mregueira/DisenioBJAM/Pedal.png

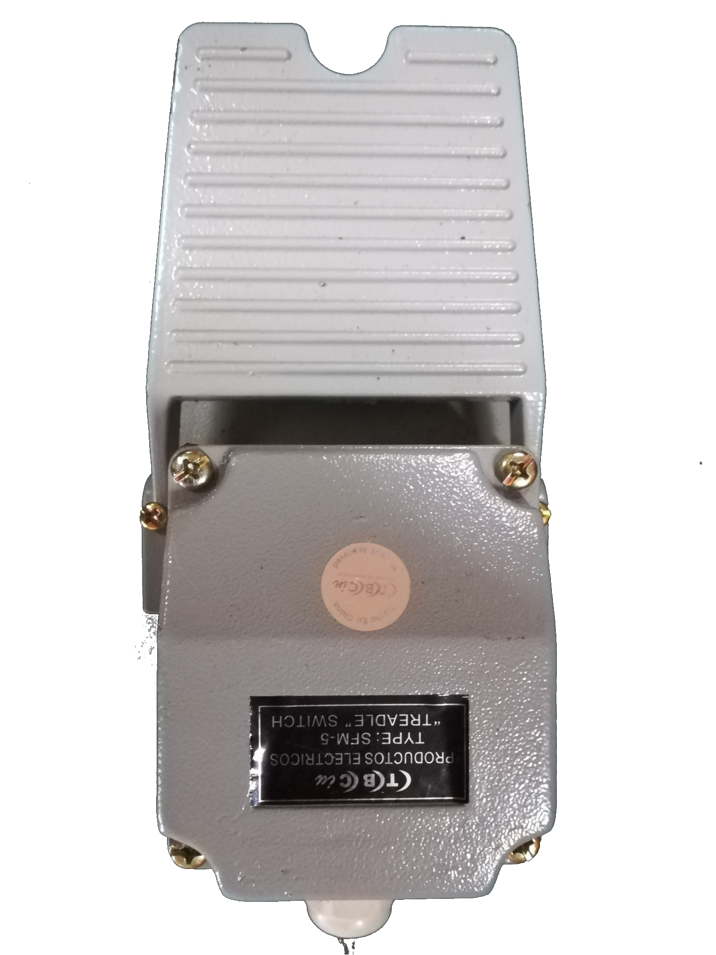
Pedal.png
