mregueira/DisenioBJAM/Hito 3/Dibujos/Mitutoyo Digimatic protocol.jpg

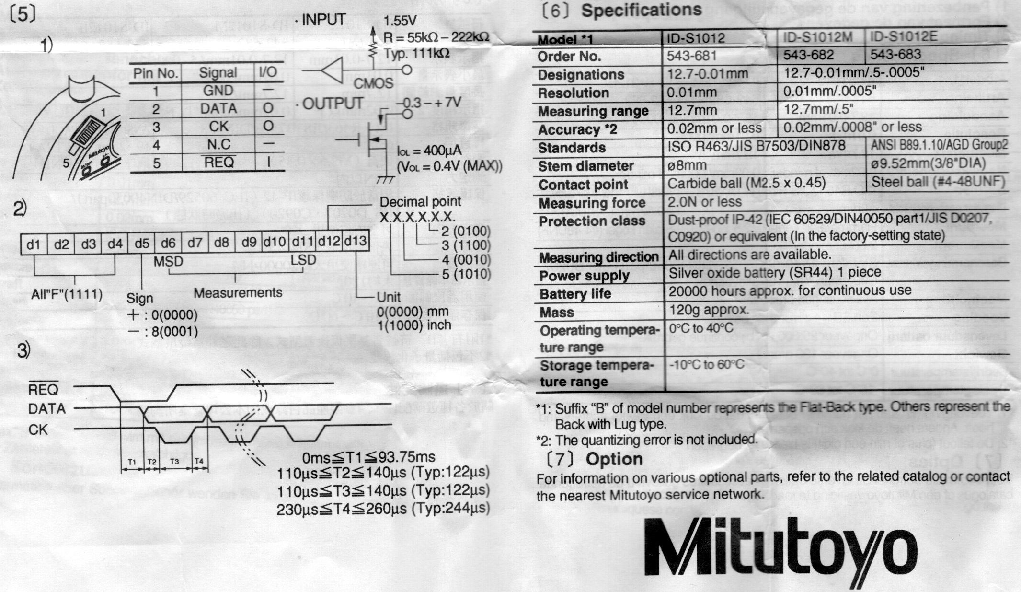
Hito 3/Dibujos/Mitutoyo Digimatic protocol.jpg
