mregueira/DisenioBJAM/Prototipo/COMECA-TestBoard-v2/COMECA-TestBoard/COMECA-TestPCB.txt

Board Information Report
Filename     : C:\Users\Marcelo\Documents\GitHub\DisenioBJAM\Prototipo\COMECA-TestBoard-v2\COMECA-TestBoard\COMECA-TestPCB.PcbDoc
Date         : 16/9/2021
Time         : 12:21:42
Time Elapsed : 00:00:00

Routing Information
    Routing completion, 100.00%
    Connections, 34
    Connections routed, 34
    Connections remaining, 0
count : 4
