mregueira/DisenioBJAM/Prototipo/NotasPrograma.docx

Pruebas y verificación sobre la STM + Programador externo

- Conexión del CN4 para programar según la hoja de datos: OK
- Selector en proyecto, buscar modelo: STM32F407VGT6: OK
- Programa de prueba de encender LED: FAIL
  - Causa: veo que en la tablita dice pin 1 es VDD from Application. O sea que parece que hay que ponerla uno. Voy a usar la de la placa. En el caso del prototipo no haría falta porque ya está conectada a la alimentación.
- Programa de prueba de encender LED (2): OK
