mregueira/DisenioBJAM/Prototipo/Validacion/Validacion.docx

T-PERF03

Rango [20.4V – 26.4V]

Salida 0: 23.12V

Salida 0 y 1: 23.13

Salida 0 y 1 y 2: 23.14V

Salida 0 y 1 y 2 y 3: 23.15V

Rango [0V – 1.2V]

Salidas off: 0.01V

T-PERF05

Rango [4.5V – 5.5V]

Sin carga: 4.95V

Con carga: 4.94V
