mregueira/DisenioBJAM/OriginalSinModificar.docx

INSTITUTO TECNOLÓGICO DE BUENOS AIRES – ITBA

ESCUELA DE INGENIERÍA Y TECNOLOGÍA

TÍTULO DEL TRABAJO

Subtítulo del trabajo (cuando corresponda)

AUTOR/ES: Apellido/s, Nombre/s (Leg. Nº XXXXX)

Apellido/s, Nombre/s (Leg. Nº XXXXX)

DOCENTE/S TITULAR/ES O TUTOR/ES: Apellido/s, Nombre/s

TRABAJO FINAL PRESENTADO PARA LA OBTENCIÓN DEL TÍTULO DE INGENIERO ELECTRÓNICO

BUENOS AIRES

PRIMER / SEGUNDO CUATRIMESTRE, 202X

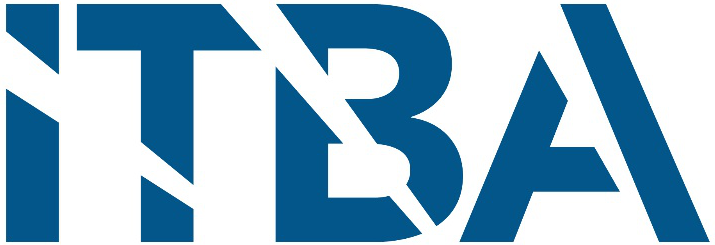
[picture p12: figure]

# Proyecto final de Ingeniería Electrónica

Sistema de conversión eléctrica de 24VDC a 12VDC para uso automotriz

Autores: Smith, John (456789)

Pérez, Juan (654321)

Tutores: Nemirovsky, Nicolás

Orchessi, Walter

Pingitore, Ricardo

Ugarte, Alejandro

Fecha: 15/12/2016

# Agradecimientos

OPCIONAL

Aquí deberá figurar cualquier agradecimiento que el/los autores consideren adecuado. Esto puede ser a colegas, amistades, familiares, parejas, docentes y personal del ITBA, profesionales externos, instituciones, sponsors o cualquier allegado que ustedes consideren que han colaborado de una manera u otra a alcanzar el éxito de su trabajo. Si bien los agradecimientos son opcionales, considerando las dimensiones del trabajo, es usual que estén presentes.

A nuestras familias, que nos enseñaron el valor del esfuerzo y la educación, y nos apoyaron en todo nuestro crecimiento.

A nuestros amigos, compañeros de vida.

Al Departamento de Electrónica, que fue nuestro segundo hogar durante todos los años de nuestra formación.

A Jorge, Gabriel y Nelson, por estar siempre con una sonrisa.

# Índice

## Contenidos

El índice debe contener 1 a 3 páginas, 30 a 90 entradas con número de página. No más de tres niveles de encabezados. El esquema de informe aquí presente es una sugerencia fuerte. Es decir que, si los autores desean no respetarlo, esto puede ser aceptable siempre y cuando la información requerida esté, con un orden e hilo conductor igual o mejor que el aquí propuesto. En caso de respetar la sugerencia de la cátedra, considerar que: los números de sección pueden no ser respetados, pero sí debe serlo el orden de los ítems indicado. Dada la diversidad de los trabajos que están enmarcados en estas indicaciones, es normal que se deban agregar secciones o modificar ligeramente los contenidos de las aquí presentadas, aun intentando respetar esta plantilla.

## Lista de Figuras

## Lista de Tablas

# Acrónimos y Definiciones

Aquí se deberán listar todas aquellas abreviaturas utilizadas a lo largo del informe. Ninguna abreviatura puede “darse por conocida”: todas aquellas que se deseen utilizar, deberán estar aquí listadas. A continuación de la abreviatura, deberá figurar el significado en el idioma castellano, y si esta abreviatura proviene de otro idioma, deberá figurar también entre paréntesis y en itálica la expresión en idioma original de la que proviene la abreviatura. No es necesario definir todas las abreviaturas.

Deberá haber también un listado de expresiones que requieran una definición. Las definiciones se deberán aplicar a cualquier término que no sea natural en el léxico de una audiencia con conocimientos técnicos no específicos. Ante la duda, es preferible que un término esté definido cuando no es necesario, que, existiendo dicha necesidad, la definición no esté. Todas las definiciones que sean extraídas de bibliografía externa deberán ser adecuadamente referenciadas.

Acrónimo | Descripción
AC | Corriente Alterna (Alternate Current)
DC | Corriente Continua (Direct Current)
DSP | Procesador de Señales Digitales (Digital Signal Processor)
EMC | Compatibilidad Electromagnética (ElectroMagnetic Compatibility)
FPGA | Field Programable Gate Array
HW | Hardware
PCB | Circuito Impreso (Printed Circuit Board)
PLC | Controlador Lógico Programable (Programmable Logic Controller)
SW | Software
TBD | To Be Determined
µC | Microcontrolador (ver definiciones)
µP | Microprocesador (ver definiciones)
VAC | Volts de corriente alterna (AC)
VDC | Volts de corriente continua (DC)

Término | Definición

DSP

Un DSP es un sistema basado en un procesador o microprocesador (https://es.wikipedia.org/wiki/Microprocesador) que posee un juego de instrucciones, un hardware (https://es.wikipedia.org/wiki/Hardware) y un software (https://es.wikipedia.org/wiki/Software) optimizados para aplicaciones que requieran operaciones numéricas a muy alta velocidad. Debido a esto es especialmente útil para el procesado y representación de señales analógicas (https://es.wikipedia.org/wiki/Se%C3%B1al_anal%C3%B3gica) en tiempo real: en un sistema que trabaje de esta forma (tiempo real) se reciben muestras, normalmente provenientes de un conversor analógico/digital (https://es.wikipedia.org/wiki/Conversi%C3%B3n_an%C3%A1loga-digital) (ADC). Se puede trabajar con señales analógicas, pero es un sistema digital (https://es.wikipedia.org/wiki/Circuito_digital), por lo tanto, necesitará un conversor analógico/digital a su entrada y digital/analógico en la salida. Como todo sistema basado en procesador programable necesita una memoria (https://es.wikipedia.org/wiki/Memoria_de_ordenador) donde almacenar los datos con los que trabajará y el programa (https://es.wikipedia.org/wiki/Programa_(computaci%C3%B3n)) que ejecuta.
Microcontrolador | Un microcontrolador difiere de un microprocesador, debido a que es más fácil convertirla en una computadora en funcionamiento, con un mínimo de circuitos integrados externos de apoyo (https://es.wikipedia.org/wiki/Circuito_integrado_auxiliar). La idea es que el circuito integrado se coloque en el dispositivo, enganchado a la fuente de energía y de información que necesite. Un microprocesador tradicional no permitiría hacer esto, ya que espera que todas estas tareas sean manejadas por otros chips. Hay que agregarle los módulos de entrada y salida (puertos) y la memoria para almacenamiento de 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

Microprocesador

Es el circuito integrado central más complejo de un sistema informático; a modo de ilustración, se le suele llamar por analogía el «cerebro» de una computadora.

Se encarga de ejecutar los programas, desde el sistema operativo hasta las aplicaciones de usuario; sólo ejecuta instrucciones programadas el lenguaje de bajo nivel, realizando operaciones aritméticas y lógicas simples, tales como sumar, restar, multiplicar, dividir, las lógicas binarias y accesos a memoria.

Puede contener una o más unidades centrales de procesamiento (CPU) constituidas, esencialmente, por registros, una unidad de control, una unidad aritmético lógica (ALU) y una unidad de punto flotante (llamada antiguamente «coprocesador matemático»).
FPGA | Una FPGA es un dispositivo programable que contiene bloques de lógica cuya interconexión y funcionalidad puede ser configurada ‘in situ (https://es.wikipedia.org/wiki/In_situ)’ mediante un lenguaje de descripción especializado. La lógica programable puede reproducir desde funciones tan sencillas como las llevadas a cabo por una puerta lógica (https://es.wikipedia.org/wiki/Puerta_l%C3%B3gica) o un sistema combinacional (https://es.wikipedia.org/wiki/Sistema_combinacional) hasta complejos sistemas en un chip (https://es.wikipedia.org/wiki/System_on_a_chip).

PLC

Un controlador lógico programable, o por autómata programable, es una computadora (https://es.wikipedia.org/wiki/Computadora) utilizada en la ingeniería automática (https://es.wikipedia.org/wiki/Ingenier%C3%ADa_autom%C3%A1tica) o automatización industrial (https://es.wikipedia.org/wiki/Automatizaci%C3%B3n_industrial), para automatizar procesos electromecánicos (https://es.wikipedia.org/wiki/Electromec%C3%A1nica), tales como el control de la maquinaria de la fábrica en líneas de montaje (https://es.wikipedia.org/wiki/Producci%C3%B3n_en_cadena) o atracciones mecánicas.

Los PLC son utilizados en muchas industrias y máquinas. A diferencia de las computadoras de propósito general, el PLC está diseñado para múltiples señales de entrada y de salida, rangos de temperatura ampliados, inmunidad al ruido eléctrico y resistencia a la vibración y al impacto. Los programas para el control de funcionamiento de la máquina se suelen almacenar en baterías copia de seguridad o en memorias no volátiles. Un PLC es un ejemplo de un sistema de tiempo real (https://es.wikipedia.org/wiki/Tiempo_real) «duro», donde los resultados de salida deben ser producidos en respuesta a las condiciones de entrada dentro de un tiempo limitado, de lo contrario no producirá el resultado deseado.

# Resumen

El resumen deberá contener una descripción corta de todo lo contenido en el informe, sin entrar en detalles. Esto implica que aquí debería figurar la necesidad, el producto que se desarrolla y los resultados obtenidos en términos económicos, tecnológicos y académicos.

Este informe de proyecto final de la carrera de Ingeniería Electrónica planteará las problemáticas existentes en el mercado actual y su potencial solución con el producto aquí presentado: un conversor de energía eléctrica, de 24VDC a 12VDC.

Se analizan los requerimientos y especificaciones del producto tomando en consideración a los clientes: los fabricantes de camiones y de productos eléctricos de uso automotriz (como radios, cargadores, etc).

Se estudian aquí las posibilidades de realizarlo con distintas tecnologías de fuente, analizándose en cada caso con amplio detalle las consecuencias para las regulaciones vinculadas a seguridad y emisiones eléctricas, eligiéndose la tecnología switching como principal característica del diseño.

Luego de la construcción del prototipo, se obtienen validaciones positivas en todos los aspectos excepto en el de compatibilidad electromagnética, en donde no hay ningún test que valide las especificaciones debido al costo que esto representaría, y considerándose inapropiado para un prototipo.

Se analiza la confiabilidad del producto final, llegándose a concluir que podrá tener una vida útil de 5 años, con un tiempo medio entre fallas de 20 años.

El costo final del prototipo resulta ser de $750, considerándose que para ventas mayores a 1000 unidades por año el costo final se reduciría a $600. El análisis económico indica una TIR del 35%, considerándose el proyecto viable de acuerdo a estimaciones de estabilidad socioeconómica del país de los autores.

Finalmente, se concluye que el proceso de diseño, realizado en el término de un año y medio fue exitoso, con aprendizajes en lo tecnológico, lo académico y lo personal

# 1. Introducción

## Antecedentes.

Aquí se debe explicar brevemente cómo surgen las problemáticas que se solucionan con este proyecto, cuál es la historia que precede a la necesidad o que la genera y (dado el caso) qué soluciones se elaboraron en el pasado para lidiar con la problemática. Los antecedentes deben referirse al tiempo pasado (cómo se llega a la problemática o necesidad del presente y las herramientas para resolver la necesidad que hay hoy)

## Contexto del proyecto

Aquí se debe explicar cuáles son las condiciones sociales, políticas, y económicas que afectan a la problemática o a la posibilidad de plantear o desarrollar una solución. También se deben plantear la actual competencia en términos generales o aquellas soluciones que existen hoy para el problema descrito. Asimismo, deberá describirse el contexto del proyecto: sponsors, proyectos realizados en paralelo vinculados al de este informe, dependencias de otros desarrollos, financiamiento, etc. Nótese que este contexto se refiere al proyecto, no al producto.

# 2. Objetivos

## Finalidad del Proyecto

En esta sección se debe describir cómo el desarrollo, una vez finalizado, va a contribuir en la sociedad. Esta no es una descripción del desarrollo, ni de sus aspectos o funcionalidades finales, sino del efecto que va a tener en la sociedad. En otras palabras, aquí se debe decir a quién ayuda realizar este proyecto; para qué va a servir el desarrollo. Es decir, no es la finalidad del producto, sino del proyecto. Desde este punto de vista, es una descripción generalmente no técnica.

Este proyecto resultará en la posibilidad de proveer a la industria automotriz de un adaptador de tensión que permita a los vehículos que utilizan normalmente una o más baterías con una tensión final de 24VDC, utilizar artefactos que requieran una alimentación de 12VDC. Este producto podrá ser comercializado en todo el territorio argentino, y estará a un precio accesible para la industria.

## Planteamiento del Problema a Resolver

En esta sección se deben listar los objetivos concretos, específicos del desarrollo. El contenido de esta sección debe ser principalmente técnico, mostrando los aspectos claves que se deben resolver para llegar a una solución. Nótese que, si bien los objetivos deben ser planteados en forma concreta, estos no tienen el nivel de detalle que tienen las especificaciones. Estos objetivos deberán cumplir el criterio “SMART” (Specific, Measureable, Achievable, Relevant, Time-bound). Es decir, deberán ser específicos, deberá ser posible medirlos, deberá ser factible su realización, así como también relevante y definido en el tiempo.

Si bien la conversión de 24VDC a 12VDC es algo que no implica un desafío tecnológico en sí mismo, esto sí se convierte en un desafío cuando el objetivo es que se integre en un vehículo, ya que las condiciones de uso de este conversor pueden considerarse extremas para muchas de las tecnologías más comunes. Es por esto que este trabajo tendrá como focos los siguientes tres aspectos fundamentales: requerimientos, diseño para condiciones extremas, e integración y validación de producto. En particular, las pruebas de validación serán de extrema relevancia para asegurar un producto de la calidad que se requiere.

## Alcance

En esta sección se deberá detallar qué es lo que el proyecto va a abarcar, qué será el producto final con el que se contará, pero, más importantemente, qué cosas NO se harán. Es de enorme relevancia establecer los límites del proyecto en forma concisa, delimitando exactamente lo que se propone realizar, y lo que se propone NO realizar. Ejemplo: puede desarrollarse un producto que utilice baterías y ofrezca cierto grado de autonomía, pero no desarrollarse para venta comercial un cargador. Puede trabajarse en un equipo médico que utilice electrodos u otros apéndices, y no desarrollar los mismos. Puede desarrollarse un sistema de medición de ciertos parámetros para equipos pre-existentes, sin que esto implique el desarrollo o modificación de dichos equipos.

Este proyecto contempla el diseño de un conversor de 24 a 12VDC para ser utilizado en vehículos terrestres, con los análisis relevantes para asegurar la viabilidad tecnológica y financiera del producto. La verificación de la calidad del diseño estará basada en un único prototipo no comercial, que no deberá cumplir con todos los requerimientos de producto final. No se contempla en este trabajo la realización de un segundo o tercer prototipo, ni del producto final, aunque sí estarán establecidas todas las decisiones de diseño, así como esquemáticos y planos de fabricación acordes para la manufactura en masa del producto final. El dispositivo no estará preparado para ser utilizado en otro tipo de vehículos que no sean terrestres, ni estará preparado para estar en contacto directo con los motores de ninguna clase de vehículo. El alcance de este trabajo está limitado al conversor en sus bornes. Aunque las pruebas de validación utilicen diverso tipo de cables y cargas, el diseño y manufactura de estos no está cubierto en este desarrollo.

# 3. Definición de Producto

Aquí se deberán plantear los requerimientos del producto según indicado por el/los clientes y luego traducirlo a especificaciones de diseño. Según el tipo de cliente, los requerimientos pueden tener dos formatos:

A. Producto pedido: cliente principal único
B. Producto “masivo”: gran número de clientes desconocidos

Para el primer caso, los requerimientos son muy similares a las especificaciones de diseño: específicos, medibles, concisos, conseguibles, necesarios, y libres de implementación. Esto por ejemplo es siempre es cierto para los requerimientos impuestos por el estado en forma de regulaciones y normas. Es posible que haya requerimientos que no vayan al nivel de detalle que es necesario en las especificaciones, pero aún así son cercanos al estilo de las especificaciones de diseño. Cuando el desarrollo que los autores deben realizar sigue estas características, no es necesario realizar una casa de calidad (aunque es recomendable. Si no la realizan, deberán indicarlo y estipular los motivos).

Para el segundo caso, los requerimientos toman el carácter de condiciones a menudo simplemente “deseables”, y rara vez son específicos, medibles o concisos. En estos casos, hay dos herramientas que pasan a ser necesarias: el relevamiento de datos de los clientes (a menudo en forma de encuestas), y la construcción de una casa de calidad. Ambas herramientas permitirán realizar el paso de los requerimientos planteados por los clientes, a las especificaciones de diseño.

Es importante remarcar que también deberán incluirse aquellos aspectos del diseño que, si bien muchas veces no tienen un requerimiento formal, explícito, siempre lo tienen en términos tácitos –sobre todo para productos masivos-. Estos pueden ser aspectos como el tamaño del producto, el consumo, las condiciones ambientales de operación, etc. Estos requerimientos también deberán escribirse, sólo que tendrán un origen tácito. Notar que esto sólo es válido cuando no se puede hablar directamente con el cliente, o no se pudo obtener la información por medio de encuestas/entrevistas, etc. Siempre es preferible que los requerimientos estén sustentados en el/los clientes mismo/s

En cualquier caso, los requerimientos al terminar el análisis deberán ser escritos en forma clara y concisa. Cada requerimiento deberá tener un código de identificación único, y deberá quedar denotado su origen.

Algunas especificaciones pueden estar basados directamente en una factibilidad. Un ejemplo puede ser la venta de un producto en otro país para ampliar un mercado –lo cual sólo se puede determinar a partir de un estudio de mercado-, o la necesidad de que el costo de materiales sea inferior a algún número determinado, para conseguir un margen específico –El precio de venta sí se obtiene del cliente, aunque también puede estar afectado por la factibilidad económica (con un menor precio de venta se accede a mayor porcentaje de mercado)

NOTA: cuando la factibilidad económica implique la venta a muchos clientes, la casa de calidad no es opcional (al no haber un contrato con el cliente, cada cliente puede optar por la competencia)

## Requerimientos de Cliente

### Relevamiento de Datos

OPCIONAL (ver texto sección raíz)

En esta sección se deberá explicar el mecanismo mediante el cuál se consiguieron datos de los clientes. En el caso de una encuesta, deberán estar detalladas todas las preguntas, así como también los criterios de filtrado utilizados para las respuestas. Este filtrado puede venir de outliers (valores atípicos) o del incumplimiento de ciertas condiciones en alguna pregunta previa -por ejemplo, si la primera pregunta dice “¿estaría Ud. Interesado en este producto?”, pueden no considerarse las subsiguientes respuestas de quién responde a esta pregunta que no-, entre otras posibles razones. Se espera también en esta sección un análisis en profundidad de las respuestas obtenidas. Debe estar considerado también en esta sección, el grado de representatividad (sesgo) de los datos obtenidos.

Notas importantes referidas a la elaboración de una encuesta:

1. La encuesta debe ser lo más corta posible. Por eso toda la información obtenida de las preguntas debe tener un fin específico. No es adecuado realizar preguntas si no se sabe qué hacer con la información que se va a recopilar, y hace la encuesta más larga de lo necesario.
2. Evaluar el sesgo en cada pregunta. Si se busca saber cuánto pagaría un potencial cliente por un producto, la información sólo es válida si la persona ya está interesada en ese producto, o si vive en la zona donde se pretende vender (alguien que conteste la encuesta desde, por ejemplo, otro país, no puede aportar información valiosa acerca de lo que es un precio razonable). Esto significa que es necesario realizar un árbol que siga el flujo de la encuesta, verificando que los que lleguen a una pregunta determinada, pertenezcan al segmento que resulta de interés al menos en esa pregunta.
3. Las preguntas deben formularse para que la interpretación de las respuestas sea inequívoca. Por ejemplo, preguntarle al potencial cliente si le interesa una lista de características y ofrecer una respuesta binaria (sí o no), hace por ejemplo imposible saber cuál de esas características es deseable y cuál no. Por este motivo es preferible, cuando existe la posibilidad, no utilizar preguntas binarias.
4. Al realizar preguntas que utilizan rangos (por ejemplo, evaluar el precio que un potencial cliente estaría dispuesto a pagar) se debe considerar la significancia para el diseño o el análisis económico de los rangos planteados. Esto incluye las preguntas referidas a los extremos de los rangos: “menos que A” y “más que B”: no se deben considerar las divisiones en función de preconceptos, sino con pensamiento pragmático; siempre es factible que haya una gran cantidad de respuestas en un solo rango, incluyendo los rangos de los extremos, y esa información debe resultar de utilidad. Por este motivo se desaconseja el uso de rangos internos muy amplios (por ejemplo: si las opciones son “pagar entre 10 y 500”, se hace imposible para los diseñadores el establecer si aquellas personas que eligieron esa opción sólo pagarían hasta 20, o si hasta 500 no tienen inconveniente).
5. Ofrecer siempre opciones que abarquen todo el rango de posibilidades. Si una persona no es cliente potencial de un producto, no debería llegar a una pregunta sobre características deseables del mismo. Del mismo modo, si alguien no está dispuesto a gastar en ninguno de los rangos de precio mostrados, elegirá el más bajo, aun cuando no lo represente realmente (por esto siempre en las preguntas de rangos siempre debe haber opciones de rangos abiertos en los extremos)
6. Realizar un simulacro de casos de uso (use cases). Asumir muchos perfiles de personas que podrían estar respondiendo la encuesta y verificar que el flujo de la encuesta es como debiera ser. Considerar lugar de residencia, clases sociales, edad, género, etc. Esto verifica que todas las entradas posibles son debidamente procesadas por la encuesta.
7. Realizar un simulacro de respuestas recibidas. Es decir, evaluar que toda la información recibida sea valiosa con cualquier distribución de respuestas –esto implica interpretar el significado de las respuestas recibidas, recordando que no se va a saber nada del perfil de los encuestados que no esté específicamente preguntado en la encuesta-. Esto verifica que todas las salidas posibles son utilizables.

### Casa de Calidad

OPCIONAL (ver texto sección raíz)

En esta sección se realiza el análisis de valor y competitividad utilizando la herramienta de la Casa de Calidad, para aquellos casos en los que es necesaria una traducción cualitativa de las prioridades de diseño para un producto masivo.

### Requerimientos finales para trazabilidad

ID | Descripción | Origen
REQ-01 | El producto deberá ser portable | Encuesta
REQ-02 | El producto debe cumplir la norma IRAM xxxx: seguridad eléctrica | Ley Argentina
REQ-03 | El producto deberá poder operarse en todas las condiciones normales de temperatura y humedad que se pueden encontrar en el territorio argentino y chileno*. * Se incluyen aspectos climáticos de Chile debido a que se prevé su venta allí también para ampliar el mercado disponible | Tácito Factibilidad Económica

Tabla 3.1: Requerimientos

## Diagrama Funcional de Interfaces

En esta sección deberá presentarse un diagrama del producto que muestre claramente todas las interfaces que el producto tiene. Este diagrama NO debe mostrar distinciones de HW o SW o de módulos internos: sólo deberá presentarse como una “caja negra”, mostrando todas las interfaces que posee (en términos multidisciplinares) hacia el exterior. En este punto del diseño no se sabe cuáles módulos habrá, menos aún qué interfaces internas puede haber. Se recomienda marcar cada interfaz con un identificador único. Sobre cada interfaz deberá haber especificaciones (siguiente sección) que contribuyan a la definición de la caja negra. Notar que si se realiza un producto que se presume que deberá tener una batería interna, esta es parte de la caja negra, y la interfaz de carga es la interfaz a mostrar. Si el producto viene con su cargador, esta interfaz será a la red eléctrica.

Conversor
24 VDC / 12 VDC

Chasis o Interfaz Mecánica del vehículo para sujeción

Ambiente

Temperatura – Humedad – Presión – Emisiones Electromagnéticas

Batería 24V del vehículo

Dispositivos del Usuario

Servicio Técnico

#AMB

Intercambio térmico, EMC, etc.

#VIN

24VDC

#DIA

Interfaz de Diagnóstico

#MEC

Interfaz de Sujeción

#VOU

12VDC

Interfaz eléctrica

Interfaz mecánica

Interfaz de servicio

Interfaz de entorno

Figura 3.1: Diagrama Funcional de Interfaces

## Especificaciones de Diseño.

En esta sección, deberán escribirse todos los requerimientos o especificaciones de diseño. Las especificaciones deberán ser concisas (es decir, inequívocas, no ambiguas), precisas, medibles, atomizadas (una por cada aspecto necesario, sin agrupar), necesarias (deberá haber al menos un cliente insatisfecho si no se cumple), libres de implementación (la implementación es para el diseño, y no antes), consistentes y no redundantes. Preste por favor especial cuidado al cumplimiento de estos términos.

Cada especificación deberá tener un identificador único, un origen (es decir, un requerimiento que lo origina), un modo de validación especificado, y un ámbito de validez. Hay ejemplos en las siguientes sub-secciones.

No puede haber especificaciones sin origen. Cuando las especificaciones no tienen una relación directa e inmediata con los requerimientos, se deberá dejar por escrito la justificación de dicha especificación

### Especificaciones Funcionales

Las especificaciones funcionales son las más genéricas, y se refieren, sin entrar en detalles de performance, a las funciones que debe cumplir el producto. Es la forma técnica de explicar en pocas palabras lo que el producto hace. En este sentido, funcionan más bien como una primera orientación para luego entrar en los detalles pertinentes, usualmente presentes en las especificaciones de interfaz y de performance.

Leyenda para Especificaciones
Aplicabilidad | Validación
P: Prototipo | I: Inspección Visual
| D: Documentación de Diseño
F: Producto Final | S: Simulación
| T: Test

Tabla 3.2: Leyenda de uso en especificaciones

ID | Descripción | Origen | Aplicabilidad Validación
FUN-POW-01 | El producto deberá tomar una señal de tensión continua proveniente de una batería de 24 Volts en su entrada, y convertirla en una señal de 12 Volts de tensión continua en su salida. | REQ-04 REQ-08 | P, F I, D, T
FUN-POW-02 | El producto deberá poder abastecer de energía cualquier dispositivo que se le conecte, siempre y cuando cumpla con las especificaciones indicadas en las siguientes subsecciones. | REQ-02 | P, F I, D, T
FUN-POW-03 | El producto deberá poder operar cuando está sujeto a un vehículo terrestre en desplazamiento. | REQ-02 | P, F I, D, T

Tabla 3.3: Especificaciones Funcionales

### Especificaciones de Interfaz

En esta sección deben mostrarse las especificaciones aplicables a todas las interfaces formales. Es decir, interfaces con los clientes, ya sean eléctricas, mecánicas, visuales o de otro tipo. Todas las interfaces mostradas en el diagrama de la sección 3.2 deberán tener especificaciones. Se sugiere agrupar las especificaciones utilizando los mnemónicos usados en dicho diagrama. Como ejemplos, para interfaces de potencia (alimentación), recordar que se deberán explicitar aquí especificaciones como rangos de entrada, picos de consumo, picos de corriente, corrientes de inrush, conectores utilizados, etc. Para interfaces de comunicación, frecuencia, tipo, tasas de falla, estándar, etc. Para interfaces de usuario, deberán especificarse todas las acciones que el usuario deba ser capaz de hacer en dicha interfaz.

ID | Descripción | Origen | Aplicabilidad Validación
INT-VIN-01 | El equipo debe poder operar con una tensión de entrada entre 22 VDC y 30 VDC. | REQ-04 REQ-08 | P, F T
INT-VIN-02 | El equipo debe poder tolerar ruido de hasta 5Vpp (pico a pico) en la banda de 50 Hz – 50 kHz en su entrada (sumado a los rangos descriptos en INT-VIN-01) | REQ-24 | P, F D, T
INT-VIN-03 | El equipo deberá poder tolerar ruido de hasta 10Vpp (pico a pico) en la banda de 50 Hz – 50 kHz en su entrada cuando esta se encuentra desconectada de la fuente batería). Es decir, con un piso de tensión continua de 0VDC. | REQ-24 | P, F D, T

Tabla 3.4: Especificaciones de Interfaz VIN

ID | Descripción | Origen | Aplicabilidad Validación
INT-VOU-01 | El equipo debe entregar en el conector de salida una tensión continua de entre 12 y 14.5 Volts. | REQ-04 | P, F D, T
INT-VOU-03 | La impedancia de salida para la interfaz de salida deberá ser no mayor a 0.5 Ω. | REQ-15 | P, F T
INT-VOU-08 | La tensión de salida deberá entregarse en un conector LEMO tipo K (PKA.1K.303.CYKC35E) de dos pines para baja tensión, con el siguiente pinout: 1. 12VDC 2. 0VDC (masa/ground) | REQ-24 | F D
INT-VOU-10 | La salida permitirá un pico de corriente máximo de 5 Amperes durante no más de 10 µs, y un ciclo de trabajo no mayor a TBD | REQ-17 | TBD

Tabla 3.5: Especificaciones de Interfaz VOU

ID | Descripción | Origen | Aplicabilidad Validación
INT-MEC-01 | El equipo deberá poder sujetarse con cuatro tornillos tipo M12 distanciados entre sí no más de 15 cm y no menos de 3 cm. | REQ-15 | P, F, T

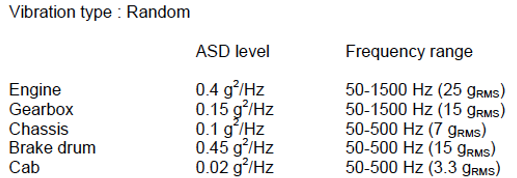
[picture p13: figure]

INT-MEC-02 | El equipo deberá tolerar vibraciones mecánicas del siguiente modo: | REQ-07 | F D, T

Tabla 3.6: Especificaciones de Interfaz MEC

### Especificaciones de Performance

En esta sección deben mostrarse las especificaciones vinculadas a la performance, o calidad con la cual el producto cumple sus funciones. Se sugiere agrupar las especificaciones utilizando las funciones descritas en la sección 3.3.1, particularmente cuando haya varias funciones fundamentalmente distintas (no el caso del ejemplo que es de gran simplicidad). No siempre la división será 100% clara entre especificaciones de performance o de interfaz. En estos casos, quedará a criterio de los autores, siempre y cuando todos los aspectos relevantes estén cubiertos.

ID | Descripción | Origen | Aplicabilidad Validación
PER-POW-01 | El equipo deberá realizar la conversión de energía indicada por FUN-POW-01 con una eficiencia no menor al 80% | REQ-15 | P, F T
PER-POW-02 | El equipo deberá poder proveer no menos de 60W de potencia continua. | REQ-07 | P, F T
PER-POW-03 | El equipo no deberá agregar nunca más de 2?nV/Hz de ruido eléctrico sobre la señal de entrada. | TBD | F S, T

Tabla 3.7: Especificaciones de Performance

Nótese que el segundo requerimiento establece la máxima potencia mínima de salida, de lo que automáticamente se puede derivar la mínima corriente máxima de salida. No se deberá expresar ésta en esta sección (especificaciones) dado que sería redundante. Sin embargo, a la hora de realizar el diseño, es importante ver que la mínima corriente máxima variará según la tensión de salida, siendo la menor corriente máxima aquella que se deba proveer cuando la tensión es mínima (la cuál será un resultado del diseño pero que por especificaciones se sabe que tendrá que ser igual o superior a 12VDC.

### Especificaciones de Implementación

Las especificaciones de implementación son todas aquellas que limitan los potenciales diseños en función del entorno de utilización del producto. Esto incluye todas las características ambientales tanto para la operación como el almacenamiento y el transporte, materiales que no están permitidos (por ejemplo, por contaminación o por regulaciones –asbestos, plomo, etc.-), limitaciones para las dimensiones o el peso, etc, así como también requerimientos de costos

ID | Descripción | Origen | Aplicabilidad Validación
IMP-OPE-01 | El dispositivo deberá poder operar normalmente cuando la temperatura ambiente sea -10°C < TAMB < 70°C Si bien la temperatura más baja observada en el territorio argentino/chileno es de -40°C, se acepta que son circunstancias excepcionales y que a partir de -10°C las baterías comunes comienzan a presentar problemas para arrancar un vehículo. Si bien la temperatura máxima observada es de casi 50°C, la concentración de calor en ambientes cerrados puede hacer que sea superior a este valor en hasta 20°C | TBC | F D, T
IMP-OPE-02 | El dispositivo deberá poder operar normalmente cuando la humedad sea: 0% < RH < 100% Valores normales de humedad relativa ambiente. Si bien puede ser superior al 100%, esto no es común y sólo puede suceder en aire extremadamente limpio, donde la condensación no se adhiere a partículas de polvo. | TBC | F D, T
IMP-OPE-03 | El dispositivo deberá poder operar normalmente cuando la presión atmosférica sea: 60 kPa < PATM < 110 kPa Esto equivale a 4000m de altura para el mínimo de presión, y un máximo ligeramente superior al máximo observado a la altura del mar. | TBC | F D, T

Tabla 3.8: Especificaciones de Operación

ID | Descripción | Origen | Aplicabilidad Validación
IMP-AYT-01 | El dispositivo no deberá sufrir daños cuando, estando desenergizado, la temperatura ambiente sea -30°C < TAMB < 80°C | TBC | F D, T
IMP- AYT -02 | El dispositivo no deberá sufrir daños cuando, estando desenergizado, la humedad sea 0% < RH < 100% | TBC | F D, T
IMP- AYT -03 | El dispositivo no deberá sufrir daños cuando, estando desenergizado, la presión atmosférica sea 60 kPa < PATM < 110 kPa | TBC | F D, T

Tabla 3.9: Especificaciones de Almacenamiento y Transporte.

ID | Descripción | Origen | Aplicabilidad Validación
IMP-EMC-01 | El dispositivo deberá poder operar normalmente con inmunidad al ruido electromagnético de acuerdo a la norma TBD | TBC | F T
IMP-EMC-02 | El dispositivo deberá poder operar normalmente con inmunidad al ruido electromagnético de acuerdo a la norma TBD | TBC | F T

Tabla 3.10: Especificaciones de Compatibilidad Electromagnética

ID | Descripción | Origen | Aplicabilidad Validación
IMP-DIM-01 | El dispositivo no deberá exceder las siguientes dimensiones: Largo < 20 cm Ancho < 10 cm Alto < 10 cm | TBC | F D, T
IMP-DIM-02 | El dispositivo no deberá pesar más de 10 Kg | TBC | F D, T

Tabla 3.11: Especificaciones Dimensionales y de Peso

ID | Descripción | Origen | Aplicabilidad Validación
IMP-COS-01 | El costo de las partes que conforman el producto no deberá ser superior a U$S20 | REQ-45 (Fact Ec) | F D
IMP-COS-02 | El costo de las partes que conforman el prototipo no deberá ser superior a U$S50 | REQ-45 (Fact Ec) | P D
IMP-COS-03 | El precio de venta del producto deberá ser inferior a U$S100 (Capital Expenditure -CAPEX) | REQ-45 (Fact Ec) | F D
IMP-COS-04 | El costo de operación del producto (Operating Expense -OPEX) anual deberá ser inferior a U$S20 | REQ-45 (Fact Ec) | F D
IMP-COS-05 | El costo total de propiedad (Total Cost of Ownership - TCO) del equipo deberá ser inferior a U$S 100. | REQ-45 (Fact Ec) | F D

Tabla 3.12: Especificaciones de costos

### Especificaciones de Servicio (RAMS)

Esta sección deberá contener todas las especificaciones vinculadas a las “RAMS”: Reliability, (Confiabilidad) Availability (Disponibilidad, también incluye ciclo de vida), Maintainability (Mantenibilidad; también vinculadas a capacidades diagnósticas) y Safety.

Confiabilidad: esta temática se desarrolla en clase con mayor profundidad.

Disponibilidad: es aplicable normalmente a equipos utilizados para actividades comerciales cuya indisponibilidad implica una pérdida económica.

Mantenibilidad: se debe considerar la considerar la relevancia de que un usuario identifique causas comunes de falla (se evalúa en más profundidad en la FMEA); esto implica que la interfaz de usuario a menudo debe tener herramientas de feedback simples, como por ejemplo un LED que indique que el producto está alimentado o encendido, o que indique si una comunicación se estableció adecuadamente. Esto también es relevante para considerar que, ante una falla de un módulo, no es necesario reemplazar el producto entero. Esto a su vez es particularmente relevante a la hora de disminuir el costo de reemplazar productos defectuosos durante el período de garantía del mismo.

Seguridad: esta temática se desarrolla en clase con mayor profundidad. Considerar que todo producto puede tener riesgos hacia el usuario (una alimentación eléctrica ya implica riesgo de fuego aún para bajas tensiones). Los que sean relevantes deben estar considerados en esta sección

ID | Descripción | Origen | Aplicabilidad Validación
RAM-CON-01 | El producto deberá tener un MTBF no menor a 10 años. | TBC | F D, T
RAM-CON-02 | El producto deberá tener una vida útil no menor a 5 años. | TBC | F D

Tabla 3.13: Especificaciones de Confiabilidad

ID | Descripción | Origen | Aplicabilidad Validación
RAM-DIS-01 | El equipo deberá tener una disponibilidad no menor al 99.9% a lo largo del total de la vida útil. Nótese que esto implica también el tiempo total que el equipo puede estar en estado de falla/reparación. Con una vida útil de 5 años, un 99.9% de disponibilidad implica que el equipo no puede no estar disponible más de 43.8 horas. Esto tiene impactos relevantes en las facilidades de diagnóstico y reparación necesarias. | TBC | F T

Tabla 3.14: Especificaciones de Disponibilidad

ID | Descripción | Origen | Aplicabilidad Validación
RAM-MAN-01 | Se deberán monitorear los parámetros de entrada que puedan comprometer el funcionamiento del equipo. Deberá ser posible observar cuando estos parámetros están fuera de especificación. | REQ-46 (Fact Ec) | P, F T
RAM-MAN-02 | El equipo deberá monitorear la corriente de salida, e indicar cuando la carga es superior a lo especificado. | REQ-46 (DFMEA) | P, F T
RAM-MAN-03 | Todo módulo interno que sea definido como “repuesto” deberá tener sus propios métodos diagnósticos para verificar su funcionalidad. | REQ-46 (Fact Ec) | F D
RAM-MAN-04 | Deberá haber una indicación visual clara cuando el equipo está energizado. | REQ-46 (DFMEA) | P, F I
RAM-MAN-05 | En caso de utilizar SW o FW, deberá ser posible para técnicos calificados realizar actualizaciones del mismo. | REQ-46 (Fact Ec) | F D
RAM-MAN-06 | En caso de utilizar SW o FW, no deberá ser posible para el usuario acceder al mismo. | REQ-46 (DFMEA) | F T
RAM-MAN-07 | El equipo deberá contener la siguiente documentación: - Manual de Usuario - Esquemáticos de circuitos - Esquemáticos de placas - Manual de Mantenimiento y Servicio | REQ-46 (DFMEA) | P, F I, D

Tabla 3.15: Especificaciones de Mantenibilidad

ID | Descripción | Origen | Aplicabilidad Validación
RAM-SEG-01 | La máxima temperatura que podrá tener la carcasa será de 70°C, o 10°C por encima de la temperatura ambiente, la que sea mayor. | REQ-32 | P, F D, S, T
RAM-SEG-02 | La puesta a tierra de cada parte del equipo deberá ser tal que no puedan aparecer Corrientes de superficie en partes metálicas que lleven a descargas en un cuerpo humano de más de 25 mA. | REQ-32 | P, F D, T
RAM-SEG-03 | Si en algún lugar (accesible o no) hay tensiones peligrosas, deberá haber un cartel que lo advierta. | REQ-32 | P, F I
RAM-SEG-04 | No deberá ser posible para una persona realizarse ningún tipo de corte por contacto con el equipo. | REQ-32 | P, F T

Tabla 3.16: Especificaciones de Seguridad

# 4. Plan de Validación

## Diseño de Bancos de Pruebas

En esta sección se deberá explicar en qué consiste el o los bancos de pruebas a utilizar en las pruebas de validación. Para todas las mediciones, se deberá especificar cuál es la precisión, exactitud, error y resolución de cada una. Tenga en cuenta que el banco de pruebas es un “proyecto dentro del proyecto”: si bien no es necesaria estrictamente ninguna de las formalidades del proyecto completo, sí es necesario tener en cuenta los requerimientos principales (que usualmente son aquellos mencionados más arriba).

En esta sección se deberá también mostrar un diagrama en bloques del banco de pruebas, mostrando claramente cuáles son las conexiones al DUT (Device Under Test), y cómo son estas realizadas (por ejemplo, si se utilizan cables cortos para comunicaciones de alta velocidad, si se utiliza pasta térmica o no para ubicar un sensor de temperatura, dónde se ubica la tierra del osciloscopio para realizar una medición de tensión de alta precisión, etc).

## Especificaciones de Tests

Aquí deberá haber una descripción exhaustiva de cada prueba que se deba realizar, indicando sobre qué dispositivo se deberá realizar, qué precondiciones hay, cuál es el procedimiento exacto, y cuál es el criterio de pase. Algunos ejemplos a continuación.

ID Aplicabilidad | Procedimiento | Criterio

Precondiciones: Deberán haber sido completadas con éxito las pruebas T-INT01, T-INT02, T-POW01 y T-POW05.

Procedimiento General: para todas estas pruebas, se deberá conectar el DUT al banco de pruebas #2. Verifique que ambas puntas del osciloscopio estén correctamente conectadas, y que cada una de ellas tenga la referencia conectado al pin de tierra inmediatamente al lado del que se intenta medir. El osciloscopio deberá estar ajustado para mostrar en pantalla un período no mayor a 10µs. Deberá tener también acoplado AC para evitar ver señales de tensión continua. La amplitud que se pueda ver en pantalla deberá ser no mayor a 2VDC. El trigger deberá estar puesto en automático, y el display deberá estar puesto en estado normal (es decir, sin persistencia). Las puntas deberán estar en impedancia de entrada x10, con el ajuste acorde en el osciloscopio. Salvo que el test así lo indique, no deberá haber ningún tipo de filtro salvo aquellos ya mencionados. Los tests comienzan con todos los artefactos ya conectados y encendidos por no menos de 10 minutos.
T-PERF01 Proto, Final | 1. Verificar que la carga, la alimentación y el DUT estén encendidos y correctamente conectados. 2. Utilizar las funciones de medición del osciloscopio para que se registren los valores de tensión máximo y mínimo en la salida VOU del DUT. 3. Registrar los valores de tensión obtenidos luego de 10 segundos. 4. Desconectar la carga desde el conector y limpiar las mediciones previas. 5. Registrar los valores de tensión obtenidos luego de 10 segundos. | Con carga: 0V ± 0.05V Sin carga: 0V ± 0.05V
T-PERF02 Final | 1. Repetir el test T-PERF01, esta vez colocando el dispositivo en una cámara térmica que lleve la temperatura a 90°C 2. Repetir el test T-PERF01, esta vez colocando el dispositivo en una cámara térmica que lleve la temperatura a 0°C | Con carga: 0V ± 0.10V Sin carga: 0V ± 0.10V

Tabla 4.1: Tests de Performance

## Diseño y Especificaciones de Simulaciones

Para aquellos requerimientos a los que se haya elegido validar con simulaciones, en esta sección se deberán describir. La información contenida deberá incluir: alcance del modelo que será utilizado para simular, entradas y salidas del sistema simulado, parámetros del sistema simulado (no confundir con entradas), parámetros de la simulación (extensión en tiempo o espacio, granularidad, etc), salidas de referencia o criterio de aprobación.

Note que esto es para simulaciones cuyo objetivo sea validar, NO diseñar. Esta sección es sólo de planificación del trabajo; la descripción de resultados se realiza más adelante.

## Matriz de Trazabilidad de Validación

La matriz de trazabilidad debe generar una correspondencia entre fuentes, requerimientos, especificaciones y validaciones. La correspondencia no necesita ser unívoca; puede haber un test para varios requerimientos o especificaciones, o muchos tests para un solo requerimiento. Es importante que todas las especificaciones que estaban marcadas a ser validadas con un test figuren en esta tabla con el o los tests asociados.

En el caso que la validación se haga por simulación o documentación, se deberá detallar la sección del informe donde se encuentra la información necesaria para la validación.

Origen | REQ ID Descripción corta | ESP ID | TEST ID o Sección
Encuesta | REQ-01 Portabilidad | FUN-POW-01 | T-INT02
| | INT-VOU-01 | T-PERF04
| | PER-POW-03 | T-PERF07 T-PERF08
Ley xxx | REQ-02 Normas | IMP-EMC-01, IMP-EMC-02 | T-EMC-01 T-EMC-02
| | IMP-SEG-01 … IMP-SEG-05 | T-SEG-01
Tácito | REQ-03 Condiciones ambientales | IMP-AYT-01 IMP-AYT-02 IMP-AYT-03 | T-AYT-01 T-AYT-02 T-AYT-03
Encuesta | REQ-07 Costo de producto | IMP-COS-01 | No requiere

Tabla 4.2: Matriz de Trazabilidad para Validación

## Plan de Verificación y Validación

En esta sección se deberán mostrar todas las dependencias entre pruebas en un esquema temporal, mostrando además cuándo se pasan de pruebas de prototipo a producto final. Pueden utilizarse esquemas tipo PERT si así lo desean.

Es importante remarcar la diferencia entre la verificación y la validación. Al comenzar a completar esta sección no se posee un diseño interno del producto, razón por la cual sólo se lo puede ver a caja negra. Los tests que le corresponden a una caja negra son tests de validación, correspondientes al hito 1. Estos tests pueden ser pensados sólo sabiendo las especificaciones, pero sin conocer el diseño. Nótese que esta parte del plan expuesto ya concibe que los tests de verificación, es decir, tests que evalúan el funcionamiento del sistema mirando variables internas, se habrán realizado previo a comenzar los tests de validación.

Sólo cuando se cuenta con un diseño modular cerrado, se pueden considerar tests de verificación de módulos. Esto corresponde al hito 2. Tests internos de módulos se consideran parte de la ingeniería de detalle y se deberán tratar en la sección correspondiente.

Notar que por definición para la mayoría de los tests de producto final se debe previamente realizar tests en el prototipo.

Figura 4.1: Diagrama de dependencias de Validación

# 5. Análisis de Factibilidad

## Factibilidad tecnológica

Desde este punto en adelante, se deberá siempre tener muy claro si algo planteado refiere al producto final o al prototipo. El modo adecuado de proceder es el siguiente:

Todas las secciones que siguen, de aquí hasta la sección 7 refieren al producto final. Significa que la solución planteada deberá idearse buscando que se cumplan todos los requerimientos de un producto final, y planteando la validación subsiguiente, incluyendo aquellas por norma (como compatibilidad electromagnética).

La sección 7 es para explicar qué alternativas se deben buscar al diseño planteado para que los costos / tiempos / complejidad sean manejables para los tiempos del proyecto.

Notar que la planificación se refiere estrictamente al flujo del proyecto hasta la presentación de la validación del prototipo, razón por la cual serán preponderantes las actividades referidas al mismo.

### Esquema Modular

Este diagrama deberá mostrar los principales módulos funcionales del dispositivo. El hecho de que sean funcionales se refiere a que no está determinado si es HW o SW, mucho menos qué tipo de HW o SW es. Lo que este esquema muestra es la división en módulos que realizan funciones distintas, independientemente de la implementación. Deberán verse claramente las interfaces mostradas en la sección 3.2 como interfaces externas del sistema, así como también las conexiones entre módulos. Como no es un diagrama que muestre implementación, las conexiones entre módulos sólo pueden mostrar los datos intercambiados, y no los formatos detallados (es decir, no puede decir datos específicos como tensiones, corrientes, protocolos, salvo que formen parte de las definiciones funcionales provenientes de especificaciones. Sí puede contener cosas como “mediciones de entorno”, o “comandos de control”, por ejemplo. Notar que esto es válido sólo para interfaces internas; las externas ya deberían estar completamente definidas).

En el caso que deban considerarse alternativas de diseño a nivel arquitectura del producto, esto deberá hacerse en esta sección (brevemente).

Los módulos deberán tener un nombre único (preferentemente vinculado a la función, aunque esto no es obligatorio) que se deberá usar de aquí en adelante cada vez que se referencie dicho módulo. Se deberá evitar siempre referirse a un módulo como “módulo”, “dispositivo”, “sistema”, “bloque”, etc excepto durante la definición de su “bautismo”. Es conveniente en algunos casos utilizar acrónimos o abreviaturas para evitar nomencladores genéricos o largos en el resto del informe. Ejemplo: el centro de control podría nombrarse “CENCO” para referenciarlo así de aquí en adelante.

Conversor
24 VDC / 12 VDC

#AMB

Intercambio térmico, EMC, etc.

#VIN

24VDC

#DIA

Interfaz de Diagnóstico

#MEC

Interfaz de Sujeción

#VOU

12VDC

Protección de Temperatura

Medición de Salida

Centro de Diagnóstico

Centro de Control

Medición de Entrada

Conversión

Configuración

Control

Info VOU

Info VIN

Configuración

Diagnóstico

Interfaz datos

24VDC

24VDC

12VDC

Alimentación
Interna

Filtrado Diferencial

24VDC

Figura 5.1: Diagrama Modular

### Implementación de módulo <<X>>

### 5.1.1.1. Alternativas de diseño

En esta sección se presenta, para un módulo dado, las alternativas que hay para su implementación. Los módulos deberán nombrarse del mismo modo que en la Figura 5.1: Diagrama ModularFigura 5.1. No se deben presentar alternativas que sean inviables (es decir, que se deban descartar por no cumplir los requerimientos mínimos) sino opciones que sean realmente utilizables en el diseño. Dichos requerimientos mínimos deberán ser listados antes de describir las opciones (ejemplo: un sensor puede requerir tener un mínimo de precisión o repetibilidad, un rango específico, tener una salida digital, tener un precio menor a X, etc. Una fuente puede requerir un rango de tensiones de entrada, una o más tensiones de salida, una eficiencia mínima, una corriente de salida mínima, etc). No se requiere presentar alternativas para todos los módulos, sólo para los críticos.

### 5.1.1.2. Elección de una solución

Se deberá plantear una elección de implementación para el módulo indicado. Dicha elección sólo puede estar basada en los criterios mencionados en la sección anterior. Se sugiere utilizar una matriz de decisión (pero no es obligatorio)

### DFMEA

Figura 5.2: DFMEA de diseño modular

## Factibilidad de tiempos.

Aspectos a tener en consideración al realizar diagramas de tiempos:

De 365 días del año, sólo aproximadamente 245 son laborables. A esto hay que sumarle vacaciones. Según la persona, esto puede ser de 5 a 30 días hábiles por año. Esto implica una relación entre tiempo de trabajo y tiempo calendario de 0.55 a 0.65. Esto a su vez implica que algo que llevaría por ejemplo 500 HH o unos 60 días hábiles, puede llevar, en tiempo calendario, 100 días calendario, o más de 3 meses de trabajo.

Estas consideraciones están a menudo incorporadas en los programas de planificación, pero no por ello estos programas pueden incorporar consideraciones como las potenciales vacaciones existentes entre Navidad y Año Nuevo, o las vacaciones personales de cada recurso humano.

Por lo general, realizar multitasking puede resultar costoso en términos de eficiencia. Si bien puede ayudar en algunos casos con motivación, el costo en eficiencia puede ser de hasta el 40%, según la diversidad de las tareas, la persona y la cantidad de veces que se cambie de una tarea a otra por día. Siempre hay un overhead cuando se realizar multitasking.

Que las tareas no estén correlacionadas y puedan realizarse en paralelo no implica que haya suficientes recursos humanos para poder realizar el trabajo. En otras palabras, si hay un equipo de dos personas, o bien no pueden realizar más de dos tareas en paralelo, o bien no pueden dedicar el 100% de su tiempo para cada tarea, con el consecuente overhead.

Las tareas no se deben tratar como los títulos de las secciones del informe. Una planificación adecuada debe tener suficiente granularidad, mostrando pasos del desarrollo como mínimo a nivel módulo.

Cuando se requiere pedir componentes a un proveedor externo, se deben considerar siempre los lead times. Por lo general, los tiempos de los proveedores externos pueden mostrarse de dos modos: o bien con una tarea que está fuera del control del proyecto y que equivale al lead time estimado, o bien se utilizan XPI and XPO (Cross Project Input y Cross Project Output), que son milestones que indican el pedido del material, y su recepción. Estos milestones se utiliza para vincular dos o más planes que están relacionados entre sí: por ejemplo, el XPO del proyecto que es el pedido de componentes, es el XPI del proveedor, que deberá comenzar a trabajar en su proceso cuando recibe todas las especificaciones y el pago del pedido realizado.

Es importante realizar este análisis con la mayor seriedad posible: se le recuerda al alumno que está bien puede ser la única vez que pueda hacer un análisis de esta índole sin que los errores en la estimación tengan consecuencias a nivel profesional.

### Planificación (PERT y simulación de Montecarlo)

### Programación (Gantt)

## Factibilidad económica. (Mercado, costos, VAN, TIR, Punto de Equilibrio)

Factores a considerar:

- Dimensionamiento del mercado (si todos los que tienen el problema que se está resolviendo compraran la solución propuesta, ¿cuánto se vendería?) y elección de una porción target del mercado (para mercados nuevos la porción puede ser mayor, para mercados saturados –con mucha oferta de productos similares- la competencia limita la porción que tiene sentido aspirar a conseguir)
- Determinación de costos de inversión
- Determinación de costos fijos (oficinas, servicios, personal administrativo, marketing –puede ser costo fijo, inversión o ambas-, otros sueldos. En el caso de los sueldos recordar que no sólo hay una diferencia entre el bruto y el neto sino que hay una diferencia entre lo que la empresa paga y el bruto. La relación final entre costo empresa y valor neto en mano para un empleado se puede aproximar a menudo con el valor 1.7)
- Determinación de costos variables (Bill of Materials, costo de empaquetado y transporte si corresponde. Para grandes volúmenes de producción, el tiempo de testeo o verificación de calidad del producto se considera un costo variable. Caso contrario se aproxima con el sueldo de un ingeniero de test que resulta un costo fijo).
- Flujo de caja, mostrando desde el período 0 (inversión) la evolución financiera del proyecto. Recordar incluir impuestos (IIBB, IGG, IVA, importación cuando corresponda)
- Indicadores de valuación de proyecto: pueden ser la VAN, la TIR o el PE, pero depende mayormente del tipo de proyecto. En cualquier caso, se deberá realizar un análisis financiero del proyecto, si no con estos indicadores, con otros que resulten convenientes.

## Factibilidad legal y responsabilidad civil (regulaciones y licencias)

Esta sección tiene tres partes:

- Responsabilidad civil: ¿qué forma legal se debería utilizar para poder vender el producto o servicio planteado en la factibilidad económica? ¿Una SRL, una SAS, una SA, etc? El objetivo es establecer el formato que conviene (implica plasmar las consecuencias de la elección en la factibilidad económica)
- Regulaciones: refiere a la búsqueda de todas las normativas que pudieren ser aplicables o cuando menos relevantes para consulta. Hay tres formas sencillas de encarar la búsqueda:
  - Página de IRAM (tiene un buscador relativamente sencillo de usar).
  - Buscar un referente del área o la industria que conozca del tema
  - Buscar un producto de la competencia, o que está relacionado/esté en la misma industria y buscar qué certificaciones tiene.
- Licencias: ¿es necesario pagar alguna licencia para operar el negocio, o para usar algún tipo de instrumental o certificar algo? No siempre son necesarias, pero debe ser considerado.

# 6. Ingeniería de detalle

Detalles de forma a tener en cuenta:

Para cada gráfico de bloques, circuito o esquema modular planteado, deberá ser siempre posible encontrar claves contextuales para ubicarlo en un gráfico de mayor abstracción, como el diagrama modular o el de interfaces. Para eso hay ciertas prácticas que ayudan mucho

1. Nomenclatura de interfaces. Si se hace “zoom in” en un circuito, es importante que tanto en la imagen detallada como en la de mayor nivel se usen los nombres de las interfaces, permitiendo al lector encontrar cuál es la parte del sistema que se está agrandando. Cuidado: esto no implica escribir una variable relevante de señal ya que en algunos casos esto puede ser ambiguo y puede estar presente en muchos lados (ejemplo: 24V). En su lugar conviene utilizar nomencladores únicos (por ejemplo: “24Vin_acqsys”)
2. Nomenclatura de módulo: aquellos módulos que aparezcan duplicados en ambos gráficos deberán tener su nombre escrito en ambos dos, idealmente en la misma ubicación del gráfico (ejemplo, parte superior central del bloque)

## Hardware

### Diagrama de bloques (hardware).

### Descripción detallada de cada bloque

### Detalles de selección y cálculo de los elementos circuitales de cada bloque

### Plan de pruebas de cada modulo

## Software

### Diagrama de estados y flujogramas

### Análisis de complejidad

### Descripción de subrutinas

### Listados comentados del código

### Plan de prueba de módulos y de depuración de Software

# 7. Construcción del prototipo

## Definición de los módulos

## Diseño de los circuitos impresos

## Diseño mecánico

## Detalles de construcción y precauciones especiales de montaje

## Bill of Materials (BOM)

# 8. Validación del prototipo

## Estudios de confiabilidad de hardware y de software

El análisis de confiabilidad tiene como objetivo algo más que obtener números: un análisis de confiabilidad debe, incluir conclusiones sobre los datos obtenidos que evalúen la confiabilidad total del sistema. Deberá ser posible explicar cuáles son los puntos críticos del sistema, si se logra cumplir con los requerimientos planteados, o qué implicancias tienen los hallazgos en el marco de la factibilidad económica. Deberá recordarse que una confiabilidad alta implica mayor tiempo de vida del producto y menos impacto de garantías, repuestos, etc, mientras que una menor confiabilidad no sólo incrementa estos costos, sino que puede ser un punto de mejora a considerar aunque fuere en futuros diseños.

## Resultados

En esta sección se debe mostrar el resultado de las pruebas de validación y otras pruebas que puedan ser relevantes. Deberá ser claro para el lector lo que el resultado implica (es decir, si pasa el criterio de aceptación o no y por qué).

## Evaluación

### Evaluación de resultados técnicos

En esta sección se analizan los resultados: se compara lo obtenido contra lo esperado (no el criterio de aceptación sino el objetivo de diseño) y se analizan todos los resultados donde se pueda encontrar errores o posibilidades de mejora futura.

### Evaluación de la planificación

Se deberán plasmar los tiempos reales de las tareas planteadas en las subsecciones anteriores, y compararlo contra las proyecciones. Se espera un análisis del motivo de las diferencias: vacaciones no consideradas, tareas que resultaron más largas o cortas que lo esperado por revestir mayor complejidad, problemas desincronización en el equipo, demoras para alistar la validación, demoras de proveedores, etc: ¿qué no salió según lo previsto?

### 1.1.1. Evaluación de la factibilidad financiera

Aquí se deberá considerar el resultado de los distintos análisis que influyen en la salud financiera del proyecto (confiabilidad, BOM, performance, etc) para hacer una reevaluación del análisis planteado durante las factibilidades. Es importante buscar las diferencias contra aquello planificado y hacer un análisis del origen de dichas diferencias

## Consideraciones finales hacia el producto final

Los análisis de las secciones anteriores (sobre todo los aspectos ténicos) deberían marcar algunos aspectos que deberían tenerse en cuenta a la hora de implementar el producto final.

# 9. Conclusiones

## Cumplimiento de Objetivos

Aunque una conclusión puede resumir los aspectos fundamentales del informe, no se debe usar el resumen como una conclusión. Esta podría elaborarse haciendo referencia a la importancia del trabajo o sugiriendo sus aplicaciones y generalizaciones. Asimismo, en esta sección se tratan de evaluar las implicancias de los resultados obtenidos (y analizados en la sección anterior) hacia la problemática planteada originalmente, y la distancia que hay entre “la solución ideal” y la lograda en el proyecto.

## Lecciones aprendidas

Esta sección es para detallar los aprendizajes a nivel personal y/o profesional que se hayan dado, desde aspectos vinculados a la planificación o la organización del equipo, hasta las implicancias de hacer un proyecto de esta escala. También se pueden exponer lecciones aprendidas desde lo técnico, cuando estas fuesen relevantes.

## Recomendaciones para futuros diseños

Aquí se deberían contestar dos preguntas:

1. Si el lector de este informe fuese a comenzar el diseño del producto final, ¿qué se le podría recomendar?
2. Si el lector de este informe fuese a basarse en este desarrollo para realizar algo mejorado, con mayores prestaciones o performance, o alguna variación que se adapte a otro segmento del mismo mercado, ¿qué se le podría recomendar?

# 10. Referencias (H1…4)

Esta sección no es de bibliografía sino de referencias. La diferencia radica en que la bibliografía es literatura de consulta general y puede no ser necesaria para rastrear un razonamiento o una fuente de información utilizada en el diseño, sino que sirve para ver metodologías utilizadas en la literatura para resolver algún problema, o si alguien deseara interiorizarse en alguna temática general tratada en el informe. Las referencias por otro lado son fuentes puntuales de información que ha sido utilizada en el informe. Por este motivo, toda referencia deberá estar siempre citada en el texto. Si fuese conveniente, podrían existir ambas secciones.

## LIBROS. (Autor. Título. Editorial. Fecha)

## REVISTAS. (Autor. Título. Nombre de la revista. Fecha-Volumen. Páginas)

## Notas de aplicación (incluir copia de las importantes)

# 11. Anexos Técnicos

En esta sección del informe deben de presentarse todos los documentos que sean importantes para el seguimiento y entendimiento del proyecto.

## Esquemáticos

## Planos de PCB

## Listado de Partes y Componentes (BOM)

## Códigos de Software

## Hojas de Datos de Componentes

## Hojas de Aplicación, etc.

## Otra Documentación Técnica

# Apéndice I: Documentación

## Configuración de Página

- Tamaño: A4 (21 cm x 29.7 cm)
- Márgenes: 3.5 cm izquierda, 2.5 cm derecho, 2.5 superior y 2.5 inferior.

## Encabezado y pie de página

- En el encabezado deberá figurar el título del trabajo. Si el título del trabajo es muy largo usar una síntesis del mismo donde quede claramente expresado el trabajo. Además, debe mostrarse el logo del ITBA actual. Puede utilizarse el de esta guía.
- En el pie de página habrá dos sectores: a la izquierda el capítulo y a la derecha el número de página. (Seguir ejemplo de este documento).
- La excepción es la carátula, en la cual no deberá haber ni encabezado ni pie de página.

Un camino fácil para cumplir con el formato requerido es usar este documento como modelo y simplemente escribir/copiar el texto sobre él. Junto con el informe impreso será incluido en un CD-ROM, con copia del informe en formato digital (formato PDF) y la presentación en formato Microsoft Office PowerPoint o similar.

El texto debe de ser escrito a una sola columna y todos los párrafos deben estar justificados. El documento debe estar escrito en Time New Roman 10 pt, otros tipos de forma de letra pueden ser usados solo si es necesario para casos especiales de diferenciación del párrafo. Para hacer énfasis utilice letra cursiva; no subraye. El espaciado entre líneas será de 1,2 y entre párrafos de 2.

El título debe estar en Time New Roman 18 pt, cada palabra del título debe estar con letra mayúscula con excepción de las palabras cortas (Ej de; a; en; etc). Los autores en Time New Roman 11 pt, la institución a las que pertenece en Time New Roman 10 pt y los mail de los autores en Courier 9 pt.

No se permiten más de tres niveles de encabezados.

## Figuras, Tablas y Ecuaciones

Las figuras y tablas deben de estar centradas. Los gráficos pueden estar en color o blanco y negro siempre y cuando se guarde la claridad de la información que se está presentando. En las graficas siempre usar líneas solidas con colores que permitan un claro contraste con el blanco y negro del resto del texto. Todas las tablas y figuras deben ser procesadas como imágenes. Usted tendrá el mayor control sobre la apariencia de sus figuras y tablas si es capaz de preparar archivos de imagen electrónica.

Las figuras deben tener una buena resolución tal que permita distinguir los detalles importantes de la figura. Los colores usados en la figura deberán tener suficiente contraste para que la imagen de cada figura sea clara y todos los textos de las figuras, legibles. Todas las tablas y figuras deberán tener un título explicativo además de la numeración. Las figuras y tablas utilizadas deberán tener suficiente resolución para que su impresión resulte en detalles legibles.

Los incisos de eje de la figura con frecuencia son una fuente de confusión. Utilice palabras en vez de símbolos. Por ejemplo, escriba la cantidad “Amplitud,” o “Amplitud A,” no solamente “A.” Ponga las unidades entre corchetes. Por ejemplo: Amplitud de la corriente [A]

Los ejes deberán estar rotulados tanto con unidades como con un texto explicativo de lo representado en el eje. Cuando sea necesario, no utilice multiplicadores, sino prefijos (p, n, µ, m, k, M, G, T, P, etc.)

Todas las ecuaciones deben estar centradas.

Enumere las ecuaciones de forma consecutiva con números de ecuación entre paréntesis resaltado con el margen derecho, como en (1). Primero utilice el editor de ecuación para crear la ecuación, después seleccione el estilo marcas para la “Ecuación”. Presione la tecla tab y escriba el número de ecuación entre paréntesis. Para hacer sus ecuaciones más compactas, debe utilizar el solidus ( / ), la expresión función , o exponentes apropiados. Utilice paréntesis para evitar ambigüedades en los denominadores.

(1)

Asegúrese de que los símbolos en su ecuación hayan sido definidos antes de que aparezca la ecuación o inmediatamente después. Los símbolos deben aparecer en cursiva. Refiérase a “(1),” no “Eq. (1)” o “ecuación (1),” excepto al principio de una oración: “Ecuación (1) es ... .”

## Abreviaturas y Acrónimos:

Defina las abreviaturas y los acrónimos desde la primera vez que se utilicen en el texto, incluso después que ya hayan sido definidas en el resumen. Las abreviaturas que incorporan puntos no deben tener espacios: escriba “C.N.R.S.,” no “C. N. R. S.” No utilice abreviaturas en el título a menos que sea inevitable.

## Unidades

Se debe utilizar el Sistema Internacional de Unidades, SI (MKS), así como las normas internacionales efectivas para los símbolos y unidades de medida. Se aceptan como excepciones a esta regla, el caso de las unidades de medida en inglés que se usan como identificadores en el comercio, tales como “3½ in disk drive.”

Encabezado y Pie de Página: En el encabezado debe de figurar el título del trabajo. Si el título del trabajo es muy largo usar una síntesis del mismo donde quede claramente expresado el trabajo.

El Pie de Página estará conformado por dos sectores, a la izquierda el capítulo y a la derecha el número de página. (Seguir ejemplo de este documento).

## Referencias

Enumere las citas de forma consecutiva encerradas en corchetes [1]. La puntuación de la oración a continuación de los corchetes [2]. Las referencias múltiples [2], [3] se deben enumerar con corchetes independientes [1]–[3]. Al citar una sección en un libro, por favor enumere las páginas importantes con números [2]. En las oraciones, refiérase simplemente al número de referencia, como en [3]. No utilice “Ref. [3]” o “referencia [3]” excepto al principio de una oración: “La Referencia [3] muestra ...”

Por favor, observe que las referencias al final de este documento se encuentran en el estilo de referencia deseado. Mencione los nombres de todos los autores; no utilice “et al.” a no ser que existan 6 o más autores. Utilice un espacio después de las iniciales de los autores. Las referencias que correspondan a trabajos no publicados deben ser citadas como “no publicadas” [4].

Utilice la mayúscula solamente en la primera palabra del título del informe, excepto para los nombres propios y para los símbolos de los elementos.

### Libros

##### Formato Básico:

[1] J. K. Author, “Title of chapter in the book” in Title of His Published Book, xª ed. City of Publisher, Country if not USA: Abbrev. Of Publisher, year, ch. x, secc. x, pp. xxx–xxx.

NOTA: Usar et al. cuando son tres o más nombres.

##### Ejemplos

[1] B. Klaus and P. Horn, Robot Vision. Cambridge, MA: MIT Press, 1986.

[2] L. Stein, “Random patterns,” en Computers and You, J. S. Brake, Ed. New York: Wiley, 1994, pp. 55-70.

[3] R. L. Myer, “Parametric oscillators and nonlinear materials,” in Nonlinear Optics, vol. 4, P. G. Harper and B. S. Wherret, Eds. San Francisco, CA: Academic, 1977, pp. 47-160.

[4] M. Abramowitz and I. A. Stegun, Eds., Handbook of Mathematical Functions (Applied Mathematics Series 55). Washington, DC: NBS, 1964, pp. 32-33.

[5] E. F. Moore, “Gedanken-experiments on sequential machines,” in Automata Studies (Ann. of Mathematical

Studies, no. 1), C. E. Shannon and J. McCarthy, Eds. Princeton, NJ: Princeton Univ. Press, 1965, pp. 129-153.

[6] Westinghouse Electric Corporation (Staff of Technology and Science, Aerospace Div.), Integrated Electronic Systems. Englewood Cliffs, NJ: Prentice-Hall, 1970.

[7] M. Gorkii, “Optimal design,” Dokl. Akad. Nauk SSSR, vol. 12, pp. 111-122, 1961 (Transl.: in L. Pontryagin, Ed., The Mathematical Theory of Optimal Processes. New York: Interscience, 1962, ch. 2, sec. 3, pp. 127-135).

[8] G. O. Young, “Synthetic structure of industrial plastics,” in Plastics, vol. 3, Polymers of Hexadromicon, J. Peters, Ed., 2nd ed. New York: McGraw-Hill, 1964, pp. 15-64.

### Manuales

##### Formato Básico:

[1] Title of the Manual/Handbook, x ed., Abbrev. Name of Co., City of Co., Abbrev. State, year, pp. xx-xx.

##### Ejemplos

[1] Transmission Systems for Communications, 3rd ed., Western Electric Co., Winston-Salem, NC, 1985, pp. 44–60.

[2] Motorola Semiconductor Data Manual, Motorola Semiconductor Products Inc., Phoenix, AZ, 1989.

[3] RCA Receiving Tube Manual, Radio Corp. of America, Electronic Components and Devices, Harrison, NJ, Tech. Ser. RC-23, 1992.

### Reportes

La forma general para citar los informes técnicos es colocar el nombre y la ubicación de la empresa o institución después del autor y título y dar el número de informe y la fecha al final de la referencia.

##### Formato Básico:

[1] J. K. Author, “Title of report,” Abbrev. Name of Co., City of Co., Abbrev. State, Rep. xxx, year.

##### Ejemplos

[1] E. E. Reber absorption in the earth’s atmosphere,” Aerospace Corp., Los Angeles, CA, Tech. Rep. TR-0200 (4230-46)-3, Nov. 1988.

[2] J. H. Davis and J. R. Cogdell, “Calibration program for the 16-foot antenna,” Elect. Eng. Res. Lab., Univ. Texas, Austin, Tech. Memo. NGL-006-69-3, Nov. 15, 1987.

[3] R. E. Haskell and C. T. Case, “Transient signal propagation in lossless isotropic plasmas,” USAF Cambridge Res. Labs., Cambridge, MA, Rep. ARCRL-66-234 (II), 1994, vol. 2.

[4] M. A. Brusberg and E. N. Clark, “Installation, operation, and data evaluation of an oblique-incidence ionosphere sounder system,” in “Radio Propagation Characteristics of the Washington-Honolulu Path,” Stanford Res. Inst., Stanford, CA, Contract NOBSR-87615, Final Rep., Feb. 1995, vol. 1.

[5] P. Diament and W. L. Lupatkin, “V-line surface-wave radiation and scanning,” Dept. Elect. Eng.,

New York, Sci. Rep. 85, Aug. 1991.

### Artículos de Conferencias

La forma general para citar los artículos técnicos publicados en las actas de una conferencia consiste en enumerar el/los autor/es y el título del trabajo, seguido del nombre (y la ubicación, si se da) de la publicación de la conferencia en itálica usando estas abreviaturas estándar.

Palabra en el título de la conferencia | Abreviar a
Annals | Ann.
Annual | Annu.
Colloquium | Colloq.
Conference | Conf.
Congress | Congr.
Convention | Conv.
Digest | Dig.
Exposition | Expo.
International | Int.
National | Nat.
Proceedings | Proc.
Record | Rec.
Symposium | Symp.
Technical Digest | Tech. Dig.
Technical Paper | Tech. Paper
First | 1st
Second | 2nd
Third | 3rd
Fourth/nth ... | 4th/nth...

Escriba todas las palabras restantes, pero omita la mayoría de artículos y preposiciones como "del" y "en", o en inglés, “of the” y “on”. Es decir, Proceedings of the 1996 Robotics and Automation Conference se convierte en Proc. 1996 Robotics and Automation Conf.

##### Formato Básico:

[1] J. K. Author, “Title of paper,” in Unabbreviated Name of Conf., City of Conf., Abbrev. State (if given), year, pp. xxx-xxx.

##### Para un artículo de conferencia electrónico cuando no hay números de página:

[1] J. K. Author [two authors: J. K. Author and A. N. Writer] [three or more authors: J. K. Author et al.],

“Title of Article,” in [Title of Conf. Record as it appears on the copyright page], [copyright year] © [IEEE or applicable copyright holder of the Conference Record]. doi: [DOI number]

##### Para un artículo no publicado presentado en una conferencia:

[1] J. K. Author, “Title of paper,” presented at the Unabbrev. Name of Conf., City of Conf., Abbrev. State, year.

### Fuentes online

La directriz básica para citar fuentes online es seguir la cita estándar para la fuente dada previamente y agregar el identificador de objeto digital (DOI) al final de la citación, o agregar el DOI en lugar de números de página si la fuente no está paginada. El DOI para cada artículo de la conferencia IEEE se asigna cuando el artículo se procesa para su inclusión en la biblioteca digital IEEE Xplore y se incluye con los datos de referencia del artículo en Xplore. Consulte el Sistema DOI para obtener más información sobre la referencia DOI.

#### FTP

##### Formato Básico:

[1] J. K. Author. (year). Title (edition) [Type of medium]. Available FTP: Directory: File:

##### Ejemplo:

[1] R. J. Vidmar. (1994). On the use of atmospheric plasmas as electromagnetic reflectors [Online]. Available FTP: atmnext.usc.edu Directory: pub/etext/1994 File: atmosplasma.txt

#### WWW

##### Formato Básico:

[1] J. K. Author. (year, month day). Title (edition) [Type of medium]. Available: http://www.(URL)

##### Ejemplo:

[1] J. Jones. (1991, May 10). Networks (2nd ed.) [Online]. Available: http://www.atm.com

#### E-Mail

##### Formato Básico:

[1] J. K. Author. (year, month day). Title (edition) [Type of medium]. Available e-mail: Message:

##### Ejemplo:

[1] S. H. Gold. (1995, Oct. 10). Inter-Network Talk [Online]. Available e-mail: COMSERVE@RPIECS Message: Get NETWORK TALK

### Patentes, Estándares, Tesis, No publicados

#### Patentes

##### Formato Básico:

[1] J. K. Author, “Title of patent,” U.S. Patent x xxx xxx, Abbrev. Month, day, year.

##### Ejemplos:

[1] J. P. Wilkinson, “Nonlinear resonant circuit devices,” U.S. Patent 3 624 125, July 16, 1990.

NOTE: Use “issued date” if several dates are given.

#### Estándares

##### Formato Básico:

[1] Title of Standard, Standard number, date.

##### Ejemplos:

[1] IEEE Criteria for Class IE Electric Systems, IEEE Standard 308, 1969.

[2] Letter Symbols for Quantities, ANSI Standard Y10.5-1968.

#### Tesis (M.S.) y Disertaciones (Ph.D.)

##### Formato Básico:

[1] J. K. Author, “Title of thesis,” M.S. thesis, Abbrev. Dept., Abbrev. Univ., City of Univ., Abbrev. State, year.

[2] J. K. Author, “Title of dissertation,” Ph.D. dissertation, Abbrev. Dept., Abbrev. Univ., City of Univ., Abbrev. State, year.

##### Ejemplos:

[1] J. O. Williams, “Narrow-band analyzer,” Ph.D. dissertation, Dept. Elect. Eng., Harvard Univ., Cambridge, MA, 1993.

[2] N. Kawasaki, “Parametric study of thermal and chemical nonequilibrium nozzle flow,” M.S. thesis, Dept. Electron. Eng., Osaka Univ., Osaka, Japan, 1993.

[3] N. M. Amer, “The effects of homogeneous magnetic fields on developments of tribolium confusum,” Ph.D.

dissertation, Radiation Lab., Univ. California, Berkeley, Tech. Rep. 16854, 1995. *** The state abbreviation is

omitted if the name of the university includes the state name, i.e., “Univ. California, Berkeley.” ***

[4] C. Becle, These de doctoral d’etat, Univ. Grenoble, Grenoble, France, 1968.

### Periódicos

NOTE: When referencing IEEE Transactions, the issue number should be deleted and month carried.

##### Formato Básico:

[1] J. K. Author, “Name of paper,” Abbrev. Title of Periodical, vol. x, no. x, pp. xxx-xxx, Abbrev. Month, year.

##### Ejemplos:

[1] R. E. Kalman, “New results in linear filtering and prediction theory,” J. Basic Eng., ser. D, vol. 83, pp. 95-108, Mar. 1961.

[2] Ye. V. Lavrova, “Geographic distribution of ionospheric disturbances in the F2 layer,” Tr. IZMIRAN, vol. 19, no. 29, pp. 31–43, 1961 (Transl.: E. R. Hope, Directorate of Scientific Information Services, Defence Research Board of Canada, Rep. T384R, Apr. 1963).

[3] E. P. Wigner, “On a modification of the Rayleigh–Schrodinger perturbation theory,” (in German), Math.

Naturwiss. Anz. Ungar. Akad. Wiss., vol. 53, p. 475, 1935.

[4] E. H. Miller, “A note on reflector arrays,” IEEE Trans. Antennas Propag..., to be published. **

[5] C. K. Kim, “Effect of gamma rays on plasma,” submitted for publication. **

[6] W. Rafferty, “Ground antennas in NASA’s deep space telecommunications,” Proc. IEEE vol. 82, pp. 636-640, May 1994.

** Always use this style when the paper has not yet been accepted or scheduled for publication. Do not use “to appear in.”

### Referencias

NOTE: Use et al. when three or more names are given.

#### References in Text:

References need not be cited in the text. When they are, they appear on the line, in square brackets, inside

the punctuation. Grammatically, they may be treated as if they were footnote numbers, e.g.,

as shown by Brown [4], [5]; as mentioned earlier [2], [4]–[7], [9]; Smith [4] and Brown and Jones [5]; Wood et al. [7]

or as nouns:

as demonstrated in [3]; according to [4] and [6]–[9].

#### References Within a Reference:

Check the reference list for ibid. or op. cit. These refer to a previous reference and should be eliminated from the

reference section. In text, repeat the earlier reference number and renumber the reference section accordingly. If the ibid. gives a new page number, or other information, use the following forms:

[3, Th. 1]; [3, Lemma 2]; [3, pp. 5-10]; [3, eq. (2)]; [3, Fig. 1]; [3, Appendix I]; [3, Sec. 4.5]; [3, Ch. 2, pp. 5-10]; [3, Algorithm 5].

NOTE: Editing of references may entail careful renumbering of references, as well as the citations in text.

#### Style

Reference numbers are set flush left and form a column of their own, hanging out beyond the body of the reference. The reference numbers are on the line, enclosed in square brackets. In all references, the given name of the author or editor is abbreviated to the initial only and precedes the last name. Use commas around Jr., Sr., and III in names. If there Grammatically, they may be treated as if they were footnote numbers, e.g.,

are many names, use et al. Note that when citing IEEE Transactions, if the month is not available, the number may be kept, although it is normally deleted. Keep the day of the month when referencing a patent. References may not include all information; please obtain and include relevant information. Do not combine references. There must be only one reference with each number. If there is a URL included with the print reference, it can be included at the end of the reference.

## Otras Recomendaciones:

Utilice un espacio después de los puntos y después de los dos puntos. Utilice guión en los modificadores compuestos: “razón señal-ruido.” Evite los gerundios, como “Utilizando (1), el potencial fue calculado.” [No está claro quién o qué se utilizó en (1).] Escriba entonces, “El potencial fue calculado utilizando (1),” o “Utilizando (1), calculamos el potencial.”

Utilice un cero antes de puntos decimales: “0.25,” no “.25.” Utilice “cm³,” no “cc.” Indique las dimensiones de muestra tales como “0.1 cm” no “0.1.” La abreviatura para “segundos” es “s,” no “sec” ni “seg”. No mezcle abreviaturas ni ortografías completas de las unidades: utilice “A/m²” o “Amperes por metros cuadrados,” no “Amperes/m².” Cuando exprese un rango de valores, escriba “7 a 9” o “7-9,”

El diseño de página debe mantenerse de manera consistente a lo largo del trabajo.

Las figuras que se ubiquen en disposición apaisada deben orientarse correctamente. El borde inferior de la figura apaisada se coloca próximo al margen derecho del documento que está orientado en posición vertical.

Se debe evitar que enumeraciones, tablas y figuras queden divididas entre varias páginas.

La numeración de las páginas debe resultar legible y sobria.

Al generar cada versión de un informe, se recomienda releer el trabajo completo, procurando detectar inconsistencias, faltas de claridad, u otros errores. Suele ser muy conveniente pedir a una persona ajena al tema que lea el informe, y señale los párrafos que resultaron de difícil comprensión.

## Documentación en formato electrónico.

Excepto expresa indicación en contrario, los envíos de información definidos como “Documentos en Formato Electrónico” (DFE) se llevarán a cabo por medio de mensajes de correo electrónico enviados a una cuenta que será especificada por la cátedra

Para facilitar la correcta identificación y tratamiento de los mensajes, éstos deberán consignar en forma exacta, en el campo de “asunto”, únicamente la secuencia de caracteres

ITBA-Proyecto Final xxxx

donde el texto xxxx, mostrado a manera de ejemplo, debe ser sustituido por el título del proyecto, precedido de un espacio en blanco. Entre “ITBA” y “Proyecto Final” se inserta un guion (-). Debe haber un espacio entre “Proyecto” y “Final”.

En general, todos los documentos que se adjunten, incluyendo imágenes de formularios firmados, deberán presentarse en formato pdf.

# Apéndice II: Recomendaciones de Estilo y Errores Frecuentes.

Estas recomendaciones de estilo son de la autoría de Andrés Carlos Rodríguez.

Las características del Informe de Proyecto Laboral hacen necesario puntualizar algunas recomendaciones de estilo[^1].

## Lenguaje y estructuras coloquiales

Un informe no es una transcripción de una conversación, ni tampoco es el parlamento de un orador que narra una historia. Ciertos términos y giros del idioma, que pueden ser apropiados para la comunicación verbal, no son aceptables en un informe escrito.

Usos correctos | Usos Incorrectos
El rendimiento del nuevo producto debe superar al del modelo anterior. | El nuevo producto debe ser al menos un poco mejor que el modelo anterior.
Existen en el mercado reguladores de tensión para distintas potencias. | Los reguladores de tensión vienen de distintas potencias.
Se emplean algunos componentes discretos, tales como[^2] capacitores y resistores. | Se emplean algunos componentes discretos como ser capacitores y resistores
Por medio de un sensor se enciende y apaga la iluminación de la oficina. | Por medio de un sensor se prende y apaga la luz de la oficina.
Un pequeño programa, conocido como “demonio”, controla la impresora. | Un demonio controla la impresora.
El instalador conecta los equipos mediante cables blindados. | El instalador cablea los equipos.
El técnico conecta el equipo a la red y da por finalizado el proceso de puesta en marcha. | El equipo se enchufa a la red, y listo.
Se trata de un modelo de bajo costo. | Es un modelo barato.

## Uso coherente de mayúsculas en expresiones y nombres compuestos.

Al referirse a métodos, productos o cargos, debe emplearse siempre una misma convención en cuanto al uso de mayúsculas.

Usos correctos | Usos Incorrectos
El Gerente de Producto… | El gerente de Producto…
El gerente de producto… | El Gerente de producto…
El Algoritmo Genético Multivariable… | El algoritmo Genético multivariable…
Un algoritmo genético multivariable… | Un Algoritmo genético multivariable…

## Modo de hacer referencia a personas, empresas e instituciones

Se deben mantener las mismas palabras, y adoptar una convención en cuanto al uso de mayúsculas. Por ejemplo, referirse siempre a “el alumno”, “la Empresa”, “la Universidad”, “el Cliente”.

En el caso de una empresa puede emplearse el nombre propio de ésta. En tal caso, la primera mención detallará la razón social completa, y puede emplearse la abreviatura oficial en las menciones subsiguientes.

Por ejemplo,

PSM Corp. es una corporación cuya sede central está radicada en los Estados Unidos de América. La sigla proviene de “Precise Scientific Measurements”, que fue el nombre elegido por sus fundadores en 1962.

PSM Argentina (en adelante PSM) es un sociedad anónima que opera en la República Argentina desde 1979, y es una subsidiaria de PSM Corp.

Las instalaciones de PSM en la Provincia de Buenos Aires incluyen un importante laboratorio certificado que brinda servicios de…

En el caso del ITBA, debe tenerse presente que se trata de una Universidad y no de una “facultad”. En otras universidades existen unidades organizativas llamadas “facultades”, dirigidas por un decano, y que dependen del rector. En el ITBA no existen “facultades” sino “escuelas”.

## Uso exagerado de estilo impersonal.

Si bien los informes técnicos enfatizan la descripción de hechos desde una perspectiva impersonal, en ciertos casos no es posible despersonalizar completamente la exposición.

Usos correctos | Usos Incorrectos
El proceso de inducción incluyó un viaje de entrenamiento a Lima. | Se viajó a Lima.
El alumno aprendió sobre Unix. | Se aprendió sobre Unix.
El alumno programó esta subrutina en lenguaje Python. | Esta subrutina se programó en Python.

## Cambio de la persona gramatical.

Si el estilo elegido es impersonal, se deben evitar párrafos en los que el autor se dirige al lector como si se tratara de una conversación grupal. Tampoco se debe adoptar un tono exageradamente personal y subjetivo.

Usos correctos | Usos Incorrectos
El dispositivo falló reiteradamente. Pudo observarse que la unión era defectuosa. | El dispositivo falló reiteradamente. Ahora podemos observar que la unión ...
El método presenta un error que puede resultar en … | Si tenemos en cuenta el error del método, resulta que …
El teorema de Shannon-Hartley muestra un aspecto importante de la teoría… | Sabemos que el Teorema de Shannon-Hartley muestra un aspecto…
La tarea asignada fue muy desafiante y dejó enseñanzas valiosas. | Me interesó mucho la tarea que me asignó mi supervisor y que me dejó grandes enseñanzas.

## Uso de términos supuestamente “cultos”

Algunos términos como “cual”, y “realizar”, que no son tan frecuentes en el lenguaje coloquial, son usados a veces como si se quisiera revestir de formalidad un texto que no la tiene. Sin embargo, el resultado no es el buscado: el documento perderá claridad y parecerá escrito de un modo artificialmente afectado.

En lugar de “cual”, casi siempre es preferible emplear “que”. Por su parte, el verbo “realizar” no siempre puede ser utilizado como reemplazo de “hacer”. En algunos casos puede emplearse la expresión “llevar a cabo”.

Usos correctos | Usos Incorrectos
Se emplea un LED que emite luz roja… | Se emplea un LED, el cual emite luz roja…
… hicieron un esfuerzo adicional... | … realizaron un esfuerzo adicional.
… hizo un comentario…. | … realizó un comentario...
…realizaron una inspección en el lugar.

## Pertenencia y posesión

En muchos casos, los verbos “tener” y “poseer[^3]” resultan prácticamente intercambiables, por lo que “poseer” resulta frecuentemente elegido para evitar repeticiones y, en menor medida, por considerarse un término más refinado. Sin embargo, cuando se trata de relaciones o características, “poseer” no es sinónimo de “tener”. En este caso, si se desea evitar repeticiones, pueden emplearse las expresiones “cuenta con” o “incluye”.

Usos correctos | Usos Incorrectos
El sistema tiene funciones avanzadas. | El sistema posee funciones avanzadas.
La empresa cuenta con 50 empleados. | La empresa posee 50 empleados.
La batería tiene una vida útil limitada. | La batería posee una vida útil limitada.
… incluye un cálculo preciso de ... | … posee un cálculo preciso de...

En otros casos se emplean construcciones que denotan pertenencia o posesión cuando en realidad se intenta dar una referencia al origen de una persona o de un producto.

Usos correctos | Usos Incorrectos
…ingeniero graduado en el ITBA… | …ingeniero del ITBA…
Los conectores usados en Europa… | Los conectores de Europa…
… un router fabricado por Cisco. | … un router de Cisco.

## Uso de mayúsculas en siglas

Las siglas que provienen de abreviaturas deben escribirse en mayúsculas, aunque en la práctica se las use informalmente como sustantivos.

Usos correctos | Usos Incorrectos
El circuito trabaja con varios LED[^4]. | El circuito trabaja con varios led.
| El circuito trabaja con varios Leds.
| El circuito trabaja con varios LEDS.

## Caso de ciertas palabras que se abrevian en el uso coloquial

Algunos términos y expresiones suelen abreviarse en el uso coloquial, pero no pueden ser alterados de la misma manera en documentos escritos

Usos correctos | Usos Incorrectos
Sony anunció un microprocesador que… | Sony anunció un micro que…
…crearon el software y el hardware de… | …crearon el soft y el hard de …
| … crearon el S&H de …

## Uso del adjetivo como reemplazo de un sustantivo

Es frecuente, en el lenguaje coloquial, el empleo de adjetivos como versión abreviada de una expresión que cumple la función de un sustantivo. Esto no es apropiado en un informe escrito.

Usos correctos | Usos Incorrectos
Se utilizó un nuevo circuito integrado… | Se utilizó un nuevo integrado que…
Este circuito impreso es muy complejo… | Este impreso es muy complejo…
… atenúa los sonidos graves… | … atenúa los graves…

## Uso de nombre de una disciplina como referencia a los objetos de su estudio

Es frecuente en el uso coloquial el empleo del nombre de una ciencia o disciplina para referirse a los objetos y temas que ésta estudia. Esto no es apropiado en un informe escrito.

Usos correctos | Usos Incorrectos
Los componentes electrónicos elegidos brindan robustez al transmisor satelital. | El transmisor satelital emplea una electrónica robusta.
La nueva batería se basa en compuestos químicos producidos en China. | La nueva batería emplea químicos procedentes de China.
El diseño de los circuitos digitales del grabador resultó relativamente sencillo. | Fue sencillo desarrollar la lógica del grabador.
El mecanismo implementado logra un movimiento suave, preciso y veloz. | La mecánica implementada logra un movimiento suave, preciso y veloz.

## Voz pasiva y modos impersonales con referencia a varios objetos

Al emplear voz pasiva o un modo impersonal, debe prestarse atención a la concordancia de las expresiones en singular o en plural.

Usos correctos | Usos Incorrectos
Se detectaron varios problemas[^5]… | Se detectó varios problemas…
Se conectaron tres módulos… | Se conectó tres módulos…
Se analizaron múltiples opciones. | Se analizó múltiples opciones.
Se recurrió a cinco proveedores. | Se recurrieron a cinco proveedores.

## Proximidad del modificador

Debe procurarse que los adjetivos o adverbios que modifican, respectivamente, a un sustantivo o a un verbo, se encuentren próximos a ellos. Esto puede presentar algunas dificultades cuando se emplean construcciones de varias palabras que toman el rol de un sustantivo o de un verbo.

Usos correctos | Usos Incorrectos
…el Control Automático de Nivel… | …el Control de Nivel Automático…
… desarrollo rápido de software… | … desarrollo de software rápido…
... método optimizado para obtención de muestras al azar. | … método para obtención de muestras al azar optimizado.
… sensor infrarrojo de distancia… | … sensor de distancia infrarrojo…

## Uso incorrecto de las palabras “mismo” o “misma”.

Estas palabras indican igualdad: “Estos lápices son del mismo color”. Sin embargo, suelen emplearse como “punteros” para referir a objetos ya nombrados, quizá intentando no repetir una palabra. Cuando la referencia es unívoca, este uso es innecesario.

Usos correctos | Usos Incorrectos
El amplificador controla la corriente que circula por su salida. | El amplificador controla la corriente que circula por la salida del mismo.

En otros casos, cuando se trata de oraciones largas, la referencia resulta ambigua.

Usos correctos | Usos Incorrectos
El sistema está manejado por un módulo especial, que contiene un procesador controlado por un programa grabado en un disco provisto con dicho módulo. | El sistema está manejado por un módulo especial, que contiene un procesador controlado por un programa grabado en un disco provisto con el mismo.

En general, la repetición ocasional está permitida y hasta recomendada, con expresiones tales como “con dicho módulo”, “el módulo mencionado”, “el citado módulo”, y similares[^6].

## Términos innecesariamente tomados del inglés

Hay algunas palabras en inglés que han adquirido un significado tecnológico propio, ya muy difundido y difícil de reemplazar. Hardware, software, clock (como referencia de tiempo en circuitos digitales) y streaming, son algunos ejemplos.

En aquellos casos en que sea inevitable utilizar un término en inglés, deberán emplearse caracteres inclinados (“itálicos” o bastardilla) sólo para la palabra afectada; no para los signos de puntuación que estuvieran contiguos.

Generalmente existen términos apropiados en español, y no hay motivos válidos para emplear los términos extranjeros, excepto por su uso cotidiano en la conversación.

Un caso agravado es la “castellanización” del término en inglés, convirtiéndolo en una especie de verbo. Si escribir “test” es innecesario porque existen en español palabras como “prueba”, “ensayo”, “examen” y otras similares; es aún menos aceptable usar supuestas derivaciones verbales como, por ejemplo, “testeo”.

Usos correctos | Usos Incorrectos
Prueba, ensayo, examen | Test, testeo
Prueba, verificación | Check, chequeo[^7]
Configuración, puesta en marcha | Setup, seteo

Se da el caso, además, de ciertos términos que suelen traducirse del inglés en forma errónea, aunque en cierto modo legitimada por la práctica.

Término | Significado | Traducción Errónea
Proprietary | Exclusivo de un fabricante. No estandarizado; especial. | Propietario (Dueño / Owner)
Library | Biblioteca. Conjunto de programas de software con funciones relacionadas. | Librería (Venta de libros / Bookstore)
Embedded | Incrustado, incluido o integrado en un producto | Embebido (Empapado en líquido / Drenched)

En los casos de “librería” y “embebido” puede aceptarse el empleo de estas palabras, siempre que en su primer uso sean escritas entre comillas y aclarando a continuación el significado que se les debe asignar en el contexto del informe.

## Uso inapropiado de adjetivos

Los adjetivos permiten enriquecer las descripciones, pero no corresponde emplear superlativos o términos que denoten exageración; ni comparativos cuando no quede clara la referencia con la que se compara.

Usos correctos | Usos Incorrectos
…con un rendimiento destacado. | …con un rendimiento espectacular[^8].
… logra un movimiento veloz. | … logra una velocidad impresionante.
El proyecto presenta riesgos moderados. | El proyecto no es demasiado riesgoso.
… con mejoras frente al modelo LT. | … es mucho mejor[^9].
… de mayor brillo que una lámpara incandescente. | … de mayor brillo.

## Significado de la sigla PyME

La sigla PyME refiere a una categoría de empresas, que abarca a las pequeñas y medianas. Sin embargo, una empresa determinada no podría ser pequeña y mediana a la vez. Por lo tanto, una empresa no puede ser una PyME.

Usos correctos | Usos Incorrectos
TechPlus es una empresa mediana. | TechPlus es una PyME.
TechPlus se encuadra en el segmento de las PyME. | TechPlus se encuadra en el segmento de las PYMES.

## Uso innecesario de jerga y terminología técnica

El uso de jerga específica de una actividad está plenamente justificado en los casos en que aporta precisión y permite expresar en forma concisa un concepto. Pero, cuando no se conoce al interlocutor o al lector de un informe, no puede darse por descontado que esta persona maneje este vocabulario. No es inusual que el uso de jerga sea empleado por una persona como una manera velada de establecer su autoridad sobre el tema tratado, haciendo sentir al lector que el desconocimiento de los términos utilizados es muestra de su inferioridad. También, y especialmente en la comunicación verbal, el uso de jerga puede ser equiparado a un código que diferencia a los “iniciados” - que pueden interpretarlo - frente a los “legos” que no lo comprenden. En este sentido, parece sugerir la pertenencia a un grupo supuestamente selecto: una “hermandad” o cofradía.

Todas estas son razones para, justamente, evitar el uso de jerga y el empleo exagerado de términos técnicos en un informe que se orienta a un público no integrado por especialistas.

Una variante dentro del uso de jerga es el empleo del nombre o denominación propios de un producto como reemplazo del sustantivo que caracteriza su función.

Usos correctos | Usos Incorrectos
…emplea una interfaz USB marca FTDI. | …emplea un FTDI.
Se utilizó un procesador Intel Core i5. | Se utilizó un i5 – M3400.
Se corrigió la forma de onda de la señal. | Se redujo el ringing y el overshoot.
Se duplicó la cantidad de memoria. | Se añadió un SODIMM DDR3 2GB.
En 1973 IBM presentó un disco rígido contenido en una unidad sellada; su nombre informal era “Winchester”. | … IBM fabricaba los “Winchester”.

## Autorreferencias

Si bien en la redacción de un documento pueden emplearse referencias internas como una manera de conectar sus distintas secciones, en algunas oportunidades estas referencias no añaden valor y resultan en un “relleno” innecesario.

Usos correctos | Usos Incorrectos
Según se expuso en la Sección IV, el sistema... | Según lo ya visto, el sistema…
El dispositivo funciona en forma pasiva. Su operación se basa en… | A continuación se presentará el funcionamiento del dispositivo que, como ya se dijo anteriormente, trabaja en forma pasiva. En el párrafo siguiente se explicará que su operación se basa en…

## Texto narrativo que describe la secuencia del propio informe.

Asimismo, deben evitarse los párrafos que, a manera de relato verbal, describen el desarrollo del informe sin aportar información ni valor alguno.

Usos correctos | Usos Incorrectos
Esta sección presenta los resultados obtenidos… | Luego, en la sección siguiente, veremos los resultados obtenidos en las mediciones presentadas en los párrafos de la sección anterior, según lo planteado al comienzo del capítulo, y antes de …

## Uso de “tan” y de “cuan”

“Tan” es abreviatura de “tanto” y se emplea solamente cuando antecede a un adjetivo.

La expresión “qué tan” es incorrecta, y corresponde utilizar “cuán” en su lugar.

Usos correctos | Usos Incorrectos
Tan así es… | Tal es así…
Tanto es así… | Tan es así…
Tan pesado era…
¿Cuán nuevo es? | ¿Qué tan nuevo es?

## Uso del nombre de la unidad de medida para referirse a la magnitud física

Las expresiones derivadas de unidades de medida no son correctas para el uso formal.

Usos correctos | Usos Incorrectos
Tensión eléctrica, corriente | Voltaje; Amperaje
Frecuencia | Ciclaje
Longitud, área | Metraje
Peso, densidad | Kilaje; gramaje

## Referencias de tiempo

Las referencias temporales deben estar basadas en fechas, y no deben guiarse por el momento en que se escribe el informe.

Por otra parte, los nombres de los meses y de los días se escriben en minúscula. Deben evitarse abreviaturas en las fechas y no añadir “el mes de“, o “el día” al nombrar meses y días de la semana. También debe emplearse una convención coherente en las referencias horarias, uso de minutos, etc.

Usos correctos | Usos Incorrectos
A comienzos de 2014 la Empresa inició la construcción de … | Hace quince meses la Empresa inició la construcción de …
A fines de julio de 2015, el proyecto registra un avance del 70%, que resulta compatible con la planificación original. | A la fecha del presente informe, el proyecto registra un avance del 70%, que resulta compatible con la planificación original.
Desde abril hasta junio se incorporaron cinco personas… | Desde abril hasta Junio se incorporaron cinco personas…
En abril se instaló la nueva turbina. | En el mes de abril se instaló la nueva turbina.
La tarde del viernes se destina a ordenar el laboratorio. | La tarde del día viernes se destina a ordenar el laboratorio.
Una sonda visitó Plutón en julio de 2015. | Una sonda visitó Plutón en julio del 2015.
Una sonda visitó Plutón en 2015. | Una sonda visitó Plutón en el 2015.
El láser fue creado en la década de 1960. | El láser fue creado en los ’60.
El personal de fábrica trabaja de 6 a 14. | El personal de fábrica trabaja de 6:00 a 2 PM
El turno se extiende entre las 8:30 y las 18:00. | EL turno se extiende entre las 8 y media y las 6.

## Expresiones “a base de”, “en base a”, “a nivel de”, “fácil de” y similares

Son expresiones erróneas que aparecen frecuentemente en la conversación, pero no son apropiadas para un informe escrito[^10].

Usos correctos | Usos Incorrectos
El reloj muestra un diseño innovador. | A nivel de diseño, el reloj es innovador.
La medición se basa en ondas emitidas… | La medición en base a ondas emitidas…
Un sensor basado en el efecto Doppler… | Un sensor a base del efecto Doppler…
… sobre la base del reglamento original… | … bajo la base del reglamento original…
El navegador es simple, y el usuario aprende rápidamente a manejarlo. | El navegador es fácil de usar

## Coherencia en el uso de tiempos verbales

Se debe procurar mantener la coherencia en los tiempos verbales. En general, un informe refiere a actividades ya desarrolladas, por lo que el tiempo pasado suele ser apropiado. Se pueden incluir tareas que continúan en el presente y proyecciones futuras, pero cuidando esta coherencia.

Usos correctos | Usos Incorrectos
El sistema empleaba un sensor que, al fallar, activó la alarma. | El sistema empleaba un sensor que, al fallar, activa la alarma.
El trabajo se desarrolló en el verano y, como resultado, se repararon cinco plataformas. | El trabajo se desarrolló en el verano. Como resultado se reparan cinco plataformas.
| El trabajo se desarrolla en el verano pasado y, como resultado, se repararán cinco plataformas.

## Referencias a la posición de párrafos, tablas y figuras en el informe

En el texto se hará referencia a las figuras y párrafos según su numeración, y no por su posición en el documento. La posición podría variar por cuestiones de diagramación o edición final, generando inconsistencias o faltas de claridad

Las figuras y tablas deben estar numeradas y llevar un epígrafe apropiado. Por ejemplo,

Figura 1 – Histograma de las potencias observadas

o

Tabla II – Comparación de las principales características mecánicas

En el caso de ecuaciones, se las numerará sobre el margen derecho.

Usos correctos | Usos Incorrectos
En la Fig.1 se muestra el histograma… | En la figura anterior se muestra…
En el punto 3.4 Resultados se presenta… | En la página siguiente se presenta…
La Tabla II enumera las principales… | Esta tabla enumera…
La ecuación [6] se resuelve… | La ecuación mencionada se resuelve…

## Uso innecesario o incorrecto de comas.

En ciertos casos, la coma coincidiría con una pausa en la lectura; pero en el texto escrito se usa para separar ítems de una enumeración, o para abrir y cerrar una aclaración.

Usos correctos | Usos Incorrectos
Este equipo, diseñado en 1968, tiene una pantalla muy delicada y frágil. | Este equipo[^11], tiene una pantalla muy delicada y frágil.
Actualmente se usan componentes discretos para resolver esta dificultad. | Actualmente[^12], se usan componentes discretos para resolver esta dificultad.
Se utilizaron tornillos, remaches y clavos. | Se utilizaron tornillos remaches y clavos.

## Uso innecesario de dos verbos consecutivos en infinitivo

Generalmente no corresponde[^13] utilizar estas construcciones, excepto cuando se trata específicamente de desarrollar una capacidad que luego será aplicada en diversos momentos y contextos.

Usos correctos | Usos Incorrectos
El sensor debe medir la tensión… | El sensor debe poder medir la tensión...
El jefe descartó reparar el equipo en un laboratorio cercano. | El jefe descartó poder reparar el equipo en un laboratorio cercano.
Al terminar el curso, el técnico debe poder reconocer diversas fallas en el momento en que éstas se produzcan.

## Formatos abreviados en fechas y otras expresiones

Las abreviaturas no siempre son necesarias y reducen la legibilidad del texto. Cuando alguna expresión larga deba ser usada muy frecuentemente en el documento, podrá escribírsela completa en la primera oportunidad, indicando entre paréntesis la sigla o abreviatura que se empleará en adelante.

Usos correctos | Usos Incorrectos
…ubicada en la Ciudad de Buenos Aires… | … ubicada en CABA…
El 19 de agosto de 1982… | El 19/8/82…
TechPlus es una sociedad anónima que recientemente abrió una sucursal en los Estados Unidos de América. | TechPlus es una S.A. que recientemente abrió una sucursal en EE.UU.
… el Banco Central de la República Argentina (BCRA) es la entidad…

## Referencias a recursos humanos

Al planificar una tarea suele recurrirse al concepto de “horas-hombre”, pero éstas no pueden “entregarse” como si se tratara de un insumo físico.

Usos correctos | Usos Incorrectos
Incorporar al proyecto personal temporario con tarifa por tiempo. | La gerencia provee horas-hombre a los proyectos.
Incluir en el presupuesto 100 horas-hombre para tareas de instalación. | Se solicitó la devolución de las horas-hombre insumidas.

## Párrafos que comienzan con gerundios.

Es frecuente emplear incorrectamente un gerundio como comienzo de una oración[^14].

Usos correctos | Usos Incorrectos
El costo del producto debía ser reducido en un 10%, por lo que se eligió un material plástico … | Sabiendo que el costo del producto debía ser reducido en un 10%, se eligió un material plástico …

## Términos que tienen forma más corta en el género masculino.

Algunos términos[^15] se acortan sólo cuando están seguidos de un sustantivo de género masculino; pero no pueden abreviarse en otros casos.

Usos correctos | Usos Incorrectos
La primera prioridad… | La primer prioridad…
Después de veintiuna noches… | Después de veintiún noches…

## Cantidades, valores numéricos y unidades de medida

Las cantidades que no estén asociadas a una unidad de medida pueden, en general, expresarse en letras cuando son inferiores a 10, y en cifras cuando exceden este valor. Sin embargo, cuando se trate de valores relacionados o comparados, se emplearán cifras en ambos casos. Los casos de valores asociados a magnitudes y capacidades se expresarán en cifras seguidas de la unidad correspondiente.

Se deben emplear las unidades correspondientes al Sistema Métrico Legal Argentino (SiMeLA). En los casos en que la práctica de la industria exija el uso de unidades del sistema imperial u otros, se podrán emplear estas unidades, aclarando siempre entre paréntesis y a continuación el valor métrico correspondiente. La conversión deberá hacerse teniendo en cuenta la precisión apropiada para el tema en consideración.

Los valores relacionados con capacidades informáticas cuyos múltiplos se basan en potencias de 2 deberán emplear símbolos y leyendas apropiados.

Usos correctos | Usos Incorrectos
Se instalaron cuatro servidores. | Se instalaron 4 servidores.
Se instalaron 245 impresoras fiscales. | Se instalaron doscientas cuarenta y cinco impresoras fiscales.
La cantidad de alumnos inscriptos varía entre 8 y 15. | La cantidad de alumnos inscriptos varía entre ocho y 15.
La señal tiene una amplitud de 1 V. | La señal tiene una amplitud de un voltio.
El vehículo pesa 1300 kg. | El vehículo pesa 2900 libras.
El disco de 2.5 pulgadas (6.35 mm) es… | El disco de 2.5 pulgadas es …
El límite de 65 mi/h (105 km/h) es… | El límite de 65 mi/h (104.585 km/h) es…
La memoria de 1 GBy (230) permite… | La memoria de 1 GBy permite…
…un período de 4.5 μs. | …un período de 4500 ns.
El pulso dura desde 900 hasta 1100 ns. | El pulso dura desde 900 ns hasta 1.1 μs.
El pulso varía entre 10 ns y 10 ms. | El pulso varía entre 10 y 10.000.000 ns.

## Oraciones truncas

Es frecuente encontrar en algunos informes expresiones que, aparentemente, provienen de oraciones demasiado largas, que luego fueron divididas en dos o más partes sin prestar suficiente atención al resultado.

Usos correctos | Usos Incorrectos
La computadora, por medio de su sistema operativo, administra sus propios recursos de almacenamiento. Puede emplear, a este efecto, varios sistemas de archivo, los que son independientes entre sí. | La computadora, por medio de su sistema operativo, administra sus propios recursos de almacenamiento, empleando varios sistemas de archivo que son independientes entre sí[^16].
| La computadora, por medio de su sistema operativo, administra sus propios recursos de almacenamiento. Empleando varios[^17] sistemas de archivo que son independientes entre sí.
| La computadora, por medio de su sistema operativo, administra sus propios recursos de almacenamiento empleando varios sistemas de archivo. Que son independientes entre sí.

## Orden en que se presentan asuntos en forma de secuencia

Deben evitarse expresiones coloquiales, o cambios en el inicio de las oraciones.

Usos correctos | Usos Incorrectos
En primer lugar, se calibró el sensor. Luego se procedió a tomar la muestra. | Primero se calibró el sensor. Después se tomó la muestra.
En primer lugar se calibró el sensor. En segundo lugar, se tomó la muestra… | En primer lugar se calibró el sensor. Al terminar, se tomó la muestra.

## Consistencia en las enumeraciones

Las enumeraciones deben mantener una característica gramatical común a todos los ítems presentados. Por ejemplo, éstos pueden ser sustantivos, verbos en infinitivo, adjetivos, oraciones completas, etc.

Usos correctos | Usos Incorrectos
El programa debe ser: - eficiente - confiable - - veloz | El programa: - debe tener eficiencia - será confiable - su tiempo de ejecución debe ser menor a 10 ms.
El programa aportará: - eficiencia - confiabilidad - velocidad
El programa: - logrará una alta eficiencia, obtenida mediante el uso de un nuevo compilador. - permitirá verificar su confiabilidad mediante técnicas de simulación. - correrá con una velocidad que duplica la de la versión actualmente vigente.
El sistema - mide las temperaturas, - calcula su promedio, - informa el resultado y - controla las alarmas.

## Consistencia y ortografía económica

Las monedas se pueden escribir de cuatro maneras:

- Por su nombre (peso argentino, dólar estadounidense, euro). Este se escribe siempre en minúscula.

Usos correctos | Usos Incorrectos
El dispositivo tiene un costo de siete dólares estadounidenses | El dispositivo tiene un costo de 7 Dólares estadounidenses
El dispositivo tiene un costo de 7 pesos argentinos | El dispositivo tiene un costo de siete pesos Argentinos

- Por su símbolo convencional ($, €). Este, en algunos casos, puede resultar ambiguo. En el caso en que se escriba el número con cifras, el símbolo puede preceder o suceder a la cifra, pero nunca debe reemplazar el punto decimal

Usos correctos | Usos Incorrectos
El dispositivo tiene un costo de $ 7.50 | El dispositivo tiene un costo de 7$50
El dispositivo tiene un costo de 7.50 $

- Por su código internacional (ARS, USD, EUR). Es el formato preferible ya que es inequívoco. Se escribe siempre en mayúsculas, y nunca debe utilizarse en conjunto con otra nomenclatura

Usos correctos | Usos Incorrectos
El dispositivo tiene un costo de 7.50 USD | El dispositivo tiene un costo de $7.50 ARS
El dispositivo tiene un costo de ARS 7.50 | El dispositivo tiene un costo de $USD 7.50

- Con una nomenclatura que mezcla símbolos y letras. Esta nomenclatura es única para cada moneda (y no siempre está definida) y no se recomienda. Se muestra el caso del dólar estadounidense por su amplio uso a continuación

Usos correctos | Usos Incorrectos
El dispositivo tiene un costo de 7.50 US$ | El dispositivo tiene un costo de 7.50 us$
El dispositivo tiene un costo de US$ 7.50 | El dispositivo tiene un costo de U$S 7.50

Por último, en el caso de los prefijos, los prefijos k (kilo) y M (mega) pueden utilizarse en descripciones de monedas. Si las cantidades se escriben completas, no se deben utilizar símbolos

Usos correctos | Usos Incorrectos
El dispositivo tiene un costo de 1.5 kARS | El dispositivo tiene un costo de 1k5 ARS
El dispositivo tiene un costo de MUSD 4 | El dispositivo tiene un costo de 500 millones USD
El dispositivo tiene un costo de 4 millones de dólares americanos | El dispositivo tiene un costo de $500 millones
| El dispositivo tiene un costo de 500 millones de $

## Otros errores habituales

La tabla siguiente muestra algunos errores habituales.

Usos correctos | Usos Incorrectos
La empresa opera en Argentina desde… | La empresa opera en argentina desde…
El avión argentino IA-58 “Pucará”… | El avión Argentino IA-58 “Pucará”…
El usuario accede al sistema mediante… | El usuario accesa el sistema mediante...
La memoria consta de dos plaquetas. | La memoria consta en dos plaquetas.
Se pide al usuario que oprima… | Se le pide al usuario que oprima...
Los LED pueden estar preparados para montaje superficial (SMD), o para ser soldados en un circuito impreso con perforaciones. | Los LED pueden ser SMD o “thru hole”.
… está conectado mediante fibra óptica. | … está conectado vía FO.
El archivo ocupa hasta un terabyte. | El archivo ocupa hasta un tera.
Hay distintos tipos de motores eléctricos: … | Dentro de lo que es motores eléctricos, hay distintos tipos: ….
Se emplean varias piezas de software… | Se emplean varios softwares…
Con esos tomacorrientes y pulsadores… | Con esos enchufes y botones…
… tomar fotografías… | … sacar fotos …
Los equipos fueron revisados visualmente para detectar posibles componentes dañados. | Se revisaron los equipos visualmente, buscando componentes dañados físicamente.
La computadora incluye conectores USB | La computadora trae conectores USB.
Se envían al pistón unas señales que indican la posición que debe adoptar. | Se le dice al pistón el valor para que vaya a esa altura.

[^1] (http://www.rae.es)
[^2]
[^3]
[^4]
[^5]
[^6]
[^7]
[^8]
[^9]
[^10]
[^11]
[^12]
[^13]
[^14]
[^15]
[^16]
[^17]

¡Error! Utilice la pestaña Inicio para aplicar Heading 1 al texto que desea que aparezca aquí.. ¡Error! Utilice la pestaña Inicio para aplicar Heading 1 al texto que desea que aparezca aquí. 47

Este informe posee ayudas en forma de texto escondido. Utilice la tecla ¶ para visualizar la ayuda. Remueva este texto para las entregas.
