mregueira/DisenioBJAM/Hito 1/EspecificacionesBualo.docx

### Especificaciones de Implementación

Las especificaciones de implementación son todas aquellas que limitan los potenciales diseños basados en características basadas en el entorno de implementación de la solución. Esto incluye todas las características ambientales tanto para la operación como el almacenamiento y el transporte, materiales que no están permitidos (por ejemplo, por contaminación o por regulaciones –asbestos, plomo, etc.-), limitaciones para las dimensiones o el peso, etc, así como también requerimientos de costos

ID | Descripción | Origen | Aplicabilidad Validación
FUN-POW-01 | | REQ-02 | P, F I, D, T
FUN-POW-02 | | REQ-02
FUN-POW-03 | | REQ-02
FUN-POW-04 | | REQ-02
FUN-POW-05 | | REQ-02
FUN-POW-06 | | REQ-02
FUN-POW-07
FUN-POW-08
FUN-POW-09
