mregueira/DisenioBJAM/Hito 4/InformeHito3_Grupo2 - Visited V2.pdf

INSTITUTO TECNOLÓGICO DE BUENOS AIRES – ITBA

ESCUELA DE INGENIERÍA Y TECNOLOGÍA

# Módulo para comunicación de mediciones

# y control de actuadores

AUTORES: Bualó, Santiago (Leg. Nº 57557)

Martorell, Ariel Antonio (Leg. Nº 56209)

Mestanza, Joaquín Matías (Leg. Nº 58288)

Regueira, Marcelo Daniel (Leg. Nº 58300)

DOCENTES TITULARES: | Pingitore, Ricardo Alejandro

Orchessi, Walter

Ugarte, Alejandro

Gasparini, Ignacio

0. AGRADECIMIENTOS | 2

TRABAJO FINAL PRESENTADO PARA LA OBTENCIÓN DEL TÍTULO DE INGENIERO ELECTRÓNICO

BUENOS AIRES

SEGUNDO CUATRIMESTRE, 2020

## Agradecimientos

TBD

0. ÍNDICE | 4

## Índice

## Contenidos

0. ÍNDICE | 5

0. ÍNDICE | 6

0. ÍNDICE | 7
9.2. REVISTAS | 61
9.3. Notas de aplicación | 61
9.4. Fuentes Online | 61
10. Anexos Técnicos | 62
10.1. Esquemáticos | 62
10.2. Planos de PCB | 62
10.3. Listado de Partes y Componentes (BOM) | 62
10.4. Códigos de Software | 62
10.5. Hojas de Datos de Componentes | 64
10.6. Hojas de Aplicación | 64
10.7. Otra Documentación Técnica | 64

## Lista de Figuras

Figura 3-1: Diagrama Funcional de Interfaces | 14
Figura 4-1: Diagrama de dependencias de Validación | 26
Figura 5-1: Esquema modular | 27
Figura 5-2: Simulación de Montecarlo – Duración en días | 35
Figura 5-3: Simulación de Montecarlo – Fecha de finalización | 35
Figura 5-4: Diagrama de Gantt | 35
Figura 6-1: Diagrama en bloques de Hardware | 38
Figura 6-2: Implementación del controlador TPS2375D | 39
Figura 6-3: Secuencia de inicialización de PoE | 40
Figura 6-4: Fuente Switching de 5V | 41
Figura 6-5: Paso 1 – Voltaje de salida requerido | 41
Figura 6-6: Paso 2 – Selección del inductor | 42
Figura 6-7: Rangos de inductancia | 42
Figura 6-8: Paso 3 – Selección del capacitor de salida | 43
Figura 6-9: Paso 4 – Selección de diodo | 43
Figura 6-10: Paso 5 – Capacitor de entrada | 43
Figura 6-11: Estimación de la potencia disipada | 43
Figura 6-12: Fuente de alimentación de 3.3V | 45
Figura 6-13: Fuente Switching de 24V | 46
Figura 6-14: Selección del Inductor | 47
Figura 6-15: Placa de desarrollo básica | 48
Figura 6-16: Entrada de un Calibre | 49
Figura 6-17: Salidas de un Calibre | 49
Figura 6-18: Circuito para optoacoplado 24V – 3.3V [Por cada entrada] | 50
Figura 6-19: Tabla de Condiciones de operación recomendadas (Futurlec) | 50

0. ÍNDICE | 8
Figura 6-20: Curva de trabajo IF-VF (Futurlec) | 50
Figura 6-21: Curva de operación IC-VCE (Futurlec) | 51
Figura 6-22: Configuración básica del ADS7841 (Texas Instruments) | 52
Figura 6-23: Conexión a lazos de corriente [Por cada circuito integrado] | 52
Figura 6-24: Circuito de aislación para Salidas Digitales | 53
Figura 6-25: Trama de datos de comunicación de calibres | 56
Figura 10-1: Especificaciones de comunicación del calibre | 64

## Lista de Tablas

Tabla 3.1: Requerimientos | 13
Tabla 3.2: Leyenda de uso en especificaciones | 15
Tabla 3.3: Especificaciones Funcionales | 15
Tabla 3.4: Especificaciones de Interfaz S-IN | 16
Tabla 3.5: Especificaciones de Interfaz S-OUT | 16
Tabla 3.6: Especificaciones de Operación | 18
Tabla 3.7: Especificaciones de Compatibilidad Electromagnética | 19
Tabla 3.8: Especificaciones de costos | 19
Tabla 3.9: Especificaciones de Confiabilidad | 19
Tabla 3.10: Especificaciones de Disponibilidad | 19
Tabla 3.11: Especificaciones de Mantenibilidad | 19
Tabla 3.12: Especificaciones de Seguridad | 20
Tabla 4.1: Tests de Performance | 24
Tabla 5.1: Alternativas de diseño para Unidad de Control | 28
Tabla 5.2: Alternativas de diseño para Microcontrolador | 29
Tabla 5.3: Alternativas de diseño para el módulo de Alimentación Interna | 29
Tabla 5.4: Alternativas de diseño para la Interfaz de salidas digitales | 30
Tabla 5.5: Alternativas de diseño para Interfaz de entradas analógicas | 30
Tabla 5.6: Tareas estipuladas con las duraciones estimadas | 34
Tabla 5.7: Flujo de Fondos | 36
Tabla 6.1: Selección de componentes para la configuración a la potencia requerida | 39

0. ACRÓNIMOS Y DEFINICIONES | 9

## Acrónimos y Definiciones

Acrónimo | Descripción
AC | Corriente Alterna (Alternate Current)
ADC | Conversor de señal analógica a digital (Analog to Digital Converter)
DC | Corriente Continua (Direct Current)
EMC | Compatibilidad Electromagnética (ElectroMagnetic Compatibility)
HW | Hardware
HFE | Parámetro de ganancia de corriente continua de un transistor bipolar de juntura
SW | Software
TBD | To Be Determined
TBC | To Be Confirmed
VAC | Volts de corriente alterna (AC)
VCE0 | Tensión de ruptura entre Colector y Emisor de un transistor bipolar de juntura
VDC | Volts de corriente continua (DC)
POE | Alimentación a través de Ethernet (Power Over Ethernet) (ver definiciones)
Término | Definición
Industria 4.0 | Comúnmente se la refiere como la cuarta revolución industrial. Describe la creciente tendencia hacia la automatización y el intercambio de datos en tecnología y procesos dentro de la industria manufacturera, que incluye conceptos actuales como IoT (Internet Of Things). Además, realiza simulaciones de planta para evaluar la toma de decisiones óptimas y descentralizadas.
Pull Up | Refiere al concepto de fijar un estado lógico alto cuando la entrada o salida sobre la que se realiza el pull-up se encuentre en estado de alta impedancia (o circuito abierto).

Power Over Ethernet Es un estándar de la IEEE que permite fusionar señales de potencia con señales de
| internet de datos. Se verá con mas detalle a lo largo del trabajo.

0. RESUMEN | 10

## Resumen

El presente informe de proyecto final de la carrera de Ingeniería Electrónica plantea una problemática puntual de una empresa, y una posible solución con el producto que aquí se presenta: un módulo para comunicación de mediciones y control de actuadores.

Se analizan los requerimientos y especificaciones del producto teniendo en cuenta al cliente en este caso: un fabricante de piezas mecanizadas para autopartistas.

Se evalúan las diferentes posibilidades para el controlador central de este producto, eligiendo al microcontrolador como unidad de control preferida. También se evalúan las posibles implementaciones para los otros módulos que lo componen, teniendo en cuenta normativas de seguridad eléctrica y compatibilidad electromagnética (debido a que se trabaja en un ambiente industrial).

1. INTRODUCCIÓN | 11

## 1. Introducción

1.1. Antecedentes.
En la fábrica “Establecimiento Metalúrgico Campiutti S.R.L.” se realiza la producción de piezas mecanizadas para automóviles. Para validar las dimensiones de dichas piezas, éstas son posicionadas para ser medidas utilizando calibres digitales.

Se dispone de un operario que registra manualmente la medición indicada por el calibre en una aplicación contenida en una Tablet, donde además éste controla que dicha medición esté dentro de las tolerancias admitidas (especificadas en la misma aplicación). Luego, a través de ella envía la medición registrada al servidor de la planta.

Los inconvenientes planteados por el cliente (dueño de la planta, Leandro Campiutti), son los siguientes:

- Demora demasiado tiempo en el largo plazo realizar el registro de las mediciones en forma manual
- Pueden ocurrir errores de tipeo del operario al realizar el registro, enviando la información con errores

## 1.2. Contexto del proyecto

Actualmente, se tienen ciertas situaciones particulares que condicionan el desarrollo del proyecto, a saber:

- Pandemia de alcance mundial: Se dificulta efectuar reuniones físicas en el corto y mediano plazo. También, debido a ésta, se han impuesto restricciones en lo referente a la importación de componentes del exterior por parte del Gobierno Nacional (esto luego se traducirá en un requerimiento especificado por el propio cliente). Por otra parte, el acceso a los laboratorios para efectuar las mediciones y/o validaciones necesarias.
- Baja en las exportaciones de automóviles
- Caída en la producción de la industria automotriz, reducción en jornada laboral
- Cierre de fábricas autopartistas

Por otra parte, el regreso del cepo cambiario amplió la brecha, permitiendo que aquellos que poseen ahorros en dólares, ganen mayor poder adquisitivo. Como consecuencia, se abarata el costo de algunos autos ensamblados en el país.

2. OBJETIVOS | 12

## 2. Objetivos

## 2.1. Finalidad del Proyecto

La finalidad del proyecto consiste en ofrecer a la empresa “Establecimiento Metalúrgico Campiutti S.R.L.” un producto que facilite el proceso de medición de las piezas producidas, así como el registro y la validación de las mediciones tomadas.

A su vez, ofrecer la posibilidad de conectar otros sensores y actuadores adicionales en el futuro, brindando escalabilidad.

## 2.2. Planteamiento del Problema a Resolver

Este trabajo busca lograr comunicar al operario digitalmente el valor de las mediciones tomadas por los calibres utilizados en forma satisfactoria, evitando que deba registrarlas manualmente (consiguiendo así reducir los tiempos de adquisición de ellas) y ocupándose únicamente de la validación de sus dimensiones.

Para ello, el primero de los focos importantes será poder asegurar la validez de la información recibida. Es decir, que aquellos datos que sean transmitidos por el calibre sean los mismos que reciba el operario en la aplicación de su Tablet de trabajo. Esto contempla esencialmente lograr una correcta comunicación con el calibre (que utiliza un protocolo serie) y con la red local, que está integrada a la tecnología POE (el segundo de los focos importantes de este trabajo, a desarrollar posteriormente).

El tercer foco importante consiste en ofrecer, por un lado, una correcta interfaz para entradas analógicas adicionales con el estándar 4-20mA, para poder conectar en un futuro próximo sensores que se comuniquen con dicho estándar. Y, por otro lado, una correcta interfaz para salidas digitales de 24VDC, para poder conectar en un futuro próximo actuadores que se alimenten con dicho estándar.

## 2.3. Alcance

El proyecto contempla el desarrollo de un producto con el cual el operario a cargo de realizar las mediciones con los calibres digitales pueda comunicar dichas mediciones tomadas a través de una red local con POE. Además, contará con entradas analógicas (del estándar 4-20mA) y salidas digitales de 24VDC adicionales, contemplando un uso futuro por parte del cliente. El trabajo no contempla la validación de los valores medidos por los calibres. La contrastación periódica de los calibres estará a cargo del cliente.

Las instrucciones para solicitar la lectura de las entradas analógicas adicionales, así como para configurar las salidas digitales, se realizarán también a través de la conexión de red sin intervención del producto par ninguna de estas tareas.

3. DEFINICIÓN DE PRODUCTO | 13

## 3. Definición de Producto

## 3.1. Requerimientos de Cliente

### 3.1.1. Relevamiento de Datos

El relevamiento de datos para la obtención de los requerimientos se realizó mediante conversaciones directas con el dueño de la fábrica. Éste indicó tanto detalles de funcionamiento a tener en cuenta, como del instrumental a utilizar (los calibres digitales).

### 3.1.2. Requerimientos finales para trazabilidad

ID | Descripción | Origen
REQ-01 | El operario deberá recibir el valor de la medición hecha por el calibre en la aplicación para Tablet preexistente. Puede darse que se quiera obtener la medición de más de un calibre. | Cliente
REQ-02 | El producto deberá comunicarse y alimentarse mediante POE. | Cliente
REQ-03 | El producto deberá comunicarse con los calibres siguiendo el protocolo serie especificado por el fabricante (Mitutoyo) | Cliente
REQ-04 | Deberán poder conectarse al producto al menos 4 (cuatro) calibres. | Cliente
REQ-05 | Si no hay una pieza presente, el producto deberá igualmente transmitir el valor de medición que le sea comunicado por el calibre. | Cliente Tácito
REQ-06 | Si el calibre se encuentra apagado, y se solicita un valor de medición de éste, el producto deberá comunicar que el calibre al que se solicitó un valor de medición se encuentra apagado. | Cliente
REQ-07 | Los componentes que se vayan a utilizar para el desarrollo del producto deben conseguirse dentro de la República Argentina, para evitar los actuales inconvenientes de importación. | Cliente Factibilidad Económica
REQ-08 | El producto deberá disponer de puertos de entrada analógicos con el estándar 4-20mA para conectar sensores de presión de escala 0 - 200 mBar modelo SS611ED y puertos de salidas digitales de 24VDC, para contemplar una escalabilidad a futuro. | Cliente
REQ-09 | El producto deberá cumplir con la norma IRAM de compatibilidad electromagnética, dado que se ubicará en un ambiente industrial. | Norma
REQ-10 | El producto deberá cumplir con la norma IEC 60529, respecto al nivel de protección que debe tener el gabinete donde estará contenido, dado que se ubicará en un ambiente industrial. Se indicará con el grado de protección IP. | Norma
REQ-11 | El producto deberá contar con una salida USB Tipo A, con el fin de permitir al operario conectar la Tablet para recargar su batería. La conexión será únicamente para alimentación, y no para datos. | Cliente

Tabla 3.1: Requerimientos

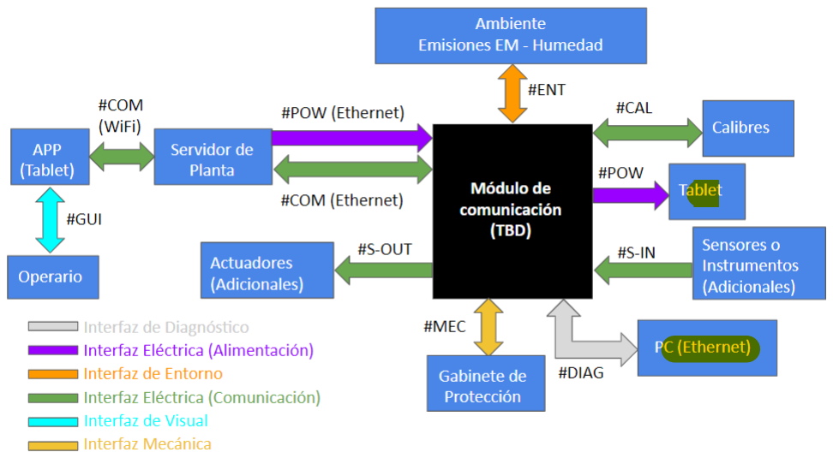
[picture p72: figure]

3. DEFINICIÓN DE PRODUCTO | 14

## 3.2. Diagrama Funcional de Interfaces

Figura 3-1: Diagrama Funcional de Interfaces

3. DEFINICIÓN DE PRODUCTO | 15
3.3. Especificaciones de Diseño.

### 3.3.1. Especificaciones Funcionales

Leyenda para Especificaciones

Aplicabilidad | Validación
P: Prototipo | I: Inspección Visual
F: Producto Final | S: Simulación

D: Documentación de Diseño

T: Test
Tabla 3.2: Leyenda de uso en especificaciones
ID | Descripción | Origen | Aplicabilidad Validación
FUN-POW-01 | Alimentación desde POE según estándar 802.3af: Consumo de potencia no mayor a 15W - 400mA (limitado por los cables, según el estándar básico) El producto debe utilizar cables 8PC8-RJ45 de 8 pines Modo B, categoría 3. (100BASE-TX) con un largo no mayor a 100 metros. El producto debe enviar por el cableado la alimentación y los datos por pines separados, utilizando los pares de repuesto. El rango de tensión que recibe el equipo debe estar entre 37V y 57V. La impedancia de entrada del equipo debe ser de entre 19KΩ y 26.5 kΩ. El dispositivo debe respetar la secuencia de arranque de POE contemplada en la norma 802.3af.
REQ-02 | P, F
| I, D, T
FUN-POW-02 | El producto deberá contar con un conector USB Tipo A (5V –
TBD mA), que permita al operario conectar su Tablet para recargar la batería si así lo requiere. Esta conexión será únicamente para alimentación, y no para datos.

REQ-11 P, F

D, T

Tabla 3.3: Especificaciones Funcionales

3. DEFINICIÓN DE PRODUCTO | 16

### 3.3.2. Especificaciones de Interfaz

ID | Descripción | Origen | Aplicabilidad Validación
INT-S-IN-01 | El producto deberá disponer de 4 entradas analógicas adicionales que trabajen con el estándar 4-20mA. • Mayor seguridad (menor a 30 mA) • Mayor inmunidad al ruido eléctrico e interferencias electromagnéticas • Facilidad en detección de fallas | REQ-08 | P, F I, D, T

Tabla 3.4: Especificaciones de Interfaz S-IN

ID | Descripción | Origen | Aplicabilidad Validación
INT-S-OUT-01 | El producto deberá disponer de 4 salidas digitales de tipo 24VDC SINK. • Máximo 1A de corriente para cada salida • Rango de tensión de alimentación entre 20.4 V a 26.4 V | REQ-08 | P, F I, D, T

Tabla 3.5: Especificaciones de Interfaz S-OUT

ID | Descripción | Origen | Aplicabilidad Validación
INT-CAL-01 | El producto deberá comunicarse con los calibres siguiendo el protocolo serie especificado por el fabricante (Mitutoyo) La frecuencia de reloj para la sincronización posee un valor típico de 4.096KHz. Se adjuntan más detalles en la sección 10.5, Figura 10-1. | REQ-03 | P, F D, T
INT-CAL-02 | El producto deberá disponer de al menos 4 (cuatro) conjuntos de puertos de conexión, según indica la documentación del fabricante de los calibres: | REQ-04
Pin Nro. | Señal | I/O
1 | GND | -
2 | DATA | O
3 | CK | O
4 | N.C. | -
5 | /REQ | I

De manera tal de poder conectar al menos 4 (cuatro) calibres.

Tabla 3-6: Especificaciones de Interfaz CAL

3. DEFINICIÓN DE PRODUCTO | 17
ID | Descripción | Origen | Aplicabilidad Validación
INT-COM-01 | El producto se comunicará con el servidor a través de una conexión a red local por Ethernet, mediante protocolo TCP-IP. | REQ-01, REQ-02, REQ-05, REQ-06 | P, F D, T
INT-COM-02 | La impedancia máxima proporcionada por los cables será de 20Ω. | REQ-02 | P, F D, T
INT-COM-03 | Debe poder recibir del servidor instrucciones para enviar mediciones de las entradas analógicas y configurar las salidas digitales a través del cable de Ethernet. | REQ-02 | P, F D, T
INT-COM-04 | Si un calibre está apagado y se solicita una medición de dicho calibre, deberá contemplar un TimeOut de 5 segundos y comunicar al servidor que el calibre está apagado. | REQ-06 | P, F D, T
INT-COM-05 | Si no hay una pieza presente, se transmitirá de todas maneras valor de medición nulo. | REQ-05 | P, F D, T

Tabla 3-7: Especificaciones de Interfaz COM

3. DEFINICIÓN DE PRODUCTO | 18
ID | Descripción | Origen | Aplicabilidad Validación
| corresponde a: Nivel de protección contra elementos sólidos:
Nivel | Tamaño objeto entrante | Efectividad
5 | Protección contra polvo | La entrada de polvo no puede evitarse, pero el mismo no debe entrar en una cantidad tal que interfiera con el correcto funcionamiento del equipo
INT-MEC-01 | El equipo deberá tener un grado de protección IP53, que

Nivel de protección contra elementos líquidos:

Nivel | Protección frente a | Método de prueba | Resultados
3 | Agua nebulizada (spray) | Se coloca el equipamiento en su lugar de trabajo habitual | No debe entrar el agua nebulizada hasta en un ángulo de 60° a derecha e izquierda de la vertical, a un promedio de 11 litros por minuto, y a una presión de 80-100 kN/m² durante un tiempo no menor a 5 minutos

De acuerdo con la norma IEC 60529.

REQ-10 | P, F
| I, T

Tabla 3-8: Especificaciones de Interfaz MEC

### 3.3.3. Especificaciones de Implementación

ID | Descripción | Origen | Aplicabilidad Validación
IMP-OPE-01 | El dispositivo deberá poder operar normalmente cuando la temperatura ambiente sea: 0°C < TAMB < 40°C (TBC) | (Entorno Industrial) | F D, T

Tabla 3.6: Especificaciones de Operación

3. DEFINICIÓN DE PRODUCTO | 19
ID | Descripción | Origen | Aplicabilidad Validación
IMP-EMC-01 | El dispositivo deberá operar normalmente con inmunidad al ruido electromagnético de acuerdo con la norma IRAM 2491: CEM = EMI + SEM. (Emisiones electromagnéticas y Susceptibilidad Electromagnética) Norma IRAM 2491-1-1: Definición de la terminología básica relacionada a CEM. Norma IRAM 2491-4-1 y 2491-4-2: Técnicas de medición y ensayo para garantizar los valores deseados de EMI y de descargas eléctricas. Norma IRAM 2491-4-14: Norma para garantizar inmunidad electromagnética al equipo SEM. | REQ-09 | F T

Tabla 3.7: Especificaciones de Compatibilidad Electromagnética

D | Descripción | Origen | Aplicabilidad Validación
IMP-COS-01 | Los componentes que se vayan a utilizar para el desarrollo del producto deben conseguirse dentro de la República Argentina, para evitar los actuales inconvenientes de importación. | REQ-07 | F D

Tabla 3.8: Especificaciones de costos

### 3.3.4. Especificaciones de Servicio (RAMS)

ID | Descripción | Origen | Aplicabilidad Validación
RAM-CON-01 | TBD | TBC | TBD

Tabla 3.9: Especificaciones de Confiabilidad

ID | Descripción | Origen | Aplicabilidad Validación
RAM-DIS-01 | TBD | TBC | TBD

Tabla 3.10: Especificaciones de Disponibilidad

ID | Descripción | Origen | Aplicabilidad Validación
RAM-MAN-01 | TBD | TBC | P, F T

Tabla 3.11: Especificaciones de Mantenibilidad

3. DEFINICIÓN DE PRODUCTO | 20
ID | Descripción | Origen | Aplicabilidad Validación
RAM-SEG-01 | La máxima temperatura que podrá tener la carcasa será de TBD | TBC | P, F D, S, T

Tabla 3.12: Especificaciones de Seguridad

## 4. Plan de Validación

## 4.1. Diseño de Bancos de Pruebas

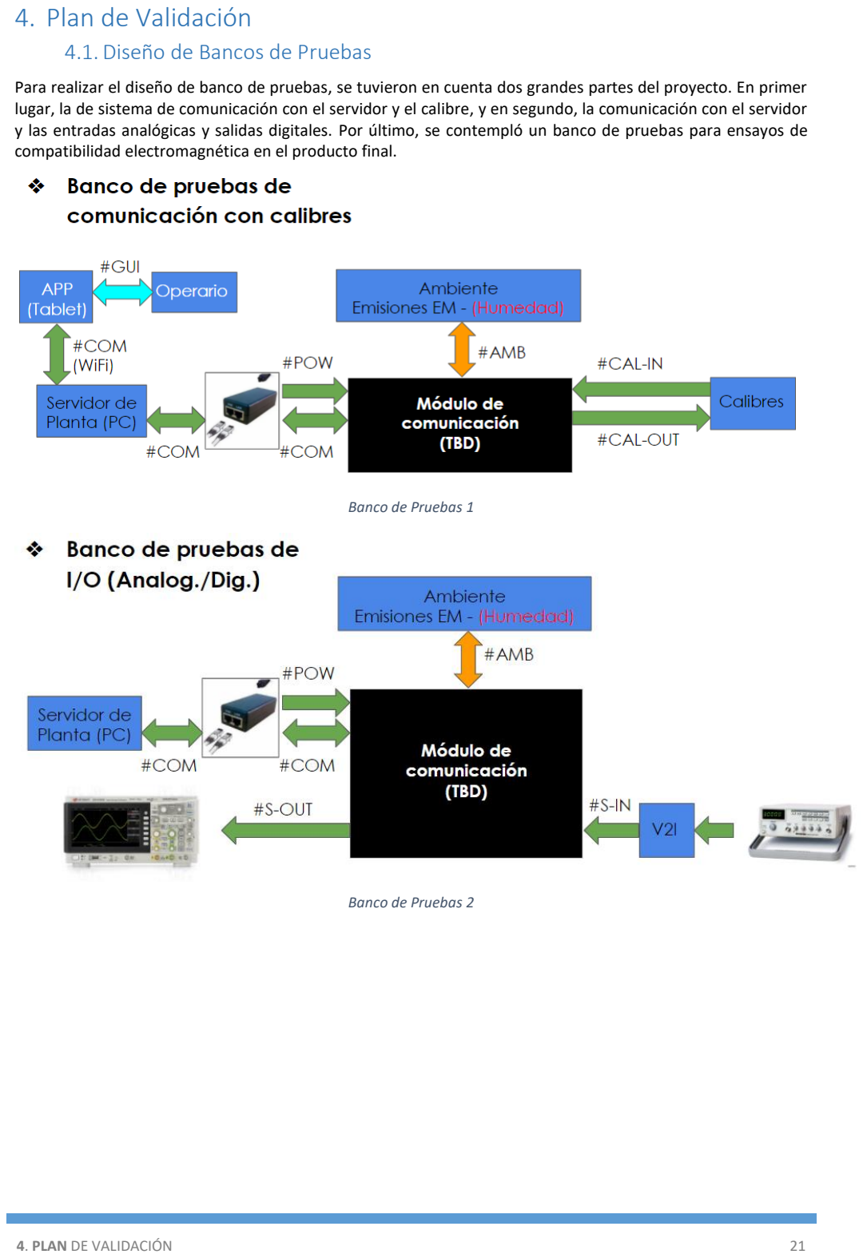
[picture p73: page 21]

4. PLAN DE VALIDACIÓN | 21

Para realizar el diseño de banco de pruebas, se tuvieron en cuenta dos grandes partes del proyecto. En primer lugar, la de sistema de comunicación con el servidor y el calibre, y en segundo, la comunicación con el servidor y las entradas analógicas y salidas digitales. Por último, se contempló un banco de pruebas para ensayos de compatibilidad electromagnética en el producto final.

Banco de Pruebas 1

Banco de Pruebas 2

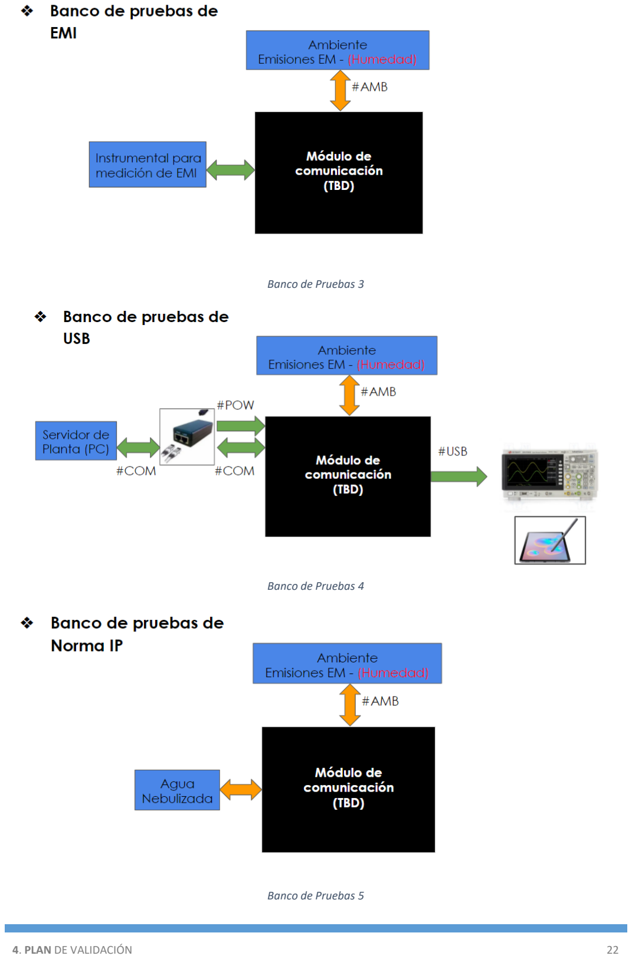
[picture p74: page 22]

4. PLAN DE VALIDACIÓN | 22

Banco de Pruebas 3

Banco de Pruebas 4

Banco de Pruebas 5

4. PLAN DE VALIDACIÓN | 23

## 4.2. Especificaciones de Tests

ID
Aplicabilidad | Procedimiento | Criterio

Procedimiento General: para todas estas pruebas, se deberá conectar el DUT al banco de pruebas #1. Verifique que ambas puntas del osciloscopio estén correctamente conectadas, y que cada una de ellas tenga la referencia conectado al pin de tierra inmediatamente al lado del que se intenta medir. El osciloscopio deberá estar ajustado para mostrar en pantalla un período no mayor a 5ms, dado que la trama es de 13 datos y la señal de CLK es de 4096Hz. Deberá tener también acoplado AC para evitar ver señales de tensión continua. La amplitud que se pueda ver en pantalla deberá ser no mayor a 5VDC (TBC). El trigger deberá estar puesto en automático y el nivel del trigger en 2.5VDC (TBC). El display deberá estar puesto en estado normal (es decir, sin persistencia). Las puntas deberán estar en impedancia de entrada x10, con el ajuste acorde en el osciloscopio. Escala de 1V/div. Salvo que el test así lo indique, no deberá haber ningún tipo de filtro salvo aquellos ya mencionados.

T-PERF01

Proto, Final

1. Se procede a utilizar el banco de pruebas #1. Verificar que la PC, la alimentación, el calibre y el DUT estén encendidos y correctamente conectados.
2. Verificar que cuando se pide a través del servidor (en este caso, emulado por la PC) al DUT que el calibre transmita una medición, la misma llegue al DUT. En este caso si después de la solicitud, no hay respuesta luego de transcurridos 5 segundos es porque el calibre está apagado.
3. Frente a medidas patrón (TBD) verificar que lo que se mide con el calibre y aparece en la pantalla de este es igual a lo que recibe el DUT, y que aparecerá en la aplicación de la Tablet.

Correspondencia
entre valores: de
señal de datos
de calibre y lo
que se recibe en
el módulo

T-PERF02

Proto, Final

1. Se procede a utilizar banco de pruebas #2
2. Se asume que la alimentación y la comunicación con el módulo a través de POE, ya se encuentra validado en el test T-PERF01, así como la correcta conexión de la PC.
3. Por medio del servidor proveer una configuración a la parte de entradas analógicas.
4. Luego se realiza la inyección a la entrada analógica por medio de un generador de señales y con la disposición de un conversor de tensión a corriente de forma tal de tener como entrada: en un caso el mínimo nivel de corriente (4mA), y en otro caso el nivel máximo (20mA).
5. Para verificar que se lee correctamente en cada entrada hay que ver que se corresponda lo que está en la entrada y lo que se envió al servidor con un cierto criterio de tolerancia sugerido por CPI S.A.

En mínimo:

(4+/-0.2) mA

En máximo:

(20+/-0.5) mA

T-PERF03

Proto, Final

1. Se procede a utilizar banco de pruebas #2
2. Se asume que la alimentación y la comunicación con el módulo a través de POE, ya se encuentra validado en el test T-PERF01, así como la correcta conexión de la PC y demás.
3. Cambiar la escala de medición vertical a 5V/div.
4. Efectuar medición con osciloscopio en cada una de las salidas digitales con la siguiente configuración establecida por el servidor: una de las salidas activa y el resto apagadas, y ver que se corresponda el estado de la salida con lo que se mide en el osciloscopio.
5. Repetir el paso anterior, pero con todas las salidas activas.

Tensión con
salida activa:

(0 – TBD) V

Tensión con
salida apagada:
(20.4 - 26.4) V

T-PERF04

Final

1. Procedimiento a definir para medición de EMI (TBD) con el banco de
pruebas #3. | TBC

4. PLAN DE VALIDACIÓN | 24
T-PERF05 Proto, Final | 1. Se procede a utilizar el banco de pruebas #4. Conectar la bornera auxiliar de salida de alimentación USB al osciloscopio, y verificar que se mide una tensión continua de 5V 2. Conectar luego, mediante un cable USB Tipo A la salida a la Tablet del operario. 3. Verificar que se visualiza en ella que la batería se está cargando. | Tensión de salida: (4.5 – 5.5) V Inspección visual en la Tablet de estado de batería cargando
T-PERF06 Final | 1. Se procede a utilizar el banco de pruebas #5. Con el equipo conectado y en funcionamiento, rociar con agua nebulizada según indica el procedimiento de la norma IEC 60529. | No se ve afectado el funcionamiento general, según norma IEC 60529

Tabla 4.1: Tests de Performance

4. PLAN DE VALIDACIÓN | 25

## 4.3. Matriz de Trazabilidad de Validación

Origen | REQ ID Descripción corta | ESP ID | TEST ID o Sección
Cliente | REQ-01 Poder ver la medición en Tablet | INT-COM-01 | T-PERF01
Cliente | REQ-02 Alimentación del módulo mediante POE | FUN-POW-01 INT-COM-01 INT-COM-02 INT-COM-03 | T-PERF01
Cliente | REQ-03 El módulo usa protocolo de comunicación de calibres Mitutoyo | INT-CAL-01 | T-PERF01
Cliente | REQ-04 Conectar 4 calibres | INT-CAL-02 | T-PERF01
Cliente Tácito | REQ-05 Pieza no presente, transmitir valor nulo de medición | INT-COM-01 INT-COM-05 | T-PERF01
Cliente | REQ-06 Si un calibre está apagado, que el módulo lo comunique | INT-COM-01 INT-COM-04 | T-PERF01
Cliente Factibilidad Económica | REQ-07 Utilizar componentes en Argentina | IMP-COS-01 | No aplica
Cliente | REQ-08 Entradas analógicas con protocolo 4-20mA, salidas digitales de 24VDC | INT-S-IN-01 INT-S-OUT-01 | T-PERF01 T-PERF02 T-PERF03
Norma | REQ-09 El producto deberá cumplir con la norma IRAM 2491-1-1, 2491-4-1, 2491-4-2, y 2941-4-14 de compatibilidad electromagnética. | IMP-EMC-01 | T-PERF04
Norma | REQ-10 Cumplir norma IEC 60529, respecto del nivel de protección que debe tener el gabinete. Grado de protección IP. | INT-MEC-01 | T-PERF06
Cliente | REQ-11 Salida USB Tipo A, con el fin de cargar batería de Tablet. | FUN-POW-02 | T-PERF05

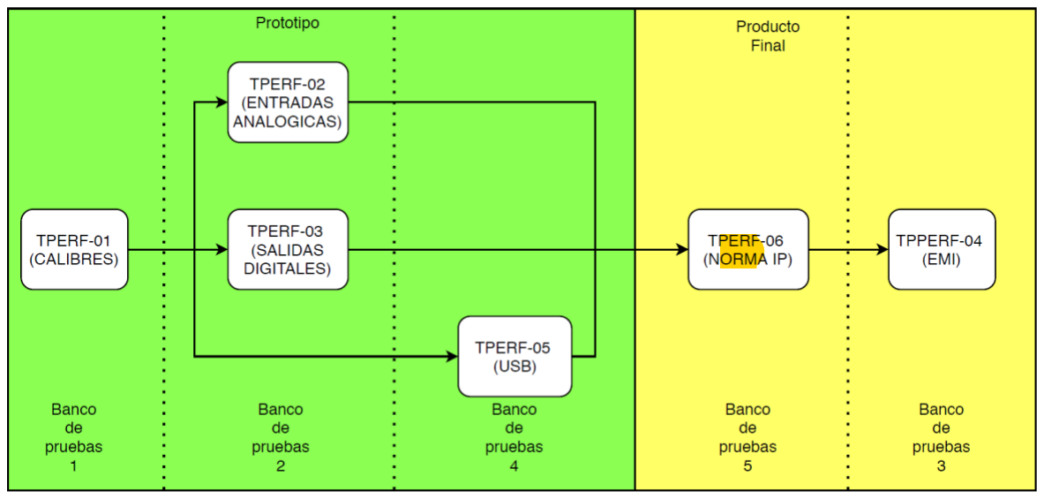
[picture p75: figure]

4. PLAN DE VALIDACIÓN | 26

## 4.4. Plan de Verificación y Validación

Figura 4-1: Diagrama de dependencias de Validación

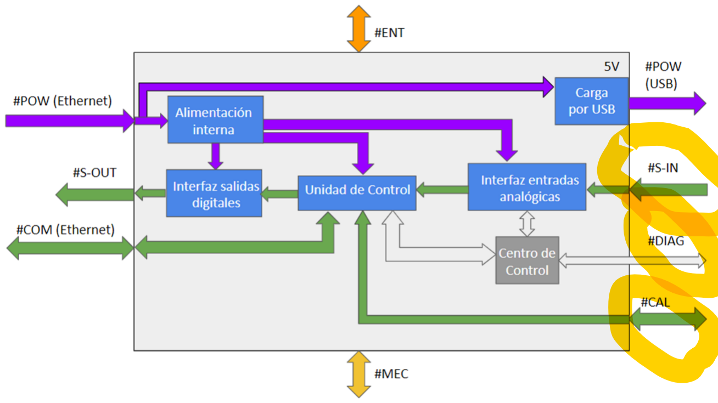
[picture p76: figure]

5. ANÁLISIS DE FACTIBILIDAD | 27

## 5. Análisis de Factibilidad

## 5.1. Factibilidad tecnológica

### 5.1.1. Esquema Modular

Figura 5-1: Esquema modular

Se presenta ahora una breve descripción de los módulos, para luego poder realizar el planteo de las alternativas de diseño.

- Unidad de Control: funciona como interfaz entre la información provista por los calibres y las entradas analógicas, con el servidor. A través de la conexión por Ethernet comunicará debidamente la información proveniente de estos módulos, como así recibirá instrucciones de configuración para las salidas digitales.
- Interfaz entradas analógicas: contiene el hardware necesario para convertir la información por corriente de las entradas analógicas a un formato de tensión adecuado para ser interpretado por la unidad de control cuando le sea requerido.
- Interfaz salidas digitales: permite activar o desactivar las salidas digitales de acuerdo con la configuración proveniente de la unidad de control (que a su vez proviene del servidor externo).
- Alimentación interna: contiene el hardware necesario para adaptar la alimentación proveniente de la conexión por POE a las diversas alimentaciones requeridas por el equipo.
- Carga por USB: posee el hardware requerido para proveer mediante el puerto USB externo una alimentación estable para cargar la Tablet del operario.
- Centro de control: unidad de hardware adicional para la realización de pruebas de validación.

### 5.1.2. Implementación de módulo <<Unidad de Control>> 5.1.2.1. Alternativas de diseño

Como se trata de un problema de ingeniería, hay muchas soluciones posibles, por lo cual se optó por utilizar un método tabular para poder realizar un análisis cualitativo distintas soluciones exploradas y de esa forma determinar la óptima. Es importante tener en cuenta que la tabla fue armada teniendo en cuenta que las distintas unidades de control puedan aproximadamente solucionar nuestro problema con el cuidado de no sobredimensionar demasiado en cuanto a las prestaciones que posee cada una.

5. ANÁLISIS DE FACTIBILIDAD | 28

En base a estas consideraciones, se confeccionó la siguiente tabla comparativa.

Factores a tener en cuenta

Opciones | Tiene periféricos internos | Curva de aprendizaje (Ascenso) | Apto ambiente industrial | Costo (~)
Microcontrolador | Si | Lento | Si | US$ 10
Microprocesador | Si** | Lento | Si | US$ 10
FPGA | No* | Muy Lento | Si*** | US$ 20
Arduino | Si | Rápido | No | US$ 10
RaspberryPi | Si | Medio | No | US$ 35

Tabla 5.1: Alternativas de diseño para Unidad de Control

*: Pueden integrarse.

**: Pocos o más básicos

***: Varía según el caso

### 5.1.2.2. Elección de una solución

En primer lugar, se tuvo en cuenta la curva de aprendizaje de cada unidad de control. Dentro de ese conjunto de curvas, la que más se destaca es la de las FPGA, la cual es muy lenta. Esto no es un dato menor ya que eso en conjunto con la poca experiencia que nuestro grupo de trabajo, se prevé que va a provocar un aumento significativo en el tiempo de realización del proyecto.

Luego, se consideró que tanto las Arduino y RaspberryPi no presentaban la robustez necesaria para poder funcionar correctamente en un ambiente industrial.

Por último, sólo queda realizar un análisis dentro de las dos posibles opciones restantes de la tabla, microcontrolador y microprocesador. Por un lado, desde el punto de vista de costo estimado, la curva de aprendizaje y su aptitud para el ambiente industrial, las dos soluciones parecen ser igualmente viables en comparación a las anteriores. Pero, por otro lado, un factor determinante para tener en cuenta es la cantidad de periféricos que posee la unidad de control.

En este sentido, el microcontrolador ofrece una mejor prestación que el microprocesador, y es por esta razón que fue elegido solución de preferencia para este proyecto.

### 5.1.2.3. Alternativas de diseño

Teniendo definida la Unidad de Control, se pasa ahora al análisis particular de posibles alternativas de Microcontrolador. Se tiene en cuenta, por un lado, la disponibilidad de un periférico de Ethernet interno, dado que esto condiciona el número de pines a disponer. Por otro lado, se contempla el número de entradas analógicas disponibles, porque esto influirá en las alternativas de diseño para la interfaz de las entradas analógicas externas del equipo. Finalmente, se incluye la memoria FLASH disponible para el programa: este factor es también crítico debido a que se desconoce cuánto espacio ocupará en dicha memoria.

5. ANÁLISIS DE FACTIBILIDAD | 29

Con estas consideraciones, se armó la siguiente tabla comparativa.

Factores a tener en cuenta

Opciones | Ethernet
| (HW) | Arquitectura
| | (HW) bits | Memoria
| | | Flash | N° de
| | | | Pines | Entradas
| | | | | analógicas | Disponible en
| | | | | | Argentina | Costo
STM32F407 | Si | 32 bits | 1MB | 100 | 3* | Si | USD$ 11.86
MK64FN1M0VLL12 | Si | 32 bits | 1MB | 100 | 2* | Si | USD$ 14.37

ATMega 328P +

Periférico | Si | 8 bits | 32KB | 32 | 8 | Si | USD$ 2.18 +
| | | | | | | Periférico

ATMega 640 +

Periférico | Si | 8 bits | 64KB | 100 | 16 | Si | USD$ 8.49 +
| | | | | | | Periférico

Tabla 5.2: Alternativas de diseño para Microcontrolador

*: Al tener menos de 4 entradas analógicas disponibles nativamente, condiciona luego la elección de alternativas para el módulo de Interfaz de entradas analógicas.

Se describen ahora las consideraciones sobre cada opción relevantes para el proyecto. (mismo de antes, breve)

- STM32F407:
- MK64FN1M0VLL12:
- ATMega 328P + Periférico:
- ATMega 640 + Periférico:

### 5.1.2.4. Elección de una solución

En base a lo descripto previamente, considerando su versatilidad, se optó por utilizar el microcontrolador STM32F407.

### 5.1.3. Implementación de módulo <<Alimentación Interna>> 5.1.3.1. Alternativas de diseño

Para el planteo de alternativas para el módulo de alimentación interna, se consideran las dos ramas existentes (lineal y conmutada o switching). Los aspectos de interés a comparar son las EMI (dado que se trabajará en un ambiente industrial) y la PSRR (principalmente debido a que la tensión proveniente del POE puede tener un rango de variación amplio, entre 37V y 57V).

Con dichas consideraciones, se construye la siguiente tabla.

Factores a tener en cuenta

Opciones | Rendimiento | EMI | PSRR | Costo
Reguladores Lineales | < 50% | Bajas | Bajas | Bajo
Reguladores Switching | ~ 95% | Altas* | Altas** | Alto*
Lineal + Switching*** | *** | Altas | Bajas | ***

Tabla 5.3: Alternativas de diseño para el módulo de Alimentación Interna

Se describe a continuación los aspectos a destacar en cada opción planteada para el módulo.

- Reguladores Lineales: en este caso, dado que el control es analógico, no se tiene un buen rendimiento, y para la exigencia de corrientes más altas por breves períodos de tiempo la capacidad de rechazo PSRR no es muy buena. Pero como ventajas, el costo en horas hombre para su diseño es menor (dado que es menos compleja la circuitería) y su costo monetario también es más bajo. Por otra parte, al ser un control de tipo analógico, las EMI son bajas.
- Reguladores Switching: poseen un buen rendimiento y la capacidad de rechazo PSRR es mucho mejor, lo que resulta más conveniente para el caso de la alimentación que se destine a la Unidad de Control, y para

5. ANÁLISIS DE FACTIBILIDAD | 30

la fuente de carga por USB. En contraparte, al ser circuitos que conmutan a altas frecuencias, las EMI son más elevadas y el diseño puede resultar más complejo y caro.

### 5.1.3.2. Elección de una solución

Dado que los módulos tienen cada uno diferentes requisitos en cuanto a potencia y estabilidad de tensión, se optó por considerar una combinación de ambos tipos de fuente para cada caso, según sea ese requerimiento. De esta forma, en los casos que se pueda optar por un diseño más simple y económico se recurrirá al primer tipo, y en los otros casos al segundo.

### 5.1.4. Implementación de módulo <<Interfaz salidas digitales>> 5.1.4.1. Alternativas de diseño

Para el planteo de las alternativas de diseño, se consideran como factores base la tensión de trabajo (dado que las salidas están especificadas por tensión) y la corriente de trabajo (en función del tipo de actuador a conectar).

En base a esto, se analizaron dos opciones de base, presentadas en la siguiente tabla.

Factores a tener en cuenta

Opciones | V de trabajo | I de trabajo | Aislación | Costo
Optoacoplador + Relé Contacto | 30 VDC | 3A | Si | US$ 1.06
Relé Estado Sólido | 60 VDC | 3A | Phototriac | US$ 14.16
Tabla 5.4: Alternativas de diseño para la Interfaz de salidas digitales
- Optoacoplador + Relé Contacto: son más económicos, pero se añade una aislación adicional mediante optoacoplador para separar bien el circuito con la bobina de la Unidad de Control.
- Relé Estado Sólido: son más caros, pero poseen mayor robustez (y soportan una tensión de trabajo mayor).

### 5.1.4.2. Elección de una solución

Dado que el cliente no incluyó requerimientos adicionales sobre los actuadores a conectar, se optó por la opción más simple, en este caso los Relé de Contacto + Optoacoplador.

### 5.1.5. Implementación de módulo <<Interfaz entradas analógicas>> 5.1.5.1. Alternativas de diseño

Para poder realizar la funcionalidad propuesta de entradas analógicas, dado que las entradas analógicas del módulo trabajan con un protocolo 4-20mA, hay que realizar una conversión de corriente a tensión de modo tal que los ADC disponibles en la unidad de control puedan efectuar una lectura del valor de tensión asociado a lo que mide cada sensor respectivamente.

En base a estos criterios, se construyó la siguiente tabla.

Factores a tener en cuenta
Opciones | uC con ADC suficientes | Requiere calibrar | Precisión | Aprovecha todo el rango de V | Costo
4x Resistor | Si | No | ± 1% | No | *
4x Conv. I/V Arduino | Si | Si | ± 0.2% | Si | US$ 24
ADS7841 +4x Resistor | No | No | ± 0.1%** | No | US$ 8
ADS7841 +4x Conv. I/V | No | Si | +0.3% | Si | US$ 32
Tabla 5.5: Alternativas de diseño para Interfaz de entradas analógicas

Se solicitó que el módulo trabajara con 4 entradas analógicas, por lo tanto, los ADC necesarios resultan ser 4. Cuando se realizó la búsqueda de microcontroladores disponibles en el mercado, se halló que no siempre llegaban a disponer esa cantidad de ADC. Frente a esta problemática, se pudo hallar un workaround que consiste

5. ANÁLISIS DE FACTIBILIDAD | 31

en utilizar el módulo ADS 7841. Dicho módulo contiene 4 ADC, los cuales se multiplexan y se envía la lectura mediante la salida serial que posee. Dado que la unidad de control seleccionada se trata del STM32F407, el cual posee 3 ADC, surge como necesidad utilizar el módulo ADS 7841.

Resuelta esta problemática, solo queda explorar la conversión de corriente a tensión. En esta nueva problemática se contemplaron dos posibles soluciones. Por un lado, se colocan 4 resistores en la entrada de cada ADC. Por otro lado, en las mismas entradas se colocan módulos de conversión de corriente a tensión Arduino.

La opción de colocar resistores tiene como ventaja el hecho de que no requiere calibración, pero no aprovecha todo el rango de tensión disponible del ADC. En cambio, en la opción de los conversores Arduino, ocurre lo opuesto.

### 5.1.5.2. Elección de una solución

A pesar de que la opción que combina el módulo ADS 7841 y conversores Arduino parece ser la opción más viable en cuanto a la prestación, en términos de costo no lo es. Es por eso que se tomó la decisión de combinarlo con resistores.

### 5.1.6. DFMEA

Para la realización de la DFMEA, se tuvieron en cuenta los siguientes posibles problemas, según el módulo al que están asociados:

- Alimentación por POE: problemas de hardware (físicos o de implementación) o software (en este caso, relacionado a la implementación)
- Transmisión de medición de calibres: errores presentes en la trama de datos transmitida
- Entradas analógicas: mediciones fuera de rango, o problemas en el lazo de corriente
- Salidas digitales: problemas de configuración desde el servidor (software), o mal funcionamiento de estas (hardware)
- USB: problemas con la alimentación brindada

Se utiliza una escala de 1 a 5 para los tres índices. En el caso de Severidad, 1 para menos severo y 5 para máxima severidad. En el caso de Ocurrencia, 1 para menos frecuente y 5 para muy frecuente. Finalmente, en el caso de Detectabilidad, 1 para mayor facilidad de detectar la falla, y 5 para el caso de muy difícil detectabilidad.

5. ANÁLISIS DE FACTIBILIDAD | 33
Design FMEA | Action Results
Item and Function/ Requirements | Potential Failure Mode | Potential Effect(s) of Failure | Severity | Failure Potential Cause(s)/ Mechanism(s) of | Occurrence | Current Controls | Detection | RPN | Recommended Action | Severity | Occurrence | Detection | RPN
POE (Alimentación) | El switch no presenta alimentación a nuestro equipo | El equipo no enciende | 3 | El cable entre el switch y el equipo está defectuoso | 2 | (Ninguno) | 5 | 30 | Cambio de diseño: LED indicador de encendido en el equipo. Si el LED indicador del equipo no está encendido, debe reemplazarse el cable. Se contempla que el switch disponde de indicador de encendido propio. | 3 | 2 | 3 | 18
Transmisión de medición | Transmisión errónea de la medición | El operario interpreta erróneamente el valor de medida de la pieza | 5 | La trama de datos sufrió una modificación debido a ruido eléctrico en el ambiente industrial | 2 | (Ninguno) | 2 | 20 | Cambio de diseño: agregar redundancia en SW/HW de transmisión de datos. | 5 | 1 | 2 | 10
POE (Alimentación) - 2 | El switch no presenta alimentación a nuestro equipo | El equipo no enciende | 3 | No realizó la secuencia correctamente, "falso contacto", elementos quemados | 2 | (Ninguno) | 2 | 12 | Cambio de diseño: añadir posibilidad de alimentación externa para el centro de diagnóstico para poder revisar la integridad interna del equipo. | 3 | 2 | 1 | 6
Salidas Digitales | Funcionamiento incorrecto de el módulo I/O | La/s salidas no encienden cuando se lo solicita | 2 | Configuración incorrecta del servidor, problema de hardware en el equipo | 2 | (Ninguno) | 2 | 8 | Cambio de diseño: agregar validación interna de la configuración y notificar al servidor en caso de que ésta sea errónea. | 2 | 2 | 1 | 4
Entradas Analógicas | Funcionamiento incorrecto de el módulo I/O | Medición fuera de rango | 2 | El sensor conectado no funciona bien, problema en el hardware del equipo | 2 | (Ninguno) | 2 | 8 | Colocar el equipo en modo de diagnóstico, y conectar la señal de referencia a la entrada afectada. Verificar su funcionamiento en todo el rango. Si pasa el diagnóstico, reemplazar el sensor y reintentar la medición. Sino, hay que revisar el equipo internamente. | 2 | 2 | 2 | 8
Entradas Analógicas | Funcionamiento incorrecto de el módulo I/O | Medición en rango pero incorrecta | 4 | El sensor conectado no funciona bien, problema en el lazo de corriente | 2 | (Ninguno) | 2 | 16 | Colocar el equipo en modo de diagnóstico para verificar el funcionamiento de la entrada afectada en todo el rango. Si pasa el diagnóstico, reemplazar el sensor y reintentar la medición. | 4 | 2 | 2 | 16
USB (Alimentación de Tablet) | El puerto USB no presenta alimentación | La Tablet no carga | 2 | Falla en la inicialización de POE, problema de hardware en el equipo, el equipo no recibe alimentación, el cable USB está defectuoso | 3 | (Ninguno) | 2 | 12 | Cambio de diseño: añadir LED de indicación de alimentación en la salida USB, para poder comprobar la correcta conectividad entre la Tablet y el puerto. | 2 | 3 | 1 | 6

5.2. Factibilidad de tiempos.

### 5.2.1. Consideraciones

La distribución de las diferentes tareas se basa en la separación por módulos del producto. Como días de trabajo efectivos, se consideran los 5 días hábiles de la semana. Se descuenta el receso de verano (siendo esto Enero, y la primera quincena de Febrero).

Respecto a esto último, se añade una semana previa al mes de Marzo para revisar la organización y el estado del proyecto, en caso de requerir alguna actualización en la planificación.

### 5.2.2. Planificación (PERT y simulación de Montecarlo)

A continuación, se muestra un cuadro con las tareas estipuladas para el desarrollo del proyecto. Se indica el tiempo más probable, sumando además los tiempos más optimistas y pesimistas.

N° | Tarea | Duración optimista | Duración más probable | Duración pesimista | Predecesora
2 | Detectar una necesidad | 2 | 3 | 4 | -
3 | Definir el alcance | 4 | 5 | 6 | 2
4 | Antecedentes y Contexto | 4 | 5 | 6 | 2
5 | Entrevista a la empresa | 1 | 3 | 5 | 3;4
6 | Definir objetivos de Diseño | 2 | 3 | 4 | 5
7 | Escribir Requerimientos | 2 | 4 | 6 | 6
8 | Escribir Especificaciones | 4 | 5 | 7 | 7
9 | Planes de Validación | 4 | 5 | 7 | 8
10 | DFMEA - 1° Reunión | 4 | 5 | 6 | 8
11 | Investigación POE y Unidades de Control | 8 | 10 | 14 | 7
12 | Análisis de Factibilidad Tecnológica | 10 | 15 | 20 | 11
13 | Análisis de presupuesto y costos | 12 | 15 | 20 | 7
14 | Análisis de Factibilidad Económica | 7 | 10 | 15 | 13
15 | DFMEA - 2° Reunión | 3 | 5 | 8 | 10
16 | (Receso) | 0 | 67 | 0 | 14
17 | Cálculos y selección de HW | 5 | 10 | 15 | 11;16
18 | Diagrama de HW e implementación | 12 | 15 | 20 | 17;15
19 | Prueba de HW | 12 | 15 | 20 | 18
20 | Diagramación de SW | 8 | 10 | 12 | 13;16
21 | Implementación de SW | 12 | 15 | 20 | 20
22 | Diseño de prototipo - Gabinete | 8 | 10 | 12 | 18;21
23 | Validación de prototipo | 15 | 20 | 25 | 22;19
24 | Estudio de confiabilidad | 5 | 10 | 15 | 23
Tabla 5.6: Tareas estipuladas con las duraciones estimadas

Efectuando la simulación de Montecarlo con las estimaciones establecidas previamente, se obtienen los siguientes resultados en términos de duración y fecha de finalización.

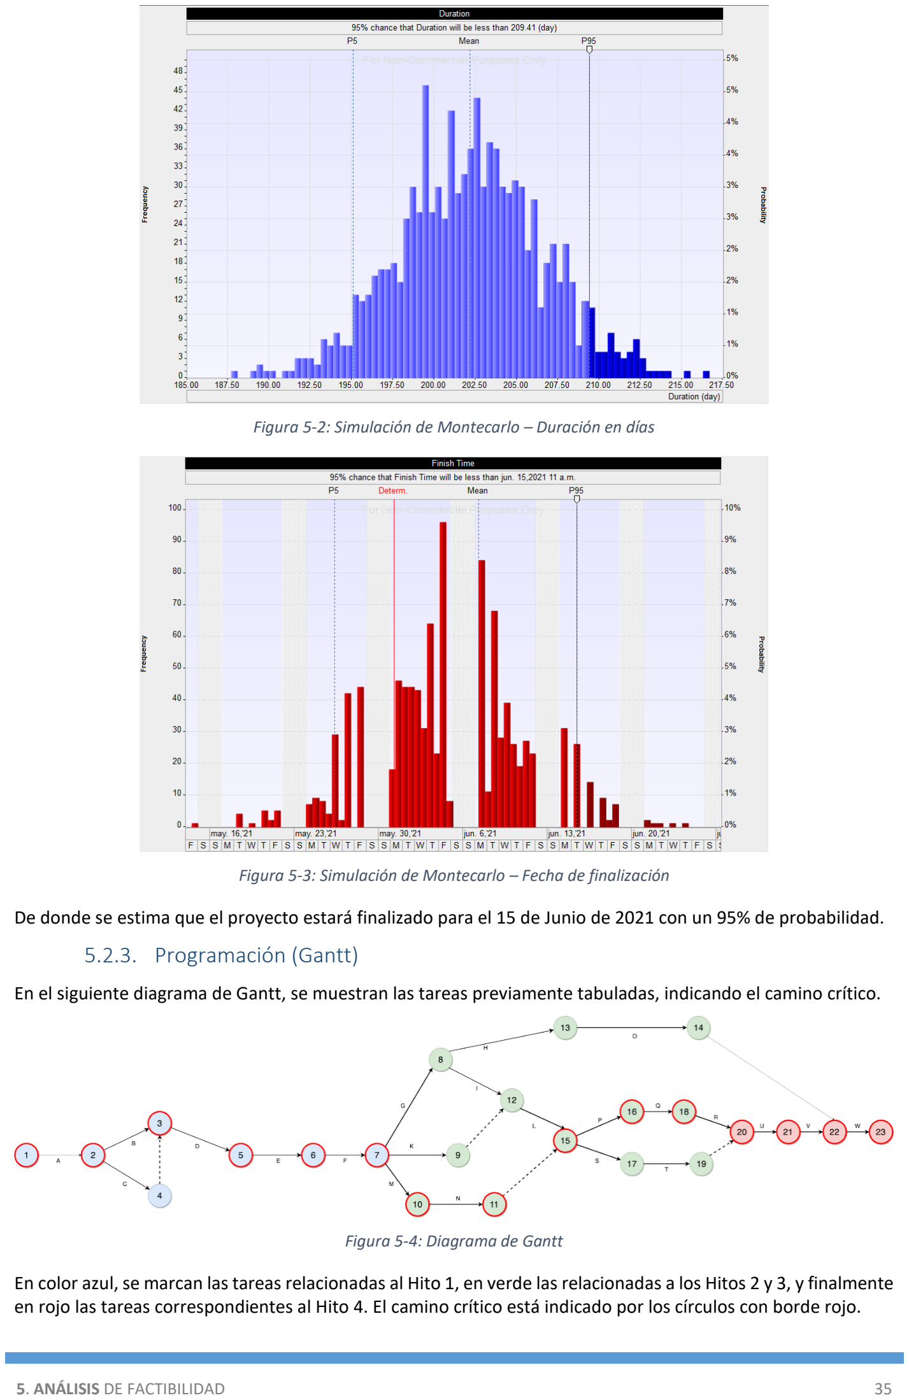
[picture p77: page 35]

5. ANÁLISIS DE FACTIBILIDAD | 35

Figura 5-2: Simulación de Montecarlo – Duración en días

Figura 5-3: Simulación de Montecarlo – Fecha de finalización

De donde se estima que el proyecto estará finalizado para el 15 de Junio de 2021 con un 95% de probabilidad.

### 5.2.3. Programación (Gantt)

En el siguiente diagrama de Gantt, se muestran las tareas previamente tabuladas, indicando el camino crítico.

Figura 5-4: Diagrama de Gantt

En color azul, se marcan las tareas relacionadas al Hito 1, en verde las relacionadas a los Hitos 2 y 3, y finalmente en rojo las tareas correspondientes al Hito 4. El camino crítico está indicado por los círculos con borde rojo.

5. ANÁLISIS DE FACTIBILIDAD | 36

## 5.3. Factibilidad económica

### 5.3.1. Modelo de Negocios

Este diseño se trata de un proyecto único, con posibilidad de realizar hasta 5 unidades adicionales posteriores a su finalización.

El principal ingreso corresponderá al diseño del hardware y software para el control del módulo, para lo que se requiere de conocimiento técnico (que será el valor agregado del proyecto). Se lo contempla al finalizar el proyecto.

### 5.3.2. Gastos e Ingresos

Como gastos principales, se considera los traslados hacia la fábrica, para llevar a cabo la instalación, puesta en marcha y validación del prototipo. Dicho gasto se tendrá en cuenta a partir del mes de Marzo, hasta la finalización del proyecto, para todos los integrantes del grupo. Se contabilizarán 10 US$ mensuales.

Para la compra de los componentes, se suman los costos estimados previamente, más el resto de los componentes misceláneos (resistores, capacitores, etc.) para el diseño de los circuitos involucrados. Se estima de este modo un costo de componentes de 100 US$, a contabilizar una única vez.

Como ingreso, se va tiene en cuenta una suma de 200 US$ contemplando los gastos que no estén siendo tenidos en cuenta y el resto será la ganancia del proyecto. Se apunta a obtener al finalizar, una ganancia del 50%.

### 5.3.3. Flujo de Fondos

Revisando los ítems anteriores, se arma el siguiente cuadro con el flujo de fondos para todo el proyecto.

| Mes
| 1 | 2 | 3 | 4 | 5 | 6 | 7 | 8 | 9 | 10 | 11 | 12
Ingreso | 0 | 0 | 0 | 0 | 0 | 0 | 0 | 0 | 0 | 0 | 0 | 200
Egreso | 0 | 0 | 0 | 0 | 10 | 0 | 0 | 10 | 110 | 10 | 10 | 10
Flujo | 0 | 0 | 0 | 0 | -10 | 0 | 0 | -10 | -110 | -10 | -10 | 190
Tabla 5.7: Flujo de Fondos

Calculando la VAN del proyecto resulta en 38.83 US$ positivos, por lo tanto, el proyecto es viable económicamente.

## 5.4. Factibilidad legal y responsabilidad civil

### 5.4.1. Seguridad

Acorde a la regulación 351/79 del ENRE, el equipo va a trabajar en tensiones bajas (entre 50 y 1000 Vrms). La regulación considera una tensión de seguridad de hasta 24V respecto a tierra.

Los sectores relevantes que están expuestos en el equipo son las salidas digitales (24VDC Sink), y las entradas analógicas (4-20mA).

### 5.4.2. Certificación

Acorde a la resolución 169/2018, como el producto no es de producción masiva, no requiere realizarse una certificación obligatoria.

En caso de querer realizarla, la misma al momento es gratuita (de acuerdo con el Ministerio de Desarrollo Productivo).

### 5.4.3. Normas a considerar

De acuerdo con lo estipulado en las especificaciones, las normativas a considerar son las siguientes:

- Estándar 802.3af para módulo de alimentación por POE

5. ANÁLISIS DE FACTIBILIDAD | 37
- Estándar 4-20mA para módulo de entradas analógicas
- Estándar de 24VDC SINK para módulo de salidas digitales
- Norma IEC 60529 para diseño de gabinete - Grado de protección IP
- Norma IRAM 2491-1-1: Definición de la terminología básica relacionada a CEM
- Norma IRAM 2491-4-1 y 2491-4-2: Técnicas de medición y ensayo para garantizar los valores deseados de EMI y de descargas eléctricas para entornos industriales
- Norma IRAM 2491-4-14: Norma para garantizar inmunidad electromagnética al equipo (SEM).

Siendo CEM = EMI + SEM (Emisiones electromagnéticas y Susceptibilidad Electromagnética)

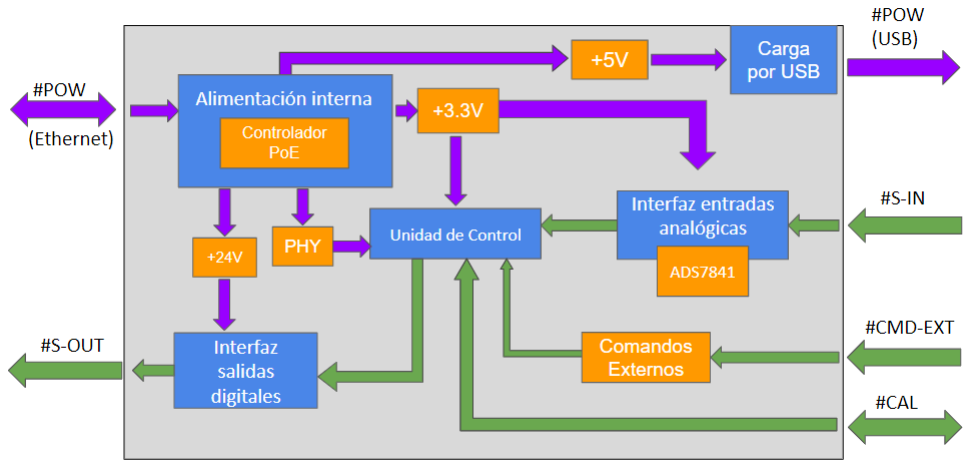
[picture p78: figure]

6. INGENIERÍA DE DETALLE | 38

## 6. Ingeniería de detalle

## 6.1. Hardware

### 6.1.1. Diagrama de bloques

En la siguiente figura, se muestra el diagrama en bloques del hardware contemplando los módulos internos a diseñar, y las correspondientes conexiones:

Figura 6-1: Diagrama en bloques de Hardware

### 6.1.2. <<Controlador PoE>> 6.1.2.1. Descripción

El prototipo va a recibir la energía a través del protocolo de PoE IEEE802.3af, proveniente de un Switch PoE con capacidad de entregar hasta 15W de potencia. Debido a esto, se requiere diseñar el circuito encargado de realizar la secuencia de inicialización correcta y seleccionar la cantidad de potencia máxima que deseamos que nos provea el Switch.

### 6.1.2.2. Detalles de selección y cálculo de los elementos circuitales

El diseño principal del circuito se centra en la utilización de un integrado que ofrecen los principales fabricantes de circuitos integrados. Sabiendo la potencia máxima a utilizar (15 W, correspondiente al standard PoE 802.3af) se selecciona el integrado que mejor se adapte a dichas especificaciones.

El circuito integrado seleccionado es el TPS2375D, de Texas Instruments.

- Entrada: Tensión + Datos proveniente de Switch PoE (Cable RJ-45)

El circuito recibe los 8 pines del cable RJ-45, y en base a esto, en primera instancia debe separar los datos de la alimentación principal. Si bien para estándares de mayores potencias dicha separación se realiza mediante transformadores (como se puede observar en el circuito a continuación), gracias al uso de un estándar de menor potencia, la tensión se provee en cables separados de los datos desde el Switch, por lo que los transformadores son prescindibles.

A partir de allí, se hace pasar la tensión por un puente de diodos, para garantizar siempre la polaridad positiva de la tensión, y luego se ingresa al circuito integrado.

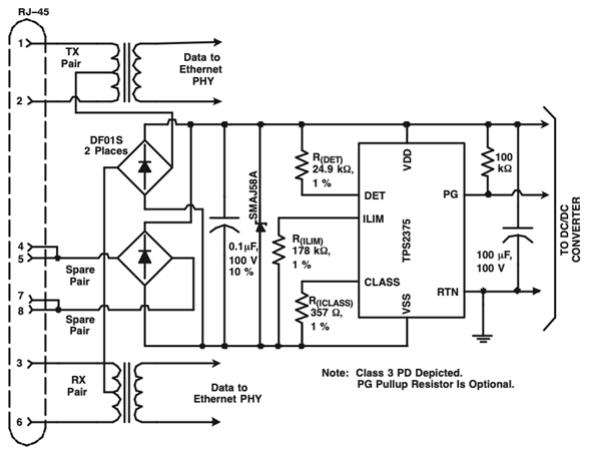
[picture p79: figure]

6. INGENIERÍA DE DETALLE | 39

El circuito final (estructura sugerida por la hoja de datos del fabricante) se puede observar en la siguiente figura:

Figura 6-2: Implementación del controlador TPS2375D

Para lograr una correcta inicialización del PoE, es preciso elegir los componentes restantes según lo indica la hoja de datos del fabricante:

Componente | Valor
R(DET) | 24.9K [Metal film 1%]
R(ILIM) | 178K [Metal film 1%]
R(ICLASS) | 357Ω [Metal film 1%]
C1 | 0.1uFx100V [Electrolítico]
C2 | 100uFx100V [Electrolítico]
Diodo Zener | Vz (Nominal): 57V

Tabla 6.1: Selección de componentes para la configuración a la potencia requerida

Los componentes que participan de forma directa en la selección y configuración de la potencia a obtener son las resistencias R(ICLASS) y R(ILIM). La primera es la carga a ser vista por el Switch PoE, que está establecida por la norma, y determina la potencia máxima a recibir. La segunda, limita la corriente pico durante la secuencia de inicialización, para asegurarse que se realice de forma correcta.

El capacitor C1, para cumplir con la norma PoE debe ser menor a 5μF. Para la potencia a utilizar, el fabricante recomienda aplicar la siguiente cota:

C1 ≤ (IOUT*180) / (10 mA)

Sin embargo, cambios en dicho capacitor pueden traer consecuencias a la hora de la inicialización, por lo que el fabricante sugiere utilizar el valor indicado en la tabla.

La potencia final está determinada por VDD y I(RTN) máxima, siendo que el circuito integrado garantiza en las peores condiciones de uso 13W de potencia (con una tensión de entrada de 37V).


6. INGENIERÍA DE DETALLE | 40
- Salida: La salida del circuito integrado se toma entre los pines VDD y RTN, una tensión nominal de 50V y una corriente máxima de 0.3 A (limitada por el Switch). Desde estos terminales, se derivarán los módulos de <<Alimentación Interna 3.3V>>, <<Alimentación Interna 24V>> y <<Carga por USB>>.

### 6.1.2.3. Plan de pruebas

Para el plan de pruebas de este módulo, se utilizarán los siguientes elementos:

- Switch PoE
- Cable Ethernet RJ-45
- Osciloscopio
- Reóstato de potencia 15W o superior

El objetivo es realizar una correcta inicialización del módulo, y validar que para una tensión del estándar de PoE (entre 37 y 57 V), se obtiene una salida de al menos 13W de potencia.

Para ello, se conecta el osciloscopio y el potenciómetro a los pines de salida (VDD, RTN). Luego, se conecta el módulo al Switch PoE a través del cable ethernet RJ-45. Se debe observar en primera instancia la inicialización correcta de PoE (como se muestra en la siguiente figura), seguido de una tensión continua de valor constante (el valor esperado es de 50 V, pero deberá estar comprendida en el intervalo mencionado anteriormente).

Figura 6-3: Secuencia de inicialización de PoE

Para la prueba con carga, se conecta el reóstato (ajustado a una resistencia de valor 15W/VDD o de por lo menos 220Ω) en los pines de salida. Comprobar que la potencia máxima que entrega el módulo se mantenga en todo momento en 13W o superior (potencia mínima garantizada por el circuito integrado).

### 6.1.3. <<Carga por USB>> 6.1.3.1. Descripción

La fuente de carga por USB es de 5V y se requiere para que el operario pueda cargar la Tablet de trabajo si así lo deseara. A su vez, de este módulo se desprenderá luego el módulo <<Alimentación Interna 3.3V>>.

### 6.1.3.2. Detalles de selección y cálculo de los elementos circuitales

Para el diseño se tienen en cuenta las siguientes características:

- Entrada: Tensión proveniente de PoE (37V – 57V)

A partir de esto, surge la necesidad de que en la búsqueda de circuitos integrados que posean la característica HV (High Voltage). Es decir, la tensión máxima admitida en su entrada sea hasta 60V. Se descarta la posibilidad de realizar un diseño que posea en su totalidad elementos discretos debido a que implica una mayor complejidad, cantidad de componentes y costo. Además, se debe considerar que resta el diseño de otras dos

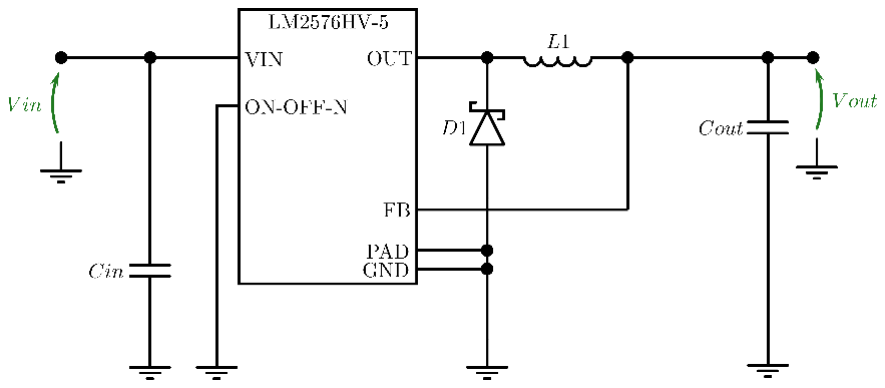
[picture p80: figure]
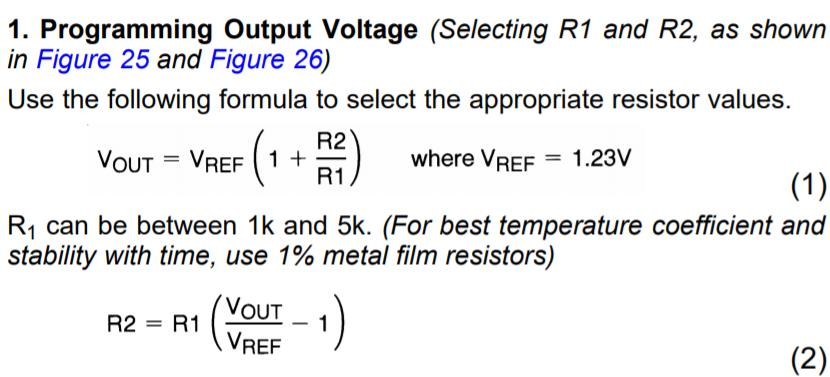
[picture p81: figure]

6. INGENIERÍA DE DETALLE | 41

fuentes (3.3V para la Unidad de Control e Interfaz de Entradas Analógicas, y 24V para la Interfaz de Salidas Digitales).

- Salida: A partir de las características de la conexión USB y el módulo <<Alimentación Interna 3.3V>>:
- USB: VDD = 5V, IDD = 1A
- Unidad de Control: VDD = 1.8V - 3.6V, IDD (máximo) = 240mA
- ADS7841: VDD = 2.7V - 5.0V, IDD = 240uA

Como objetivo de diseño, se toma entonces una Vo = 5V, y Io (máxima) = (1A + 0.24A) + 25% = 1.5A.

Teniendo en consideración una regulación lineal, la potencia a disipar por el circuito final se calcula como:
PD = (Vin-Vo)*Io = (57V-5V)*1.5A = 78W

Dada la ineficiencia que esta opción presenta en términos de energía, se optó por realizar un diseño de fuente tipo switching.

Para la búsqueda de circuitos integrados acordes, se utilizó el Webench Power Designer (aplicación disponible online) para el diseño de convertidores DC/DC que provee el fabricante Texas Instruments. Se tuvo en cuenta como criterio de búsqueda un orden por menor frecuencia de switching en el diseño (menor EMI resultante), y control por realimentación por tensión (diseño más simple).

A partir de la búsqueda y evaluación de las opciones disponibles se encuentra el LM2576HV-5. Este circuito integrado contempla tanto la característica HV buscada como una corriente máxima permisible de 3A. Además, es posible de conseguir en los proveedores existentes en el país. Finalmente, el circuito a diseñar posee la siguiente estructura:

Figura 6-4: Fuente Switching de 5V

Para el diseño del circuito, se siguen los pasos detallados en la hoja de datos de dicho componente, a desarrollar a continuación.

Figura 6-5: Paso 1 – Voltaje de salida requerido

Si toma R1 = 1K por simplicidad, resulta R2 = 3.06K. Con tolerancia de 1% es posible conseguir el valor R2 = 3.09K, que resulta en una Vo = 5.03V. Siguiendo la sugerencia, se utilizarán resistores de metal film.

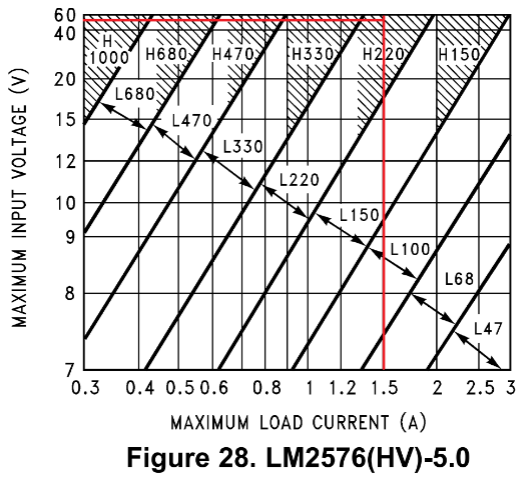
[picture p82: figure]

6. INGENIERÍA DE DETALLE | 42

Figura 6-6: Paso 2 – Selección del inductor

Se utiliza como Vout = 5V, Vin = 57V (máximo valor posible), y F = 52KHz (este es el valor de la frecuencia de conmutación a la que funciona el circuito integrado). Teniendo esto en cuenta, se interseca en el siguiente gráfico con la corriente máxima de trabajo:

Figura 6-7: Rangos de inductancia

Considerando el punto de intersección, se opta por un inductor L1 = 220uHy. La corriente nominal para su diseño está dada por Ia ecuación 1.15*ILOAD = 1.78A. A partir de la aplicación mencionada previamente verifican dichos valores y se añade también la característica de DCR (resistencia serie) = 0.2Ω (como valor máximo).

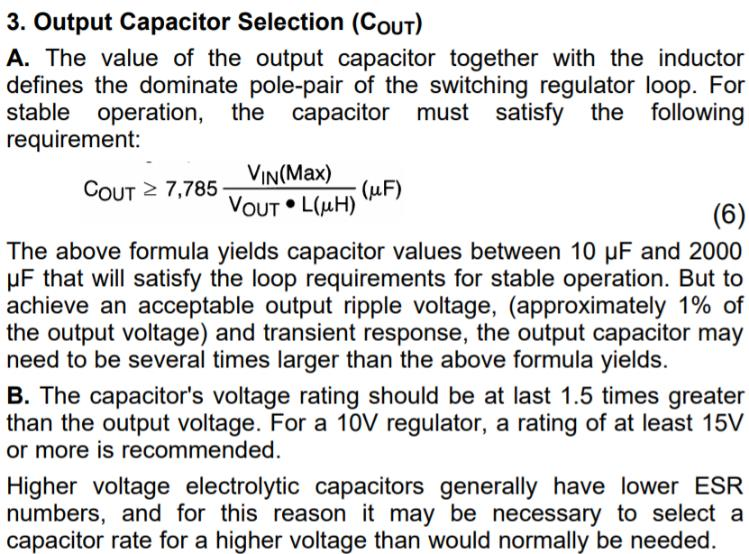
[picture p83: figure]
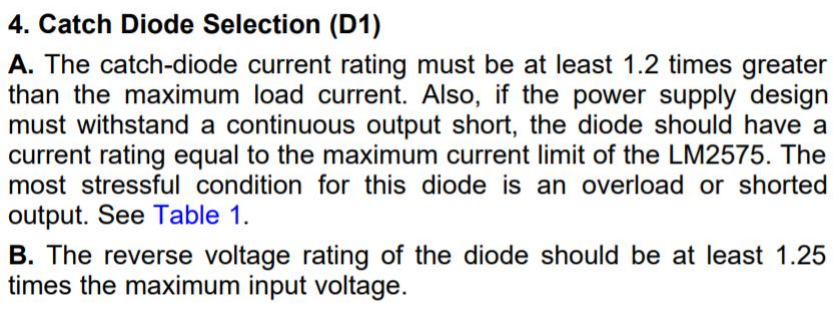
[picture p84: figure]
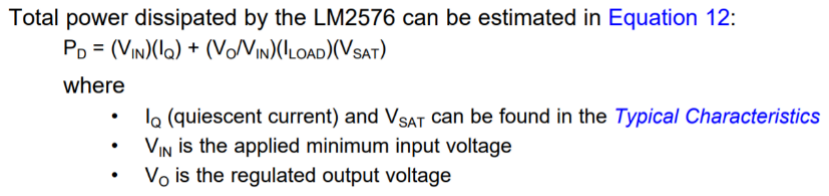
[picture p85: figure]

6. INGENIERÍA DE DETALLE | 43

Figura 6-8: Paso 3 – Selección del capacitor de salida

A partir de la ecuación provista, se tiene que Cout >= 0.68uF, y que la tensión nominal del capacitor debe ser al menos de 1.5*5V = 7.5V. Se utilizó finalmente un capacitor Cout = 680uFx16V [Electrolítico de Aluminio], cumpliendo con el criterio de estabilidad.

Figura 6-9: Paso 4 – Selección de diodo

A partir de las condiciones indicadas, se tiene que IF > 1.2*1.5A = 1.8A, y VR > 1.25*57V = 71.25V. En una de las tablas provistas en la hoja de datos se sugiere el diodo rápido MUR410, que cumple con margen dichas características (IF = 4A, VR = 100V), y se encuentra disponible en el país.

Figura 6-10: Paso 5 – Capacitor de entrada

Para el capacitor de entrada, en este caso la tensión nominal debe ser al menos 1.5*57V = 85.5V. Se tiene entonces que Cin = 100uFx100V [Electrolítico de Aluminio].

Por último, resta verificar si se necesita añadir un disipador. Para ello se calcula la potencia disipada y la temperatura de juntura resultante, siguiendo la estimación provista por la hoja de datos:

Figura 6-11: Estimación de la potencia disipada

De las tablas de la hoja de datos (y de los requerimientos de diseño) se tiene:
Tj (Máxima) = 125°C | Rja = 42.6°C/W IQ (Máxima) = 10mA | Vsat (Máxima) = 2V
Vin = 57V | Vo = 5V ILoad = 1.5A | Ta = 60°C
La potencia disipada resulta aproximadamente PD = 0.83W. Se calcula ahora la temperatura de juntura resultante:
Tj = Ta + PD*Rja = 96°C < Tj (Máxima) ➔ No se necesita colocar un disipador.

6. INGENIERÍA DE DETALLE | 44

### 6.1.3.3. Plan de pruebas

Para la validación del módulo, se requiere que se encuentre ya validado el módulo <<Controlador PoE>>. El objetivo es verificar que, para una tensión de entrada Vin provista por dicho módulo, se obtiene una tensión de salida Vout de valor esperado 5V.
Los elementos requeridos para realizar las pruebas son los siguientes:
- Módulo <<Controlador PoE>> validado
- Osciloscopio Digital
Estando apagado, conectar la salida del módulo <<Controlador PoE>> a la entrada Vin del módulo bajo prueba, teniendo en cuenta la polaridad. Configurar el osciloscopio, teniendo en cuenta el acople para visualizar señales con nivel de DC. Luego, conectar una punta a la salida Vout del módulo bajo prueba, teniendo en cuenta nuevamente la correcta polaridad para la referencia de GND. Encender el módulo <<Controlador PoE>>, y luego de que éste haya realizado su período de inicialización, comprobar que en el osciloscopio se observe una señal de 5VDC.

### 6.1.4. <<Alimentación Interna 3.3V>> 6.1.4.1. Descripción

La fuente de 3.3V se requiere para alimentar la Unidad de Control y la Interfaz de Entradas Analógicas. De las características de entrada y salida (a detallar a continuación) surgen los criterios de diseño a adoptar, siguiendo además las recomendaciones dadas por los fabricantes.

### 6.1.4.2. Detalles de selección y cálculo de los elementos circuitales

En primera instancia se buscará poder realizar un diseño de fuente tipo lineal, debido al requerimiento de bajas EMI. Para el diseño se tienen en cuenta las siguientes características:

- Entrada: Tensión proveniente de <<Carga por USB>> (5V)
- Salida: A partir de las características de la Unidad de Control y la Interfaz de Entradas analógicas:
- Unidad de Control: VDD = 1.8V - 3.6V, IDD (máximo) = 240mA
- ADS7841: VDD = 2.7V - 5.0V, IDD = 240uA

Como objetivo de diseño, se toma entonces una Vo = 3.3V, y Io (máxima) = 0.24A + 25% = 0.3A.

Teniendo en consideración una regulación lineal, la potencia a disipar por el circuito final se calcula como:

PD = (Vin-Vo)*Io = (5V-3.3V)*0.3A = 0.51W

Teniendo en cuenta un circuito integrado regulador ajustable típico, el LM317 [TO-220], se observa que los parámetros de diseño se sitúan dentro de las características de operación aceptables indicadas por el fabricante. Se estima entonces la temperatura de juntura resultante, con interfaz térmica directamente desde la juntura al ambiente, para verificar si es necesario utilizar un disipador:

Tj (Máxima) = 125°C | Rja = 38°C/W | PD = 0.51W | Ta = 60°C

Tj = Ta + PD*Rja = 80°C < Tj (Máxima)

De donde se observa que se tiene un margen considerable respecto a la temperatura máxima admisible. Por lo tanto, no es necesario incorporar un disipador.

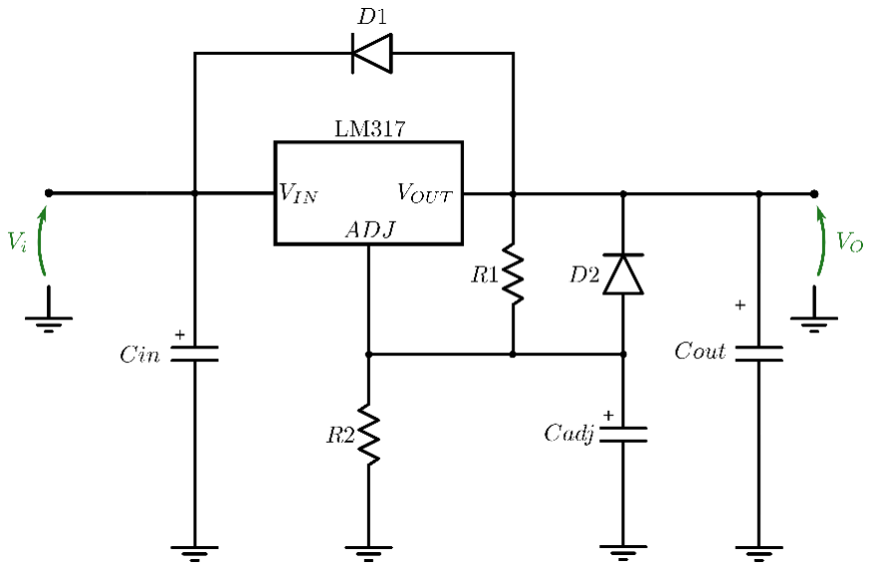
[picture p86: figure]

6. INGENIERÍA DE DETALLE | 45

El circuito de regulación indicado por el fabricante se muestra en la siguiente figura.

Figura 6-12: Fuente de alimentación de 3.3V

Las resistencias R1 y R2 definen el voltaje de salida. De acuerdo con la ecuación provista por el fabricante:

Vo = 1.25V*[1+ (R2/R1)]

Se adoptan los valores de R1 = 240Ω y R2 = 390Ω [Metal film – Tol. 1%], debido a su mejor coeficiente de temperatura y estabilidad. Con estos valores se obtiene una tensión de salida Vo = 3.28V, que se encuentra dentro del rango permisible [2.7V – 3.6V], que surge de la intersección de las condiciones de operación de la Unidad de Control y el circuito integrado ADS7841.

Para los capacitores de entrada, salida y ajuste (este último se utiliza para mejorar el rechazo al ripple en la tensión de salida) se adoptan los valores sugeridos por el fabricante, siendo entonces

Cin = 0.1uF [Multicapa] , Cout = 1uF [Multicapa] , Cadj = 10uFx16V [Electrolítico]

Para los diodos, se adoptan D1 = D2 = 1N4007, dado que el fabricante sugiere de la serie 4000 el modelo 1N4002, pero en los proveedores del país se consigue únicamente el 1N4007, que cumple con las características requeridas al 1N4002 para reemplazarlo.

### 6.1.4.1. Plan de pruebas

Para la validación del módulo, se requiere que se encuentre ya validado el módulo <<Carga por USB>>. El objetivo es verificar que, para una tensión de entrada Vin provista por dicho módulo, se obtiene una tensión de salida Vout de valor esperado 3.3V, que deberá comprendida en el rango [2.7V – 3.6V].
Los elementos requeridos para realizar las pruebas son los siguientes:
- Módulo <<Carga por USB>> validado
- Osciloscopio Digital
Estando apagado, conectar la salida del módulo <<Carga por USB>> a la entrada Vin del módulo bajo prueba, teniendo en cuenta la polaridad. Configurar el osciloscopio, teniendo en cuenta el acople para visualizar señales con nivel de DC. Luego, conectar una punta a la salida Vout del módulo bajo prueba, teniendo en cuenta nuevamente la correcta polaridad para la referencia de GND. Encender el módulo <<Carga por USB>>, y luego de que éste haya realizado su período de inicialización, comprobar que en el osciloscopio se observe una señal VDC comprendida en el rango indicado previamente.

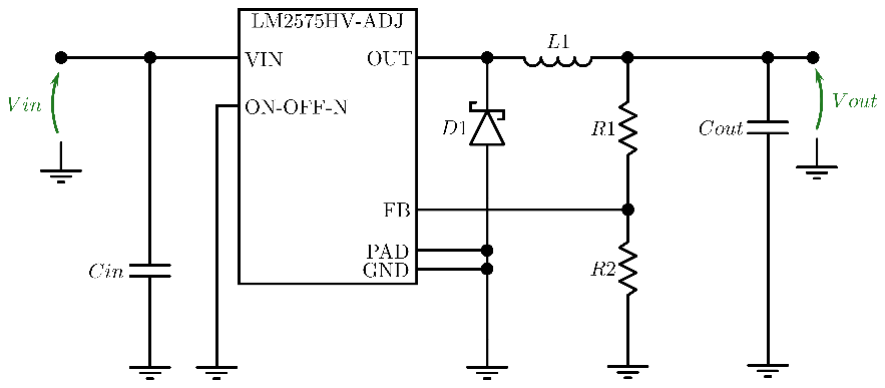
[picture p87: figure]

6. INGENIERÍA DE DETALLE | 46

### 6.1.5. <<Alimentación Interna 24V>> 6.1.5.1. Descripción

La fuente de 24V se requiere para alimentar la Interfaz de Salidas Digitales. De las características de entrada y salida (a detallar a continuación) surgen los criterios de diseño a adoptar, siguiendo además las recomendaciones dadas por los fabricantes.

### 6.1.5.2. Detalles de selección y cálculo de los elementos circuitales

El proceso de diseño en este caso es similar al desarrollado para <<Alimentación Interna 3.3V>>. Para el diseño se consideran ahora las siguientes características:

- Entrada: Tensión proveniente de PoE (37V – 57V)

Para las salidas, se tiene en cuenta de que deben poder accionar (cada una) relés simples de 24VDC – 10A. La corriente característica de la bobina interna de este tipo de relés para su activación está entre 30mA-40mA. Se toma para el diseño una corriente de hasta 50mA por salida. Siendo 4 salidas, resulta en una corriente total de 200mA. Entonces:

- Salida: VDD = 24VDC, IDD = 0.2A

Como objetivo de diseño, se toma entonces una Vo = 24V, y Io (máxima) = 0.2A + 25% = 0.25A.

Teniendo en consideración una regulación lineal, la potencia a disipar por el circuito final se calcula como:
PD = (Vin-Vo)*Io = (57V-24V)*0.25A = 8.25W Dada la ineficiencia que esta opción presenta en términos de energía, se optó por realizar un diseño de fuente tipo switching, como en el caso del módulo <<Carga por USB>>.

Se recurre nuevamente al Webench Power Designer para la búsqueda de circuitos integrados acordes, como se realizó para el módulo <<Carga por USB>>. A partir de ésta, resultó también adecuado el LM2575HV-ADJ previamente utilizado. El circuito a diseñar posee entonces la siguiente estructura:

Figura 6-13: Fuente Switching de 24V

Para el diseño del circuito, se siguen nuevamente los pasos detallados en la hoja de datos de éste componente, a detallar a continuación.

❖ Paso 1 – Voltaje de salida requerido

Siguiendo la ecuación vista en la sección anterior, se toma R1 = 1K por simplicidad. Resulta de esta forma un valor de R2 = 18.5K. Normalizando a R2 = 18K, se obtiene una Vo = 23.4V, que se encuentra dentro del rango admisible estipulado en los requerimientos (20.4V – 26.4V). Se utilizarán, al igual que antes, resistencias de metal film.

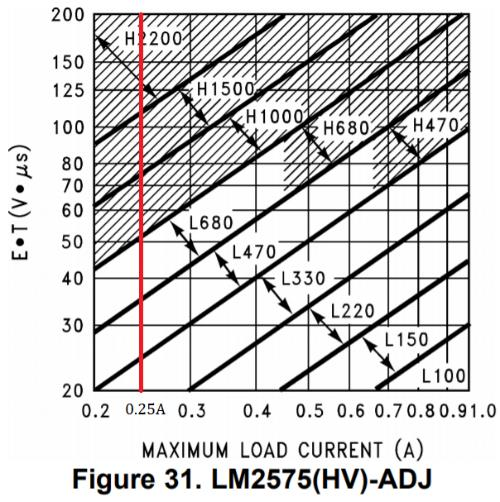
[picture p88: figure]

6. INGENIERÍA DE DETALLE | 47

❖ Paso 2 – Selección del inductor

Se utiliza como Vout = 24V, Vin = 57V, y F = 52KHz, siendo los dos últimos parámetros similares en el diseño anterior. Teniendo esto en cuenta resulta el producto E*T = 267 V*S. Se interseca este valor con la corriente máxima de trabajo en el siguiente gráfico:

Figura 6-14: Selección del Inductor

Dado que, en este caso, el punto de intersección queda por encima del límite último, resulta un L1 = 2.2mHy. La corriente nominal para su diseño está dada por Ia ecuación 1.15*ILOAD = 0.3ª. A partir de la aplicación mencionada previamente verifican dichos valores y se añade también la característica de DCR (resistencia serie) = 5Ω (como valor máximo).

❖ Paso 3 – Selección del capacitor de salida

A partir de la ecuación utilizada previamente, se tiene que Cout >= 8.4uF, cuya tensión nominal debe ser de al menos 1.5*24V = 36V. Para tener una baja tensión de ripple de salida, se adopta el valor sugerido en el diseño por Webench Power Designer, Cout = 220uFx50V [Electrolítico de Aluminio]. Se opta por una tensión nominal de 50V dado que es el inmediato mayor a 36V disponible en el mercado.

❖ Paso 4 – Selección del diodo

A partir de las condiciones indicadas, se tiene que IF > 1.2*0.25A = 0.3A, y VR > 1.25*57V = 71.25V. Se puede utilizar en este caso también el diodo rápido MUR110 especificado en el anterior diseño.

❖ Paso 5 – Capacitor de entrada

En este caso las condiciones a la entrada del circuito son similares, por lo que se utiliza el mismo capacitor especificado en el diseño anterior, Cin = 100uFx100V [Electrolítico de Aluminio].

Resta verificar ahora si es necesario agregar un disipador para el circuito integrado. Para ello se calcula la potencia disipada y la temperatura de juntura resultante, siguiendo la estimación provista por la hoja de datos:

De las tablas (y de los requerimientos de diseño) se tiene:
Tj (Máxima) = 125°C | Rja = 65°C/W | IQ (Máxima) = 10mA | Vsat (Máxima) = 1.4V
Vin = 57V | Vo = 24V | ILoad = 0.25ª | Ta = 60°C
La potencia disipada resulta aproximadamente PD = 0.75W. Se calcula ahora la temperatura de juntura resultante:

Tj = Ta + PD*Rja = 110°C < Tj (Máxima) ➔ No se necesita colocar un disipador (en forma teórica).

Dado que la temperatura de juntura resultante, en el peor caso se encuentra cerca de la máxima admisible, se buscará llevarla a un valor cercano al obtenido para los circuitos integrados involucrados en los módulos de <<Alimentación Interna 3.3V>> y <<Carga por USB>>, para obtener un mejor balance térmico.

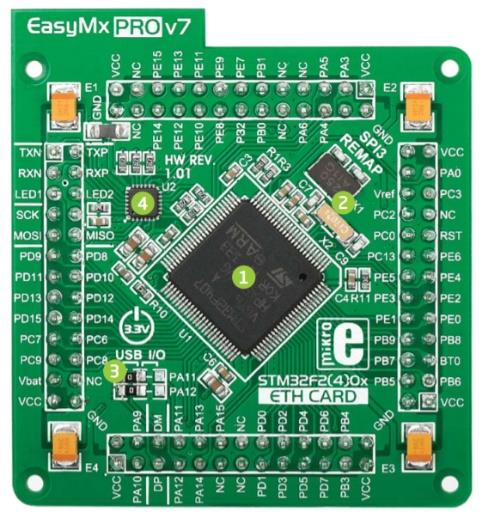
[picture p89: figure]

6. INGENIERÍA DE DETALLE | 48

Considerando entonces:

Tj (Máxima ajustada) = 90°C | Rjc = 0.4°C/W | Rcd (Interfaz con pasta térmica) = 0.6°C/W PD = 0.75W

Se calcula entonces la máxima resistencia térmica que deberá tener el disipador:

Rda = [Tj – Ta – PD*(Rjc+Rcd)]/PD < 39°C/W

Con esta cota bajo consideración, se utilizará un disipador pequeño, modelo 9075D, de 20mm extrusión cuya Rda = 25°C/W.

### 6.1.5.3. Plan de pruebas

Para la validación del módulo, se requiere que se encuentre ya validado el módulo <<Controlador PoE>>. El objetivo es verificar que, para una tensión de entrada Vin provista por dicho módulo, se obtiene una tensión de salida Vout de valor esperado 24V, que deberá comprendida en el rango [20.4V – 26.4V].
Los elementos requeridos para realizar las pruebas son los siguientes:
- Módulo <<Controlador PoE>> validado
- Osciloscopio Digital
Estando apagado, conectar la salida del módulo <<Controlador PoE>> a la entrada Vin del módulo bajo prueba, teniendo en cuenta la polaridad. Configurar el osciloscopio, teniendo en cuenta el acople para visualizar señales con nivel de DC. Luego, conectar una punta a la salida Vout del módulo bajo prueba, teniendo en cuenta nuevamente la correcta polaridad para la referencia de GND. Encender el módulo <<Controlador PoE>>, y luego de que éste haya realizado su período de inicialización, comprobar que en el osciloscopio se observe una señal VDC comprendida en el rango indicado previamente.

### 6.1.6. <<Unidad de Control>> 6.1.6.1. Descripción

En primera instancia, para la Unidad de Control se utilizará la placa de desarrollo básica existente HP Ethernet MCU card with STM32F407VGT6, de la empresa MikroElektrónika:

Figura 6-15: Placa de desarrollo básica

La placa de desarrollo posee las siguientes características:

✓ | Cristal y elementos pasivos embebidos.
✓ | Líneas de comunicación por USB ➔ Permite la programación del microcontrolador de forma externa.
✓ | Ethernet Transceiver ➔ Resuelve la interfaz de conexión requerida entre el periférico que posee el
| microcontrolador y las conexiones provenientes del cable Ethernet externo (PHY).
✓ | Puede utilizarse tanto en una placa de prueba como en el prototipo y el producto final.

En los agujeros disponibles serán soldadas tiras de pines, que permitirán conectar dicha placa a otra placa general, con todas las interfaces principales del diseño.

En segunda instancia, se tiene la conexión de los calibres a la Unidad de Control para la transmisión de las mediciones.

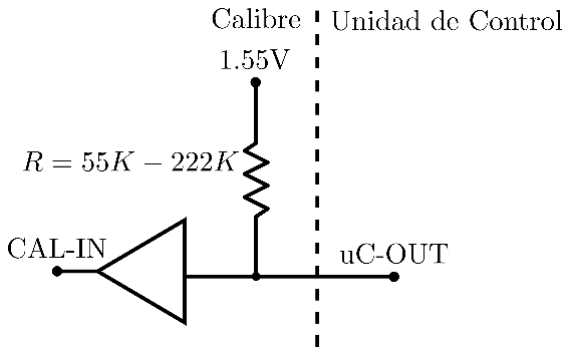
[picture p90: figure]
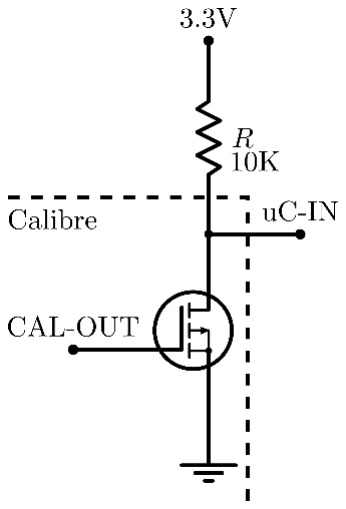
[picture p91: figure]

6. INGENIERÍA DE DETALLE | 49

En tercera instancia, deben conectarse a la Unidad de Control por un lado el pedal para solicitar lectura de medición de un calibre, y por otro lado una conexión proveniente de un PLC que indica que se debe contabilizar una pieza adicional al inventario. Dichas conexiones, cuando están en nivel alto, son de 24VDC, por lo que deben adaptarse adecuadamente a las entradas de la Unidad de Control. Por requerimiento del cliente, dicha adaptación se realizará mediante el uso de optoacopladores.

Como optoacoplador se utilizará el TLP521-2, dado que es simple de conseguir en los proveedores del país y posee dos circuitos optoacopladores internos, que son la cantidad requerida.

### 6.1.6.1. Detalles de selección y cálculo de los elementos circuitales

Por cada calibre, se tienen las siguientes 4 conexiones:

❖ /REQ (Input): en estado bajo inicia la transmisión
❖ DATA (Output): trama de 13 bits con la información de la medición y configuración
❖ CLK (Output): señal de reloj generada por el calibre para sincronización
❖ GND: tierra

La entrada de /REQ está conectada a una resistencia de Pull-Up interna a la tensión de la pila del calibre (1.55V):

Figura 6-16: Entrada de un Calibre

Puede conectarse directamente a uno de los puertos de la Unidad de Control, de tal forma que para utilizarla se colocará el puerto en estado bajo para establecer el mismo estado en la entrada tratada, o en alta impedancia para establecer el estado alto.

Las salidas DATA y CLK son de tipo Open Drain, por lo que se debe agregar una resistencia de Pull Up externa para conectarlas a los puertos de la Unidad de Control:

Figura 6-17: Salidas de un Calibre

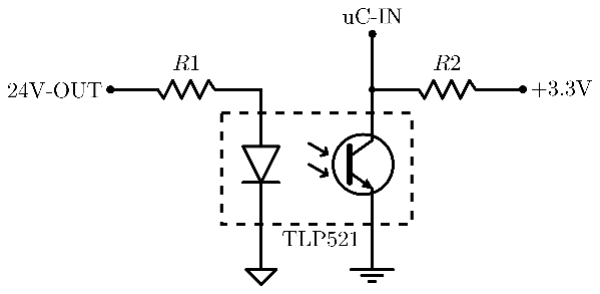
[picture p92: figure]
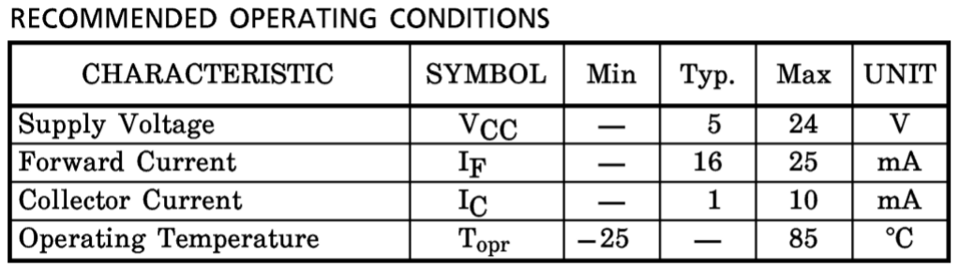
[picture p93: figure]

6. INGENIERÍA DE DETALLE | 50

Para las entradas de comando de pedal y PLC, el diseño del circuito tiene la siguiente estructura:

Figura 6-18: Circuito para optoacoplado 24V – 3.3V [Por cada entrada]

De la hoja de datos del circuito integrado, se tienen las condiciones recomendadas de trabajo para el diseño:

Figura 6-19: Tabla de Condiciones de operación recomendadas (Futurlec)

Donde IF será la corriente por R1 e IC la corriente por R2.

Tomando un valor intermedio para IF = 20mA, se ingresa a la curva de operación IF-VF:

Figura 6-20: Curva de trabajo IF-VF (Futurlec)

Se tiene que para IF = 20mA, VF = 1.2V. Entonces resulta:

R1 = (24V – VF)/IF = 1.14K ➔ R1 = 1K + 150Ω [Tol. 1% - Metal Film], a fin de disminuir las variaciones.


6. INGENIERÍA DE DETALLE | 51

Tomando un valor intermedio para IC = 5mA, se ingresa a la curva de trabajo IC-VCE:

Figura 6-21: Curva de operación IC-VCE (Futurlec)

Se tiene que para IC = 5mA, con IF = 20mA resulta VCE = 0.1V. Este valor para saturación es importante verificar que sea menor a la VIL indicada por el fabricante de la Unidad de Control, a saber:

VIL = 0.3*VDD = 0.3*3.3V = 1V

Con lo que se está dentro del límite permitido, para que dicho valor de VCE sea considerado como un cero lógico. Se tiene entonces:

R2 = (3.3V - VCE)/IC = 640Ω ➔ R2 = 680Ω [Tol. 1% - Metal Film]

### 6.1.6.2. Plan de pruebas

La prueba de comunicación con los calibres, una vez conectados a la Unidad de Control, debe realizarse desde el Software (a detallar más adelante). Debe, además, encontrarse validado el módulo <<Alimentación Interna 3.3V>>.

Para la prueba de funcionamiento de las señales de los comandos externos, se requiere:

Los elementos requeridos para realizar las pruebas son los siguientes:
- Módulo <<Alimentación Interna 3.3V>> validado
- Osciloscopio Digital
- Fuente de 24VDC externa

El procedimiento a describir debe repetirse para ambas entradas.

Tomando una de las entradas, se conecta la fuente de 24VDC entre los pines (24V-OUT, GND-Externa) respetando la polaridad). Conectar luego el osciloscopio en su respectiva salida (los pines uC-IN, GND-Interna), estando configurado para poder visualizar señales con nivel de DC. Debe visualizarse una tensión continua de 0.2V o menor.

Luego, conectar ambos pines (24V-OUT, GND-Externa) a la referencia de la fuente externa, de forma tal que haya 0V entre ambos. En el osciloscopio ahora deberá visualizarse una tensión continua de 3.3V.

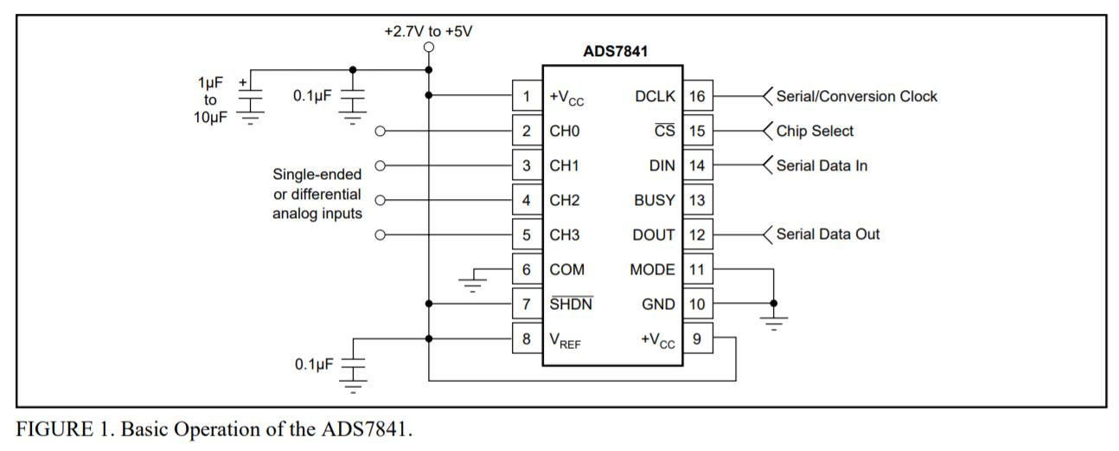
[picture p94: figure]
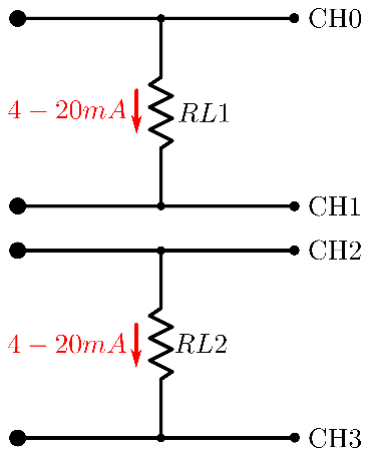
[picture p95: figure]

6. INGENIERÍA DE DETALLE | 52

### 6.1.7. <<Interfaz Entradas Analógicas>> 6.1.7.1. Descripción

Como interfaz para las entradas analógicas de corriente 4-20mA, se utiliza el ADS7841, que es un ADC cuyas entradas pueden ser tomadas en forma simple (referidas a GND) o diferencial (esta última es la que resulta de interés). La medición es comunicada a la unidad de control a través de un protocolo serie SPI.

### 6.1.7.2. Detalles de selección y cálculo de los elementos circuitales

Dado que se tienen 4 entradas analógicas de corriente, y cada circuito integrado permite conectar 2 entradas diferenciales, se requerirán dos unidades de éste. El conexionado típico estipulado por la hoja de datos es el siguiente:

Figura 6-22: Configuración básica del ADS7841 (Texas Instruments)

Las entradas diferenciales deberán conectarse a resistencias en paralelo, como se muestra en la siguiente figura:

Figura 6-23: Conexión a lazos de corriente [Por cada circuito integrado]

Teniendo en cuenta el máximo valor de corriente, se calcula el máximo valor que podrán tener las resistencias, dado que la diferencia de tensión que se produzca no puede superar el valor de la tensión de alimentación (3.3V). Luego, normalizando hacia abajo:

RL = 3.3V/20mA = 165Ω ➔ 150Ω

En base a esto, se tiene para los límites de operación que las caídas de tensión serán:

- 4mA ➔ 0.6V
- 20mA ➔ 3V

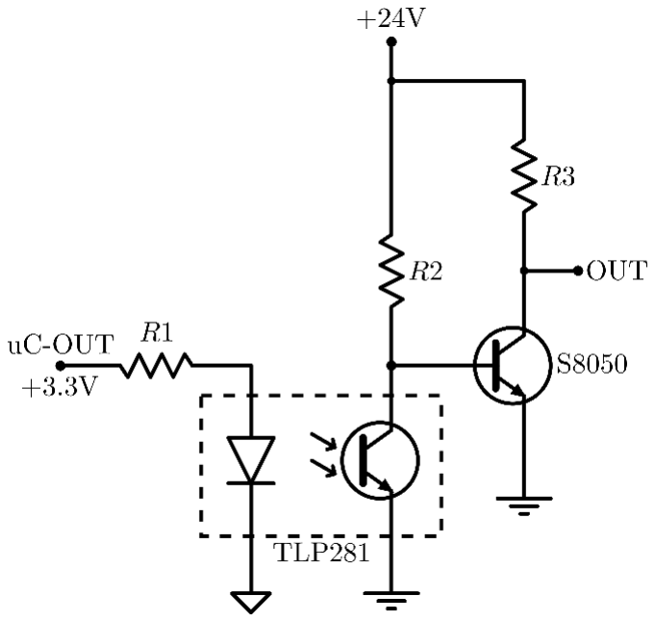
[picture p96: figure]

6. INGENIERÍA DE DETALLE | 53

### 6.1.7.3. Plan de pruebas

Para la validación del módulo, se requiere que ya esté validado el módulo <<Alimentación Interna 3.3V>>. El objetivo en este caso será comprobar mediante una medición diferencial realizada con un osciloscopio, que se produzcan las caídas de tensión esperadas sobre las resistencias.

Para realizar la prueba se requieren los siguientes elementos:

- Módulo <<Alimentación Interna 3.3V>> validado
- Instrumental para generación de lazo de corriente
- Voltímetro Digital

El procedimiento a describir se realiza sobre la resistencia RL1, debe repetirse para la otra resistencia RL2 y para las resistencias sobre el segundo circuito integrado.

Configurar el instrumental de generación de lazo de corriente a 4mA, y conectar sobre la entrada correspondiente a RL1. Luego, medir la diferencia de tensión sobre la resistencia con el Voltímetro, debiendo observarse un valor de tensión continua de 0.6V.

Configurar el instrumental para generación de lazo de corriente en 20mA, y repetir la medición, debiendo observarse en este caso un valor de tensión continua de 3V.

Realizadas las validaciones anteriores, se procederá luego con la validación de las lecturas de ADC a través de la sección de Software.

### 6.1.8. <<Interfaz Salidas Digitales>> 6.1.8.1. Descripción

Con la interfaz para las salidas digitales de 24VDC, se utiliza un circuito estructurado mediante optoacopladores y transistores para aislar la señal de control proveniente de la Unidad de Control, de las salidas propiamente dichas, dado que se utilizarán para la activación de relés simples de 24VDC-10A.

### 6.1.8.2. Detalles de selección y cálculo de los elementos circuitales

El diseño principal del circuito se centra en la utilización de un optoacoplador para poder lograr cierto nivel de aislación entre la salida de la unidad de control y el relé que se desea activar. Teniendo en cuenta que para cada uno de los relés se activen se necesita una corriente máxima de 50 mA, se diseñó el siguiente circuito para realizar esta interfaz.

Figura 6-24: Circuito de aislación para Salidas Digitales

6. INGENIERÍA DE DETALLE | 54

Al configurar en estado lógico alto la salida de la Unidad de Control se acciona el optoacoplador, lo que hará que el transistor de salida entre en estado de corte, abriendo el circuito y la tensión que se verá en el nodo OUT será de 24V, mientras que si se cambia el estado lógico de la salida de la Unidad de Control a bajo se deja de energizar al optoacoplador, lo que hará que el transistor de salida entre en saturación dejando el nodo OUT en 0V.

Para poder definir que transistor y optoacoplador se tiene que utilizar primero se tuvo que determinar la corriente que se necesita para energizar el relé. De la hoja de datos del fabricante se obtiene el valor de la impedancia de la bobina del relé, obteniendo:

IL = 24V/1600Ω = 15 mA

Tomando los valores de R1 = R2 = 5.1KΩ [Metal film Tol. 1%], se obtiene que cuando el transistor se encuentre en saturación se tendrá una corriente de colector total de:

IC = 15 mA + 24V/5.1KΩ = 20 mA

Teniendo en cuenta un margen de seguridad y dando una corriente total de colector de 50 mA, se adopta el transistor S8050, que posee un HFE(mínimo) = 120, con el que se obtiene una corriente de base IB = 0.41 mA. Se eligió el circuito integrado TLP281-4 dado que posee ya 4 optoacopladores internos y se puede permitir una corriente de colector máxima de 50 mA, para cada salida. Este optoacoplador posee un RTCmin = 100 con el que se obtiene una corriente ID = 4.16 μA.

### 6.1.8.3. Plan de pruebas

Para la validación del módulo, se requiere que ya esté validado el módulo <<Alimentación Interna 3.3V>> y <<Alimentación Interna 24V>> . EL objetivo en este caso es comprobar primero con un voltímetro y luego con relés la activación y funcionamiento de cada una de las salidas digitales.

Para realizar la prueba se requieren los siguientes elementos:

- Módulo <<Alimentación Interna 3.3V>> validado
- Módulo <<Alimentación Interna 24V>> validado
- Voltímetro Digital.

El procedimiento a describir se realiza sobre cada uno de los nodos de OUT de las 4 salidas digitales. Configurar el instrumental para poder leer la tensión que se encuentra en dicho nodo y proceder a probar en cada uno de estos si se obtiene la tensión esperada dependiendo de la configuración del pin de salida de la unidad de control.

Una vez validado que cada una funciona de forma independiente, se debe probar el funcionamiento de las distintas salidas en simultaneo, primero probando todas las configuraciones posibles de 2 entradas, luego de 3 entradas, y por último con todas activas al mismo tiempo.

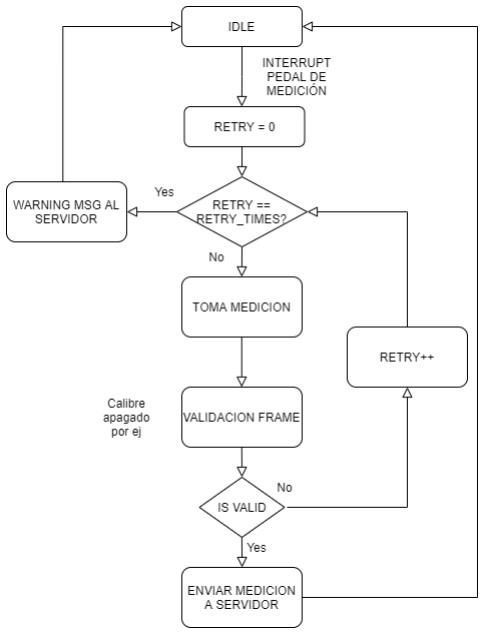
[picture p97: figure]

6. INGENIERÍA DE DETALLE | 55

## 6.2. Software

### 6.2.1. Diagrama de estados y flujogramas

El software a programar en la Unidad de Control deberá contar con 3 partes principales:

- Establecer la comunicación entre la placa y los calibres
- Incrementar el contador de piezas en el servidor, cada vez que se indique por comando externo
- Realizar lectura de entradas analógicas y controlar encendido de salidas digitales según se indique

A continuación, se muestran los diagramas de estados y flujogramas correspondientes:

Diagrama 1: Comunicación entre Placa y Calibres

Diagrama 2: Conteo de piezas producidas

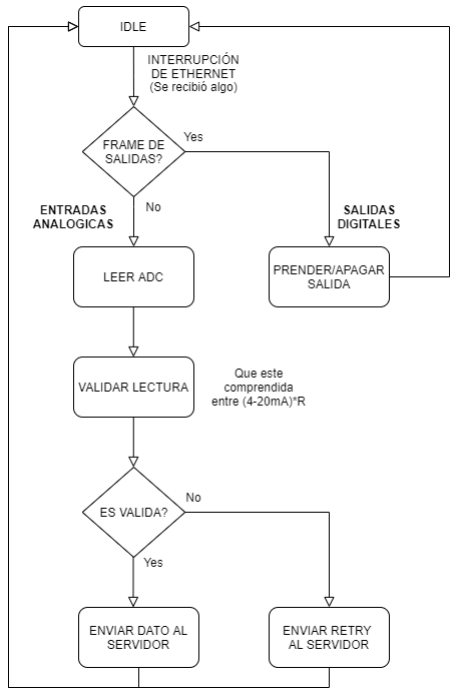
[picture p98: figure]
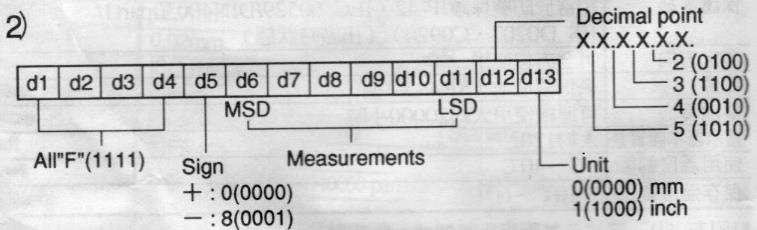
[picture p99: figure]

6. INGENIERÍA DE DETALLE | 56

Diagrama 3: Control de entradas analógicas y salidas digitales

### 6.2.2. Análisis de complejidad

Analizando conceptualmente los diagramas de flujo del programa, se observa que ningún algoritmo que forma parte del código involucra operaciones en función de la cantidad de muestras (como podría ser, por ejemplo un cálculo de una transformada rápida de Fourier con complejidad O(n log n)), ni tampoco se presentan multiplicaciones. Por ello, se llega a la conclusión de que la complejidad es de O(1), dado que el tiempo de ejecución de las diferentes subrutinas que conforman el código es constante.

### 6.2.3. Comunicación con calibres - Protocolo

El fabricante Mitutoyo brinda una hoja de datos donde se especifica el protocolo que utilizan.

Figura 6-25: Trama de datos de comunicación de calibres

Dado que la trama no corresponde a un estándar común utilizado (como lo es por ejemplo SPI, a utilizar en <<Interfaz Entradas Analógicas>>), se optó por implementarlo mediante una combinación de GPIO e interrupciones.

6. INGENIERÍA DE DETALLE | 57

### 6.2.4. Descripción de subrutinas

Para poder empezar a pensar en las subrutinas se debe recordar cuales son las principales funcionalidades que debe cumplir el dispositivo. Se distinguen en color verde las funciones disponibles en SDK y en negrita las funciones implementadas por el equipo de desarrollo.

- Tiene que poder recibir de la entrada de pedal la orden de leer la medición, adquirir la medición y enviarla al servidor.
- Poder leer el pedal: interrupciones de GPIO (flanco ascendente).
- Tomar medición: digimaticGetMeasure (Protocolo Digimatic) que requiere interrupciones de GPIO, HAL_GPIO_ReadPin y HAL_GPIO_WritePin.
- Validación de frame: digimaticIsValidFrame.
- Enviar frame al servidor: ETHSendFrameHandler, la cual arma el paquete según que se necesita enviar (en este caso es un valor de medición de calibre) y luego hace uso de HAL_ETH_TransmitFrame.

CaliperManager: administra las funciones previamente descritas, y se activa con la interrupción del pedal.

- Tiene que llegar un comando desde el servidor vía Ethernet y poder discernir si se está tratando de leer una entrada analógica o encender/apagar una salida digital, y actuar en consecuencia.

Se utiliza una interrupción de recepción vía Ethernet: hace uso de HAL_ETH_GetReceivedFrame , y luego en base a lo que se recibió por medio de ETHReceiveFrameHandler, se determina la operación a realizar. Separando en los dos casos posibles:

- Entradas Analógicas
❖ Leer ADC: usa HAL_SPI.
❖ Validación de lectura de ADC: analogValidate, si no es válido le avisa al servidor que vuelva a intentar.
❖ Enviar dato de la entrada al servidor: ETHSendFrameHandler, la cual arma el paquete según que se necesita enviar (en este caso es un valor de medición de entrada analógica) y luego hace uso de HAL_ETH_TransmitFrame.
- Salidas Digitales
❖ Encender/Apagar salida: usa HAL_GPIO_WritePin.

analogInDigitalOutManager: administra las funciones previamente descritas, y se activa con la interrupción de recepción de Ethernet.

- Tiene que poder, en base a una señal digital provista desde un PLC, enviar un mensaje al servidor para incrementar el contador de piezas producidas.
- Poder leer la señal: interrupciones de GPIO y HAL_GPIO_ReadPin.
- Enviar el incremento en la cantidad de piezas al servidor: ETHSendFrameHandler, la cual arma el paquete según que se necesita enviar (en este caso es incrementar el contador de piezas producidas) y luego hace uso de HAL_ETH_TransmitFrame.

pieceCounterManager: administra las funciones previamente descritas, y se activa con la interrupción generada por la señal del PLC.

6. INGENIERÍA DE DETALLE | 58

### 6.2.5. Plan de prueba de módulos y de depuración de Software

Se va a utilizar un enfoque bottom-up para hacer el debugging. Es decir, se prueban primero las unidades más pequeñas para luego acoplarlas al programa principal.

- Ethernet
- Recepción
❖ Prueba: Envío de paquete de Ethernet de tipo testETHRx desde la PC.
❖ Resultado esperado: Se active la interrupción de RX y se reciba el testFrameRx. #IFDEF TEST_ETH_RX assert(receivedFrame == testFrameRx)
- Envío
❖ Prueba: Envío de paquete de Ethernet de tipo testETHTx desde la PC.
❖ Resultado esperado: Se active la interrupción de Rx y como se detectó que el paquete es de tipo testETHTx, hay que responder al servidor en ese momento con un frame de tipo ACK por Ethernet y ver que vuelve por la terminal.
- Calibres
- Con calibre encendido
❖ Prueba: se mide un objeto de dimensiones conocidas y se emula el pedal de medición conectado al GPIO.
❖ Resultado esperado: En digimaticGetMeasure si hay un error, ocurre un assert: #IFDEF CALIPER_TEST assert(MIN_VAL <= measure <= MAX_VAL). Recibir por Ethernet el valor medido, frame del tipo CALIPER_MEASURE.
- Con calibre apagado
❖ Prueba: se emula el pedal de medición conectado al GPIO.
❖ Resultado | esperado: | esperar | el | frame | de | warning
WARNING_NOT_VALID_CALIPER_MEASURE a través de Ethernet en la PC.
- Entradas Analógicas
- En rango
❖ Prueba: ingresar al sistema con corrientes entre 4mA y 20mA. Enviar mensaje mediante Ethernet del tipo READ_ANALOG_INPUT para tomar medición del ADC. ❖ Resultado esperado: debe llegar por medio de Ethernet el valor medido, frame del tipo ANALOG_IN_MEASURE.
- Fuera de rango
❖ Prueba: ingresar al sistema con una corriente fuera de rango (0mA). Enviar mensaje vía Ethernet del tipo READ_ANALOG_INPUT para tomar medición del ADC.
❖ Resultado esperado: cuando falla la validación, debe llegar un frame de tipo RETRY_ANALOG_IN_MEASURE a la PC mediante Ethernet.
- Salidas Digitales
❖ Prueba: se envía un paquete por Ethernet de tipo SET_DIGITAL_OUTPUT.
❖ Resultado esperado: con un osciloscopio medir las salidas y comprobar que el estado lógico es correcto.
- Contador de Piezas
❖ Prueba: se emula la señal del PLC, conectado al GPIO.
❖ Resultado esperado: debería activarse interrupción de recepción por Ethernet con el tipo de paquete INCREMENT_COUNTER.

7. CONSTRUCCIÓN DEL PROTOTIPO | 59

## 7. Construcción del prototipo

## 7.1. Definición de los módulos 7.2. Diseño de los circuitos impresos 7.3. Diseño mecánico 7.4. Detalles de construcción y precauciones especiales de montaje 7.5. Bill of Materials (BOM)

8. VALIDACIÓN DEL PROTOTIPO | 60

## 8. Validación del prototipo

## 8.1. Estudios de confiabilidad de hardware y de software 8.2. Resultados 8.3. Evaluación

### 8.3.1. Evaluación de resultados técnicos 8.3.2. Evaluación de la planificación 8.3.1. Evaluación de la factibilidad financiera

## 8.4. Consideraciones finales hacia el producto final

9. REFERENCIAS | 61

## 9. Referencias

## 9.1. LIBROS 9.2. REVISTAS 9.3. Notas de aplicación 9.4. Fuentes Online

Compatibilidad Electromagnética - IRAM [Online]. Available: https://cie.gov.ar/web/images/Compatibilidad-Electromagnetica.pdf

Normas IP ANSI [Online]. Available: https://www.demaquinasyherramientas.com/herramientas-de-medicion/que-son-las-normas-ip

Lazos de corriente 4-20mA [Online]. Available: https://www.herramientasingenieria.com/onlinecalc/spa/4_20mA.html

CPI: ¿Por qué 4-20mA? [Online]. Available: https://cpi.com.ar/notas/por-que-4-20-ma/

Design in high power POE IEEE [Online]. Available: https://www.digikey.com/es/articles/design-in-high-power-poe-ieee-8023bt-solutions

IEEE Standard for Ethernet [Online]. Available: https://es.qwe.wiki/wiki/Power_over_ethernet#Power_levels_available

Módulo de salida drenador de 24 VCC de estado sólido Compact (Especificaciones de Salida) [Online]. Available:

https://literature.rockwellautomation.com/idc/groups/literature/documents/in/1769-in056_-es-p.pdf

10. ANEXOS TÉCNICOS | 62

## 10. Anexos Técnicos

## 10.1. Esquemáticos 10.2. Planos de PCB 10.3. Listado de Partes y Componentes (BOM) 10.4. Códigos de Software

typedef enum {
READ_ANALOG_INPUT,
SET_DIGITAL_OUTPUT,

} received_frame_t;
typedef enum {
CALIPER_MEASURE,
ANALOG_IN_MEASURE,
INCREMENT_COUNTER,
WARNING_NOT_VALID_CALIPER_MEASURE,
RETRY_ANALOG_IN_MEASURE
} send_frame_t;
void ETHSendFrameHandler(send_frame_t frame_type, uint16_t* data){ switch(frame_type){
case CALIPER_MEASURE:
// statement using HAL_ETH_TransmitFrame(...); break;
case ANALOG_IN_MEASURE:
// statement using HAL_ETH_TransmitFrame(...); break;
case INCREMENT_COUNTER:
// statement using HAL_ETH_TransmitFrame(...); break;
case WARNING_NOT_VALID_CALIPER_MEASURE:
// statement using HAL_ETH_TransmitFrame(...); break;
case RETRY_ANALOG_IN_MEASURE:
// statement using HAL_ETH_TransmitFrame(...); break;
default:
break;
}
}
received_frame_t ETHReceiveFrameHandler(uint16_t receivedFrame, uint16_t * receivedData){
// Caracteristica del paquete, suponiendo b15 = 1 significa analog in *receivedData = receivedFrame & ~(1<<15);
if(receivedFrame & 1<<15){
return READ_ANALOG_INPUT;
}else{
return SET_DIGITAL_OUTPUT; }
}
uint16_t digimaticGetMeasure(void){
// Administracion del protocolo digimatic // Activar señal de request (/REQ)
// Encender CLK por 13 ciclos
// En cada ciclo se lee DATA

10. ANEXOS TÉCNICOS | 63

uint16_t data = 0;

// Aca va el protocolo digimatic (a implementar)

return data;
}
// En flanco ascendente del pedal
void CaliperManager(void){

uint16_t measure = 0;
uint8_t retry_times = 3;
bool is_valid = false;

while(retry_times > 0 && !is_valid){
measure = digimaticGetMeasure();
is_valid = digimaticValidateFrame(measure); retry_times--;
}

if(is_valid){
ETHSendFrameHandler(CALIPER_MEASURE, &measure);
}else{
ETHSendFrameHandler(WARNING_NOT_VALID_CALIPER_MEASURE, NULL); }
}
// Interrupción Rx Ethernet
void AnalogInDigitalOutManager(void){

uint16_t receivedFrame = HAL_ETH_GetReceivedFrame(...);
uint16_t receivedData = 0;
received_frame_t received_state = ETHReceiveFrameHandler(receivedFrame, &receivedData);

if(received_state == READ_ANALOG_INPUT){ if(analogValidate(receivedData){ // si es valido ETHSendFrameHandler(ANALOG_IN_MEASURE, &receivedData); }else{
ETHSendFrameHandler(RETRY_ANALOG_IN_MEASURE, NULL); }

}else if(received_state == SET_DIGITAL_OUTPUT){ HAL_GPIO_WritePin(receivedData);
}
}
// Interrupcion por señal de PLC
void pieceCounterManager(void){ ETHSendFrameHandler(INCREMENT_COUNTER, NULL); }

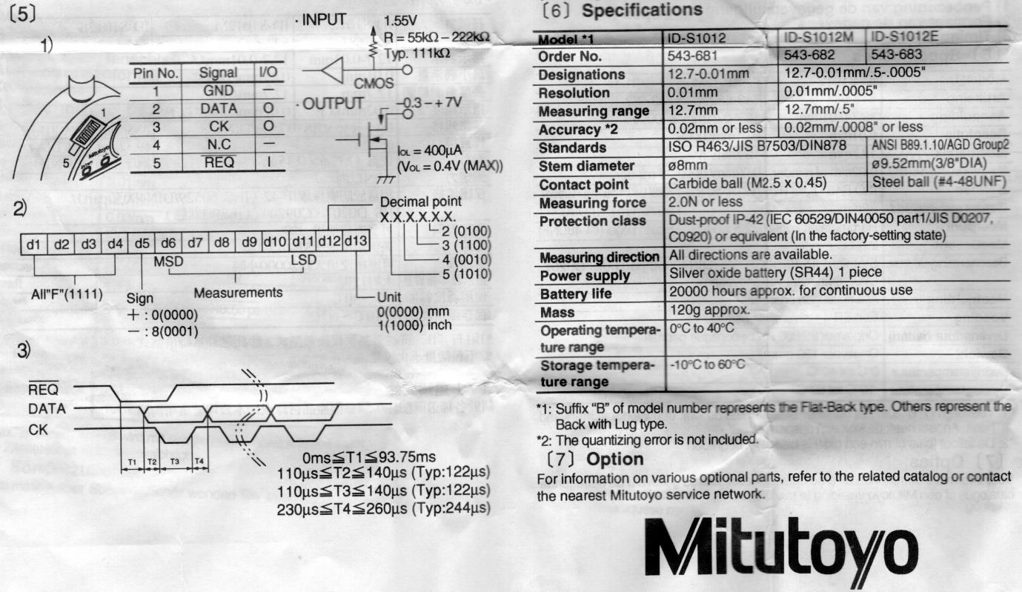
[picture p100: figure]

10. ANEXOS TÉCNICOS | 64

## 10.5. Hojas de Datos de Componentes

Figura 10-1: Especificaciones de comunicación del calibre

Implementación para el módulo <<Controlador PoE>> mediante el circuito integrado TPS2375

[Texas Instruments - Online]. Available: https://www.ti.com/lit/ds/symlink/tps2375.pdf

Implementación para el módulo <<Alimentación Interna 3.3V>> mediante el circuito integrado LM317

[Texas Instruments - Online]. Available: https://www.ti.com/lit/ds/symlink/lm317.pdf

Implementación para el módulo <<Carga por USB>> mediante el circuito integrado LM2576HV

[Texas Instruments - Online]. Available: https://www.ti.com/lit/ds/symlink/lm2576hv.pdf

Implementación para el módulo <<Alimentación Interna 24V>> mediante el circuito integrado LM2575HV

[Texas Instruments - Online]. Available: https://www.ti.com/lit/ds/symlink/lm2575hv.pdf

Implementación para el módulo <<Interfaz de Entradas Analógicas>> mediante el circuito integrado ADS7841

[Texas Instruments - Online]. Available: https://www.ti.com/lit/ds/symlink/ads7841.pdf

## 10.6. Hojas de Aplicación 10.7. Otra Documentación Técnica
