mregueira/DisenioBJAM/Hito 2/InformeHito2_Grupo2_V1.pdf

INSTITUTO TECNOLÓGICO DE BUENOS AIRES – ITBA

ESCUELA DE INGENIERÍA Y TECNOLOGÍA

# Módulo para comunicación de mediciones

# y control de actuadores

AUTORES: | Bualó, Santiago (Leg. Nº 57557)
| Martorell, Ariel Antonio (Leg. Nº 56209)
| Mestanza, Joaquín Matías (Leg. Nº 58288)
| Regueira, Marcelo Daniel (Leg. Nº 58300)
DOCENTES TITULARES: | Pingitore, Ricardo Alejandro
| Orchessi, Walter
| Ugarte, Alejandro

0. AGRADECIMIENTOS | 2

TRABAJO FINAL PRESENTADO PARA LA OBTENCIÓN DEL TÍTULO DE INGENIERO ELECTRÓNICO

BUENOS AIRES

SEGUNDO CUATRIMESTRE, 2020

## Agradecimientos

TBD

0. ÍNDICE | 4

## Índice

## Contenidos

0. ÍNDICE | 5

0. ÍNDICE | 6
7.2. Diseño de los circuitos impresos | 38
7.3. Diseño mecánico | 38
7.4. Detalles de construcción y precauciones especiales de montaje | 38
7.5. Bill of Materials (BOM) | 38
8. Validación del prototipo | 39
8.1. Estudios de confiabilidad de hardware y de software | 39
8.2. Resultados | 39
8.3. Evaluación | 39
8.3.1. Evaluación de resultados técnicos | 39
8.3.2. Evaluación de la planificación | 39
8.3.1. Evaluación de la factibilidad financiera | 39
9. Referencias | 40
9.1. LIBROS | 40
9.2. REVISTAS | 40
9.3. Notas de aplicación | 40
9.4. Fuentes Online | 40
10. Anexos Técnicos | 41
10.1. Esquemáticos | 41
10.2. Planos de PCB | 41
10.3. Listado de Partes y Componentes (BOM) | 41
10.4. Códigos de Software | 41
10.5. Hojas de Datos de Componentes | 41
10.6. Hojas de Aplicación, etc | 41
10.7. Otra Documentación Técnica | 41

## Lista de Figuras

Figura 3-1: Diagrama Funcional de Interfaces | 13
Figura 4-1: Diagrama de dependencias de Validación | 25
Figura 5-1: Esquema modular | 26
Figura 5-2: Simulación de Montecarlo – Duración en días | 34
Figura 5-3: Simulación de Montecarlo – Fecha de finalización | 34
Figura 5-4: Diagrama de Gantt | 34
Figura 10-1: Especificaciones de comunicación del calibre | 41

## Lista de Tablas

Tabla 3.1: Requerimientos | 12
Tabla 3.2: Leyenda de uso en especificaciones | 14

0. ÍNDICE | 7

0. ACRÓNIMOS Y DEFINICIONES | 8

## Acrónimos y Definiciones

Acrónimo | Descripción
AC | Corriente Alterna (Alternate Current)
ADC | Conversor de señal analógica a digital (Analog to Digital Converter)
DC | Corriente Continua (Direct Current)
EMC | Compatibilidad Electromagnética (ElectroMagnetic Compatibility)
HW | Hardware
SW | Software
TBD | To Be Determined
TBC | To Be Confirmed
VAC | Volts de corriente alterna (AC)
VDC | Volts de corriente continua (DC)
POE | Alimentación a través de Ethernet (Power Over Ethernet) (ver definiciones)
Término | Definición
Industria 4.0 | Comúnmente se la refiere como la cuarta revolución industrial. Describe la creciente tendencia hacia la automatización y el intercambio de datos en tecnología y procesos dentro de la industria manufacturera, que incluye conceptos actuales como IoT (Internet Of Things). Además, realiza simulaciones de planta para evaluar la toma de decisiones óptimas y descentralizadas.

Power Over Ethernet Es un estándar de la IEEE que permite fusionar señales de potencia con señales de
| internet de datos. Se verá con mas detalle a lo largo del trabajo.

0. RESUMEN | 9

## Resumen

El presente informe de proyecto final de la carrera de Ingeniería Electrónica plantea una problemática puntual de una empresa, y una posible solución con el producto que aquí se presenta: un módulo para comunicación de mediciones y control de actuadores.

Se analizan los requerimientos y especificaciones del producto teniendo en cuenta al cliente en este caso: un fabricante de piezas mecanizadas para autopartistas.

Se evalúan las diferentes posibilidades para el controlador central de este producto, eligiendo al microcontrolador como unidad de control preferida. También se evalúan las posibles implementaciones para los otros módulos que lo componen, teniendo en cuenta normativas de seguridad eléctrica y compatibilidad electromagnética (debido a que se trabaja en un ambiente industrial).

1. INTRODUCCIÓN | 10

## 1. Introducción

1.1. Antecedentes.
En la fábrica “Establecimiento Metalúrgico Campiutti S.R.L.” se realiza la producción de piezas mecanizadas para automóviles. Para validar las dimensiones de dichas piezas, éstas son posicionadas para ser medidas utilizando calibres digitales.

Se dispone de un operario que registra manualmente la medición indicada por el calibre en una aplicación contenida en una Tablet, donde además éste controla que dicha medición esté dentro de las tolerancias admitidas (especificadas en la misma aplicación). Luego, a través de ella envía la medición registrada al servidor de la planta.

Los inconvenientes planteados por el cliente (dueño de la planta, Leandro Campiutti), son los siguientes:

- Demora demasiado tiempo en el largo plazo realizar el registro de las mediciones en forma manual
- Pueden ocurrir errores de tipeo del operario al realizar el registro, enviando la información con errores

## 1.2. Contexto del proyecto

Actualmente, se tienen ciertas situaciones particulares que condicionan el desarrollo del proyecto, a saber:

- Pandemia de alcance mundial: Se dificulta efectuar reuniones físicas en el corto y mediano plazo. También, debido a ésta, se han impuesto restricciones en lo referente a la importación de componentes del exterior por parte del Gobierno Nacional (esto luego se traducirá en un requerimiento especificado por el propio cliente). Por otra parte, el acceso a los laboratorios para efectuar las mediciones y/o validaciones necesarias.
- Baja en las exportaciones de automóviles
- Caída en la producción de la industria automotriz, reducción en jornada laboral
- Cierre de fábricas autopartistas

Por otra parte, el regreso del cepo cambiario amplió la brecha, permitiendo que aquellos que poseen ahorros en dólares, ganen mayor poder adquisitivo. Como consecuencia, se abarata el costo de algunos autos ensamblados en el país.

2. OBJETIVOS | 11

## 2. Objetivos

## 2.1. Finalidad del Proyecto

La finalidad del proyecto consiste en ofrecer a la empresa “Establecimiento Metalúrgico Campiutti S.R.L.” un producto que facilite el proceso de medición de las piezas producidas, así como el registro y la validación de las mediciones tomadas.

A su vez, ofrecer la posibilidad de conectar otros sensores y actuadores adicionales en el futuro, brindando escalabilidad.

## 2.2. Planteamiento del Problema a Resolver

Este trabajo busca lograr comunicar al operario digitalmente el valor de las mediciones tomadas por los calibres utilizados en forma satisfactoria, evitando que deba registrarlas manualmente (consiguiendo así reducir los tiempos de adquisición de ellas) y ocupándose únicamente de la validación de sus dimensiones.

Para ello, el primero de los focos importantes será poder asegurar la validez de la información recibida. Es decir, que aquellos datos que sean transmitidos por el calibre sean los mismos que reciba el operario en la aplicación de su Tablet de trabajo. Esto contempla esencialmente lograr una correcta comunicación con el calibre (que utiliza un protocolo serie) y con la red local, que está integrada a la tecnología POE (el segundo de los focos importantes de este trabajo, a desarrollar posteriormente).

El tercer foco importante consiste en ofrecer, por un lado, una correcta interfaz para entradas analógicas adicionales con el estándar 4-20mA, para poder conectar en un futuro próximo sensores que se comuniquen con dicho estándar. Y, por otro lado, una correcta interfaz para salidas digitales de 24VDC, para poder conectar en un futuro próximo actuadores que se alimenten con dicho estándar.

## 2.3. Alcance

El proyecto contempla el desarrollo de un producto con el cual el operario a cargo de realizar las mediciones con los calibres digitales pueda comunicar dichas mediciones tomadas a través de una red local con POE. Además, contará con entradas analógicas (del estándar 4-20mA) y salidas digitales de 24VDC adicionales, contemplando un uso futuro por parte del cliente. El trabajo no contempla la validación de los valores medidos por los calibres. La contrastación periódica de los calibres estará a cargo del cliente.

Las instrucciones para solicitar la lectura de las entradas analógicas adicionales, así como para configurar las salidas digitales, se realizarán también a través de la conexión de red sin intervención del producto par ninguna de estas tareas.

3. DEFINICIÓN DE PRODUCTO | 12

## 3. Definición de Producto

## 3.1. Requerimientos de Cliente

### 3.1.1. Relevamiento de Datos

El relevamiento de datos para la obtención de los requerimientos se realizó mediante conversaciones directas con el dueño de la fábrica. Éste indicó tanto detalles de funcionamiento a tener en cuenta, como del instrumental a utilizar (los calibres digitales).

### 3.1.2. Requerimientos finales para trazabilidad

ID | Descripción | Origen
REQ-01 | El operario deberá recibir el valor de la medición hecha por el calibre en la aplicación para Tablet preexistente. Puede darse que se quiera obtener la medición de más de un calibre. | Cliente
REQ-02 | El producto deberá comunicarse y alimentarse mediante POE. | Cliente
REQ-03 | El producto deberá comunicarse con los calibres siguiendo el protocolo serie especificado por el fabricante (Mitutoyo) | Cliente
REQ-04 | Deberán poder conectarse al producto al menos 4 (cuatro) calibres. | Cliente
REQ-05 | Si no hay una pieza presente, el producto deberá igualmente transmitir el valor de medición que le sea comunicado por el calibre. | Cliente Tácito
REQ-06 | Si el calibre se encuentra apagado, y se solicita un valor de medición de éste, el producto deberá comunicar que el calibre al que se solicitó un valor de medición se encuentra apagado. | Cliente
REQ-07 | Los componentes que se vayan a utilizar para el desarrollo del producto deben conseguirse dentro de la República Argentina, para evitar los actuales inconvenientes de importación. | Cliente Factibilidad Económica
REQ-08 | El producto deberá disponer de puertos de entrada analógicos con el estándar 4-20mA para conectar sensores de presión de escala 0 - 200 mBar modelo SS611ED y puertos de salidas digitales de 24VDC, para contemplar una escalabilidad a futuro. | Cliente
REQ-09 | El producto deberá cumplir con la norma IRAM de compatibilidad electromagnética, dado que se ubicará en un ambiente industrial. | Norma
REQ-10 | El producto deberá cumplir con la norma IEC 60529, respecto al nivel de protección que debe tener el gabinete donde estará contenido, dado que se ubicará en un ambiente industrial. Se indicará con el grado de protección IP. | Norma
REQ-11 | El producto deberá contar con una salida USB Tipo A, con el fin de permitir al operario conectar la Tablet para recargar su batería. La conexión será únicamente para alimentación, y no para datos. | Cliente

Tabla 3.1: Requerimientos


3. DEFINICIÓN DE PRODUCTO | 13

## 3.2. Diagrama Funcional de Interfaces

Figura 3-1: Diagrama Funcional de Interfaces

3. DEFINICIÓN DE PRODUCTO | 14
3.3. Especificaciones de Diseño.

### 3.3.1. Especificaciones Funcionales

Leyenda para Especificaciones

Aplicabilidad | Validación
P: Prototipo | I: Inspección Visual
F: Producto Final | S: Simulación

D: Documentación de Diseño

T: Test
Tabla 3.2: Leyenda de uso en especificaciones
ID | Descripción | Origen | Aplicabilidad Validación
FUN-POW-01 | Alimentación desde POE según estándar 802.3af: Consumo de potencia no mayor a 15W - 400mA (limitado por los cables, según el estándar básico) El producto debe utilizar cables 8PC8-RJ45 de 8 pines Modo B, categoría 3. (100BASE-TX) con un largo no mayor a 100 metros. El producto debe enviar por el cableado la alimentación y los datos por pines separados, utilizando los pares de repuesto. El rango de tensión que recibe el equipo debe estar entre 37V y 57V. La impedancia de entrada del equipo debe ser de entre 19KΩ y 26.5 kΩ. El dispositivo debe respetar la secuencia de arranque de POE contemplada en la norma 802.3af.
REQ-02 | P, F
| I, D, T
FUN-POW-02 | El producto deberá contar con un conector USB Tipo A (5V –
TBD mA), que permita al operario conectar su Tablet para recargar la batería si así lo requiere. Esta conexión será únicamente para alimentación, y no para datos.

REQ-11 P, F

D, T

Tabla 3.3: Especificaciones Funcionales

3. DEFINICIÓN DE PRODUCTO | 15

### 3.3.2. Especificaciones de Interfaz

ID | Descripción | Origen | Aplicabilidad Validación
INT-S-IN-01 | El producto deberá disponer de 4 entradas analógicas adicionales que trabajen con el estándar 4-20mA. • Mayor seguridad (menor a 30 mA) • Mayor inmunidad al ruido eléctrico e interferencias electromagnéticas • Facilidad en detección de fallas | REQ-08 | P, F I, D, T

Tabla 3.4: Especificaciones de Interfaz S-IN

ID | Descripción | Origen | Aplicabilidad Validación
INT-S-OUT-01 | El producto deberá disponer de 4 salidas digitales de tipo 24VDC SINK. • Máximo 1A de corriente para cada salida • Rango de tensión de alimentación entre 20.4 V a 26.4 V | REQ-08 | P, F I, D, T

Tabla 3.5: Especificaciones de Interfaz S-OUT

ID | Descripción | Origen | Aplicabilidad Validación
INT-CAL-01 | El producto deberá comunicarse con los calibres siguiendo el protocolo serie especificado por el fabricante (Mitutoyo) La frecuencia de reloj para la sincronización posee un valor típico de 4.096KHz. Se adjuntan más detalles en la sección 10.5, Figura 10-1. | REQ-03 | P, F D, T
INT-CAL-02 | El producto deberá disponer de al menos 4 (cuatro) conjuntos de puertos de conexión, según indica la documentación del fabricante de los calibres: | REQ-04
Pin Nro. | Señal | I/O
1 | GND | -
2 | DATA | O
3 | CK | O
4 | N.C. | -
5 | /REQ | I

De manera tal de poder conectar al menos 4 (cuatro) calibres.

Tabla 3-6: Especificaciones de Interfaz CAL

3. DEFINICIÓN DE PRODUCTO | 16
ID | Descripción | Origen | Aplicabilidad Validación
INT-COM-01 | El producto se comunicará con el servidor a través de una conexión a red local por Ethernet, mediante protocolo TCP-IP. | REQ-01, REQ-02, REQ-05, REQ-06 | P, F D, T
INT-COM-02 | La impedancia máxima proporcionada por los cables será de 20Ω. | REQ-02 | P, F D, T
INT-COM-03 | Debe poder recibir del servidor instrucciones para enviar mediciones de las entradas analógicas y configurar las salidas digitales a través del cable de Ethernet. | REQ-02 | P, F D, T
INT-COM-04 | Si un calibre está apagado y se solicita una medición de dicho calibre, deberá contemplar un TimeOut de 5 segundos y comunicar al servidor que el calibre está apagado. | REQ-06 | P, F D, T
INT-COM-05 | Si no hay una pieza presente, se transmitirá de todas maneras valor de medición nulo. | REQ-05 | P, F D, T

Tabla 3-7: Especificaciones de Interfaz COM

3. DEFINICIÓN DE PRODUCTO | 17
ID | Descripción | Origen | Aplicabilidad Validación
| corresponde a: Nivel de protección contra elementos sólidos:
Nivel | Tamaño objeto entrante | Efectividad
5 | Protección contra polvo | La entrada de polvo no puede evitarse, pero el mismo no debe entrar en una cantidad tal que interfiera con el correcto funcionamiento del equipo
INT-MEC-01 | El equipo deberá tener un grado de protección IP53, que

Nivel de protección contra elementos líquidos:

Nivel | Protección frente a | Método de prueba | Resultados
3 | Agua nebulizada (spray) | Se coloca el equipamiento en su lugar de trabajo habitual | No debe entrar el agua nebulizada hasta en un ángulo de 60° a derecha e izquierda de la vertical, a un promedio de 11 litros por minuto, y a una presión de 80-100 kN/m² durante un tiempo no menor a 5 minutos

De acuerdo con la norma IEC 60529.

REQ-10 | P, F
| I, T

Tabla 3-8: Especificaciones de Interfaz MEC

### 3.3.3. Especificaciones de Implementación

ID | Descripción | Origen | Aplicabilidad Validación
IMP-OPE-01 | El dispositivo deberá poder operar normalmente cuando la temperatura ambiente sea: 0°C < TAMB < 40°C (TBC) | (Entorno Industrial) | F D, T

Tabla 3.6: Especificaciones de Operación

3. DEFINICIÓN DE PRODUCTO | 18
ID | Descripción | Origen | Aplicabilidad Validación
IMP-EMC-01 | El dispositivo deberá operar normalmente con inmunidad al ruido electromagnético de acuerdo con la norma IRAM 2491: CEM = EMI + SEM. (Emisiones electromagnéticas y Susceptibilidad Electromagnética) Norma IRAM 2491-1-1: Definición de la terminología básica relacionada a CEM. Norma IRAM 2491-4-1 y 2491-4-2: Técnicas de medición y ensayo para garantizar los valores deseados de EMI y de descargas eléctricas. Norma IRAM 2491-4-14: Norma para garantizar inmunidad electromagnética al equipo SEM. | REQ-09 | F T

Tabla 3.7: Especificaciones de Compatibilidad Electromagnética

D | Descripción | Origen | Aplicabilidad Validación
IMP-COS-01 | Los componentes que se vayan a utilizar para el desarrollo del producto deben conseguirse dentro de la República Argentina, para evitar los actuales inconvenientes de importación. | REQ-07 | F D

Tabla 3.8: Especificaciones de costos

### 3.3.4. Especificaciones de Servicio (RAMS)

ID | Descripción | Origen | Aplicabilidad Validación
RAM-CON-01 | TBD | TBC | TBD

Tabla 3.9: Especificaciones de Confiabilidad

ID | Descripción | Origen | Aplicabilidad Validación
RAM-DIS-01 | TBD | TBC | TBD

Tabla 3.10: Especificaciones de Disponibilidad

ID | Descripción | Origen | Aplicabilidad Validación
RAM-MAN-01 | TBD | TBC | P, F T

Tabla 3.11: Especificaciones de Mantenibilidad

3. DEFINICIÓN DE PRODUCTO | 19
ID | Descripción | Origen | Aplicabilidad Validación
RAM-SEG-01 | La máxima temperatura que podrá tener la carcasa será de TBD | TBC | P, F D, S, T

Tabla 3.12: Especificaciones de Seguridad

## 4. Plan de Validación
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
