mregueira/DisenioBJAM/Hito 3/Dibujos/Fuente3V3.png

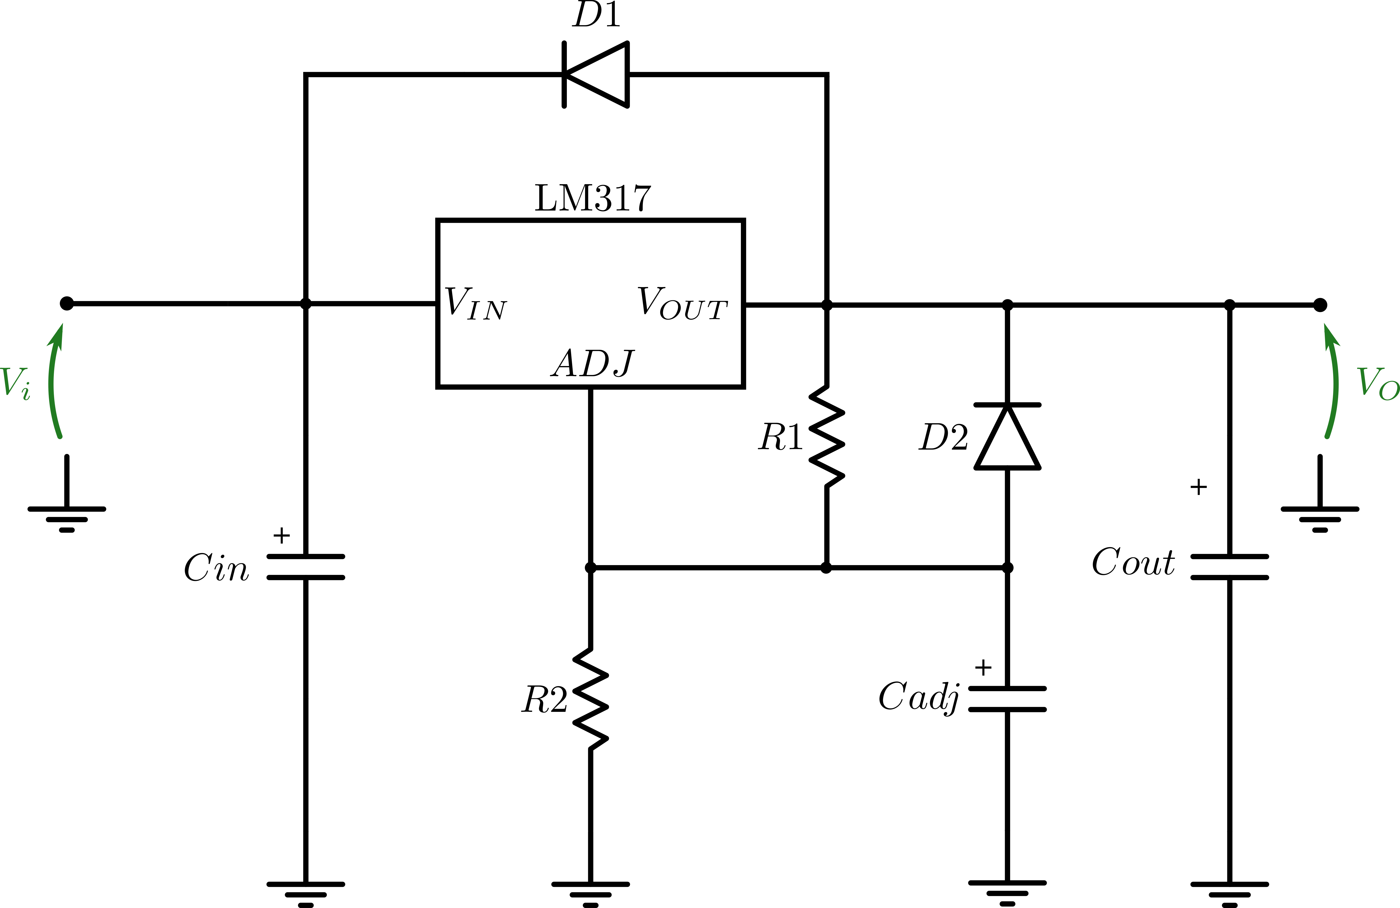
Hito 3/Dibujos/Fuente3V3.png
