mregueira/DisenioBJAM/Hito 3/Dibujos/LM317HV-5V.png

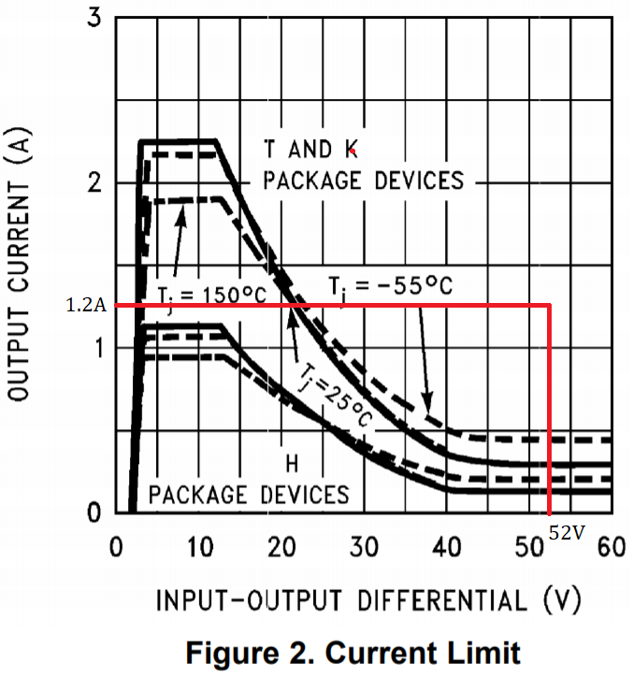
Hito 3/Dibujos/LM317HV-5V.png
