mregueira/DisenioBJAM/Hito 3/Dibujos/LM317HV-24V.png

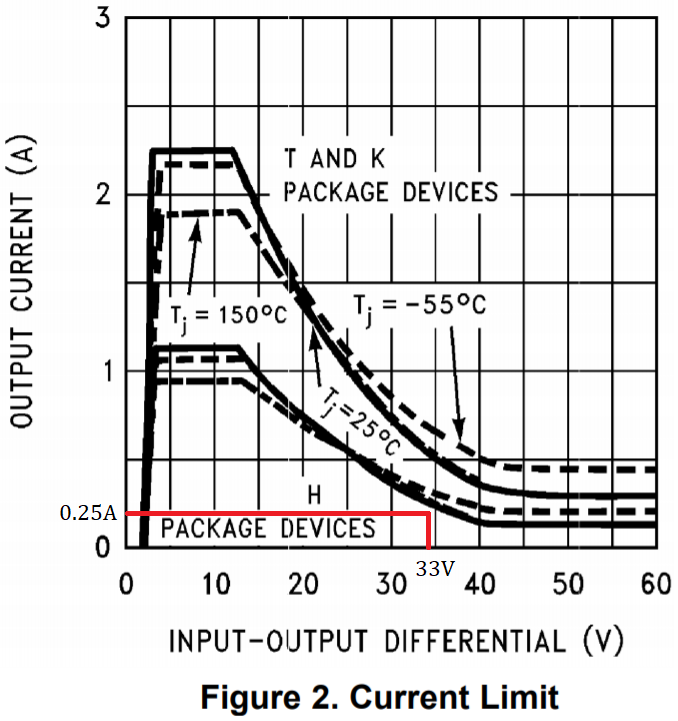
Hito 3/Dibujos/LM317HV-24V.png
