mregueira/DisenioBJAM/Hito 3/Dibujos/TIP127Limite24.png

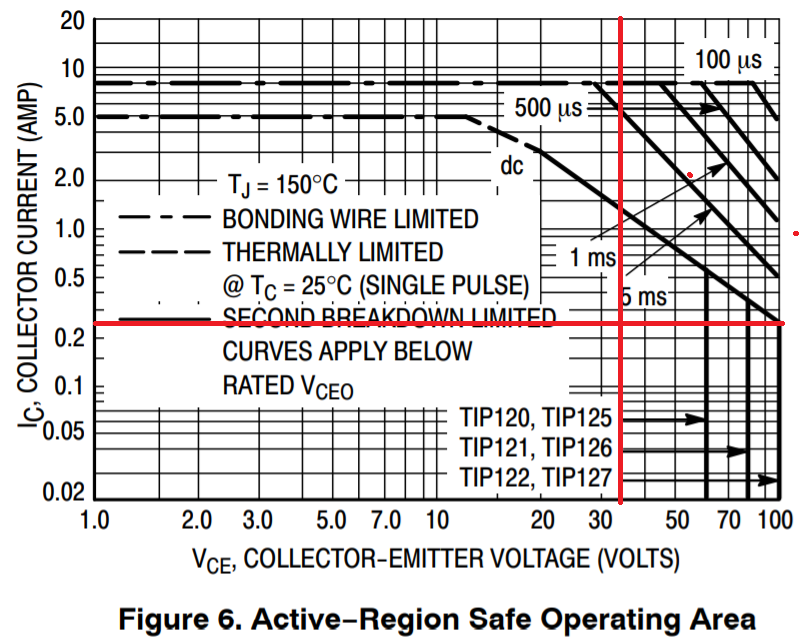
Hito 3/Dibujos/TIP127Limite24.png
