mregueira/DisenioBJAM/Hito 3/Dibujos/Untitled.png

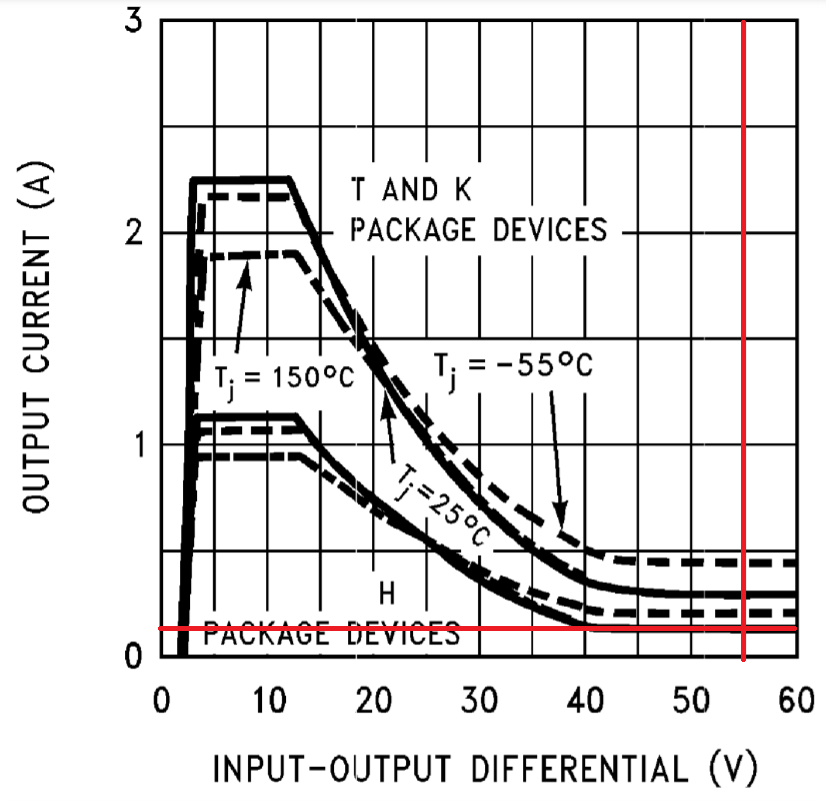
Hito 3/Dibujos/Untitled.png
