mregueira/DisenioBJAM/Hito 3/ToLeandro/ControladorPOE.jpg

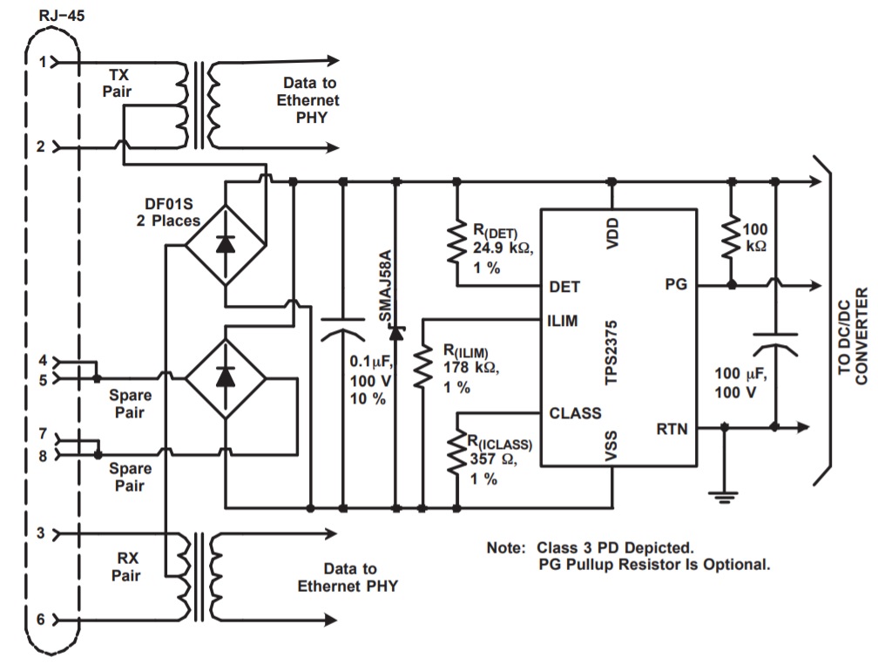
Hito 3/ToLeandro/ControladorPOE.jpg
