mregueira/DisenioBJAM/Hito 3/ToLeandro/Pedal_AcopleEntrada.jpg

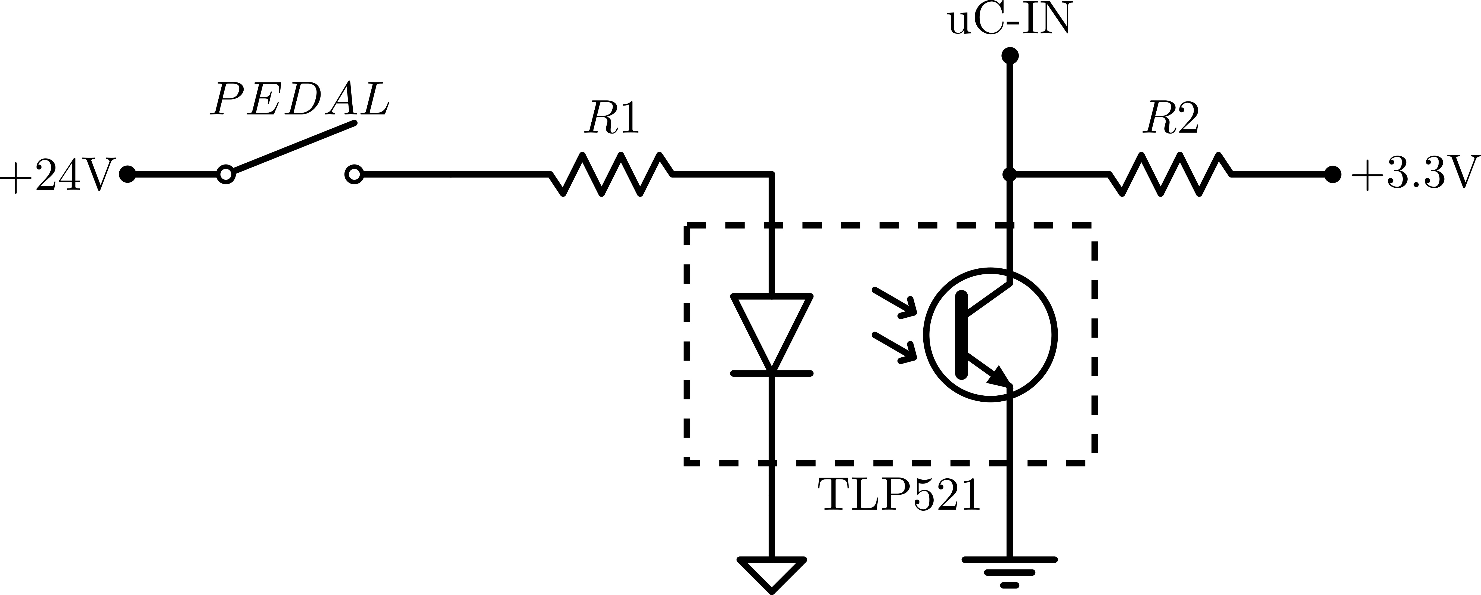
Hito 3/ToLeandro/Pedal_AcopleEntrada.jpg
