mregueira/DisenioBJAM/Hito 4/Esquemas/EA-SinCon.png

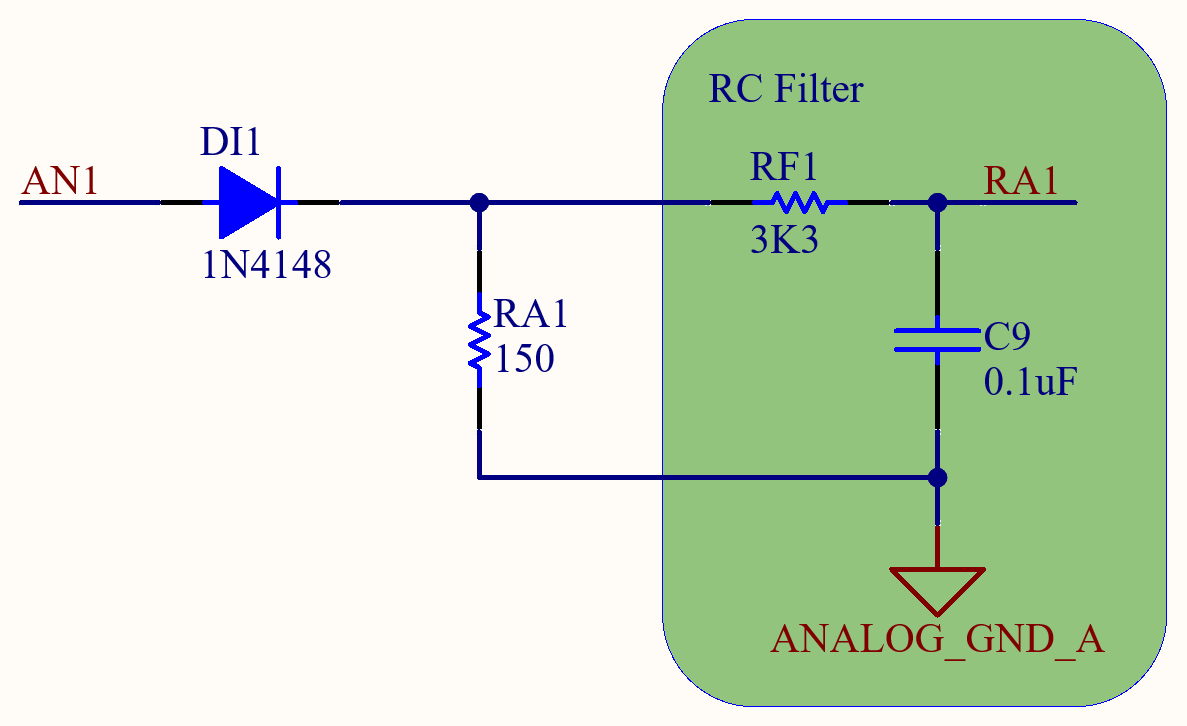
Hito 4/Esquemas/EA-SinCon.png
