mregueira/DisenioBJAM/Hito 4/Esquemas/ExportedSch/Calibres-1.png

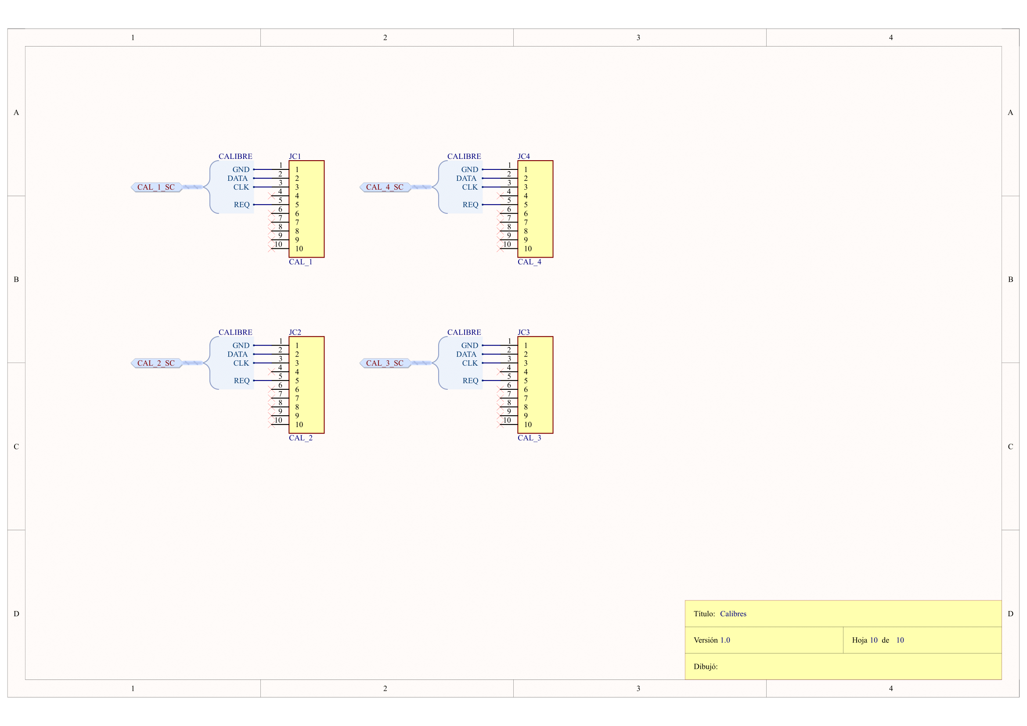
Hito 4/Esquemas/ExportedSch/Calibres-1.png
