mregueira/DisenioBJAM/Hito 4/Esquemas/ExportedSch/ComandosExt-1.png

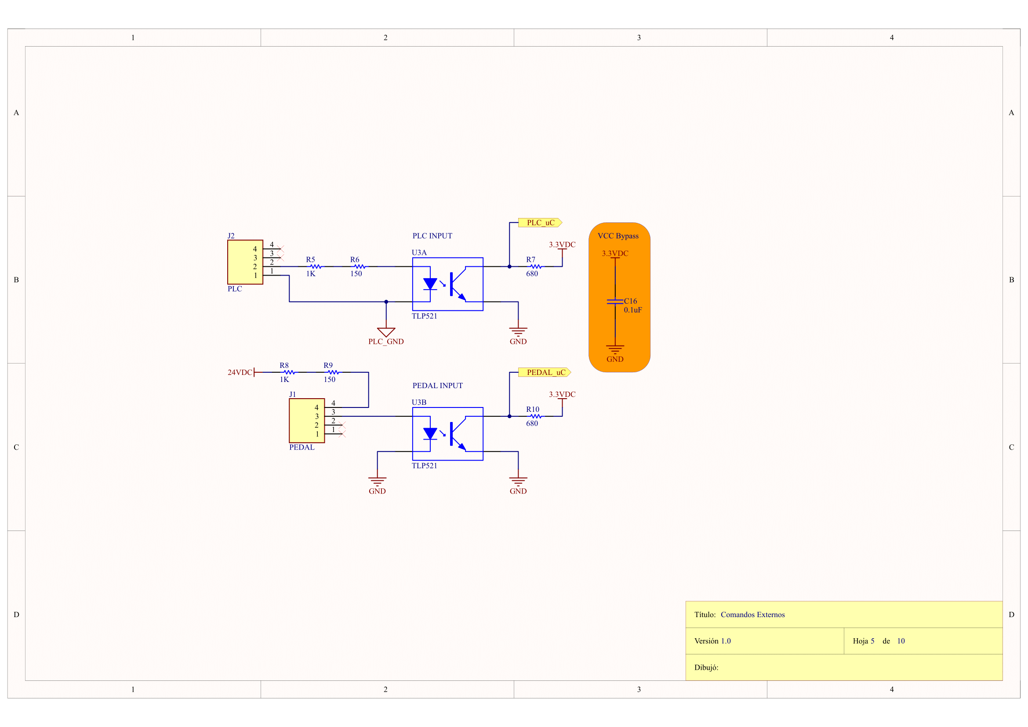
Hito 4/Esquemas/ExportedSch/ComandosExt-1.png
