mregueira/DisenioBJAM/Hito 4/Esquemas/ExportedSch/COMECA-Main-1.png

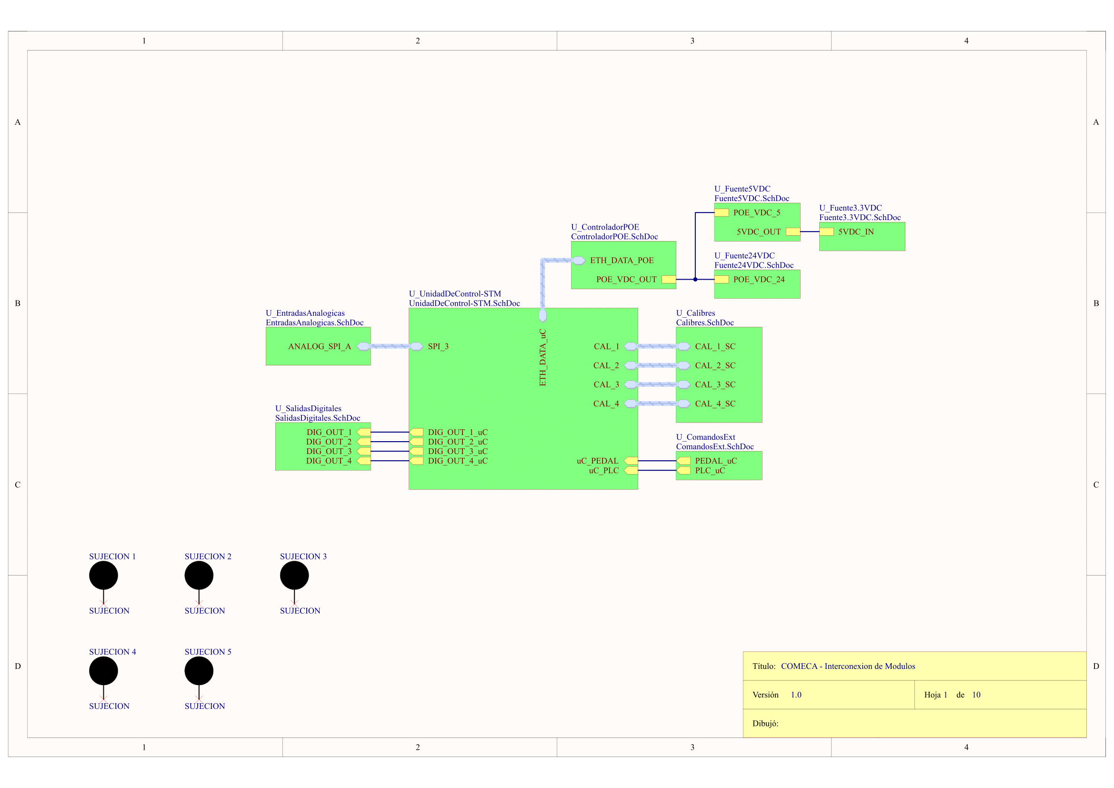
Hito 4/Esquemas/ExportedSch/COMECA-Main-1.png
