mregueira/DisenioBJAM/Hito 4/Esquemas/ExportedSch/ControladorPOE-1.png

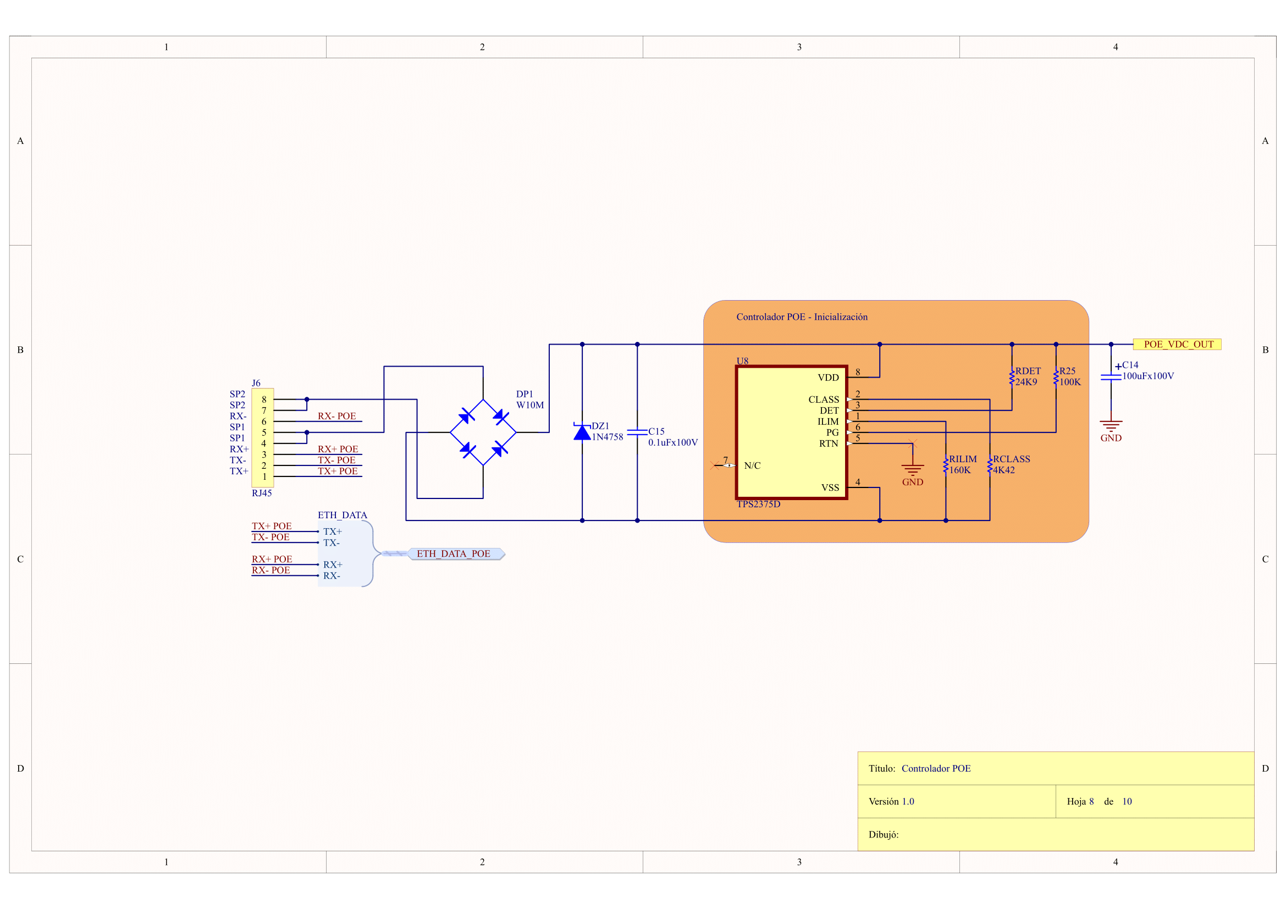
Hito 4/Esquemas/ExportedSch/ControladorPOE-1.png
