mregueira/DisenioBJAM/Hito 4/Esquemas/ExportedSch/EntradasAnalogicas-1.png

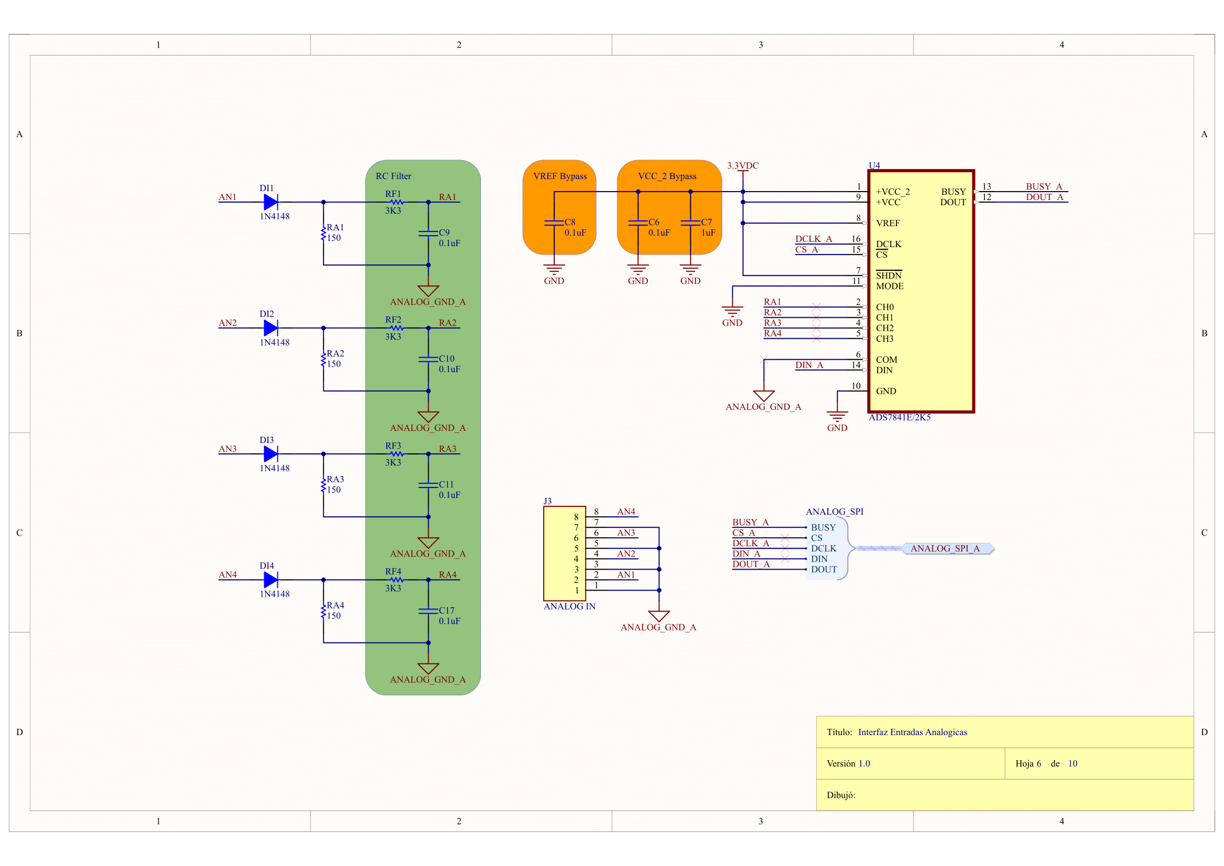
Hito 4/Esquemas/ExportedSch/EntradasAnalogicas-1.png
