mregueira/DisenioBJAM/Hito 4/Esquemas/ExportedSch/Fuente3.3VDC-1.png

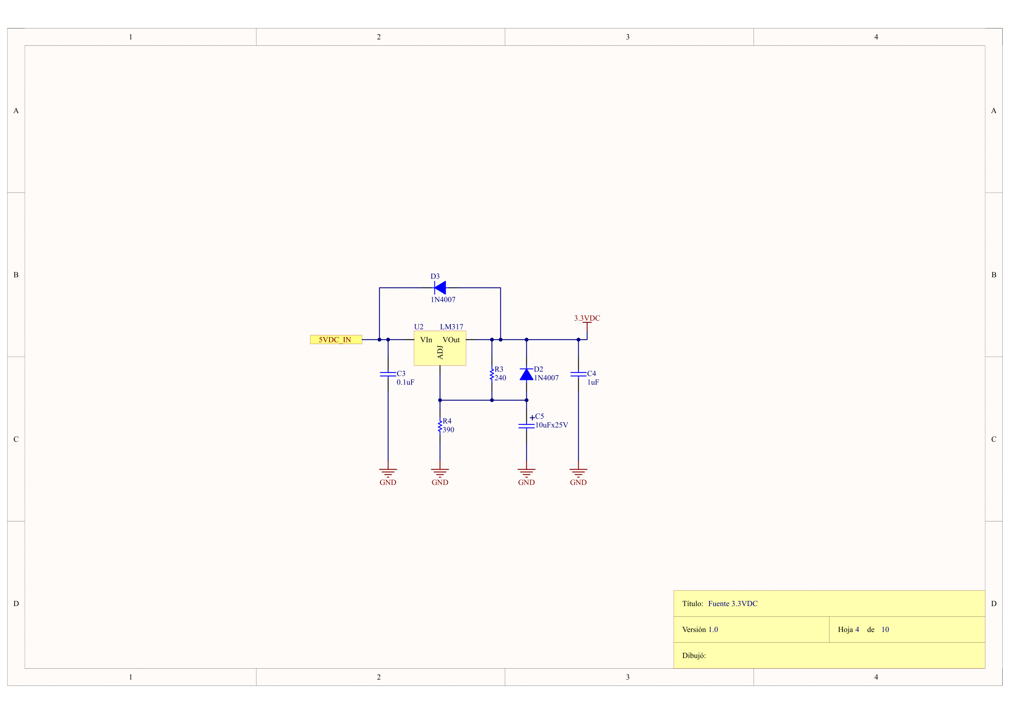
Hito 4/Esquemas/ExportedSch/Fuente3.3VDC-1.png
