mregueira/DisenioBJAM/Hito 4/Esquemas/ExportedSch/Fuente5VDC-1.png

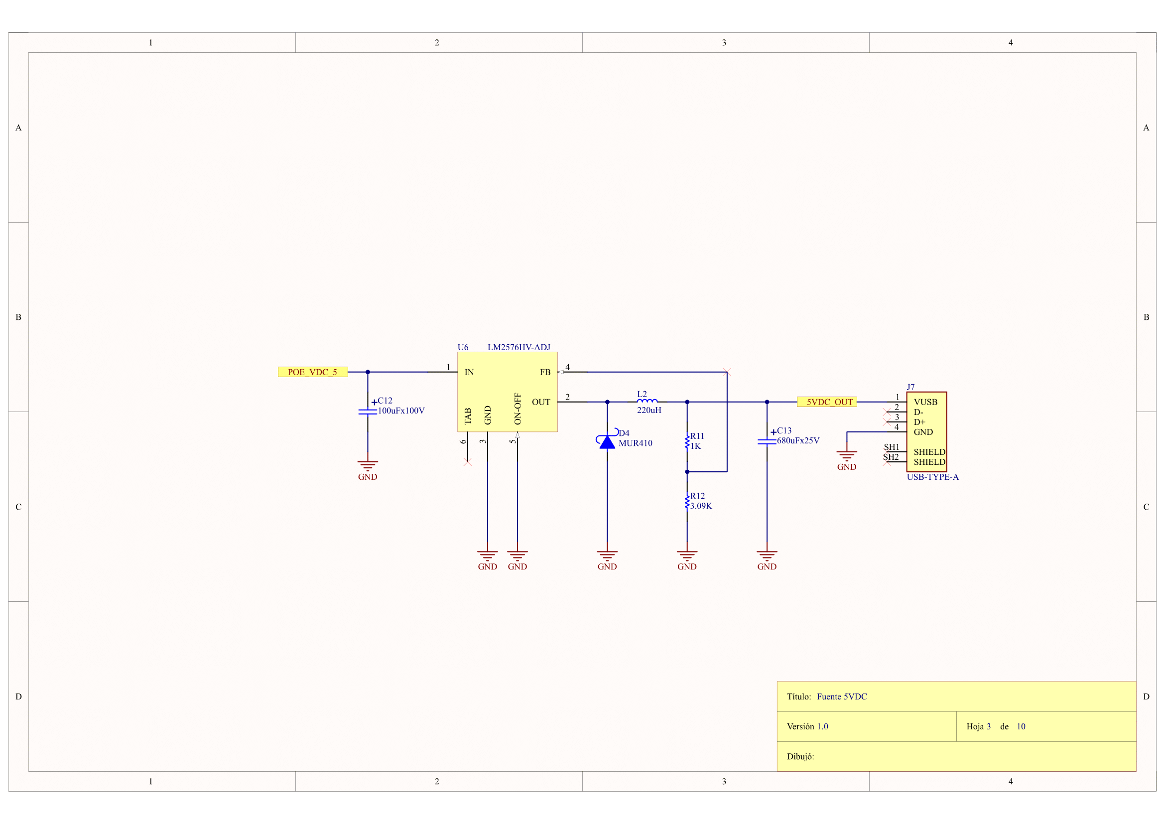
Hito 4/Esquemas/ExportedSch/Fuente5VDC-1.png
