mregueira/DisenioBJAM/Hito 4/Esquemas/ExportedSch/Fuente24VDC-1.png

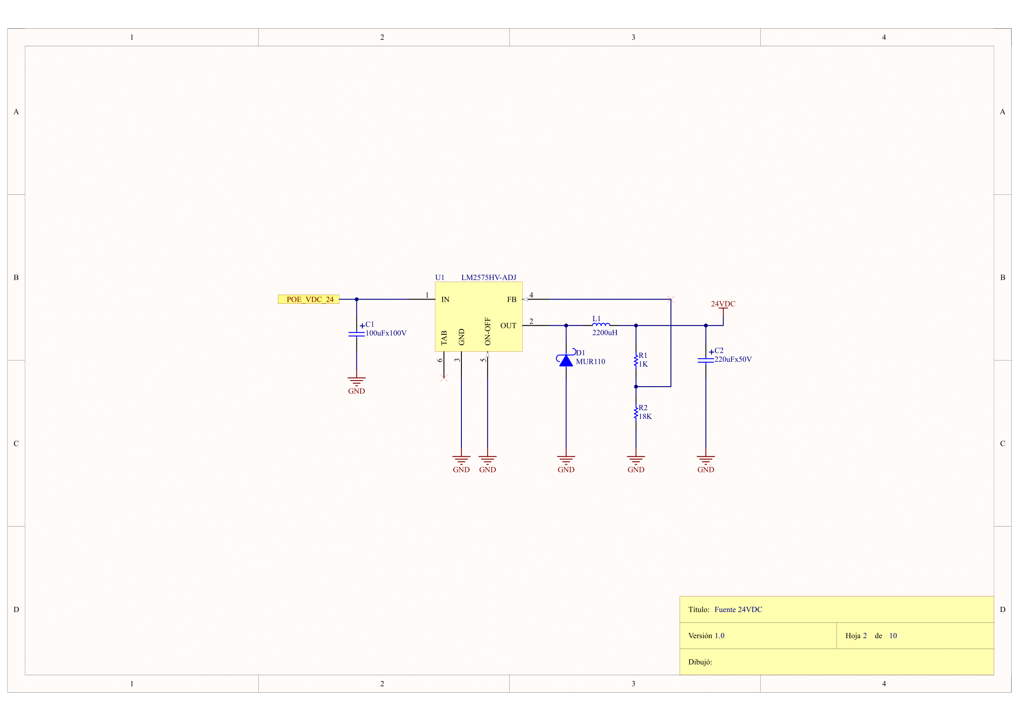
Hito 4/Esquemas/ExportedSch/Fuente24VDC-1.png
