mregueira/DisenioBJAM/Hito 4/Esquemas/ExportedSch/SalidasDigitales-1.png

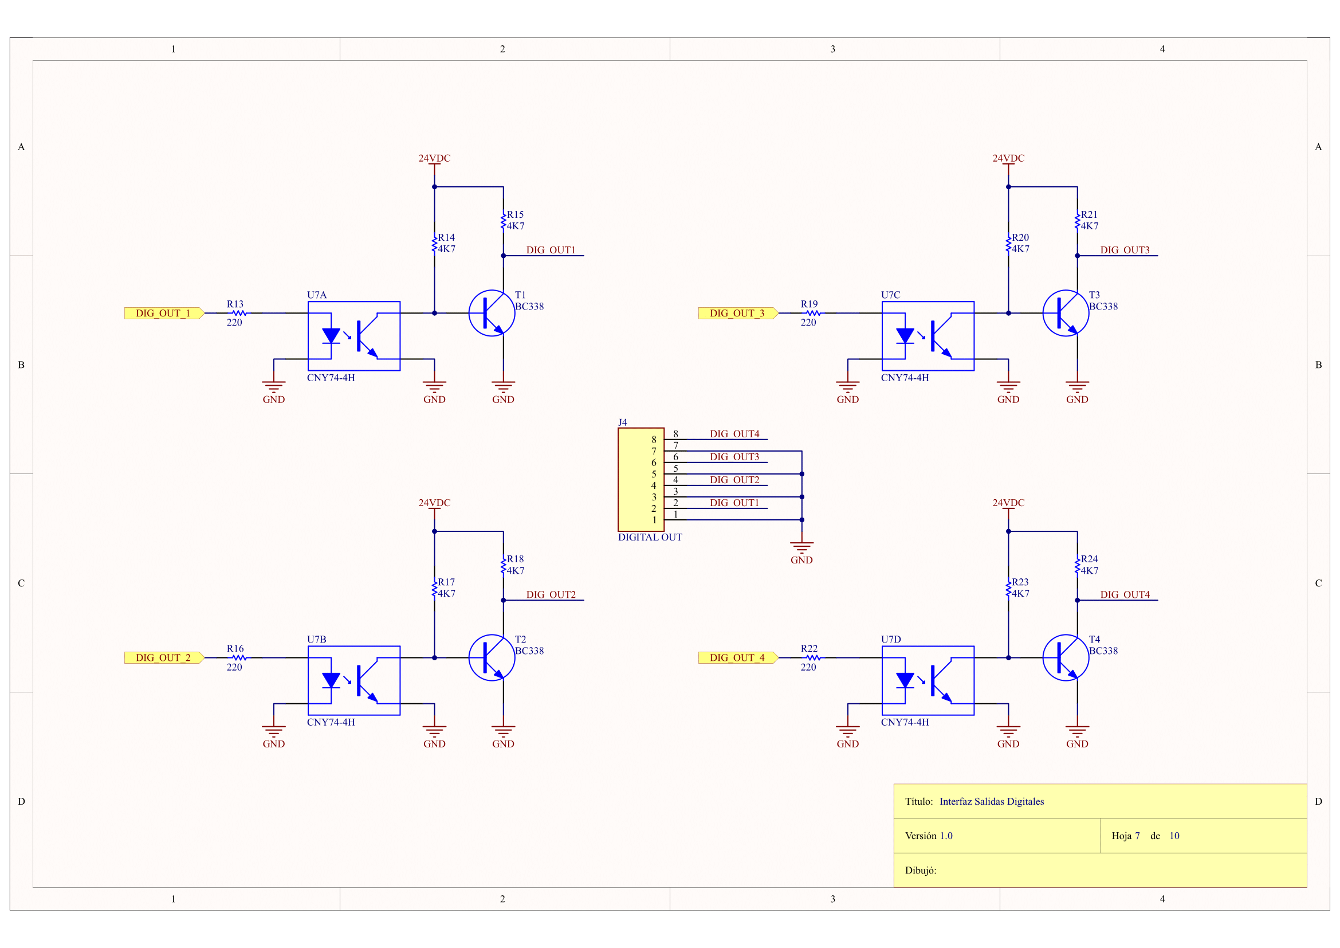
Hito 4/Esquemas/ExportedSch/SalidasDigitales-1.png
