mregueira/DisenioBJAM/Hito 4/Esquemas/ExportedSch/UnidadDeControl-1.png

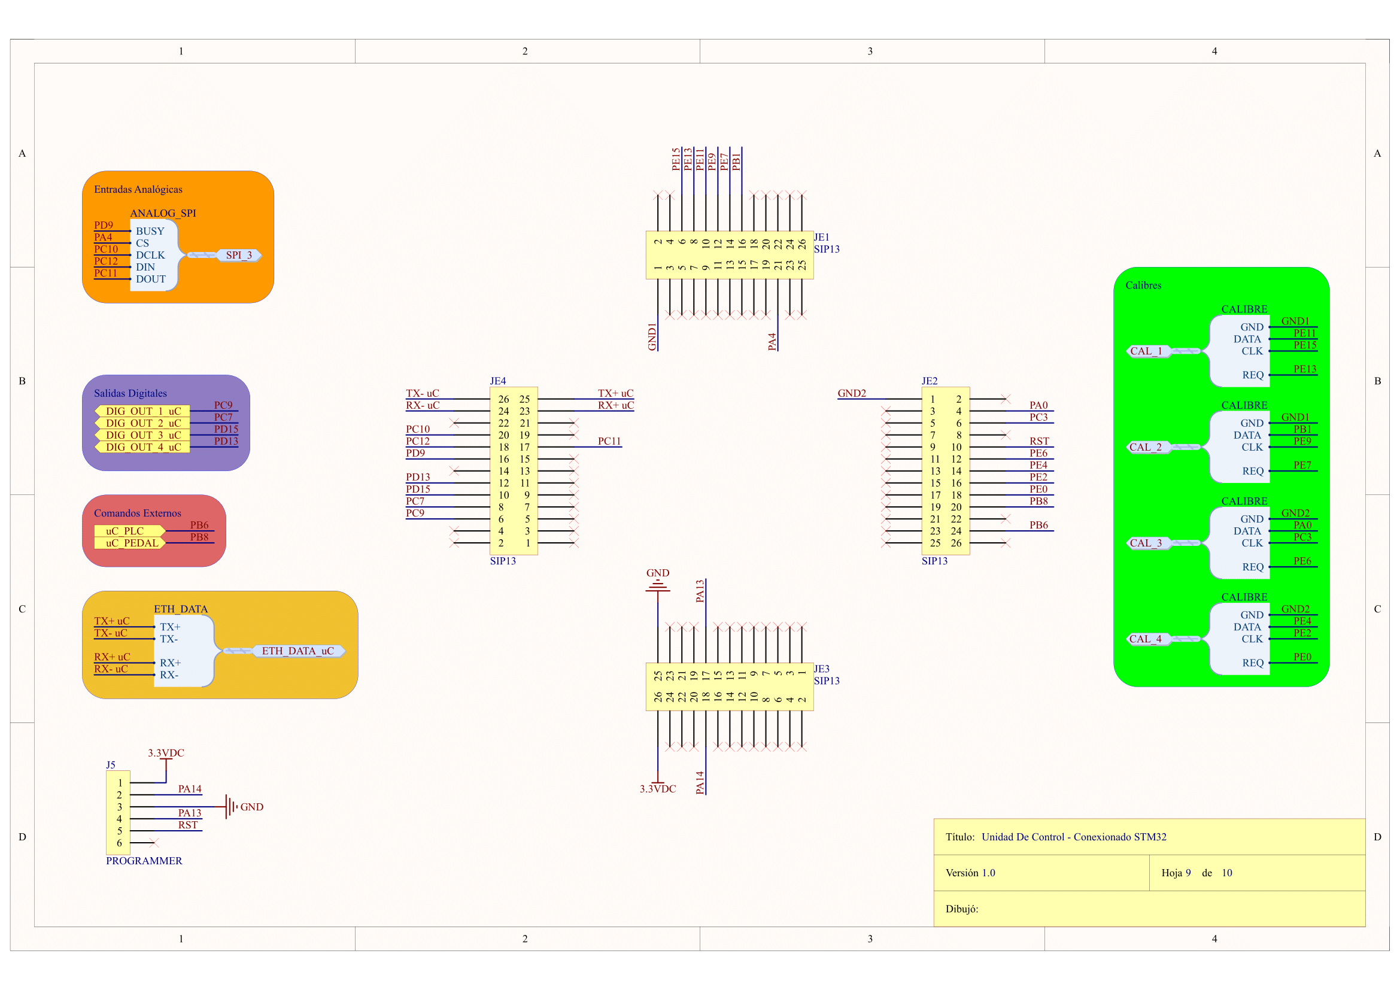
Hito 4/Esquemas/ExportedSch/UnidadDeControl-1.png
