mregueira/DisenioBJAM/Hito 4/Esquemas/PCB_2D.png

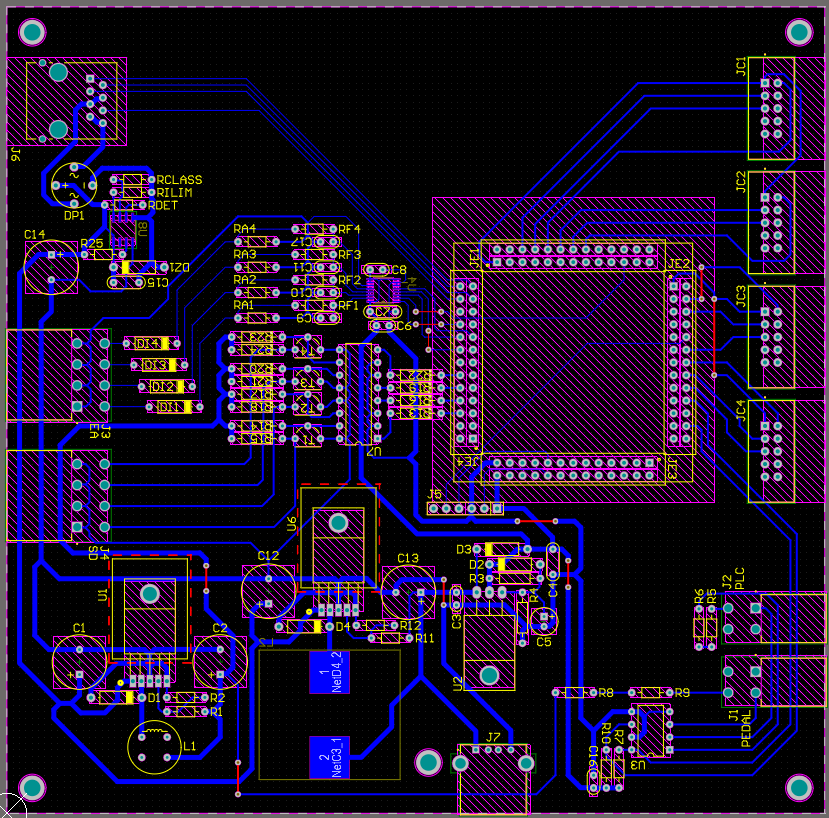
Hito 4/Esquemas/PCB_2D.png
