mregueira/DisenioBJAM/Hito 4/Esquemas/PCB_3D.png

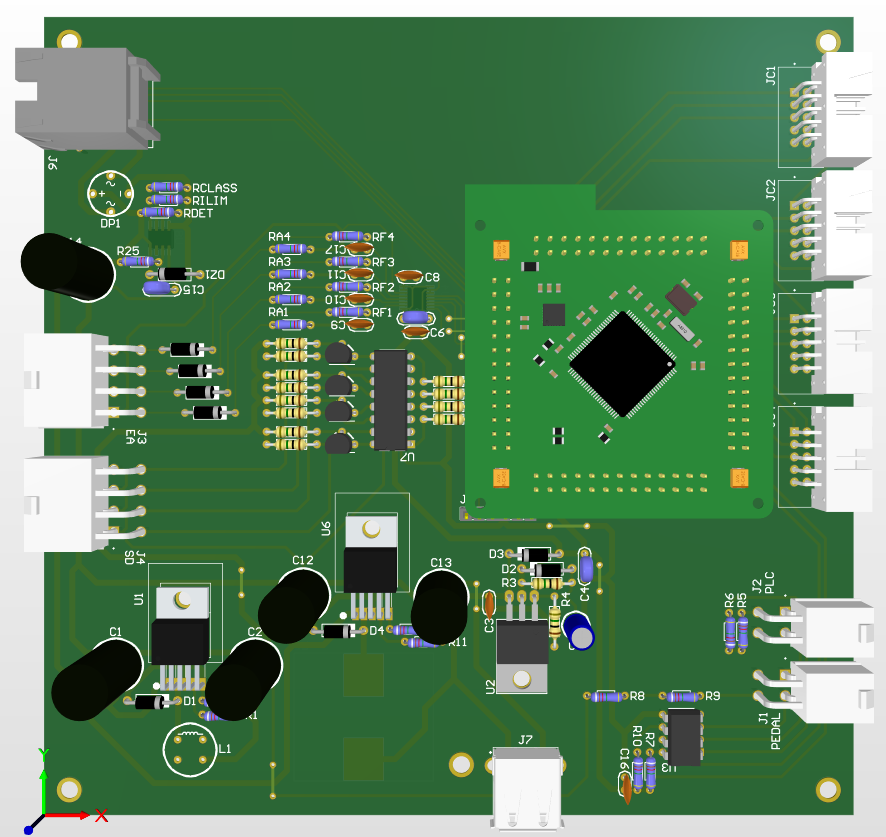
Hito 4/Esquemas/PCB_3D.png
