mregueira/DisenioBJAM/Hito 4/Esquemas/UDC_CMD.png

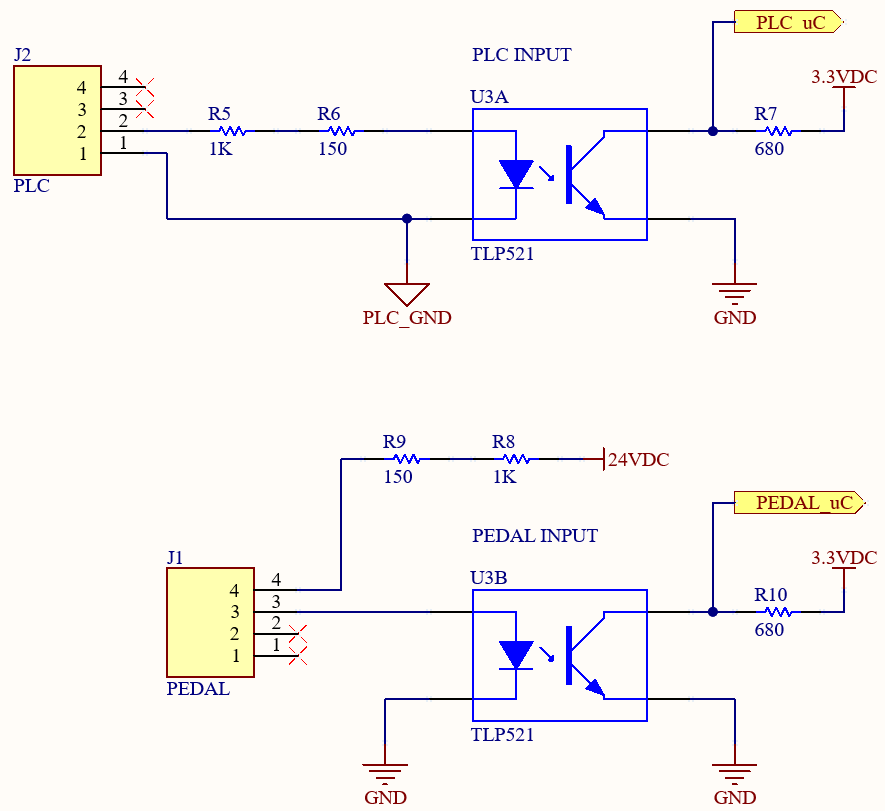
Hito 4/Esquemas/UDC_CMD.png
