mregueira/DisenioBJAM/Hito 4/PinesProgramacion.png

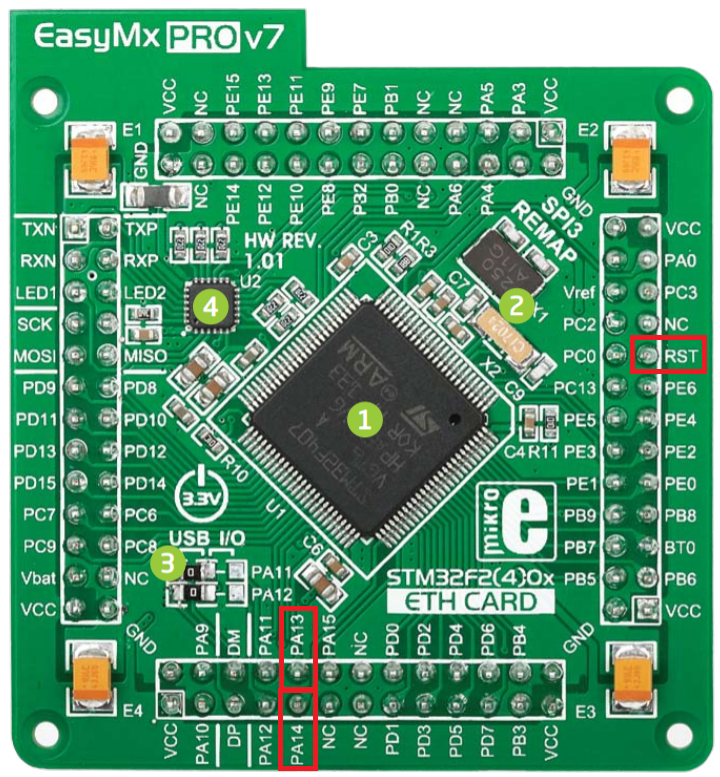
Hito 4/PinesProgramacion.png
