mregueira/DisenioBJAM/Prototipo/COMECA-TestBoard-v2/COMECA-TestBoard/COMECA-TestPCB.html

Altium customize

# Board Information Report

Date: | | 16/9/2021
Time: | | 12:21:42
Elapsed Time: | | 00:00:00
Filename: | | C:\Users\Marcelo\Documents\GitHub\DisenioBJAM\Prototipo\COMECA-TestBoard-v2\COMECA-TestBoard\COMECA-TestPCB.PcbDoc

## Contents

Contents

Routing

Routing Information

## Routing

Routing Information
Routing completion | 100.00%
Connections | 34
Connections routed | 34
Connections remaining | 0

Back to top
