mregueira/DisenioBJAM/Prototipo/COMECA-TestBoard/COMECA-TestBoard/COMECA-TestPCB.txt

Board Information Report
Filename     : C:\Users\Marcelo\Documents\GitHub\DisenioBJAM\Prototipo\COMECA-TestBoard\COMECA-TestBoard\COMECA-TestPCB.PcbDoc
Date         : 8/9/2021
Time         : 10:46:26
Time Elapsed : 00:00:00

Routing Information
    Routing completion, 100.00%
    Connections, 45
    Connections routed, 45
    Connections remaining, 0
count : 4
