mregueira/DisenioBJAM/FMEA-AIAG-3rd-8.5x11-v5.xls

 | Potential
 | Failure Mode and Effects Analysis Worksheet
 |  |  |  |  | Escala 1 a 5 |  | System: COMECA |  |  | RPN < 20: Aceptable
 | FMEA Team: | Bualó, Santiago - Martorell, Ariel - Mestanza, Joaquín - Regueira, Marcelo |  |  | Severity: 1: Menos severo - 5: Más severo |  | Subsystem: - |  |  | RPN >= 20: Bajar hasta estar en Aceptable
 | Team Leader: | Regueira, Marcelo |  |  | Ocurrence: 1: Menos frecuente - 5: Más frecuente |  | Component: -
 |  |  |  |  | Detection: 1: Fácil de detectar - 5: Difícil de detectar
 | Design FMEA |  |  |  |  |  |  |  |  |  | Action Results
 | Item and Function/ Requirements | Potential Failure Mode | Potential Effect(s) of Failure | Severity | Potential Cause(s)/ Mechanism(s) of Failure | Occurrence | Current Controls | Detection | RPN | Recommended Action | Severity | Occurrence | Detection | RPN
1 | Funcionamiento General | El equipo no se conecta a la red local | El equipo no responde a ningún comando remoto | 5 | La interfaz de HW para la conexión ethernet está defectuosa | 2 | (Ninguno) | 2 | 20 | Cambio de diseño: agregar LED indicador de conexión a la red. | 5 | 2 | 1 | 10
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
