mregueira/DisenioBJAM/FMEA-AIAG-3rd-8.5x11-v3.xls

 | Potential
 | Failure Mode and Effects Analysis Worksheet
 |  |  |  |  |  |  | System |  |  | RPN < 20: Aceptable
 | FMEA Team: |  |  |  | Escala 1 a 5 |  | Subsystem |  |  | RPN >= 20: Bajar hasta estar en Aceptable
 | Team Leader: |  |  |  | 1: Menos severo - 5: Más severo |  | Component
 | Design FMEA |  |  |  |  |  |  |  |  |  | Action Results
 | Item and Function/ Requirements | Potential Failure Mode | Potential Effect(s) of Failure | Severity | Potential Cause(s)/ Mechanism(s) of Failure | Occurrence | Current Controls | Detection | RPN | Recommended Action | Severity | Occurrence | Detection | RPN
1 | POE (Alimentación) | El switch no presenta alimentación a nuestro equipo | El equipo no enciende | 3 | El cable entre el switch y el equipo está defectuoso, no tiene la longitud adecuada | 2 | (Ninguno) | 5 | 30 | Cambio de diseño: LED indicador de encendido en el equipo. Si el LED indicador del equipo no está encendido, debe reemplazarse el cable. Se contempla que el switch disponde de indicador de encendido propio. | 3 | 2 | 3 | 18
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
