mregueira/DisenioBJAM/FMEA-AIAG-3rd-8.5x11-v1.xls

 | Potential
 | Failure Mode and Effects Analysis Worksheet
 |  |  |  |  |  |  | System |  |  |  |  | FMEA Number:
 | FMEA Team: |  |  |  |  |  | Subsystem |  |  |  | FMEA Date: (Original)
 | Team Leader: |  |  |  |  |  | Component |  |  |  | (Revised)
 | Design FMEA |  |  |  |  |  |  |  |  |  |  | Action Results
 | Item and Function/ Requirements | Potential Failure Mode | Potential Effect(s) of Failure | Severity | Potential Cause(s)/ Mechanism(s) of Failure | Occurrence | Current Controls | Detection | RPN | Recommended Action | Responsibility and Target Completion Date | Action Taken | Severity | Occurrence | Detection | RPN
1 | POE (Alimentación) | El switch no presenta alimentación a nuestro equipo | El equipo no enciende | 3 | El cable entre el switch y el equipo está defectuoso | 2 | (Ninguno) | 5 | 30 |  |  |  |  |  |  | 0
2 | Transmisión de medición | Transmisión errónea de la medición | El operario interpreta erróneamente el valor de medida de la pieza | 5 | La trama de datos sufrió una modificación debido a ruido eléctrico en el ambiente industrial | 2 | (Ninguno) | 2 | 20 |  |  |  |  |  |  | 0
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
