mregueira/DisenioBJAM/FMEA-AIAG-3rd-8.5x11-v2.xls

 | Potential
 | Failure Mode and Effects Analysis Worksheet
 |  |  |  |  |  |  | System |  |  | RPN < 16: Aceptable |  | FMEA Number:
 | FMEA Team: |  |  |  |  |  | Subsystem |  |  | RPN >= 16: Bajar hasta estar en Aceptable | FMEA Date: (Original)
 | Team Leader: |  |  |  |  |  | Component |  |  |  | (Revised)
 | Design FMEA |  |  |  |  |  |  |  |  |  |  | Action Results
 | Item and Function/ Requirements | Potential Failure Mode | Potential Effect(s) of Failure | Severity | Potential Cause(s)/ Mechanism(s) of Failure | Occurrence | Current Controls | Detection | RPN | Recommended Action | Responsibility and Target Completion Date | Action Taken | Severity | Occurrence | Detection | RPN
1 | POE (Alimentación) | El switch no presenta alimentación a nuestro equipo | El equipo no enciende | 3 | El cable entre el switch y el equipo está defectuoso | 2 | (Ninguno) | 5 | 30 | Revisar el cable POE. | - | Se reemplazó el cable. | 1 | 2 | 5 | 10
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
