mregueira/DisenioBJAM/(threads)

Thread 10 (2021-07-21):

[SW] Salidas Digitales: Probar codigo que se ejecuta despues interrupcion activar salida

jmestanza, 2021-07-21:
Para este tipo de pruebas, como no tenemos lo de Ethernet, vamos a generar el codigo que se llama cuando llega la interrupción.

jmestanza, 2021-07-21:
done
https://github.com/mregueira/DisenioBJAM/commit/b790703a1f2c45941bda487e90609be3dcc8ca65

Closed 2021-07-21.

Thread 2 (2021-07-21):

[HW] Hacer placa prueba

mregueira, 2021-07-21:
Incluye:
- las conexiones de ethernet normales
- las conexiones del programador
- las conexiones para calibre (con 1 es suficiente)

mregueira, 2021-07-23:
ya hice el esquematico

mregueira, 2021-07-24:
ya rutie el pcb

mregueira, 2021-08-12:
Ya la hice.

Closed 2021-08-12.

Thread 3 (2021-07-21):

[SW] Calibres - Protocolo (con analog)

mregueira, 2021-07-21:
Hay que hacer el protocolo de los calibres. Había lo que encontramos para arduino que hay que traducir a C.

jmestanza, 2021-07-22:
Para esta parte con el analog en la parte de Patterns se puede fakear el Calibre y se puede probar el codigo. Para esta parte necesitariamos un CLK, DATA y REQ (lo generamos todo con eso).
En el caso de verdad, REQ es una entrada del calibre.
En este caso, el REQ actua como una senial de sincronismo para el micro --> en el caso de verdad esto cambia.

jmestanza, 2021-08-03:
Probado, funciona. Ahora queda probar con los calibres y la placa de prueba

Closed 2021-08-03.

Thread 5 (2021-07-21):

[SW] Ethernet - Protocolo

mregueira, 2021-07-21:
Ya probado lo basico (#4 ), hay que armar un protocolo para los diferentes mensajes, basicamente es lo de los diagramas:
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

Resumiendo:
- Mensaje de pieza contada por PLC (Tx a Servidor)
- Valor de medicion tomada por calibre x (Tx a Servidor)
- Salida digital a activar (Rx del Servidor)
- Entrada analogica a medir (Rx del Servidor y despues Tx al servidor de la medicion)

Closed 2021-12-05.

Thread 7 (2021-07-21):

[HW] Placa COMECA - Test 1: POE

mregueira, 2021-07-21:
Teniendo la placa en mano (#6 ) la idea es probar por partes.
En esta primera, soldar únicamente lo del controlador PoE y probar. Si hay 48V todo bien y podemos seguir.

mregueira, 2022-01-19:
Test Ok, despues de maquinar mucho. Hubo que modificar un poco el circuito de POE.-

Closed 2022-01-19.

Thread 8 (2021-07-21):

[HW] Placa COMECA - Test 2: POE + Fuentes

mregueira, 2021-07-21:
Teniendo el PoE funcionando (#7 ), soldar las 3 fuentes y medir (además de verficar que los leds se prenden)

mregueira, 2022-01-19:
Test Ok. No hubieron problemas significativos. Separe bien los pines de los integrados de DCDC y les puse aislante encima, de ambos lados. Resultados en un Doc llamado Validacion, en el repo.-

Closed 2022-01-19.

Thread 9 (2021-07-21):

[HW] Placa COMECA - Test 3: Periféricos + uC

mregueira, 2021-07-21:
Si las fuentes andan (#8 ), queda soldar todo lo demás. Volver a probar todo junto sin la placa del uC. Luego con la placa del uC.

mregueira, 2022-01-19:
Test Ok. No hubo problemas para destacar. Puede que reste verificar que el mapeo de datos digitales a corrientes 4-20mA este bien.-

Closed 2022-01-19.

Thread 12 (2021-07-22):

[SW] Calibres - Protocolo (con calibre)

jmestanza, 2021-07-22:
Probar el software implementado en #3 pero teniendo los calibres digitales obtenidos en #13

mregueira, 2021-08-16:
Probamos eso y funciono todo ok, el pinout estaba ok tambien. Falta generalizar para los otros calibres. Recordar REQ va en estado Output Open Drain. Commit #53f93810cc698f4f71ef4fe85873198e9d5c0fcc

jmestanza, 2021-08-16:
https://github.com/mregueira/DisenioBJAM/commit/53f93810cc698f4f71ef4fe85873198e9d5c0fcc

Closed 2021-08-16.

Thread 15 (2021-09-18):

[SW] Integrar la configuración de Ethernet

jmestanza, 2021-09-18:
Integrar la configuración en la branch release-0.0.0 hecha por @mregueira en
[https://github.com/mregueira/DisenioBJAM/tree/release-0.0.0/Prototipo/EthernetTest-v3](https://github.com/mregueira/DisenioBJAM/tree/release-0.0.0/Prototipo/EthernetTest-v3)

Closed 2021-09-23.

Thread 17 (2021-09-18):

[SW] Armar cliente udp y probar enviar mensajes por Ethernet

jmestanza, 2021-09-18:
Realizar algo muy similar a este video [https://youtu.be/Kc7OHc7JfRg](https://youtu.be/Kc7OHc7JfRg).
Probar enviar mensajes y que se reciban en un cliente hecho con el software que muestran en el video

Closed 2021-09-23.

Thread 18 (2021-09-18):

[SW] Armar protocolo de mensajes de Ethernet

jmestanza, 2021-09-18:
En base a lo que describimos en el informe, escribir un protocolo de los mensajes que mandamos por Ethernet en formato String.

Sería algo como:

MESSAGE_TYPE | DATA

Puede haber mensajes que no tengan data asociada

jmestanza, 2021-11-01:
lo hacemos con JSON, en el repo hay ejemplos

Closed 2021-11-01.

Thread 22 (2021-11-11):

[HW] Cambios a la nueva placa

amartorell, 2021-11-11:
Cambiar:
 - [x] Patitas de fuente 5V y 24V
 - [x] Conector ethernet
 - [x] Agregar testpoint para tensiones
 - [x] Footprint del MUR410
 - [x] Resistencia de pull down a las salidas de control digital (ahora que sabemos que anda no hace falta)
 - [x] Resistencias pull up ethernet PHY
 - [x] Resistencia de pull down a pedal y PLC
 - [x] Puentear masas del integrado ADS7841
 - [x] Averiguar con las aplication note como hacer el ruteo de las pistas de ethernet para que tome 100Mbps
 - [x] Revisar footprint de los SMD

mregueira, 2022-11-20:
La posta para 100Mbps seria control de impedancia, aparte del ruteo diferencial. Pero para eso la placa tiene que ser de al menos 4 capas y el costo se eleva mucho.

Closed 2022-11-20.

Thread 30 (2022-01-20):

[DOC] Cosas que faltan del informe

mregueira, 2022-01-20:
Cosas que quedan poner en el informe:
- [x] #34
- [x] Agregar foto del pedal (la tengo yo)

--------------------------------------------------------------------------------------------------
Revisión Joaco
**Cosas generales:**
- [x] Pagina 10 - Acronimos - TBD y TBC deberian estar como AC y DC (para ser consistentes)
- [x] Pagina 11 - Resumen - https://puu.sh/IFWHT/a3ad16f952.png, no deberian ser **salidas digitales**?
- [x] Pagina 18 - INT-COM-05 - No pieza presente -> valor nulo -> no tiene sentido, el calibre me responde con lo que mide
- [x] Pagina 24 - Especificaciones de tests - https://puu.sh/IFXzY/a972e60481.png,  13 datos -> son 13 frames de 4 bit cada uno, o sea que son 13 * 4 = 52 bits en total... no tiene mucho sentido querer ver los 52 bits en el osciloscopio (la cuenta  que originalmente hicimos era 13bits * (1/4096) = 3.17ms, por eso pusimos 5ms)
- [x] Pagina 25 - T-PERF05 - "3.	Verificar que se visualiza en ella que la batería se carga en tiempo y forma acordes." --> hicimos mencion de cuanto es "tiempo acorde"?
- [x] Pagina 26 - "REQ-05 Pieza no presente, transmitir valor nulo de medición." lo mismo que en pagina 18 INT-COM-05. REQ -06, lo mismo que pagina 18 INT-COM-06
- [x] Pagina 52 - hay un highlight amarillo, es a proposito? creo que no va
**Software:**
- [x] Pagina 59 - Descripcion de subrutinas - Esto seguramente tenga que ser modificado ya que no se llaman asi las funciones y ahora tenemos las funciones posta para saber que utilizan
- [x] Pagina 60 - Plan de pruebas y de depuracion de software. Cambiaron los nombres y creo que se puede redactar mejor

jmestanza, 2022-02-03:
Pase las tareas no resueltas al issue #36

Closed 2022-02-03.

Thread 31 (2022-01-25):

[MEC] Construccion gabinente

mregueira, 2022-01-25:
- [x] Ver tema de gabinete de plástico para prototipo. Revisar que en el informe lo cambiemos (pq estaba metálico e iría para producto final).
- [x] Definir el prensacable que cumpla la norma IP del gabinete, dependiendo de los agujeros que vamos a hacer => al final van al ras los conectores

mregueira, 2022-03-14:
Done.-

Closed 2022-03-14.

Thread 36 (2022-02-03):

Finalización del Proyecto

jmestanza, 2022-02-03:
**Correciones Informe**
Formato:
- [ ] Sacar pagina en blanco (pag 29)
- [ ] voltaje -> tensión
- [ ] << >>   -> negritas o subrayados => en negrita

Cosas que faltaron especificar:
- [ ] Definir el pasacable que cumpla la norma IP del gabinete
- [ ] Escribir mas en recomendaciones para futuro
- [ ] Escribir conclusiones
- [ ] Factibilidad económica (horas/hombre) -> rehacer
- [ ] DFMEA pocos orígenes de falla
- [ ] Factibilidad tecnológica -> algunos bien y algunos mal
la interfaz de entradas analógicas le llamó la atención
- [ ] Confiabilidad de software
- [ ] Sacar MUSA -> sirve para las etapas iniciales. al final hay que hacer estimaciones en base a mediciones. Rehacer confiabilidad de software.
- [ ] Revisar cuentas de confiabilidad. 95% con las mejoras de hardware la confiabilidad 96.7% -> cumple con las especificaciones?
revisarlo porque en general da mayor a 98%.
- [ ] casa de calidad no existe xd mostrar un nivel de mejora … dice que no hay tecnología equivalente
- [ ] Actualizar factibilidad de tiempos hay que ajustarlo a las nuevas fechas=> corrección -> montecarlo de duración de días, fechas
distribución gaussiana medio equivocada (??)
- [ ] 1.2453  => por más que no representemos (??)
- [ ] warning por arriba o por debajo del calibre --> esto dijo que era una observacion

Otros:
- [ ] Presentacion definitiva

Thread 41 (2022-11-20):

[HW] Cambios a la placa final

mregueira, 2022-11-20:
- [ ] Diodo MUR410 mas grande el agujero y mas corona.
- [ ] Diodos 1N4148 mas grande el agujero.
- [ ] C7 y C4 volver a normal.
- [ ] W10M mas corona.

Thread 44 (2023-05-18):

[HW] MCU Board Issue

mregueira, 2023-05-18:
El filtro le pifie al codigo de JLC, lo tuve que sacar y poner una R de 0R.
