mregueira/DisenioBJAM/Hito 4/ToLeandro/Fuente24VDC.pdf

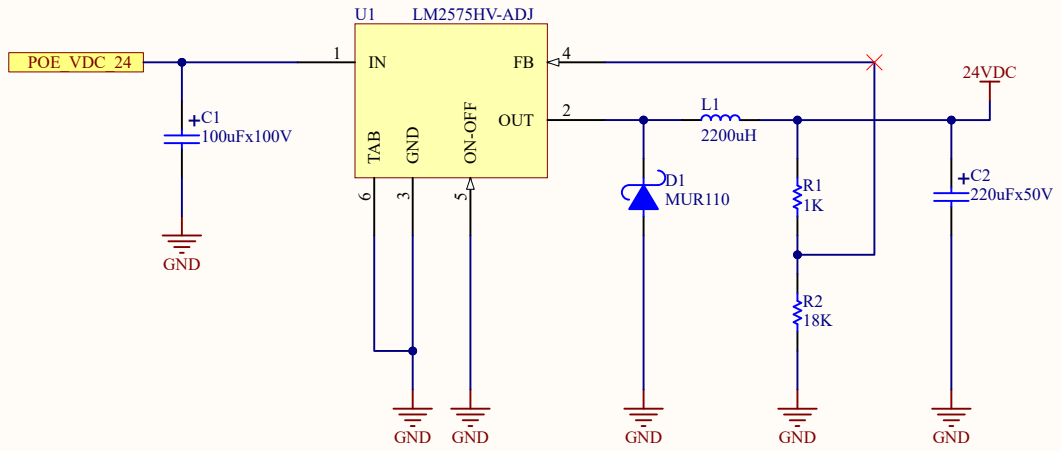
[picture p127: page 1]
Title; Size; Number; Revision; Date:; Sheet of; File:; C:\Users\..\Fuente24VDC.SchDoc; Drawn By:; OUT; 2 GND; 3 ON-OFF; 5 TAB; LM2575HV-ADJ; D1 MUR110; GND GND; GND; +C2 220uFx50V; +C1 100uFx100V; POE_VDC_24; Título:; Versión; Hoja; Dibujó:; Fuente 24VDC; 24VDC
