mregueira/DisenioBJAM/Hito 4/ToLeandro/Fuente3.3VDC.pdf

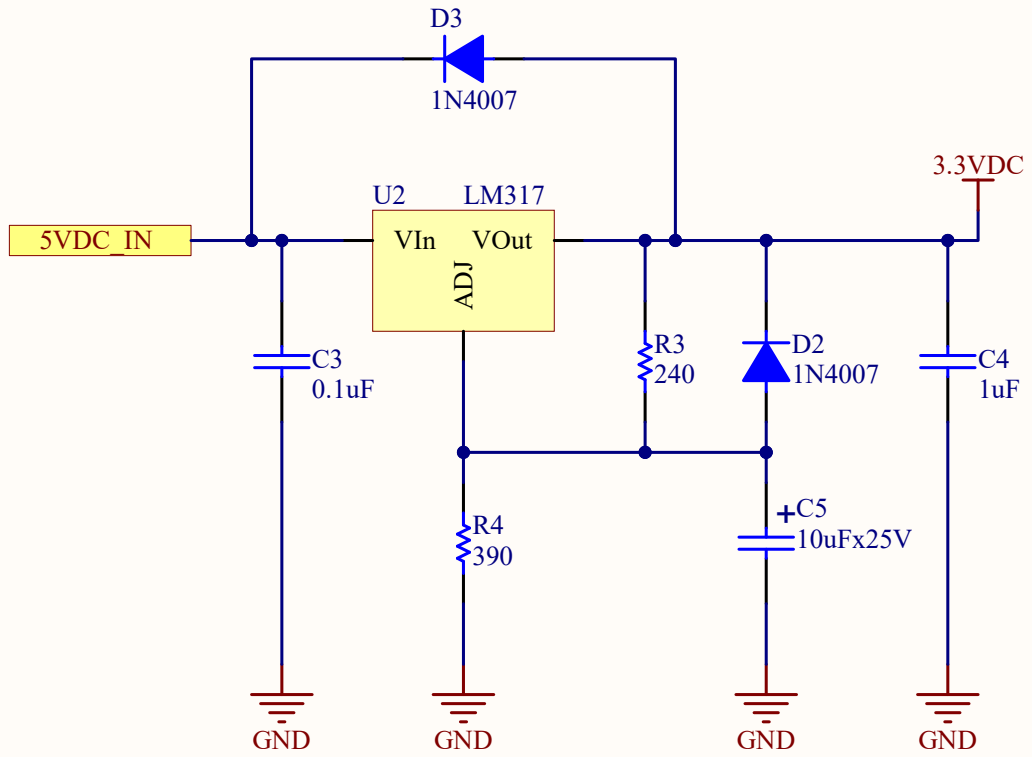
[picture p128: page 1]
Title; Size; Number; Revision; Date:; Sheet of; File:; C:\Users\..\Fuente3.3VDC.SchDoc; Drawn By:; VIn ADJ; VOut; GND; 5VDC_IN; Título:; Versión; Hoja; Dibujó:; Fuente 3.3VDC; +C5 10uFx25V; 3.3VDC
