mregueira/DisenioBJAM/Hito 4/ToLeandro/Fuente5VDC.pdf

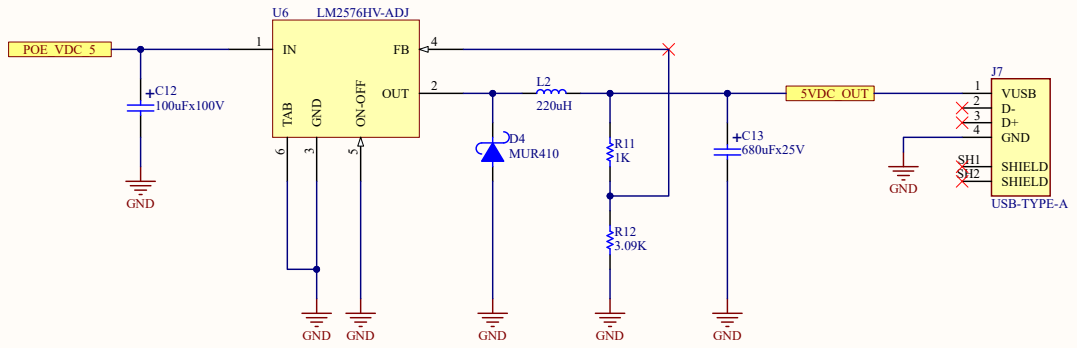
[picture p129: page 1]
Title; Size; Number; Revision; Date:; Sheet of; File:; C:\Users\..\Fuente5VDC.SchDoc; Drawn By:; Título:; Versión; Hoja; Dibujó:; Fuente 5VDC; OUT; 2 GND; 3 ON-OFF; 5 TAB; LM2576HV-ADJ; +C12 100uFx100V; GND; POE_VDC_5; GND GND; D4 MUR410; +C13 680uFx25V; 5VDC_OUT; VUSB 1; D- 2 D+ 3 GND 4; SHIELD SH1 SHIELD SH2; USB-TYPE-A
