mregueira/DisenioBJAM/Hito 4/ToLeandro/UnidadDeControl-uC.pdf

# SIP13 ¹ ² ³ ⁴ ⁵ ⁶ ⁷ ⁸ ⁹ ¹⁰ ¹¹ ¹² ¹³ ¹⁴ ¹⁵ ¹⁶ ¹⁷ ¹⁸ ¹⁹ ²⁰ ²¹ ²² ²³ ²⁴ ²⁵ ²⁶JE1

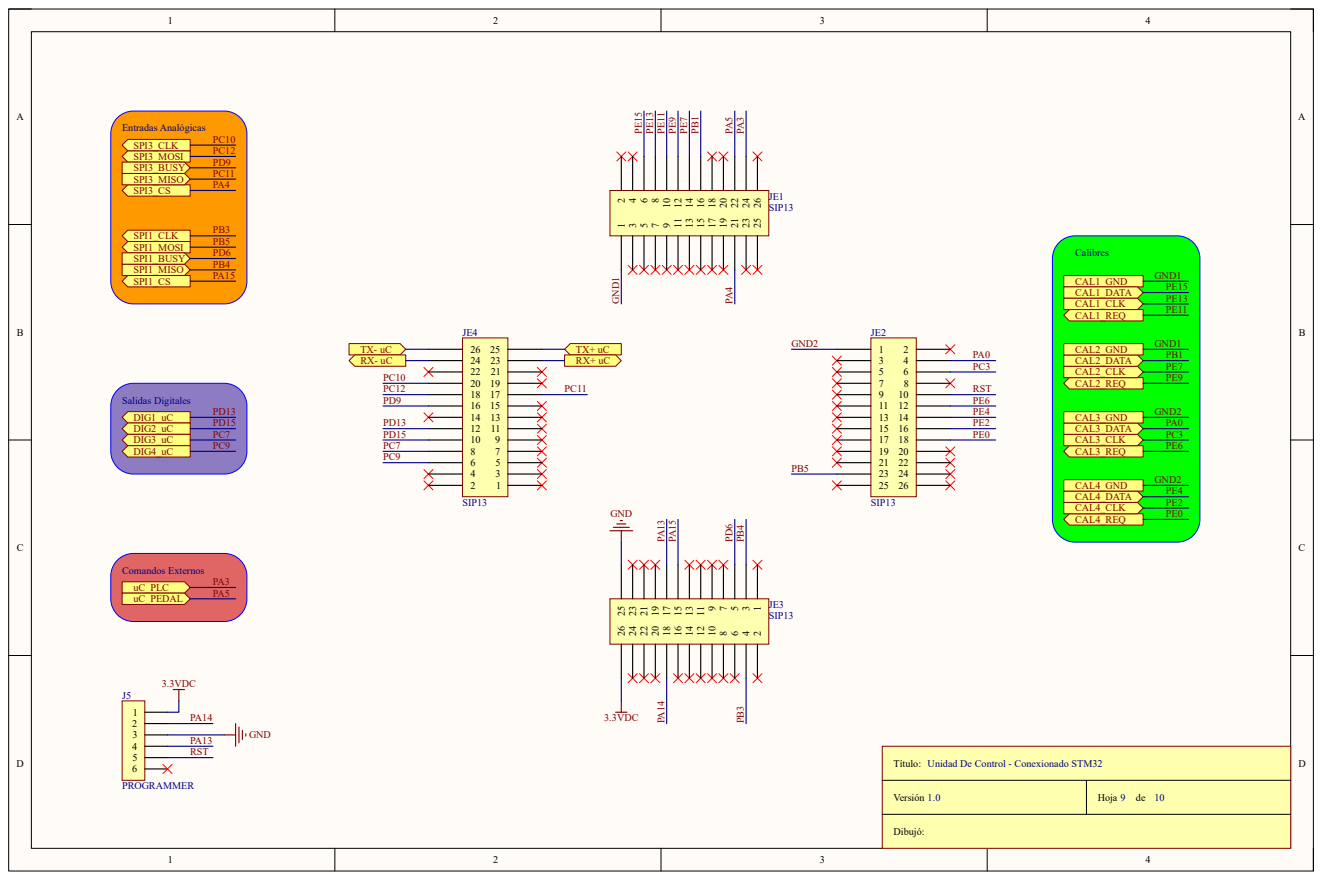
[picture p130: page 1]
Title; Size; Number; Revision; Date:; Sheet of; File:; C:\Users\..\UnidadDeControl-STM.SchDocDrawn By:; Título:; Versión; Hoja; Dibujó:; PROGRAMMER; PA¹³ PA¹⁴; RST; 3.3VDC; GND; GND PA13; PB³ PB⁴; PB5 PA¹⁵; SPI1_CLK SPI1_MOSI; SPI1_MISO SPI1_CS; SPI3_CS; SPI3_MISO; SPI3_MOSI; SPI3_CLK; PA⁴; Entradas Analógicas; CAL1_GND CAL1_DATA CAL1_CLK CAL1_REQ; CAL2_REQ; CAL2_CLK; CAL2_DATA; CAL2_GND; CAL3_REQ; CAL3_CLK; CAL3_DATA; CAL3_GND; CAL4_REQ; CAL4_CLK; CAL4_DATA; Calibres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

CAL4_GND PE¹⁵ PE¹³ PE¹¹

PE9 PE⁹ PE⁷ PB¹

Unidad De Control - Conexionado STM32
