mregueira/DisenioBJAM/Hito 4/Esquemas/ExportedSch/Calibres.pdf

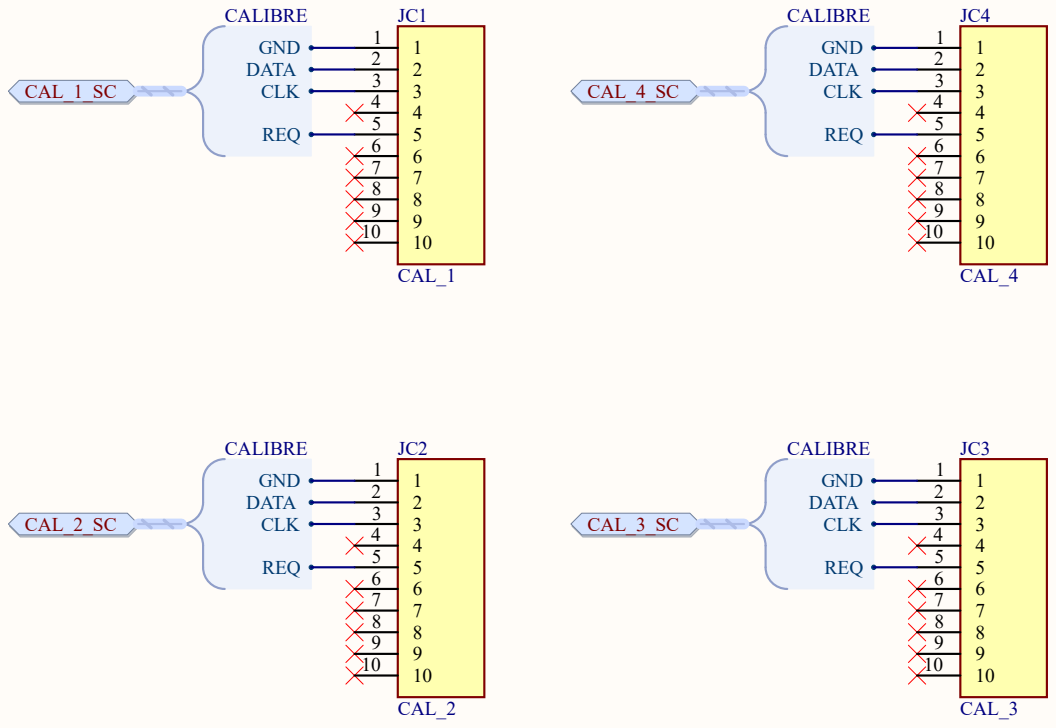
[picture p131: page 1]
Title; Size; Number; Revision; Date:; Sheet of; File:; C:\Users\..\Calibres.SchDoc; Drawn By:; Título:; Versión; Hoja; Dibujó:; Calibres; CAL_1; CAL_2; CAL_4; CAL_3; CLK; DATA; GND; REQ; CALIBRE; CAL_2_SC; CAL_1_SC; CAL_4_SC; CAL_3_SC
