mregueira/DisenioBJAM/Hito 4/Esquemas/ExportedSch/UnidadDeControl.pdf

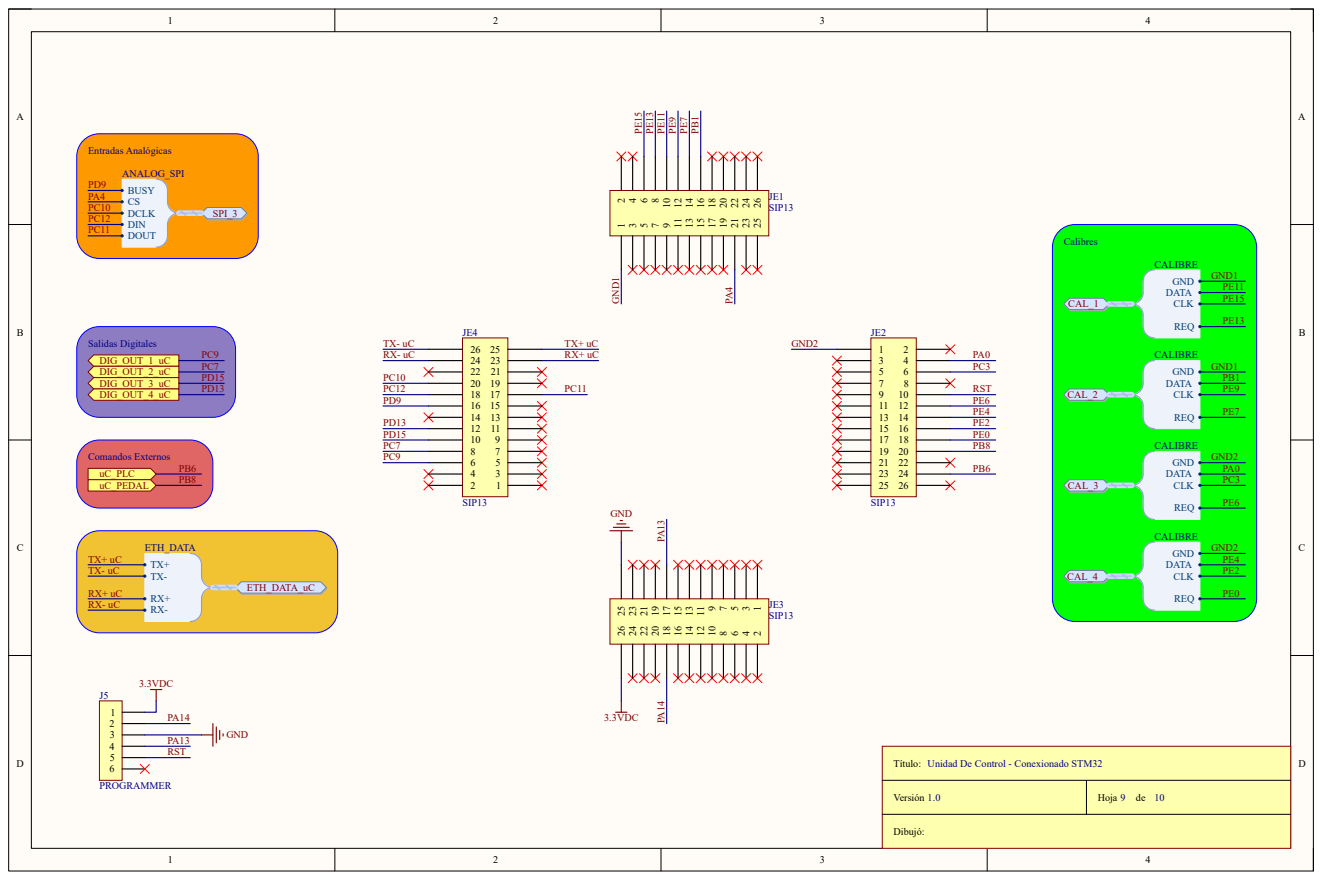
[picture p132: page 1]
Title; Size; Number; Revision; Date:; Sheet of; File:; C:\Users\..\UnidadDeControl-STM.SchDocDrawn By:; Título:; Versión; Hoja; Dibujó:; PROGRAMMER; PA¹³ PA¹⁴; RST; 3.3VDC; GND; GND PA13; PA⁴; Entradas Analógicas; PE¹⁵ PE¹³ PE¹¹; Calibres; DIG_OUT_1_uC DIG_OUT_2_uC DIG_OUT_3_uC; DIG_OUT_4_uC; Salidas Digitales; uC_PLC uC_PEDAL; Comandos Externos; GND1; GND2; GND2 GND¹; 9 10 11 12 13 14 15 16 17 18 19 20 21 22 23 24 25 26JE1 SIP13; SIP13; JE3 SIP13; BUSY CS DCLK DIN DOUT; ANALOG_SPI; SPI_3; CLK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

PE9 PE⁹ PE⁷ PB¹

Unidad De Control - Conexionado STM32
