mregueira/DisenioBJAM/DiagramaValidacion.pdf

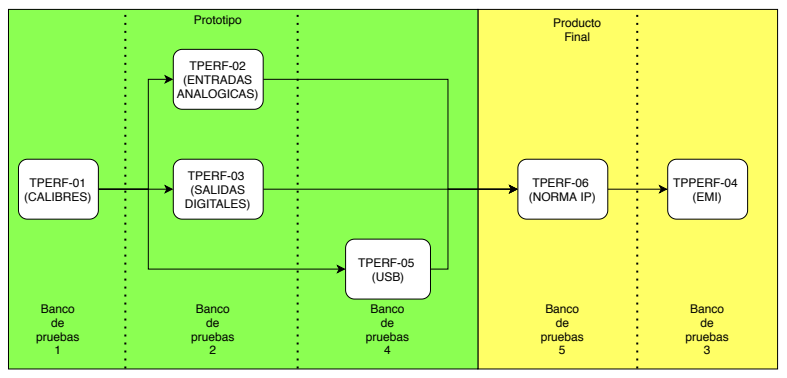
[picture p133: page 1]
TPPERF-04 (EMI); TPERF-01 (CALIBRES); (ENTRADAS ANALOGICAS); TPERF-03 (SALIDAS; TPERF-05; Prototipo; Producto; Final; TPERF-06 (NORMA IP); Banco de pruebas 1; Banco de pruebas 2; Banco de pruebas 3; Banco de pruebas 5

TPERF-02

DIGITALES) | (USB) Banco de pruebas 4
