mregueira/DisenioBJAM/Hito 4/ToLeandro/CmdExternos.pdf

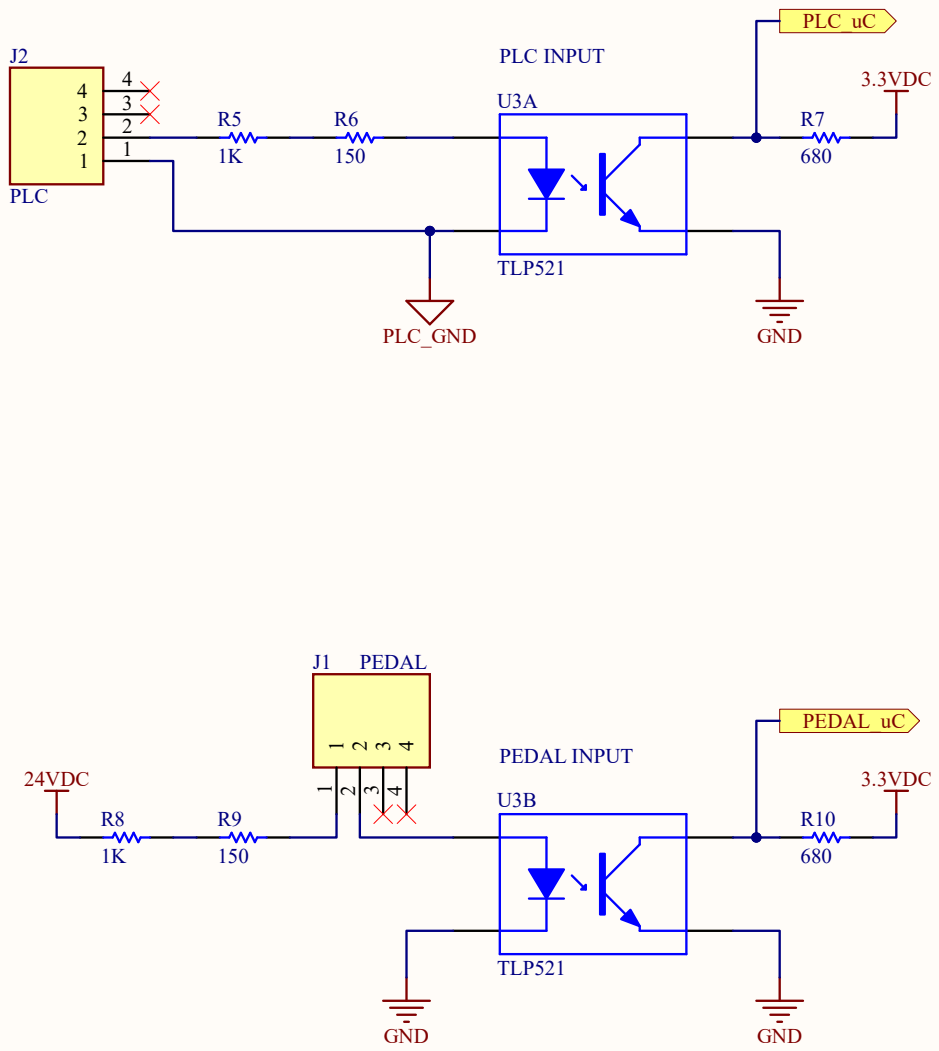
[picture p134: page 1]
