mregueira/DisenioBJAM/Hito 4/ToLeandro/COMECA-Main.pdf

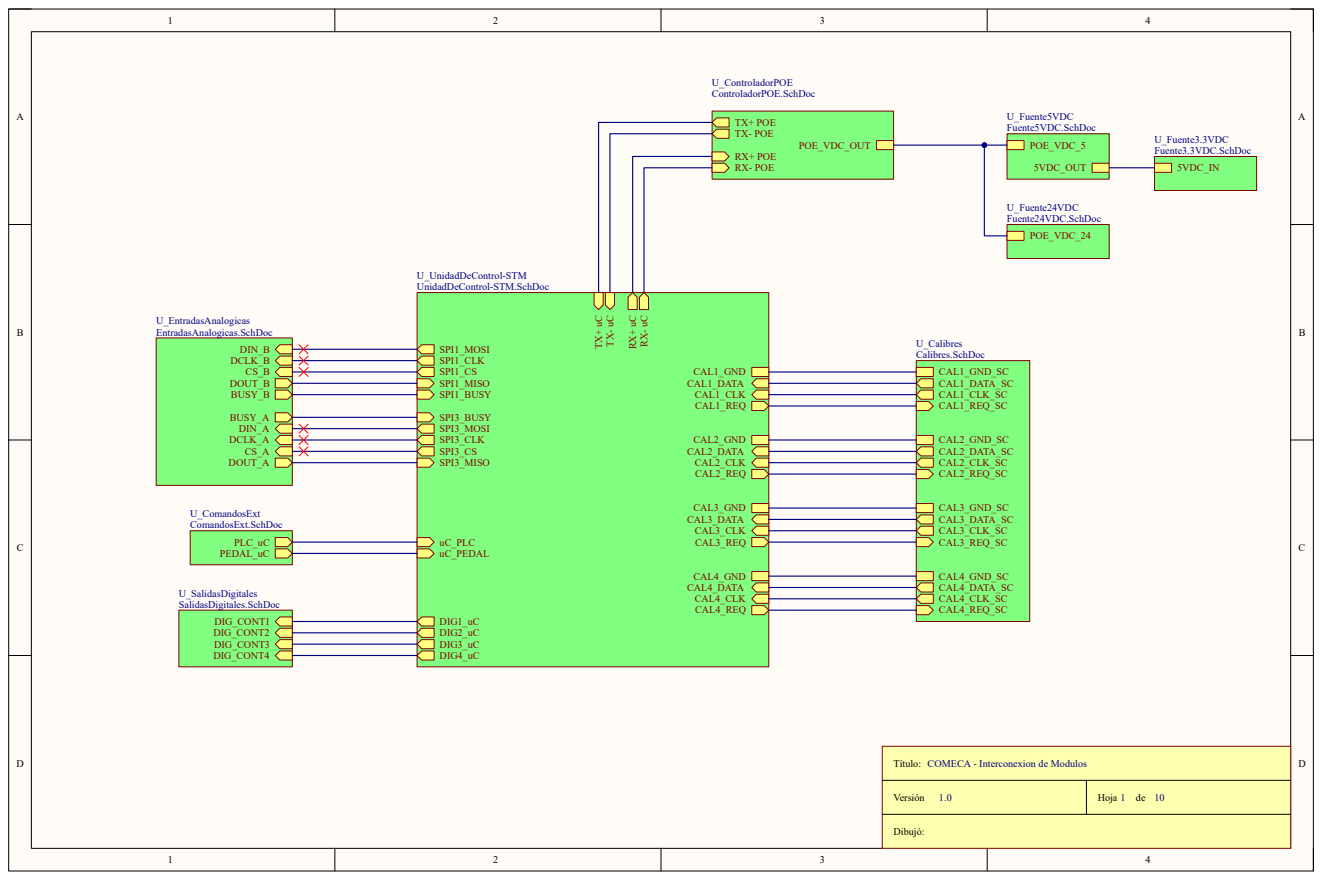
[picture p135: page 1]
Title; Size; Number; Revision; Date:; Sheet of; File:; C:\Users\..\COMECA_Main.SchDoc; Drawn By:; Título:; Versión; Hoja; Dibujó:; POE_VDC_OUT; TX+ POE TX- POE; RX+ POE RX- POE; U_ControladorPOE ControladorPOE.SchDoc; POE_VDC_5; 5VDC_OUT; U_Fuente5VDC Fuente5VDC.SchDoc; POE_VDC_24; U_Fuente24VDC Fuente24VDC.SchDoc; 5VDC_IN; U_Fuente3.3VDC Fuente3.3VDC.SchDoc; PLC_uC PEDAL_uC; U_ComandosExt ComandosExt.SchDoc; CAL1_GND_SC CAL1_DATA_SC CAL1_CLK_SC CAL1_REQ_SC; CAL2_GND_SC; CAL2_REQ_SC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

U_UnidadDeControl-STM
UnidadDeControl-STM.SchDoc

COMECA - Interconexion de Modulos
