mregueira/DisenioBJAM/Hito 4/ToLeandro/ConexionCalibres.pdf

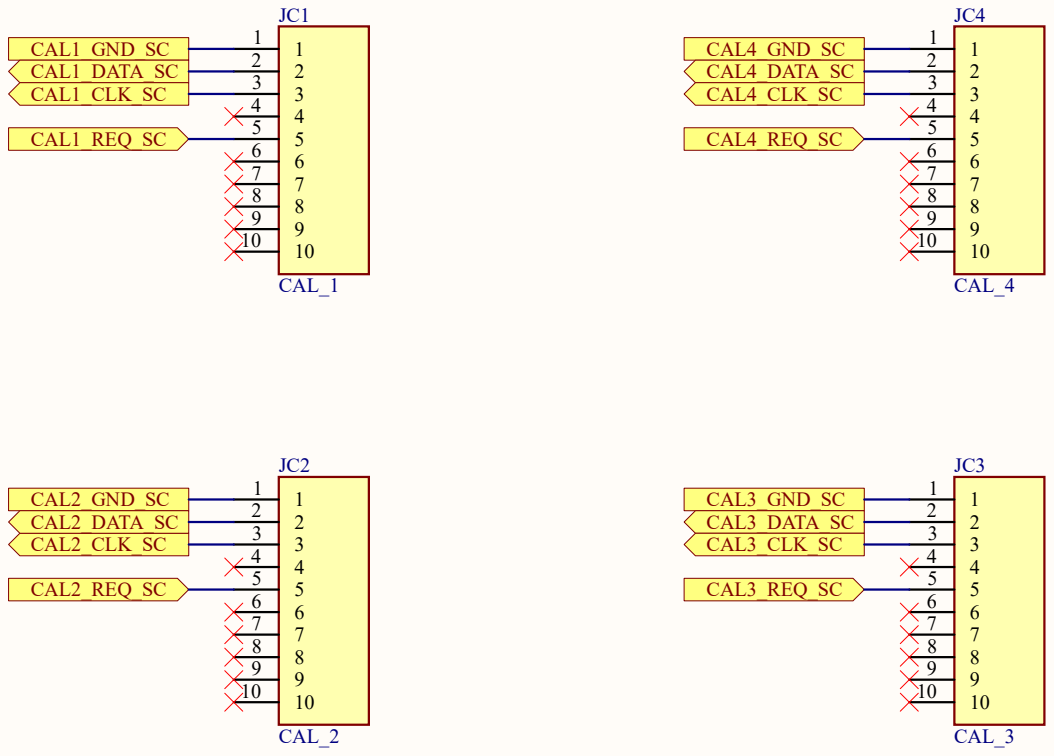
[picture p136: page 1]
Title; Size; Number; Revision; Date:; Sheet of; File:; C:\Users\..\Calibres.SchDoc; Drawn By:; CAL_1; CAL_2; CAL_3; CAL_4; CAL1_GND_SC CAL1_DATA_SC CAL1_CLK_SC; CAL1_REQ_SC; CAL2_GND_SC; CAL2_REQ_SC; CAL2_CLK_SC; CAL2_DATA_SC; CAL4_GND_SC CAL4_DATA_SC CAL4_CLK_SC; CAL4_REQ_SC; CAL3_GND_SC CAL3_DATA_SC CAL3_CLK_SC; CAL3_REQ_SC; Título:; Versión; Hoja; Dibujó:; Calibres
