mregueira/DisenioBJAM/Hito 4/ToLeandro/EntradasAnalogicas.pdf

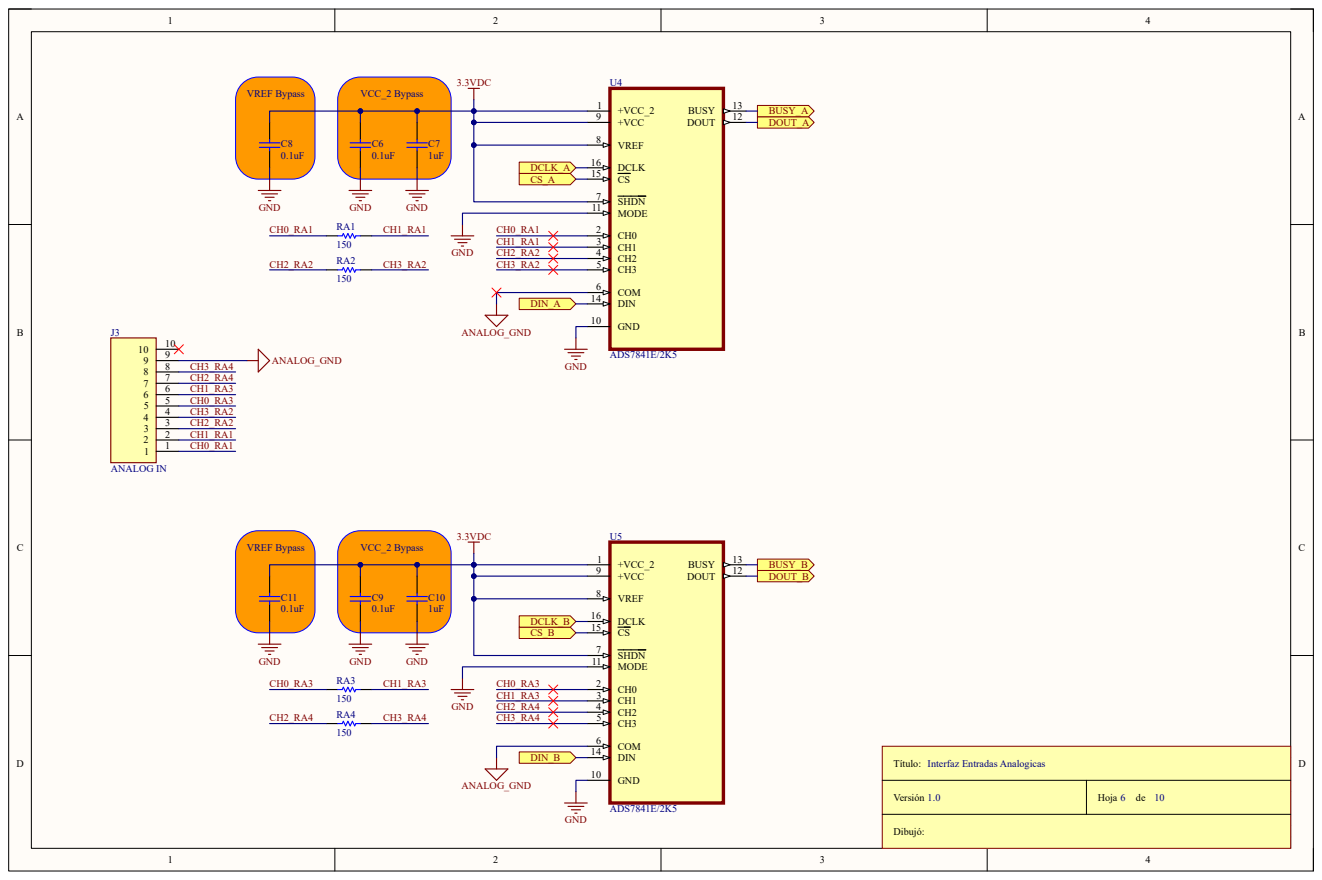
[picture p137: page 1]
