mregueira/DisenioBJAM/Hito 4/ToLeandro/SalidasDigitales.pdf

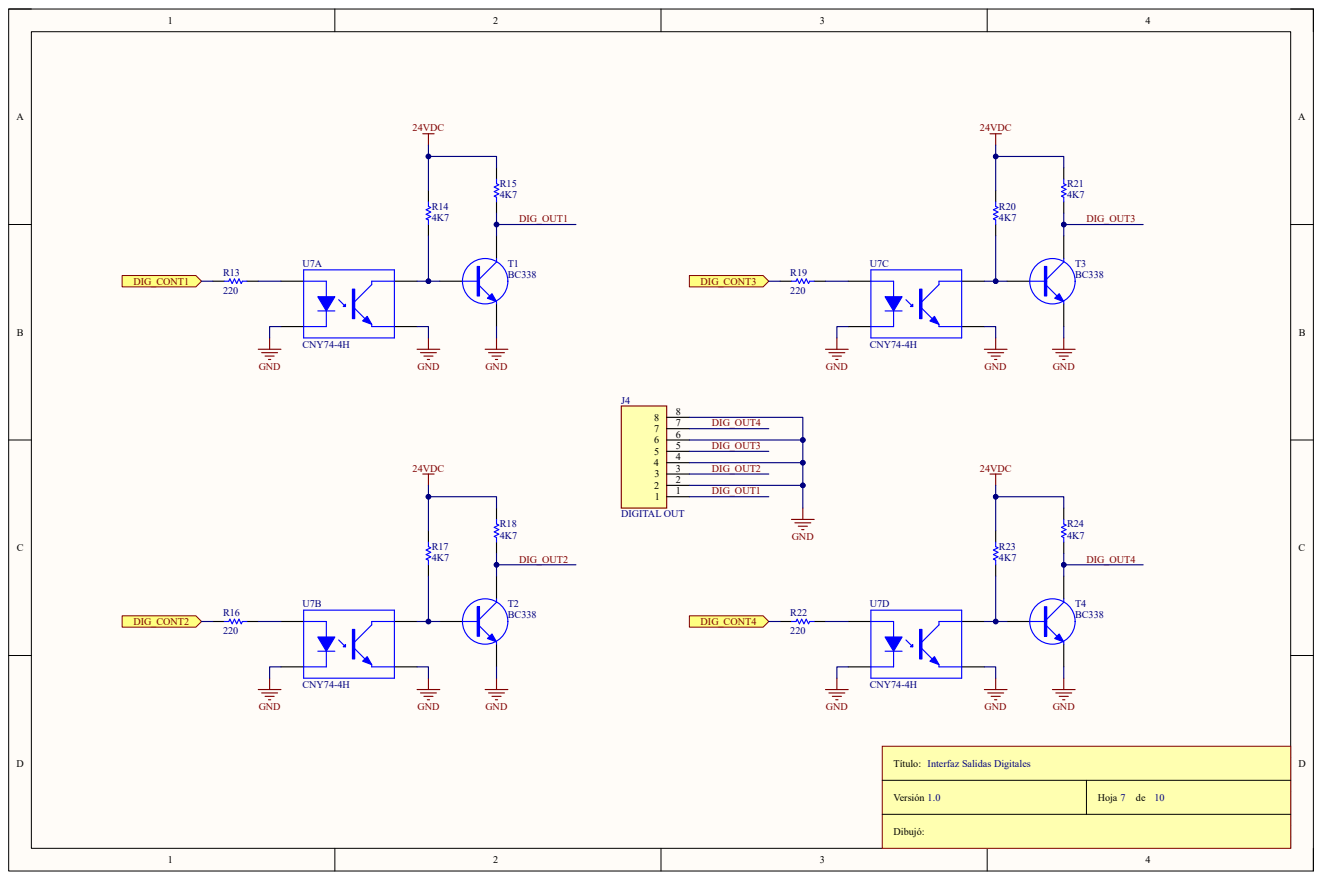
[picture p138: page 1]
