mregueira/DisenioBJAM/Hito 4/Esquemas/ExportedSch/ComandosExt.pdf

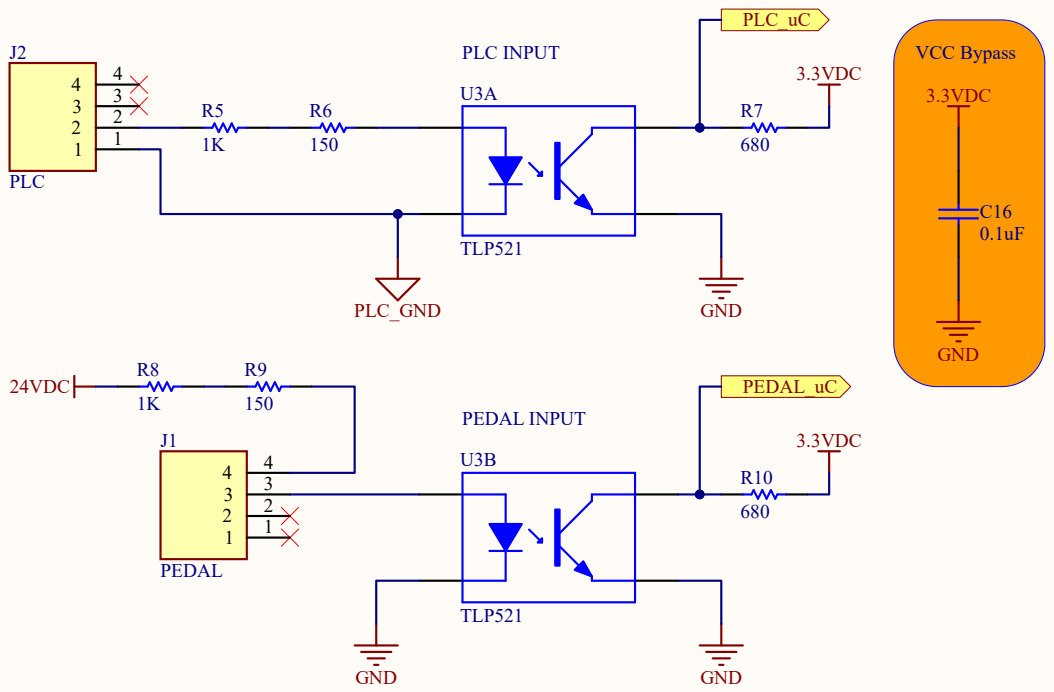
[picture p139: page 1]
