mregueira/DisenioBJAM/Hito 4/Esquemas/ExportedSch/COMECA-Main.pdf

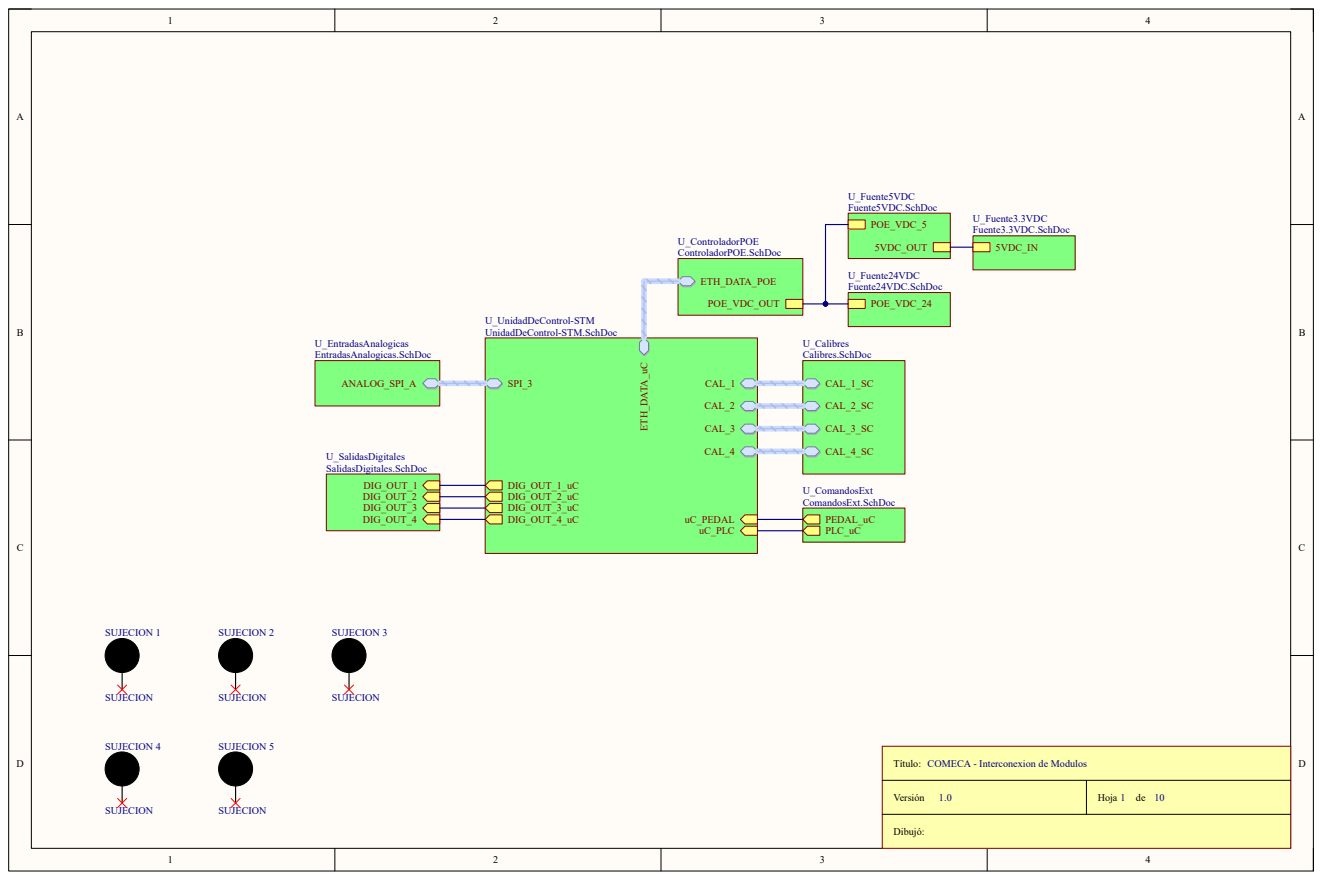
[picture p140: page 1]
Title; Size; Number; Revision; Date:; Sheet of; File:; C:\Users\..\COMECA_Main.SchDoc; Drawn By:; Título:; Versión; Hoja; Dibujó:; POE_VDC_OUT; ETH_DATA_POE; U_ControladorPOE ControladorPOE.SchDoc; POE_VDC_5; 5VDC_OUT; U_Fuente5VDC Fuente5VDC.SchDoc; POE_VDC_24; U_Fuente24VDC Fuente24VDC.SchDoc; 5VDC_IN; U_Fuente3.3VDC Fuente3.3VDC.SchDoc; PLC_uC; PEDAL_uC; U_ComandosExt ComandosExt.SchDoc; CAL_4_SC; CAL_3_SC; CAL_2_SC; CAL_1_SC; U_Calibres Calibres.SchDoc; ANALOG_SPI_A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

U_UnidadDeControl-STM
UnidadDeControl-STM.SchDoc

COMECA - Interconexion de Modulos
