mregueira/DisenioBJAM/Hito 4/Esquemas/ExportedSch/ControladorPOE.pdf

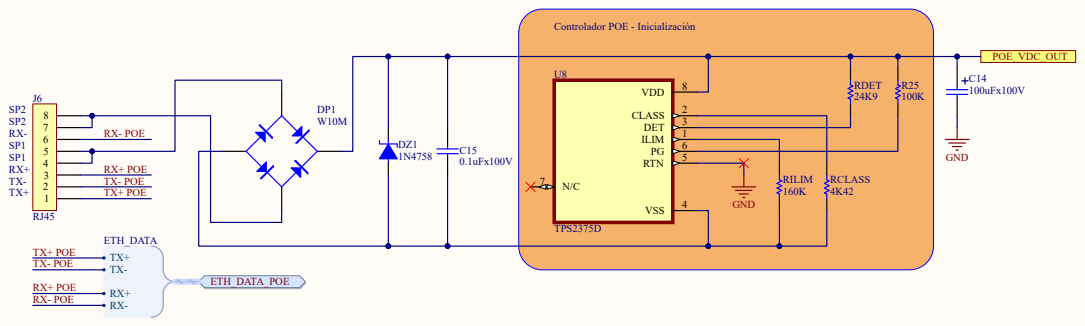
[picture p141: page 1]
Title; Size; Number; Revision; Date:; Sheet of; File:; C:\Users\..\ControladorPOE.SchDoc; Drawn By:; Título:; Versión; Hoja; Dibujó:; Controlador POE; +C14 100uFx100V R25 100K; RDET 24K9; RILIM 160K; RCLASS 4K42; C15 0.1uFx100V; VDD; CLASS; DET; ILIM; RTN; VSS; TPS2375D; GND; POE_VDC_OUT; ETH_DATA; ETH_DATA_POE; RX- POE; RX+ POE TX- POE TX+ POE; TX+ POE; RX+ POE RX- POE; TX- POE

Controlador POE - Inicialización
