mregueira/DisenioBJAM/Hito 4/Esquemas/ExportedSch/EntradasAnalogicas.pdf

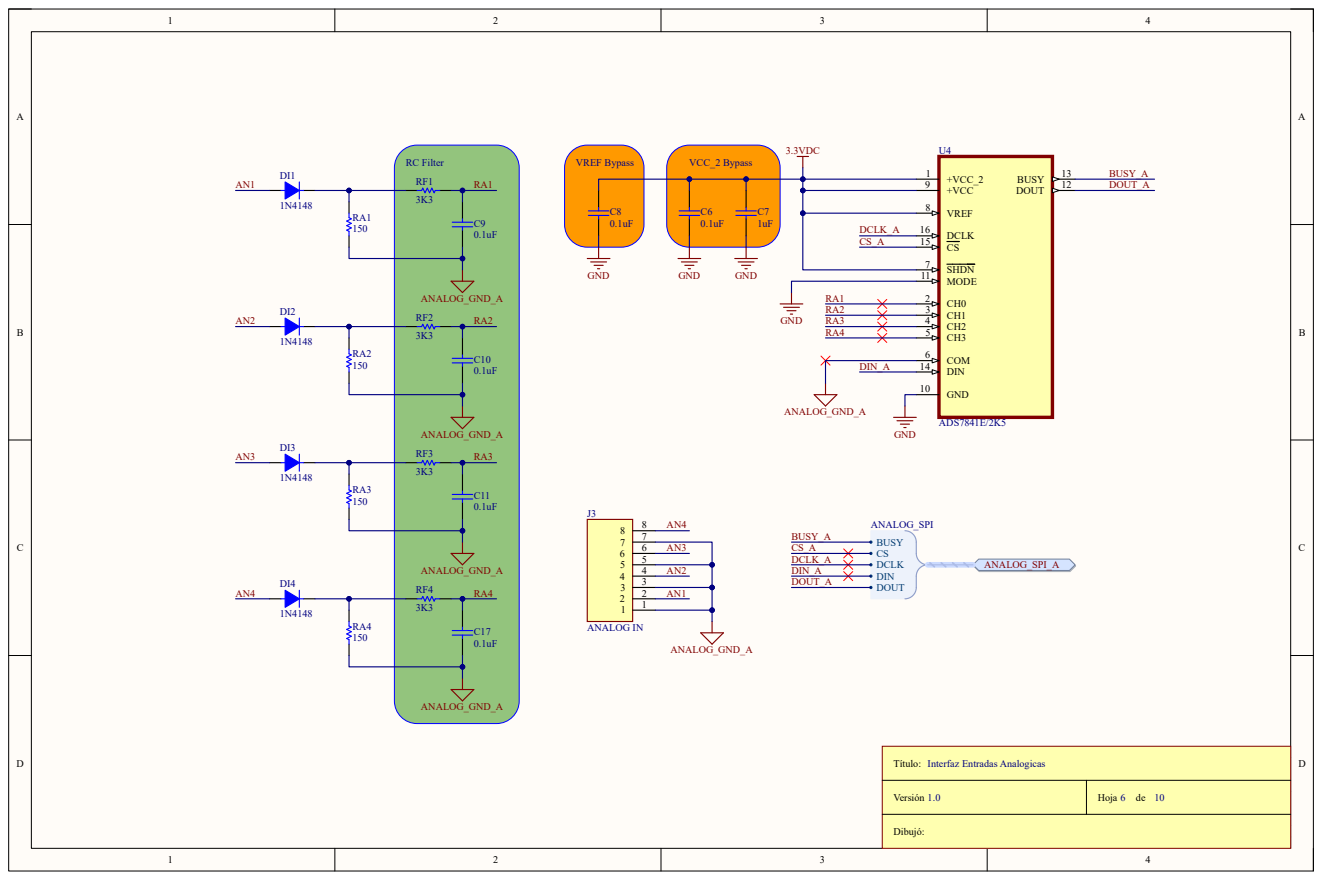
[picture p142: page 1]
