mregueira/DisenioBJAM/Hito 4/Esquemas/ExportedSch/SalidasDigitales.pdf

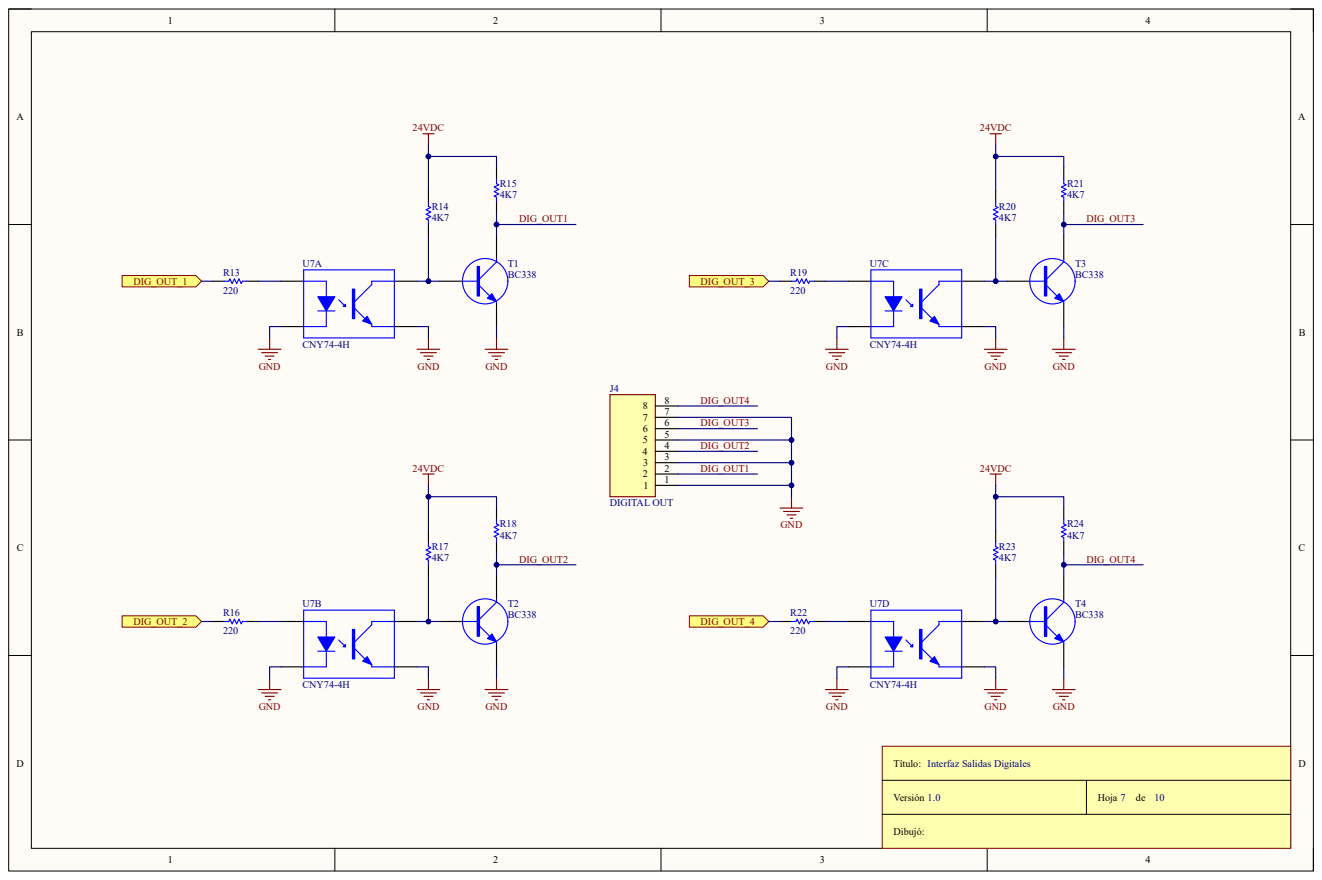
[picture p143: page 1]
