mregueira/DisenioBJAM/Hito 4/EA-Nuevo/RC.asc

C1: cap; 10n
C2: cap; 10n
D1: diode; 1N4148
D2: diode; 1N4148
I1: current; 20m
I2: current; 4m
R1: res; 150
R2: res; 3.3k
R3: res; 3.3k
R4: res; 150
Named nets: 0
.tran 0 1 0 10m
