mregueira/DisenioBJAM/Hito 4/EA-Nuevo/Buffer.asc

I1: current; 4m
R1: res; 100k
R2: res; 100k
R3: res; 100k
R4: res; 100k
R5: res; 82
R6: res; 82
U1: opamp2; LMX58_LM2904
V2: voltage; 5
Named nets: +VCC, VO, 0
.inc LMx58_LM2904.sub
.dc I1 4m 20m 0.1m
