mregueira/DisenioBJAM/Hito 3/Fuente 3.3V Simulacion/Fuente3.3V.asc

C2: cap; 100µ; Rser=0.4
C4: cap; 1000µ; Rser=0.2
D1: diode; Dmur110rl
L1: ind; 1m; Rser=0.3
R1: res; 1k
R2: res; 1.69k
RLoad: res; 33
U1: LM2575HV; LM2575HV_TRANS
V1: voltage; 47
Named nets: 0, Vo
.inc LM2575HV_TRANS.LIB
.tran 0 10m 0 0.1m
.include MUR110RL.LIB
ESR Inductores = 0.3 Ohm
ESR Capacitores = 0.4 Ohm
