mregueira/DisenioBJAM/Hito 3/Fuente 24V Simulacion/Fuente24V.asc

C1: cap; 220µ; Rser=0.4
C2: cap; 100µ; Rser=0.4
D1: diode; Dmur110rl
L1: ind; 2.2m; Rser=2.5
R1: res; 1k
R2: res; 18k
RLoad: res; 120
U1: LM2575HV; LM2575HV_TRANS
V1: voltage; 47
Named nets: 0, Vo
.inc LM2575HV_TRANS.LIB
.tran 0 10m 0 0.1m
.include MUR110RL.LIB
ESR Inductores = 2.5 Ohm
ESR Capacitores = 0.4 Ohm
