mregueira/DisenioBJAM/(list of files, drawings)

Other design files:
Hito 4/COMECA - v2/ComandosExt.SchDoc
Hito 4/COMECA - v2/COMECA.PrjPcb
Hito 4/COMECA - v2/COMECA_Main.SchDoc
Hito 4/COMECA - v2/ControladorPOE.SchDoc
Hito 4/COMECA - v2/EntradasAnalogicas.SchDoc
Hito 4/COMECA - v2/Fuente3.3VDC.SchDoc
Hito 4/COMECA - v2/Fuente5VDC.SchDoc
Hito 4/COMECA - v2/Fuente24VDC.SchDoc
Hito 4/COMECA - v2/UnidadDeControl-STM.SchDoc
Hito 4/COMECA/Aditional Libraries/AditionalFootprints.PcbLib
Hito 4/COMECA/Aditional Libraries/AditionalSymbols.SchLib
Hito 4/COMECA/Aditional Libraries/MFW4R/SnapEDApcb.PcbLib
Hito 4/COMECA/Aditional Libraries/MFW4R/SnapEDAsch.SchLib
Hito 4/COMECA/Aditional Libraries/MFW8R/SnapEDApcb.PcbLib
Hito 4/COMECA/Aditional Libraries/MFW8R/SnapEDAsch.SchLib
Hito 4/COMECA/Aditional Libraries/USB-TYPE-A/SnapEDApcb.PcbLib
Hito 4/COMECA/Aditional Libraries/USB-TYPE-A/SnapEDAsch.SchLib
Hito 4/COMECA/ComandosExt.SchDoc
Hito 4/COMECA/COMECA-PCBv1.PcbDoc
Hito 4/COMECA/ControladorPOE.SchDoc
Hito 4/COMECA/Fuente3.3VDC.SchDoc
Hito 4/COMECA/Fuente5VDC.SchDoc
Hito 4/COMECA/Fuente24VDC.SchDoc
Hito 4/COMECA/UnidadDeControl-STM.SchDoc
Producto Final/COMECA - MCU Board/COMECA - MCU Board.PrjPcb
Producto Final/COMECA - MCU Board/ETH_Interface.SchDoc
Producto Final/COMECA - MCU Board/HDx_Interface.SchDoc
Producto Final/COMECA - MCU Board/HDx_Mapping.SchDoc
Producto Final/COMECA - MCU Board/MCU_Board.PcbDoc
Producto Final/COMECA - MCU Board/MCU_Board_top.SchDoc
Producto Final/COMECA - MCU Board/UC_Interface.SchDoc
Producto Final/COMECA - v4/Calibres.SchDoc
Producto Final/COMECA - v4/ComandosExt.SchDoc
Producto Final/COMECA - v4/COMECA.PrjPcb
Producto Final/COMECA - v4/COMECA_Main.SchDoc
Producto Final/COMECA - v4/ControladorPOE.SchDoc
Producto Final/COMECA - v4/EntradasAnalogicas.SchDoc
Producto Final/COMECA - v4/Fuente3.3VDC.SchDoc
Producto Final/COMECA - v4/Fuente5VDC.SchDoc
Producto Final/COMECA - v4/Fuente24VDC.SchDoc
Producto Final/COMECA - v4/SalidasDigitales.SchDoc
Producto Final/COMECA - v4/UnidadDeControl-STM.SchDoc
Prototipo/COMECA-Adaptator/Adaptator-PCB.PcbDoc
Prototipo/COMECA-Adaptator/Adaptator.SchDoc
Prototipo/COMECA-Adaptator/COMECA-Adaptator.PrjPcb
Prototipo/COMECA-TestBoard-v2/COMECA-TestBoard/COMECA-TestBoard.PrjPcb
Prototipo/COMECA-TestBoard-v2/COMECA-TestBoard/COMECA-TestPCB.PcbDoc
Prototipo/COMECA-TestBoard-v2/COMECA-TestBoard/COMECA_TestSCH.SchDoc
Prototipo/COMECA-TestBoard/COMECA-TestBoard/COMECA-TestPCB.PcbDoc
Prototipo/COMECA-TestBoard/COMECA-TestBoard/COMECA_TestSCH.SchDoc
