mregueira/DisenioBJAM/SoftVideos/COMECA-Server/COMECA/Core/Src/main.c

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
/* Includes ------------------------------------------------------------------*/
#include "main.h"
#include "lwip.h"

/* USER CODE BEGIN Includes */
//#include "../../ExternalLibs/UDPClient/Inc/udpClientRAW.h"
#include "../../ExternalLibs/UDPServer/Inc/udpServerRAW.h"

#include "../../Comeca/DigimaticProtocol/Inc/digimatic.h"

#include "../../Comeca/Managers/Inc/caliperManager.h"
#include "../../Comeca/Managers/Inc/pieceCountManager.h"

/* USER CODE END Includes */

/* USER CODE BEGIN PTD */

typedef enum {
    READ_ANALOG_INPUT,
    SET_DIGITAL_OUTPUT,
	INVALID_RX_FRAME
} received_frame_t;

typedef enum {
    CALIPER_MEASURE,
    ANALOG_IN_MEASURE,
    INCREMENT_COUNTER,
    WARNING_NOT_VALID_CALIPER_MEASURE,
    RETRY_ANALOG_IN_MEASURE
} send_frame_t;


/* USER CODE END PTD */

SPI_HandleTypeDef hspi3;

TIM_HandleTypeDef htim14;

/* USER CODE BEGIN PV */

uint8_t rxBuffer[2];

/* USER CODE END PV */

void SystemClock_Config(void);
static void MX_GPIO_Init(void);
static void MX_TIM14_Init(void);
static void MX_SPI3_Init(void);
/**
  * @brief  The application entry point.
  * @retval int
  */
int main(void)
{
  /* MCU Configuration--------------------------------------------------------*/

  /* Reset of all peripherals, Initializes the Flash interface and the Systick. */
  HAL_Init();

  /* Configure the system clock */
  SystemClock_Config();

  /* USER CODE BEGIN SysInit */
  HAL_Delay(5000);

  /* USER CODE END SysInit */

  /* Initialize all configured peripherals */
  MX_GPIO_Init();
  MX_TIM14_Init();
  MX_LWIP_Init();
  MX_SPI3_Init();
  /* USER CODE BEGIN 2 */
//  udpClient_connect();
  udpServer_init();

  /* USER CODE END 2 */

  /* Infinite loop */
  /* USER CODE BEGIN WHILE */
  while (1)
  {
    /* USER CODE END WHILE */

    /* USER CODE BEGIN 3 */
	  MX_LWIP_Process();

  }
  /* USER CODE END 3 */
}

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
/* USER CODE BEGIN 4 */



void HAL_TIM_PeriodElapsedCallback(TIM_HandleTypeDef *htim){
	if(htim  == &htim14){
		HAL_TIM_Base_Stop_IT(&htim14);

		// todo: esta funcion va a cambiar cuando hagamos las pruebas finales, porque es solo un ejemplo.
//		HAL_GPIO_WritePin(CAL1_REQ_GPIO_Port, CAL1_REQ_Pin); // periodicamente tenemos un request, en teoria setteado cada 93.75ms, empieza bajo
		HAL_GPIO_WritePin(CAL1_REQ_GPIO_Port, CAL1_REQ_Pin, GPIO_PIN_RESET); // turn off REQ
		HAL_GPIO_WritePin(CAL2_REQ_GPIO_Port, CAL2_REQ_Pin, GPIO_PIN_RESET); //
		HAL_GPIO_WritePin(CAL3_REQ_GPIO_Port, CAL3_REQ_Pin, GPIO_PIN_RESET); //
		HAL_GPIO_WritePin(CAL4_REQ_GPIO_Port, CAL4_REQ_Pin, GPIO_PIN_RESET); //


		onRisingEdgeOfReqSignal(CALIPER_1); // prendo el flag de poder empezar a leer los bits
		onRisingEdgeOfReqSignal(CALIPER_2);
		onRisingEdgeOfReqSignal(CALIPER_3);
		onRisingEdgeOfReqSignal(CALIPER_4);
	}
}

void HAL_GPIO_EXTI_Callback(uint16_t GPIO_Pin){
	// llega una interrupcion por GPIO

	if(GPIO_Pin ==CAL1_CLK_Pin || GPIO_Pin == CAL2_CLK_Pin || GPIO_Pin == CAL3_CLK_Pin || GPIO_Pin == CAL4_CLK_Pin ){
		//esto se hace si el GPIO_Pin es alguno de los del calibre (CLK)

		onRisingEdgeOfClockSignal(getCaliperNumberGivenClockPin(GPIO_Pin), caliperManager); // aca se realiza la lectura de los bits y se va guardando en el buffer
	}

	if(GPIO_Pin == uC_PEDAL_Pin){
		// que pasa con el pedal de los calibres

	  HAL_GPIO_WritePin(CAL1_REQ_GPIO_Port, CAL1_REQ_Pin, GPIO_PIN_SET); // supose REQ starts down, we turn on the REQ
	  HAL_GPIO_WritePin(CAL2_REQ_GPIO_Port, CAL2_REQ_Pin, GPIO_PIN_SET); // supose REQ starts down, we turn on the REQ
	  HAL_GPIO_WritePin(CAL3_REQ_GPIO_Port, CAL3_REQ_Pin, GPIO_PIN_SET); // supose REQ starts down, we turn on the REQ
	  HAL_GPIO_WritePin(CAL4_REQ_GPIO_Port, CAL4_REQ_Pin, GPIO_PIN_SET); // supose REQ starts down, we turn on the REQ

	  HAL_TIM_Base_Start_IT(&htim14); // start timer
	}

	if(GPIO_Pin == uC_PLC_Pin){
		// que pasa si viene el PLC
		pieceCountManager();
	}
}


/* USER CODE END 4 */
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
