mregueira/DisenioBJAM/Prototipo/COMECA/COMECA/COMECA.ioc

Mcu.UserName=STM32F407VGTx
PA0-WKUP.GPIO_Label=CAL3_DATA
PA0-WKUP.Signal=GPIO_Input
PA1.Signal=ETH_REF_CLK
PA13.Signal=SYS_JTMS-SWDIO
PA14.Signal=SYS_JTCK-SWCLK
PA2.Signal=ETH_MDIO
PA4.Signal=GPIO_Output
PA7.Signal=ETH_CRS_DV
PA8.Signal=RCC_MCO_1
PB1.GPIO_Label=CAL2_DATA
PB1.Signal=GPIO_Input
PB11.Signal=ETH_TX_EN
PB12.Signal=ETH_TXD0
PB13.Signal=ETH_TXD1
PB6.GPIO_Label=uC_PLC
PB6.Signal=GPXTI6
PB8.GPIO_Label=uC_PEDAL
PB8.Signal=GPXTI8
PC1.Signal=ETH_MDC
PC10.Signal=SPI3_SCK
PC11.Signal=SPI3_MISO
PC12.Signal=SPI3_MOSI
PC3.GPIO_Label=CAL3_CLK
PC3.Signal=GPXTI3
PC4.Signal=ETH_RXD0
PC5.Signal=ETH_RXD1
PC7.GPIO_Label=DIG_OUT_2
PC7.Signal=GPIO_Output
PC9.GPIO_Label=DIG_OUT_1
PC9.Signal=GPIO_Output
PD13.GPIO_Label=DIG_OUT_4
PD13.Signal=GPIO_Output
PD15.GPIO_Label=DIG_OUT_3
PD15.Signal=GPIO_Output
PE0.GPIO_Label=CAL4_REQ
PE0.Signal=GPIO_Output
PE11.GPIO_Label=CAL1_DATA
PE11.Signal=GPIO_Input
PE13.GPIO_Label=CAL1_REQ
PE13.Signal=GPIO_Output
PE15.GPIO_Label=CAL1_CLK
PE15.Signal=GPXTI15
PE2.GPIO_Label=CAL4_CLK
PE2.Signal=GPXTI2
PE4.GPIO_Label=CAL4_DATA
PE4.Signal=GPIO_Input
PE6.GPIO_Label=CAL3_REQ
PE6.Signal=GPIO_Output
PE7.GPIO_Label=CAL2_REQ
PE7.Signal=GPIO_Output
PE9.GPIO_Label=CAL2_CLK
PE9.Signal=GPXTI9
PH0-OSC_IN.Signal=RCC_OSC_IN
PH1-OSC_OUT.Signal=RCC_OSC_OUT
