mregueira/DisenioBJAM/(commit log)

2020-09-17 added antecedentes
    [PuntosPorHItos.xlsx]
2020-09-29 ya no se que agregue
2020-10-13 dfmea v1
    [FMEA-AIAG-3rd-8.5x11-v1.xls]
2020-10-20 edit DFMEA
    [FMEA-AIAG-3rd-8.5x11-v1.xls, FMEA-AIAG-3rd-8.5x11-v2.xls]
2020-10-23 edited DFMEA
    [FMEA-AIAG-3rd-8.5x11-v3.xls]
2020-10-26 edit numero
    [FMEA-AIAG-3rd-8.5x11-v3.xls]
2020-11-04 correcciones hito 1 y Dfema final pre
    [FMEA-AIAG-3rd-8.5x11-v3.xls]
2020-11-12 asignado de tiempos
2020-11-12 added escala
    [FMEA-AIAG-3rd-8.5x11-v3.xls]
2020-11-19 subo algunas de las correciones de alejandro
2020-11-21 falta banco de usb y diagrama de validacion, y validacion de las normas
    el resto estaria todo
    [FMEA-AIAG-3rd-8.5x11-v3.xls]
2020-11-23 corrección de unos interlineados y unos typos
2021-04-09 update informe hito3
    faltan partes de poe, fuente 5V, salidas digitales y soft
2021-04-12 added fuente 5V png
2021-04-12 agregue el codigo
2021-04-12 added circuito salidas digitales
2021-04-25 Parte de PoE
2021-04-26 added fuente 3v3 y 24v lineal
2021-04-26 complete de las entradas 4-20
2021-04-27 espero no romper nada
    subi fuente de 5V
2021-04-27 procrastinacion
    estaba empezando a pasar lo de joaco pero me entere que se defaso la entrega
2021-04-29 added software informe
    [PuntosPorHItos.xlsx]
2021-04-30 continuar sobre LinealV2
    como hay que volver a las switching hay que borrar lo de lineal, pero no quiero perder por las dudas el que esta hecho
2021-05-11 anexo circuitos cliente
2021-05-17 added foto programador
    [PuntosPorHItos.xlsx]
2021-05-18 started sch design
    added fuente 24, 3.3, cmd ext
    [AditionalFootprints.PcbLib, AditionalSymbols.SchLib, COMECA.PrjPcb, ComandosExt.SchDoc, Fuente24VDC.SchDoc, Fuente3.3VDC.SchDoc]
2021-05-19 added entradas analogicas
    [COMECA.PrjPcb, ComandosExt.SchDoc, EntradasAnalogicas.SchDoc, PuntosPorHItos.xlsx]
2021-05-19 Update Ind_2200uH.pdf
    cambie el inductor 2.2mh pq no habia stock del otro
2021-05-22 added conector libs
    falta chequear pero creo que son lo que encontre
    [AditionalFootprints.PcbLib, AditionalSymbols.SchLib, COMECA.PrjPcb, Fuente24VDC.SchDoc, Fuente5VDC.SchDoc, SalidasDigitales.SchDoc]
2021-05-22 added salidas digitales
    faltaria poe y uC
    [COMECA.PrjPcb, ComandosExt.SchDoc, ControladorPOE.SchDoc, EntradasAnalogicas.SchDoc, Fuente5VDC.SchDoc, SalidasDigitales.SchDoc, UnidadDeControl-STM.SchDoc]
2021-05-24 added poe and micro
    estaria faltando completar poe y pines del micro
    [ControladorPOE.SchDoc, UnidadDeControl-STM.SchDoc]
2021-05-25 added conections
    falta agregar busy
    [COMECA.PrjPcb, COMECA_Main.SchDoc, Calibres.SchDoc, ControladorPOE.SchDoc, EntradasAnalogicas.SchDoc, Fuente24VDC.SchDoc, Fuente5VDC.SchDoc, UnidadDeControl-STM.SchDoc]
2021-05-25 added busy
    [COMECA_Main.SchDoc, EntradasAnalogicas.SchDoc, UnidadDeControl-STM.SchDoc]
2021-05-26 cofigured ports
    restaria hacer el pcb
    [COMECA.PrjPcb, COMECA_Main.SchDoc, Calibres.SchDoc, ComandosExt.SchDoc, ControladorPOE.SchDoc, EntradasAnalogicas.SchDoc, Fuente5VDC.SchDoc, SalidasDigitales.SchDoc]
2021-05-26 added CON13*2
    para mas prolijidad
    [AditionalFootprints.PcbLib, AditionalSymbols.SchLib, Fuente24VDC.SchDoc, UnidadDeControl-STM.SchDoc]
2021-05-26 started pcb
    [COMECA-PCBv1.PcbDoc, COMECA.PrjPcb, COMECA_Main.SchDoc, Calibres.SchDoc, ComandosExt.SchDoc, ControladorPOE.SchDoc, EntradasAnalogicas.SchDoc, Fuente24VDC.SchDoc]
2021-05-26 continue pcb
    [COMECA-PCBv1.PcbDoc, COMECA.PrjPcb, Fuente5VDC.SchDoc]
2021-06-01 updated pcb
    [COMECA-PCBv1.PcbDoc, ComandosExt.SchDoc, UnidadDeControl-STM.SchDoc]
2021-06-02 updated pcb + informe visted
    [COMECA-PCBv1.PcbDoc, EntradasAnalogicas.SchDoc]
2021-06-11 update pcb 90 percentage
    queda la distribucion de las alimentaciones y acomodar, ver tema footprint para los LM257X si parado o acostado
    [COMECA-PCBv1.PcbDoc, ComandosExt.SchDoc, ControladorPOE.SchDoc, EntradasAnalogicas.SchDoc, SalidasDigitales.SchDoc, UnidadDeControl-STM.SchDoc]
2021-06-14 primera version pcb lista
    acomodados los conectores y modelos 3d, habria que revisar y verlo con leandro
    [AditionalFootprints.PcbLib, AditionalSymbols.SchLib, COMECA-PCBv1.PcbDoc, COMECA_Main.SchDoc, Calibres.SchDoc, ComandosExt.SchDoc, EntradasAnalogicas.SchDoc, Fuente24VDC.SchDoc]
2021-06-14 added 3d SOIC 16
    faltaba un 3d tambien
    [COMECA-PCBv1.PcbDoc, EntradasAnalogicas.SchDoc]
2021-06-16 edited estetica
    [COMECA.PrjPcb, COMECA_Main.SchDoc, Calibres.SchDoc, ComandosExt.SchDoc, ControladorPOE.SchDoc, EntradasAnalogicas.SchDoc, Fuente24VDC.SchDoc, Fuente3.3VDC.SchDoc]
2021-06-17 added 90 deg calibre
    [COMECA-PCBv1.PcbDoc, Calibres.SchDoc]
2021-06-22 reperfilamiento de disenio pcb
    [COMECA-PCBv1.PcbDoc]
2021-06-22 added harness
    harness for analog inputs
    [COMECA-PCBv1.PcbDoc, COMECA.PrjPcb, COMECA_Main.SchDoc, EntradasAnalogicas.SchDoc, UnidadDeControl-STM.SchDoc]
2021-06-22 added harness calibres
    [COMECA.PrjPcb, COMECA_Main.SchDoc, Calibres.SchDoc, EntradasAnalogicas.SchDoc, SalidasDigitales.SchDoc, UnidadDeControl-STM.SchDoc]
2021-06-22 added eth harness
    y otras yerbas
    [COMECA-PCBv1.PcbDoc, COMECA.PrjPcb, COMECA_Main.SchDoc, ComandosExt.SchDoc, ControladorPOE.SchDoc, UnidadDeControl-STM.SchDoc]
2021-06-23 added informe parte esquematico
    queda agregar lo de confiabilidad y arreglar lo viejo
    [COMECA_Main.SchDoc, Calibres.SchDoc, ComandosExt.SchDoc, ControladorPOE.SchDoc, EntradasAnalogicas.SchDoc, SalidasDigitales.SchDoc, UnidadDeControl-STM.SchDoc]
2021-06-26 added confiabilidad a informe
    modificar los numeros despues dado el cambio que hay que hacer en entradas analogicas
    [AditionalFootprints.PcbLib, AditionalSymbols.SchLib, COMECA.PrjPcb, COMECA_Main.SchDoc, Calibres.SchDoc, ComandosExt.SchDoc, ControladorPOE.SchDoc, EntradasAnalogicas.SchDoc]
2021-06-28 edited EA circuit v2
    [COMECA_Main.SchDoc, EntradasAnalogicas.SchDoc, UnidadDeControl-STM.SchDoc]
2021-06-28 modificados numeros confiabilidad
    [COMECA_Main.SchDoc, EntradasAnalogicas.SchDoc, UnidadDeControl-STM.SchDoc]
2021-07-05 edited sch EA y pcb
    [EntradasAnalogicas.SchDoc]
2021-07-06 informe hasta h4 preliminar
    hay que revisar
    [COMECA.PrjPcb, EntradasAnalogicas.SchDoc]
2021-07-19 added leds and first stm try
    habia quedado colgado lo de los leds y probe meter un programa en la stm y todo OK
    [Fuente24VDC.SchDoc, Fuente3.3VDC.SchDoc, Fuente5VDC.SchDoc]
2021-07-21 programa de prueba
2021-07-21 este es el led
2021-07-21 Update COMECA-PCBv1.PcbDoc
    agrande las patas
2021-07-21 hacemos proyecto base de nuevo con git ignore
2021-07-21 devuelvo proyecto base de prueba
2021-07-21 agrego las pruebas de activar salida
2021-07-23 added testboard sch
    [COMECA-PCBv1.GBL, COMECA-PCBv1.GBO, COMECA-PCBv1.GBS, COMECA-PCBv1.GKO, COMECA-PCBv1.GM1, COMECA-PCBv1.GTL, COMECA-PCBv1.GTO, COMECA-PCBv1.GTS]
2021-07-24 testBoard ruteada
    [COMECA-TestBoard.PrjPcb, COMECA-TestPCB.PcbDoc]
2021-07-24 Agrego script para hacer pruebas con el Patterns para la parte de los calibres. El script devuelve un csv que importamos para la señal de DATA.
    [test_25mm.csv]
2021-07-24 agrego primer fake caliper
    [test_25mm.csv]
2021-07-25 primer intento de protocolo digimatic hecho
2021-07-25 primera prueba con calibre emulado con analog funciono 😎
2021-07-25 generalice el codigo para los 4 calibres y probe con el primero, sigue funcionando
2021-07-26 fixed holes pcb
    tengo que cambiar el footprint del RJ45 que me di cuenta que no es ese el que va
    [COMECA-PCBv1.GBL, COMECA-PCBv1.GBO, COMECA-PCBv1.GBS, COMECA-PCBv1.GKO, COMECA-PCBv1.GM1, COMECA-PCBv1.GTL, COMECA-PCBv1.GTO, COMECA-PCBv1.GTS]
2021-07-28 fixed Rj45
    el footprint del rj45 no iba el que puse sino otro, ya lo cambie. estoy revisando los agujeros y despues ya lo mando hacer
    [COMECA-TestPCB.PcbDoc, COMECA.PrjPcb, COMECA_TestSCH.SchDoc, ControladorPOE.SchDoc]
2021-07-28 fixed holes
    [AditionalFootprints.PcbLib, AditionalSymbols.SchLib, ControladorPOE.SchDoc]
2021-09-11 modified pcb test
    [COMECA-TestPCB.PcbDoc, COMECA_TestSCH.SchDoc]
2021-09-15 added new testboard v2
    esta seria con el conector de plastico original pero con las resistencias que debe llevar
    [COMECA-TestBoard.PrjPcb, COMECA-TestPCB.PcbDoc, COMECA_TestSCH.SchDoc]
2021-09-20 saque el protocolo del main
2021-09-20 generalice el codigo del protocolo de calibre
2021-09-23 hicimos andar el ping en el proyecto principal
2021-09-30 added adaptator
    [Adaptator-PCB.PcbDoc, Adaptator.SchDoc, AditionalFootprints.PcbLib, AditionalSymbols.SchLib, COMECA-Adaptator.PrjPcb, COMECA-TestBoard.PrjPcb]
2021-10-20 added resistors and fixed magjack pos
    [Adaptator-PCB.PcbDoc, Adaptator.SchDoc, COMECA-Adaptator.PrjPcb]
2021-11-01 started using manager functions
    [UnidadDeControl-STM.SchDoc]
2021-11-02 added caliper number to the ones that didn't have that property
    [analogInManager.c, analogInManager.h, caliperManager.c, caliperManager.h, digitalOutManager.c, digitalOutManager.h]
2021-11-06 agregamos el spi
2021-11-20 siguen los problemas con el ADS
    [COMECA.ioc, analogInManager.c, analogInManager.h, main.c]
2021-12-07 fixed branch after conflicts
    [COMECA.ioc, main.c]
2021-12-08 bugfix en pedal, ya no es mas periodico
    [main.c]
2021-12-08 bugfix logica negada pedal y calibres
    [COMECA.ioc, main.c]
2021-12-08 saque el primer timer base start
2021-12-08 changed stop timer for IT
2021-12-20 subo proyecto con cambios de leandro, no anda la recepcion
2022-01-12 added draftman
    [COMECA.PrjPcb]
2022-01-24 Uptade con algunas cosas de los checklist
2022-01-26 fixed tests and updated comeca stm32 project
    [analogInManager.c, analogInManager.h, caliperManager.c, caliperManager.h, digitalOutManager.c, digitalOutManager.h]
2022-01-28 changed dcdc footprint
    [AditionalFootprints.PcbLib, AditionalSymbols.SchLib, COMECA.PrjPcb, COMECA_Main.SchDoc, Calibres.SchDoc, ComandosExt.SchDoc, ControladorPOE.SchDoc, EntradasAnalogicas.SchDoc]
2022-01-28 fixed mur410 and pcb routing
    [AditionalFootprints.PcbLib, AditionalSymbols.SchLib, COMECA.PrjPcb, Fuente5VDC.SchDoc]
2022-01-29 added eth conn and pull ups for phy
    [AditionalFootprints.PcbLib, COMECA.PrjPcb, ControladorPOE.SchDoc]
2022-01-30 added succesfully eth conn and Rs pull up
    [AditionalFootprints.PcbLib, AditionalSymbols.SchLib, ControladorPOE.SchDoc]
2022-01-31 added test points and pull down to pedal - plc
    [ComandosExt.SchDoc, Fuente24VDC.SchDoc, Fuente3.3VDC.SchDoc, Fuente5VDC.SchDoc]
2022-02-01 edited pcb acording mechanical box 165x165
    [COMECA.PrjPcb]
2022-02-05 improved FMEA analysis
    [FMEA-AIAG-3rd-8.5x11-v4.xls]
2022-02-05 edited USB placement
    [COMECA.PrjPcb]
2022-02-07 updating diagramacion de proyecto
2022-02-08 dejo codigo para videos
2022-02-15 fixed FMEA again
    [FMEA-AIAG-3rd-8.5x11-v5.xls]
2022-03-21 fixed footprints and routed differential eth
    [AditionalFootprints.PcbLib, COMECA.PrjPcb, COMECA_Main.SchDoc, ControladorPOE.SchDoc, EntradasAnalogicas.SchDoc, UnidadDeControl-STM.SchDoc]
2022-04-12 modified dimensions and diff routing
    [COMECA.PrjPcb]
2022-04-13 removed differential pairs
    to route diff pairs with 100R it needs to be at least a 4 layer board
    [COMECA.PrjPcb, ControladorPOE.SchDoc]
2022-04-20 release v3
    [COMECA-PCBv1.GBL, COMECA-PCBv1.GBO, COMECA-PCBv1.GBS, COMECA-PCBv1.GKO, COMECA-PCBv1.GM1, COMECA-PCBv1.GTL, COMECA-PCBv1.GTO, COMECA-PCBv1.GTS]
2022-04-20 started v4 pcb
    the idea is to reduce the board size, trying to reach the estanca box dimensions as first goal
    [COMECA.PrjPcb, COMECA_Main.SchDoc, Calibres.SchDoc, ComandosExt.SchDoc, ControladorPOE.SchDoc, EntradasAnalogicas.SchDoc, Fuente24VDC.SchDoc, Fuente3.3VDC.SchDoc]
2022-05-14 adapted version to estanca box 165x165
    [AditionalFootprints.PcbLib, AditionalSymbols.SchLib, COMECA_Main.SchDoc, ControladorPOE.SchDoc, Fuente24VDC.SchDoc, Fuente3.3VDC.SchDoc, Fuente5VDC.SchDoc, SalidasDigitales.SchDoc]
2022-05-21 separated inductor from dcdc
    [COMECA.PrjPcb]
2022-05-25 fixed issues from applied rules
    [AditionalFootprints.PcbLib, COMECA.PrjPcb, SnapEDApcb.PcbLib, SnapEDAsch.SchLib]
2022-07-10 rclass splited
    [ControladorPOE.SchDoc, Fuente24VDC.SchDoc, Fuente3.3VDC.SchDoc, Fuente5VDC.SchDoc]
2022-09-10 Added PCB v5
    [AditionalFootprints.PcbLib, COMECA.PrjPcb, COMECA_Main.SchDoc, Calibres.SchDoc, ComandosExt.SchDoc, ControladorPOE.SchDoc, EntradasAnalogicas.SchDoc, Fuente24VDC.SchDoc]
2022-09-10 Added started MCU Board custom
    [BOM - JLC.xlsx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]
2022-09-10 mapping sch
    [COMECA - MCU Board.PrjPcb, HDx_Interface.SchDoc, HDx_Mapping.SchDoc, MCU Board.SchDoc, UC_Interface.SchDoc]
2022-09-10 finish separated schs and renamed top
    [COMECA - MCU Board.PrjPcb, HDx_Mapping.SchDoc, MCU Board.SchDoc, MCU_Board_top.SchDoc]
2022-09-10 finished sch - pending review
    [COMECA - MCU Board.PrjPcb, MCU_Board.PcbDoc, MCU_Board_top.SchDoc, UC_Interface.SchDoc]
2022-09-10 hidden cross references
    [ETH_Interface.SchDoc, HDx_Interface.SchDoc, HDx_Mapping.SchDoc, UC_Interface.SchDoc]
2022-09-11 added R1 and placement in progress
    [COMECA - MCU Board.PrjPcb, MCU_Board.PcbDoc, MCU_Board_top.SchDoc, UC_Interface.SchDoc]
2022-09-13 positioning finish
    [MCU_Board.PcbDoc]
2022-09-14 added capacitors 10uf
    [MCU_Board.PcbDoc, UC_Interface.SchDoc]
2022-09-14 routed upper side
    [MCU_Board.PcbDoc]
2022-09-17 remaining to route vcc and gnd
    [MCU_Board.PcbDoc]
2022-09-17 remaining gnd planes
    [ETH_Interface.SchDoc, MCU_Board.PcbDoc]
2022-09-17 finished routing
    [HDx_Interface.SchDoc, MCU_Board.PcbDoc]
2022-09-18 form factor made
    [MCU_Board.PcbDoc]
2022-09-21 updated puntito
    [BOM - JLC.xlsx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]
2022-09-24 fixed 1st set of changes
    [COMECA-BOM.xlsx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]
2022-12-11 files sended to manufacturing
    [COMECA - MCU Board.PrjPcb, COMECA.PrjPcb, ControladorPOE.SchDoc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]
2022-12-11 deleted auxiliar files
    [BOM - JLC.xlsx, COMECA - MCU Board.xlsx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]
2023-09-09 udp fix, now using client
    [analogInManager.c]
2023-09-09 fix analog data read
    [analogInManager.c]
